dermatoid-collab/EVC_FW/docs/elenco_correzioni_ST.TEC.068.md

# Elenco delle correzioni a ST.TEC.068, in ordine di pagina

Pagine e paragrafi sono quelli della Rev.0 (piè di pagina «Pagina N di 43»). Ricavati dal testo estratto del PDF: ricontrollare in apertura del file originale. I testi da incollare sono in `correzioni_ST.TEC.068.md` (sezione indicata nell'ultima colonna).

| Pagina | Paragrafo | Correzione | Testo |
|---|---|---|---|
| tutte | Intestazione | Rev.1 e data di emissione (oggi 12/01/2026, precedente ai documenti citati); aggiungere «Verificato da» accanto a Redatto/Approvato | §8c |
| 1 | §0, Tab.1 | «Corsa 3000 mm» → «Corsa massima verificata 4500 mm (macchina VR260038: 3000 mm)» | §6c |
| 6 | §1.a | «250 kg/m» → «250 kg/m²» | §8b |
| 6, 10, 23-27 | EN 81-41 | usare una sola edizione (ora 2025 e 2024) e ricontrollare i paragrafi citati | §8c |
| 7 | Tab.2 | QC 315 kg → 3,01 kN diventa **325 kg → 3,19 kN**; QWL 2,67 → **2,70 kN**; Q 1,97 → 1,96; W 3,54 → 3,53 | §8b |
| 7 | §1.1 | elenco unico delle masse (guide 120, trave 210, parti elettriche 30, motoriduttore 21, batterie 18, contrappesi 60, cinghie, cabina 160, portata 200); «cinghie 50 kg» → valore adottato (35 kg a favore di sicurezza, reale circa 7 kg con 0,33 kg/m); carichi per guida **427 kg** (normale) e **607 kg** (paracadute) al posto di 400 e 580 | §4a, §6b |
| 8 | Tab.3 | DC01: Rm 410 e Rp0,2 280 sono massimi di norma; usare i minimi cautelativi (270 e 140 MPa) e dirlo | §4c nota |
| 17 | §3 «Carico esterno» | «m = 1015 kg» e il suo elenco → 1087 kg per guida, **N tot = 11,24 kN** | §4b |
| 18 | §3, caso A | SF 2,06 → **1,93** | §4b |
| 19 | §3, caso B | SF 16,85 → **15,8** | §4b |
| 19-22 | §4 coperchio | sostituire il calcolo delle frecce con la citazione del rapporto CEL (numero e data da completare, fonte di L/200 e 120 MPa); il calcolo a striscia (p. 20) tolto o indicato come stima prudente | §3 |
| 24 | §5, dati cinghia | «Ttht … (max 50 volte nella vita cinghia, da test report)»: il rapporto RI 007-26 non lo dice; indicare la fonte o togliere; usare 910 N/cm (minimo) o 760 (catalogo) | §7b |
| 24 | §5, dati | «Rp = Diametro primitivo … Dp/2» → «raggio primitivo, 50,9 mm ≈ 0,051 m» (anche p. 25, 27, 36) | §8a |
| 24 | §5, specifiche motoriduttore | aggiungere 34 Vac e citare il rapporto Amer (titolo, revisione, data 03/03/2026), disegno DCM-6329 Rev.3 | §5a |
| 25 | §5, emergenza | «Cp = 25,3 · 0,92 · … = 554 Nm» → **Cp = 2 · 14 · 0,85 · 25,3 / 0,92 = 654 Nm**; ΔT = 6417 N; SF dente **10,4 → 8,8**; introdurre «carico limitato dalla coppia del freno» | §2, §7a |
| 26 | §5, frenata nominale | ΔTstd = 3730 N è il totale di due cinghie: SF **1,2 → 2,4** (12 denti) o **4,2** (21 denti) | §7d |
| 26 | §5, max carico di trazione | aggiungere la verifica a emergenza: 6417 N contro 8075 N (valore medio) = **1,26**; rottura 30.685 / 6417 = **4,8** | §7a, §7b |
| 26 | §5, nota decelerazioni | Amax = 14,5 m/s² (modello con a > g non coerente) → ΔT limitato dal freno, equivalente 19,7 m/s²; **Sstop = V²/(2·Amax)**; Tstop 7,6 ms, Sstop 0,57 mm | §7a, §8a |
| 27 | §5, stazionamento | «Cs = g · (Qsl + P − Mcwt) + Rp» → **g · (Qsl + P − 2·Mcwt) · Rp** = 180 Nm; Cd con rendimento 233 Nm, **SFb 1,4 → 1,3** (due freni 2,6) | §5e, §8a |
| 27 | §5, tabella riassuntiva | sostituire con la tabella dei coefficienti corretti | fine file |
| 28 | §6, allentamento | «Massa lineare = 3.3 kg/m; 6 · 3,3 = 20 kg» → **0,33 kg/m; 6 · 0,33 ≈ 2 kg** | §6a |
| 29 | §6, molla | «30 · 0,46 = 16,1 N» → **35 · 0,46** | §8a |
| 29 | §7, dati | «T = 554 Nm» → **327 Nm** per ingranaggio (Cp = 654 Nm ripartita 50/50) | §2 |
| 30 | §7, ingranaggio | Ft = 5454 N, σ = 155 MPa, SF **1,14 → 1,9** | §2 |
| 31 | §7, linguetta e albero | linguetta SF **3,2** (taglio) e **2,2** (pressione); albero Ø35: torsione 77,7 MPa, SF 2,2 (tratto a 654 Nm), 4,4 (327 Nm) | §2 |
| 31 | §8 | citare il rapporto Amer e l'origine delle coppie (prove di settembre 2025 e scala a 340 kg a 0,15 m/s); confronto con 150/180/187 Nm; potenza a 0,15 m/s (654 W), servizio intermittente | §5b, §5c |
| 32 | §8 | Tab.7 SKF e valutazione di s0 = 1,15; frenatura a 654 Nm; mozzo C45 e linguetta C45; prove di validazione (verbali); conteggio delle frenature dinamiche | §5d, §5f, §5g |
| 33 | §9, dati | trave: pulegge coassiali alle guide (carichi verticali sulle guide); aggiungere il momento di coppia | §4c |
| 34 | §9, materiale | «Rp0,2 = 280; Rm = 410» → **140 e 270 MPa**; «nσ = 280/15,11 = 18,5» → **9,3** | §4c |
| 35 | §9, verifica combinata | aggiungere Mtot = 654 + 147 = 801 Nm, σ = 82 MPa, **SF 1,7** | §4c |
| 36 | §10, dati | «Cp = 554 Nm; Fr = 5431 N» → 654 Nm; 6417 N; «SKF 6007/6006» + suffisso 2Z (distinta) | §2, §5d |
| 36-37 | §10, trazione e rinvii | trazione: Fr = T1 + T2 ≈ 6417 N, 3208 N per cuscinetto, s0 **3,2**; rinvio interno (ramo cabina, θ = 100°): Fr = 9831 N, 4916 N per cuscinetto, s0 **1,69**; rinvio esterno (contrappeso): carico trascurabile; sostituire P0 = 2715 N | §7c |
| 38 | §11, giunzione | carico di esercizio e dato Megadyne sulla piastra PB8M050 (da chiedere) | §7e |
| 39 | §11, giunzione | «9 · 4700 = 32.900» → **7 · 4700**; «5431 N» → **6417 N**; SF 6 → **5,1** | §7e, §8a |
| 39-40 | §11, vite M10 contrappeso | F = 729 N (a = 14,5) → carico di freno 6417 N, σ = 111 MPa, SF **50,9 → 5,8**; vite M12 cabina con 6417 N, SF **8,4** | §7a |
| 41 | §12, intestazione | «sostiene la pedana» (cabina) corretto; limite del perno: «τ adottato = 235 MPa» (540/√3 = 312) senza il riferimento alla guida | §1 |
| 42 | §12, cabina | Tmax 8829 N (non 9000); barra DD11: **due piani di taglio**, A = 192 mm², τ = 46 MPa (picco 69), SF **1,4** (picco) e **2,1**; pressione di contatto 170 MPa; prova di tipo n. … | §1 |
| 42-43 | §12, contrappeso | «sostiene la pedana» → «sostiene il contrappeso»; Tmax 736 N; perno **6,4 MPa** (non 7); barra A = 192 mm²: τ = 3,8 MPa, picco 5,8, SF 17 (il 9000 N era della cabina); Wx = 269 mm³ non usato: toglierlo o aggiungere la flessione | §1 |
| 43 | fine documento | aggiungere la tabella riassuntiva dei coefficienti e l'elenco dei documenti di riferimento con data e revisione | §8c |

## Dati ancora da inserire (segnaposto)

1. Numero della prova di tipo del paracadute (p. 42).
2. Numero e data del rapporto CEL, fonte di L/200 e di 120 MPa (p. 19-22).
3. Verbali, corrente misurata e decelerazione della prova di frenatura (p. 31-32).
4. Dati Megadyne: carico minimo di plasticizzazione, carico continuativo della piastra (p. 26, 38).
5. Dati Amer: servizio nominale dei 600 W, curva a bus ridotto (p. 31).
6. Scelta 50/50 o 60/40 per l'ingranaggio (p. 29-30).
7. Lunghezza di taglio delle cinghie (p. 7).
