dermatoid-collab/EVC_FW/docs/commerciale.md

# Elevance: posizionamento commerciale (appunti)

Informazioni fornite dall'utente il 2026-11-08. Sono appunti di lavoro da elaborare, **non** testi approvati né verificati. Le affermazioni commerciali vanno allineate ai dati di prodotto (voce DOC-13 del registro) prima di entrare nei diagrammi.

## USP (esempio dato dall'utente)

1. **A batterie:** zero consumi, sempre acceso, zero intrappolamenti.
2. **Zero manutenzione:** solo controlli periodici, nessun consumabile.
3. **Shaftless tondo:** design brevettato.

## Brevetti e modelli

1. Brevetto paracadute di cabina e di contrappeso **EasyPlat** (EasyPlat è il nome di un'altra piattaforma shaftless LiftingItalia).
2. Modello serratura porta di piano a doppio battente **MD2LOCK** (LiftingItalia).
3. Brevetto piattaforma shaftless con cinghie e contrappesi **Elevance** (pending).
4. Modello piattaforma shaftless tonda **Elevance**.

## Da riconciliare con la configurazione di prodotto (CP.TEC.025 Rev.5)

La configurazione elenca: modello di utilità estetica e funzionalità cabina (registrato); modello di invenzione modalità di azionamento a contrappesi e batterie (depositato); brevetto paracadute (attivo dal 2021). Numeri, titoli e stato dei quattro titoli sopra vanno confrontati con questo elenco.

## Punti da chiarire prima di usare le USP nei materiali

- «Zero consumi»: il dato di prodotto è 1 W in stand-by «da certificare» e la ricarica assorbe fino a 0,5 kW. Formula possibile: «consumi minimi» o il valore certificato.
- Significato inteso dall'utente (2026-11-08): nessuna parte di usura da sostituire oltre alle batterie ogni 3 anni; solo controlli periodici; pulegge lubrificate solo in caso di rumori anomali, perché i cuscinetti sono schermati e già ingrassati. Da dimostrare (DOC-23): suffisso dei cuscinetti, vita di cinghie, rotelle, cerniere e freni, manuale e garanzia allineati.
- «Zero manutenzione / nessun consumabile»: la configurazione prevede manutenzione semestrale e sostituzione delle batterie ogni 3 anni.
- «Zero intrappolamenti»: verificato che a batteria scarica la macchina non parte e al piano resta fuori servizio con la porta apribile; non verificato che una corsa già iniziata si completi sempre (FW-33), e l'analisi dei rischi elenca scenari residui di intrappolamento. Formula difendibile: «non parte con la batteria scarica».
- Manutenzione: periodicità unica di 6 mesi in tutti i documenti (conferma dell'utente del 2026-11-09, DOC-14; i manuali corretti non sono stati riletti). La base normativa dell'obbligo resta da confermare (NOR-07).

## Manutenzione: obbligo normativo (NOR-07)

Il Regolamento (UE) 2023/1230 e la EN 81-41 non impongono al proprietario una verifica semestrale: richiedono al fabbricante istruzioni con tipi e frequenze delle manutenzioni. In Italia l'obbligo di manutenzione da parte di ditta abilitata, con controlli almeno semestrali, viene dal DPR 162/1999 art. 15, che richiama anche gli apparecchi di sollevamento con velocità non superiore a 0,15 m/s rispondenti alla definizione di ascensore. Applicabilità a Elevance, regole degli altri Paesi e testi integrali da confermare con un organismo competente.

## Formulazioni proposte per il claim sulla manutenzione (2026-11-08)

Da non usare: «zero manutenzione», «nessuna manutenzione», «nessun consumabile», «a vita». Motivo: il manuale prevede controlli semestrali, in Italia la manutenzione periodica può essere obbligatoria (NOR-07), le batterie si sostituiscono ogni 3 anni.

1. Titolo: «Manutenzione minima». Sottotitolo: «Un controllo semestrale programmato e nessuna parte di usura da sostituire, a parte le batterie ogni 3 anni (uso residenziale, circa 300 corse al mese).» Da sostenere con: vita attesa di cinghie, rotelle, cerniere e freni (ipotesi dichiarata), manuale e garanzia allineati (DOC-23).
2. Versione già sostenibile con i documenti attuali: «Controllo semestrale programmato. Batterie sigillate senza manutenzione, da sostituire ogni 3 anni. Cuscinetti schermati (2Z) e pre-ingrassati.»
3. Sempre abbinare «controllo a cura di personale abilitato» dove la normativa lo richiede (NOR-07).
