dermatoid-collab/EVC_FW/docs/richiesta_correzione_refusi.md

# Richiesta di correzione: residui da altri prodotti, refusi e rimandi errati nei manuali Elevance

Data: 2026-11-08 · Voce del registro: **DOC-24** · Documenti letti: IM.TEC.159 (manutenzione) rev.0 06.2026, IM.TEC.161 (uso) rev.0 06.2026, cartelli «pericolo di schiacciamento».

Si chiede di correggere i punti seguenti alla prossima revisione dei manuali e di ripubblicarli. Nota: «AREALIFTING» è un marchio di LiftingItalia S.r.l. (indicato nei manuali): non è un residuo.

## A. Residui da altri prodotti o da altre sezioni

| Documento e punto | Testo trovato | Correzione richiesta |
|---|---|---|
| IM.TEC.159, clausola di garanzia | «guarnizioni del cilindro oleodinamico e del gruppo valvole» | togliere: Elevance è a cinghie e contrappesi, senza parte idraulica |
| IM.TEC.159 §10.06, procedura 4 «Tetto sensibile», punti B e D | «azionare manualmente il fondo sensibile», «parte centrale del fondo sensibile» | «tetto sensibile» (testo copiato dalla procedura 3) |
| IM.TEC.161 §3 | «corsa massima di 4,6 m» | 4,5 m (4500 mm, come CP.TEC.025), oppure aggiornare la configurazione se 4,6 m è corretto |
| IM.TEC.159 e IM.TEC.161 | «mini-ascensore», «ascensore», «elevatore», «piattaforma», «pedana», «cabina» usati in alternanza | scegliere un solo termine per il prodotto, coerente con la classificazione |
| Cartelli «pericolo di schiacciamento» (file «fossa» e «tetto») | codice documento «I0000.00.0000_rev.0» | codice reale; il file «fossa» riguarda la zona sotto la cabina e il prodotto è senza fossa: rinominare o descrivere |

## B. Refusi e rimandi errati

| Documento e punto | Testo trovato | Correzione |
|---|---|---|
| IM.TEC.159 §10.02 e paragrafo sulla periodicità | rimando al «§ 9.06» | «§ 10.06» (la tabella delle procedure è al §10.06) |
| IM.TEC.159 §10.05 | «SOSTITUZIONE DELLE CINCHIE» | «CINGHIE» |
| IM.TEC.159 §10.06, procedura 2F | «la porta sia apre automaticamente» | «la porta si apre automaticamente» |
| IM.TEC.159 §10.06, procedura 12 | «Segnaletica di dicurezza» | «sicurezza» |
| IM.TEC.161 §3 | «Trough-The-Floor» | «Through-The-Floor» |
| IM.TEC.161 §3 | «comforrt» | «comfort» |
| IM.TEC.161 §3 | «ingomro» | «ingombro» |

## C. Da decidere insieme alla correzione

- Periodicità della manutenzione: il manuale d'uso (IM.TEC.161) dice almeno ogni 3 mesi, IM.TEC.159 e CP.TEC.025 dicono 6 mesi (DOC-14).
- Messaggi commerciali sulla manutenzione («zero manutenzione, nessun consumabile»): il manuale prevede lubrificazione delle pulegge, batterie da sostituire ogni 3 anni e parti di usura in garanzia (DOC-23, DOC-13).
