dermatoid-collab/EVC_FW/docs/diagrammi/01.schema_funzionale.png

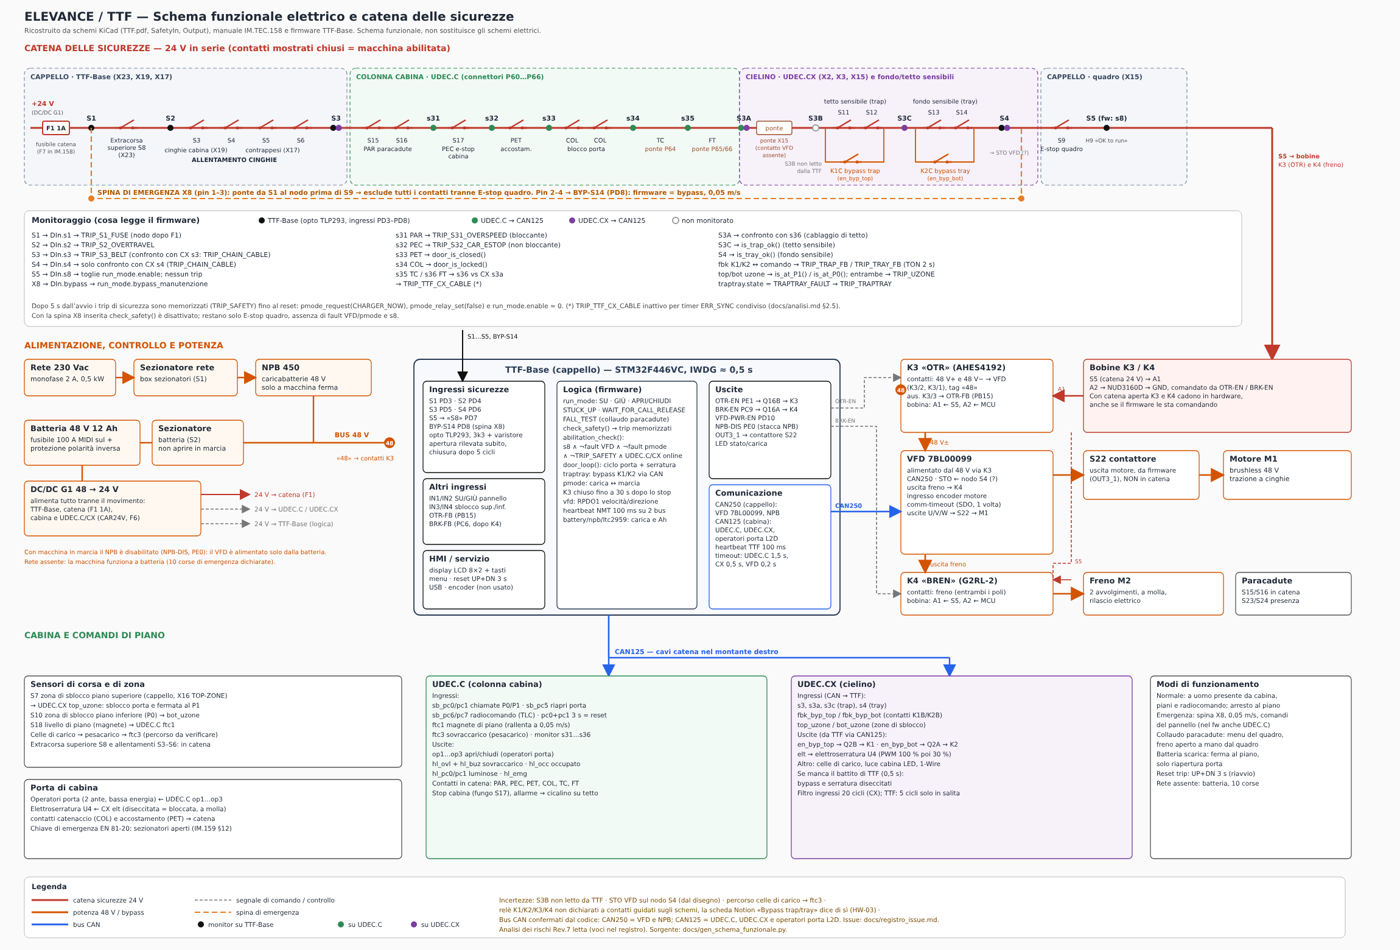
docs/diagrammi/01.schema_funzionale.png
