dermatoid-collab/EVC_FW/docs/diagrammi/02.diagramma_funzionale.png

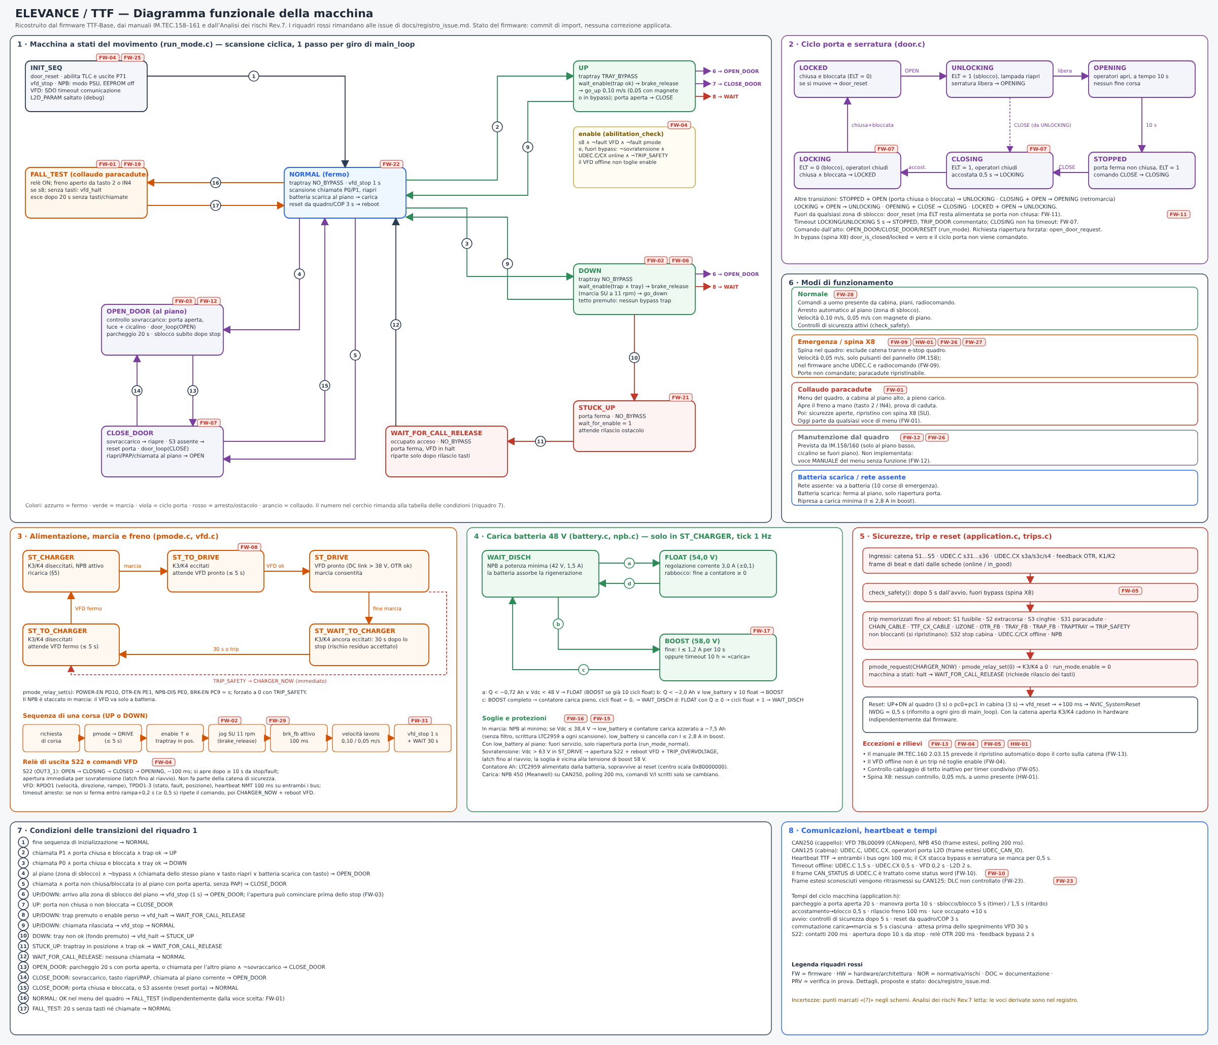
docs/diagrammi/02.diagramma_funzionale.png
