dermatoid-collab/EVC_FW/docs/diagrammi/03.diagramma_funzionale_light.png

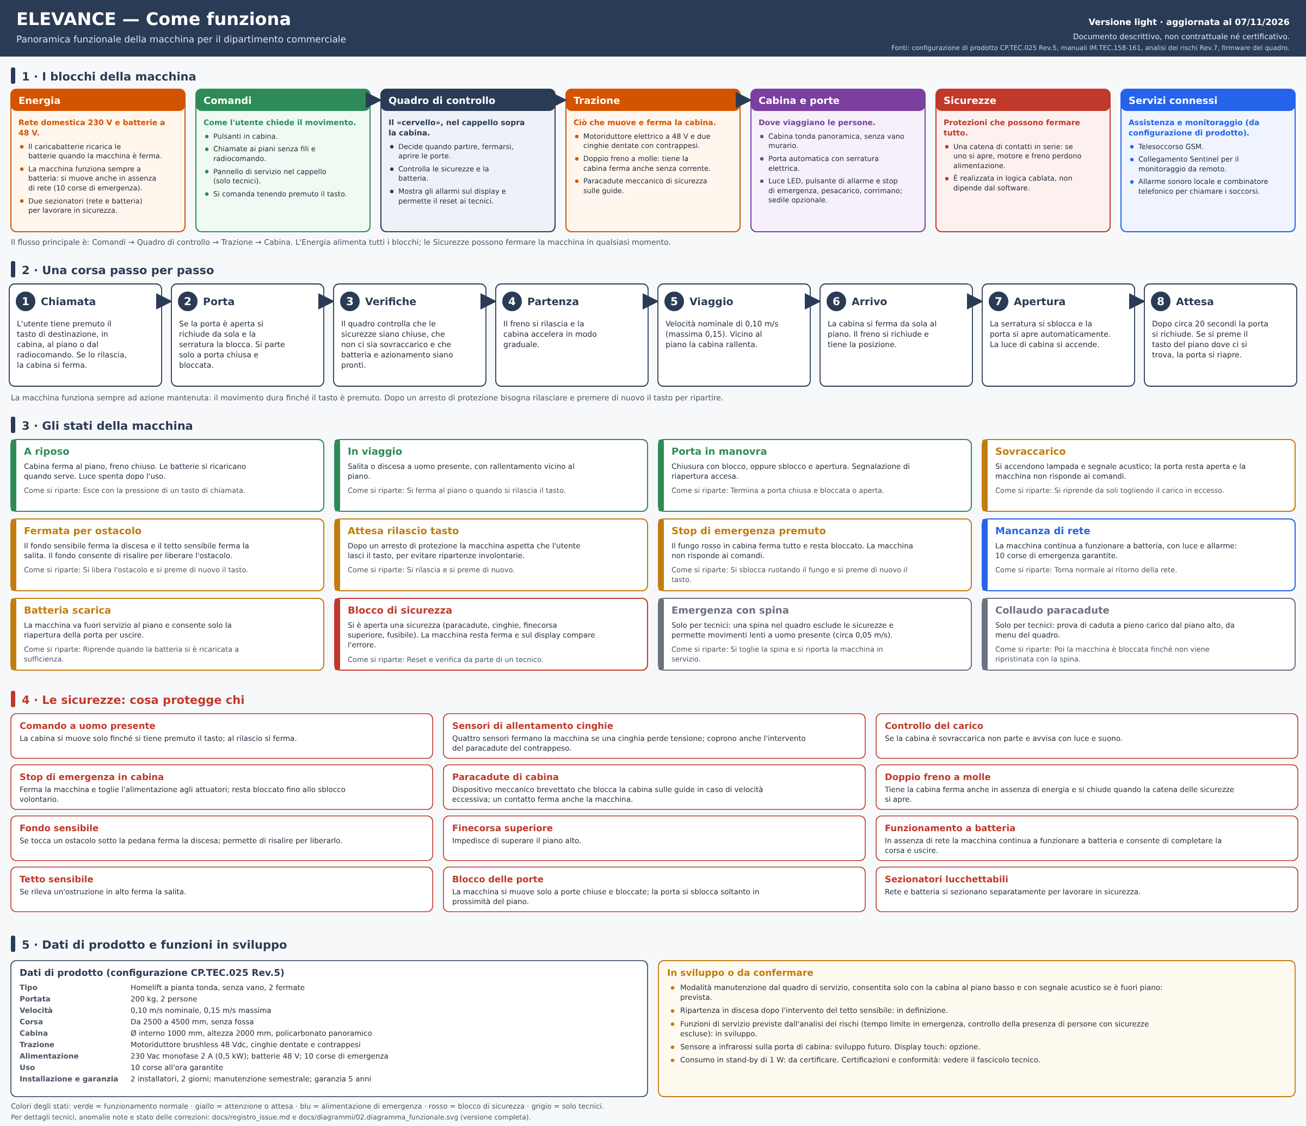
docs/diagrammi/03.diagramma_funzionale_light.png
