dermatoid-collab/EVC_FW/docs/diagrammi/04.diagramma_energia_light.png

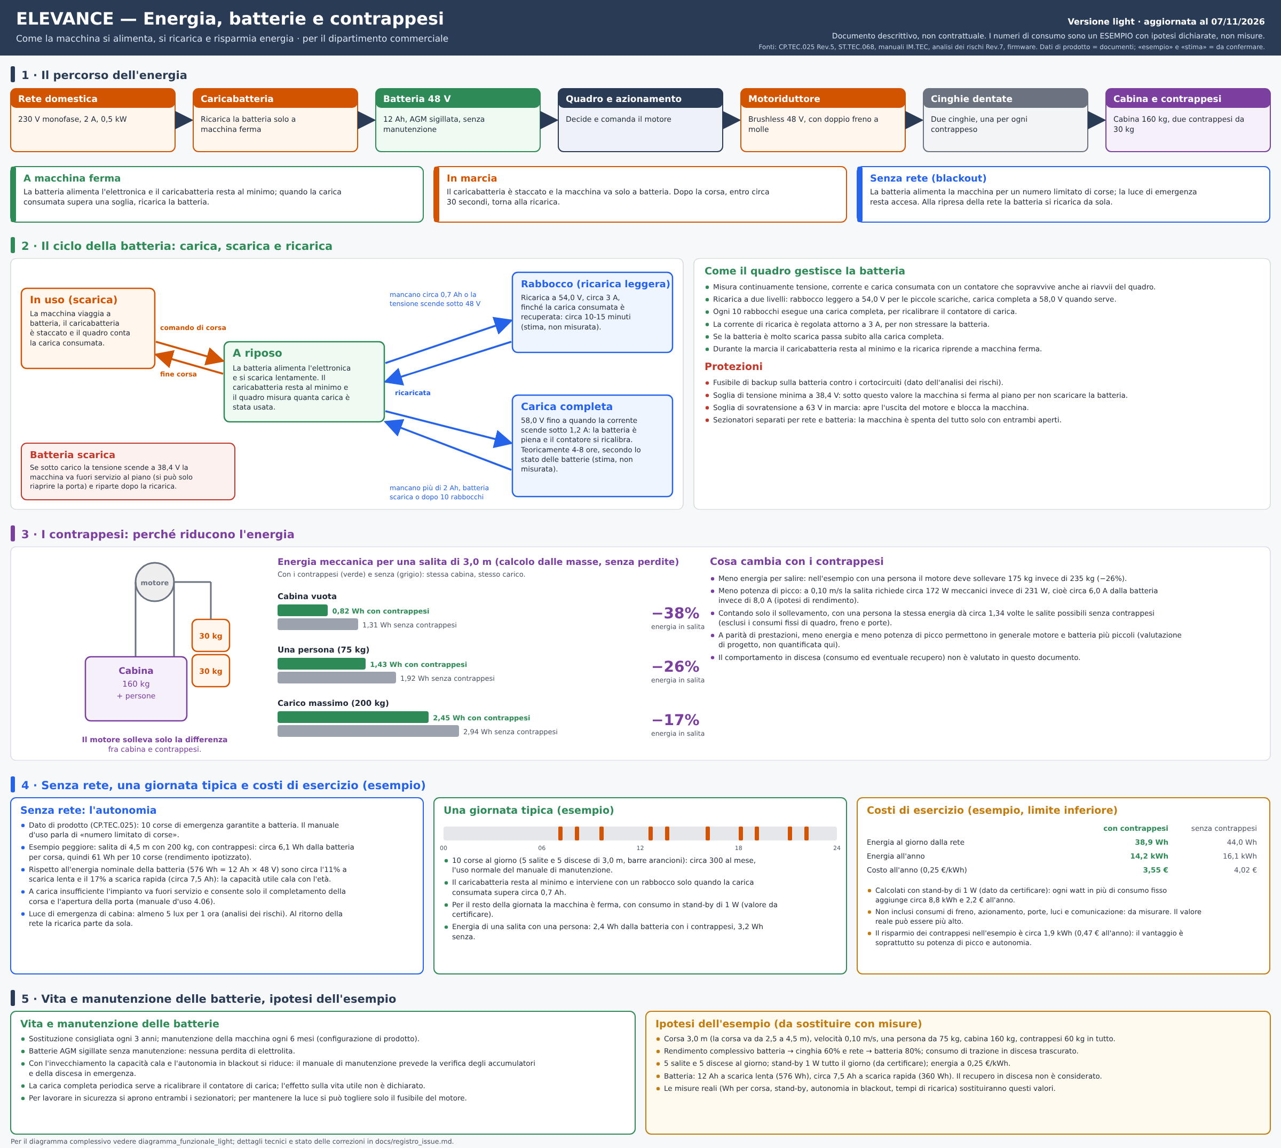
docs/diagrammi/04.diagramma_energia_light.png
