dermatoid-collab/EVC_FW/docs/diagrammi/05.diagramma_energia_sintesi.png

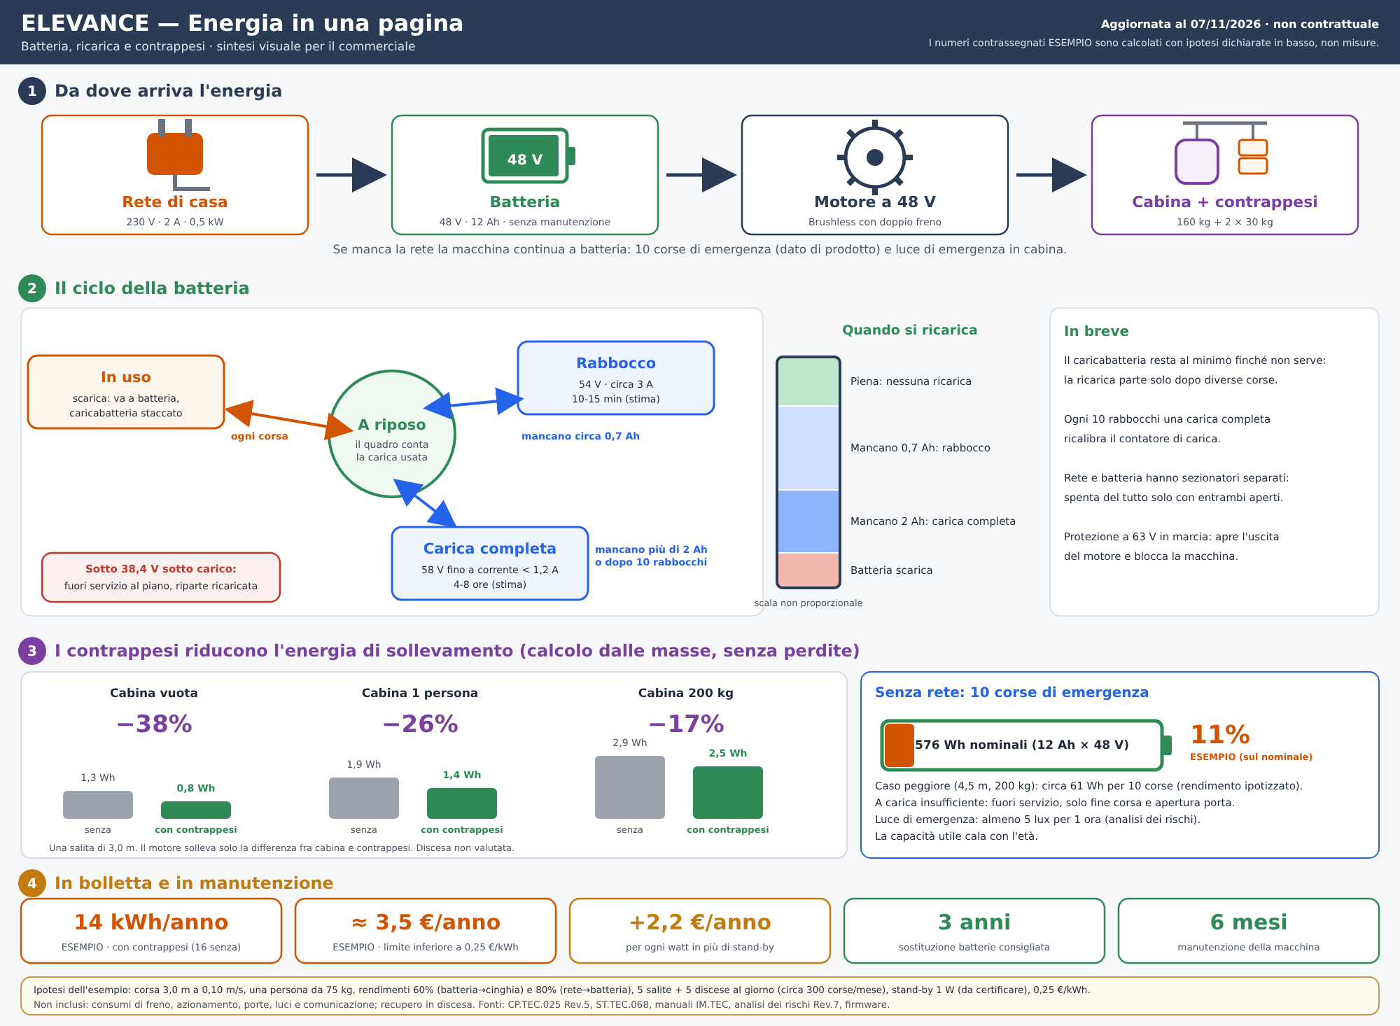
docs/diagrammi/05.diagramma_energia_sintesi.png
