dermatoid-collab/EVC_FW/docs/diagrammi/06.diagramma_manutenzione.png

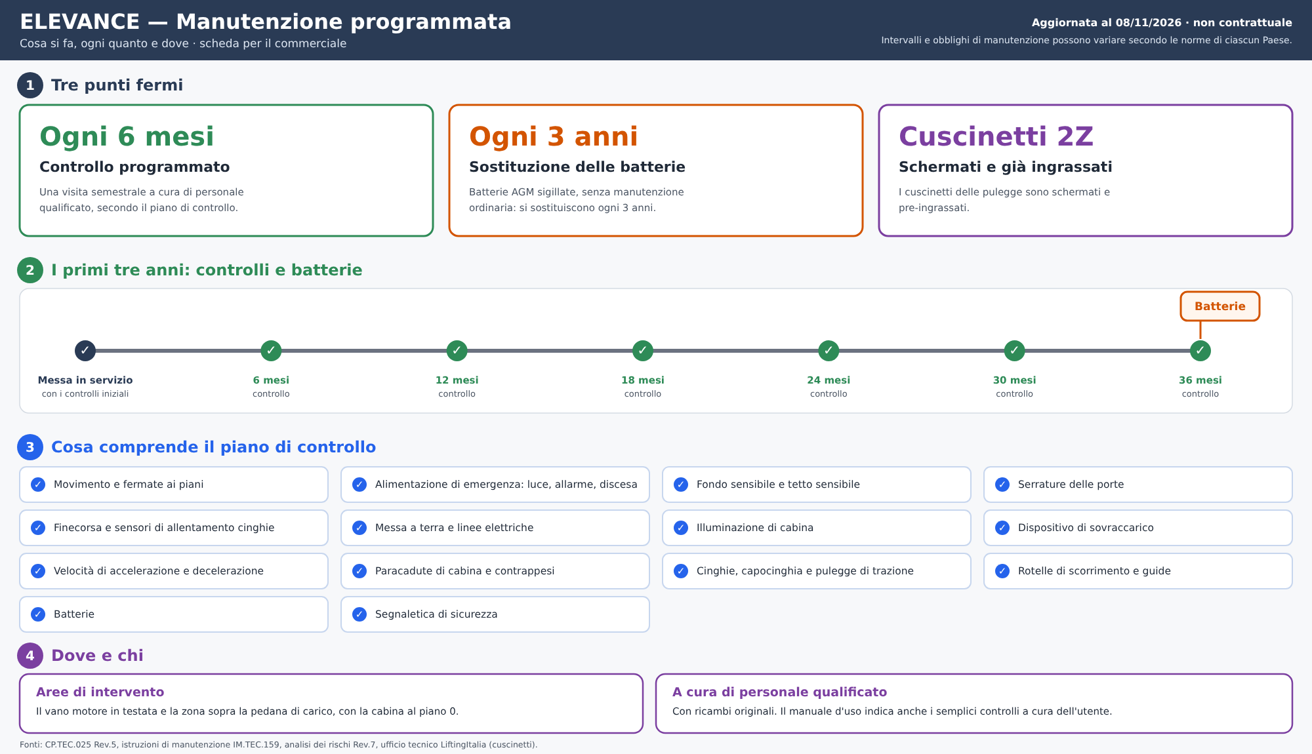
docs/diagrammi/06.diagramma_manutenzione.png
