dermatoid-collab/EVC_FW/docs/diagrammi/07.diagramma_manutenzione_sintesi.png

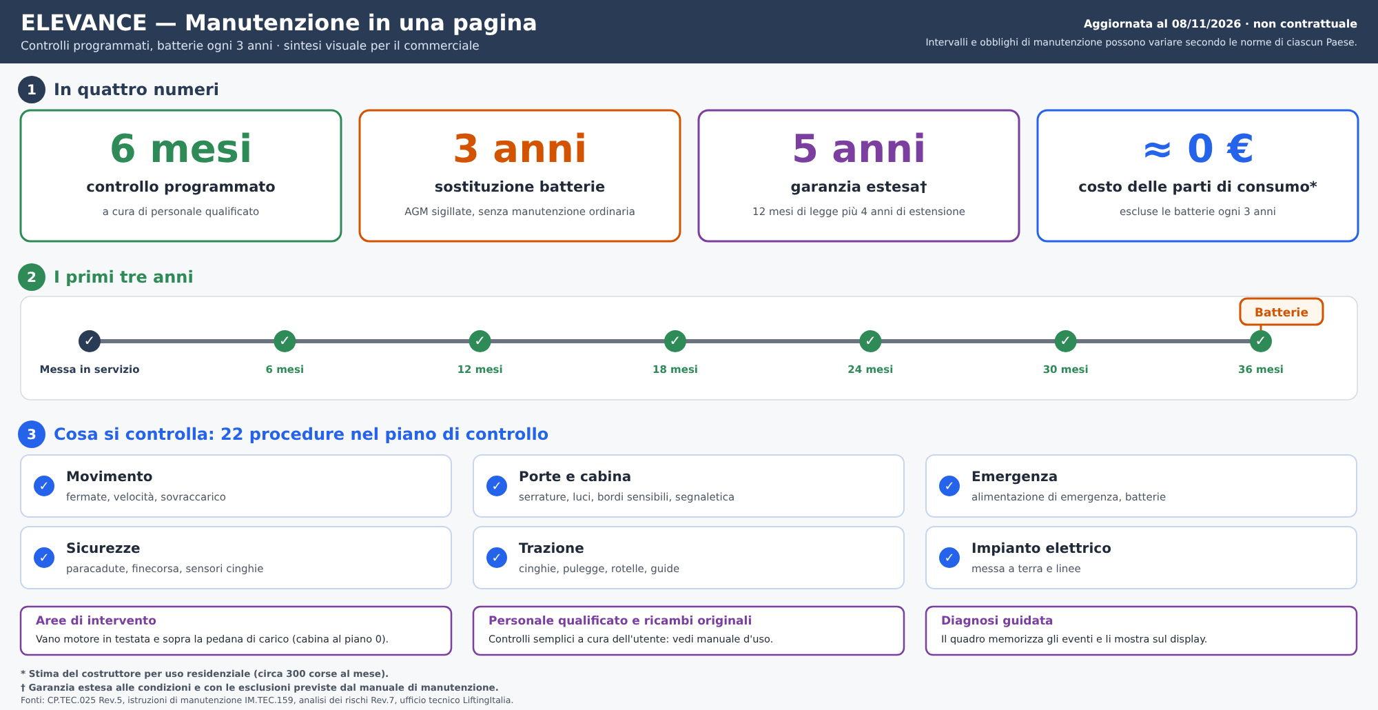
docs/diagrammi/07.diagramma_manutenzione_sintesi.png
