dermatoid-collab/EVC_FW/F510.05.9019 Scheda Consenso Paracadute/Sensore Paracadute/F510.05.5061.FCStd

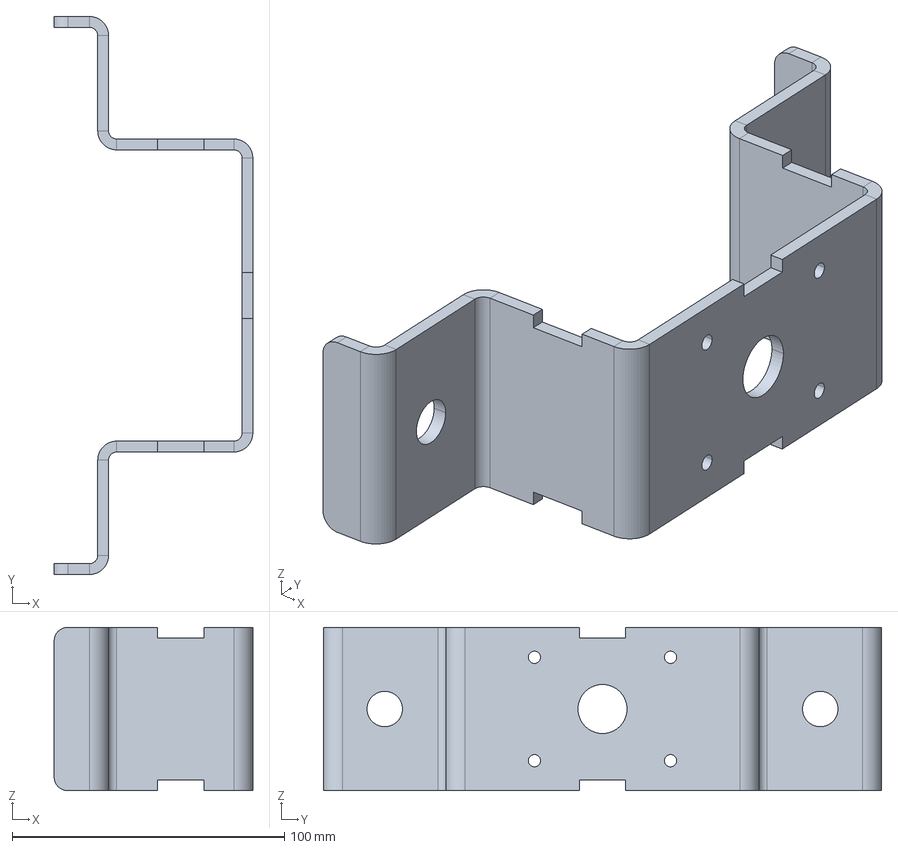
[picture p8: CAD file, 2026-11-06]
F510.05.9019 Scheda Consenso Paracadute/Sensore Paracadute/F510.05.5061.FCStd
73.0 x 205.0 x 60.0 mm
