dermatoid-collab/EVC_FW/TTF-Base/fabs/TTF-Base-B_Fab.dxf

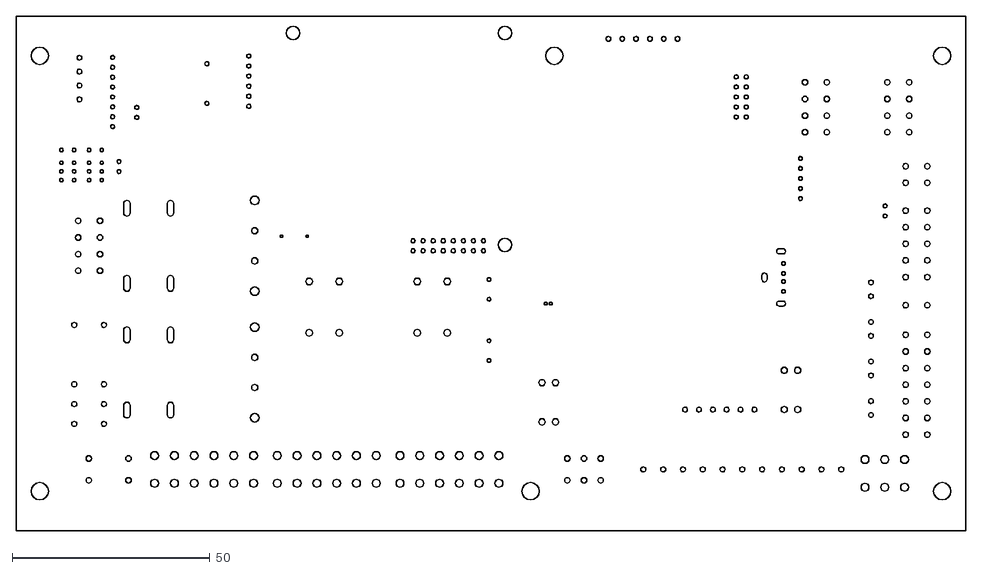
[picture p9: CAD file, 2026-11-06]
TTF-Base/fabs/TTF-Base-B_Fab.dxf
240.0 x 130.0
