dermatoid-collab/EVC_FW/F510.05.9019 Scheda Consenso Paracadute/Sensore Paracadute/F500.03.0001_L.FCStd

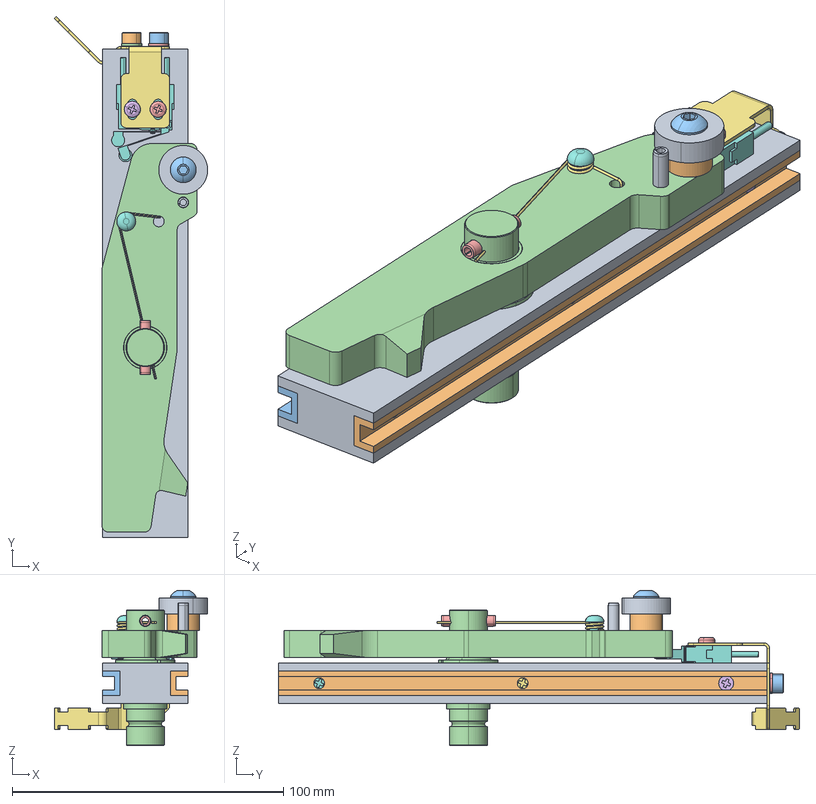
[picture p10: CAD file, 2026-11-06]
F510.05.9019 Scheda Consenso Paracadute/Sensore Paracadute/F500.03.0001_L.FCStd
56.5 x 192.0 x 57.2 mm
F500.05.7001
F500.05.7002
F500.05.7003
N098.14.0012
N043.04.0020
N091.04.0004
F500.05.3001_FLESSA
F500.05.9004
N043.04.0021
F500.05.6002
N059.05.0020_N059.05.0020
F500.05.9005
N016.03.0005
N016.03.0006
F500.05.5003_L
F500.05.9003
F500.05.9027
N011.04.0010V02
N011.04.0010V001
N036.04.0000
N036.04.0001
N020
N021
N022
N023
N024
N025
F500.05.6001
