dermatoid-collab/EVC_FW/TTF-Base/fabs/TTF-Base-F_Fab.dxf

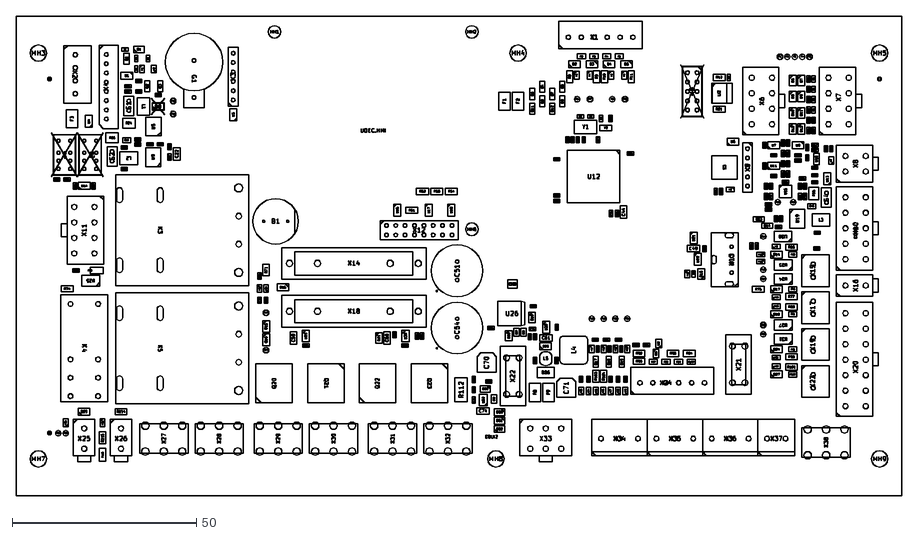
[picture p11: CAD file, 2026-11-06]
TTF-Base/fabs/TTF-Base-F_Fab.dxf
240.0 x 130.0
