dermatoid-collab/EVC_FW/F510.05.9019 Scheda Consenso Paracadute/Sensore Paracadute/Root.FCStd

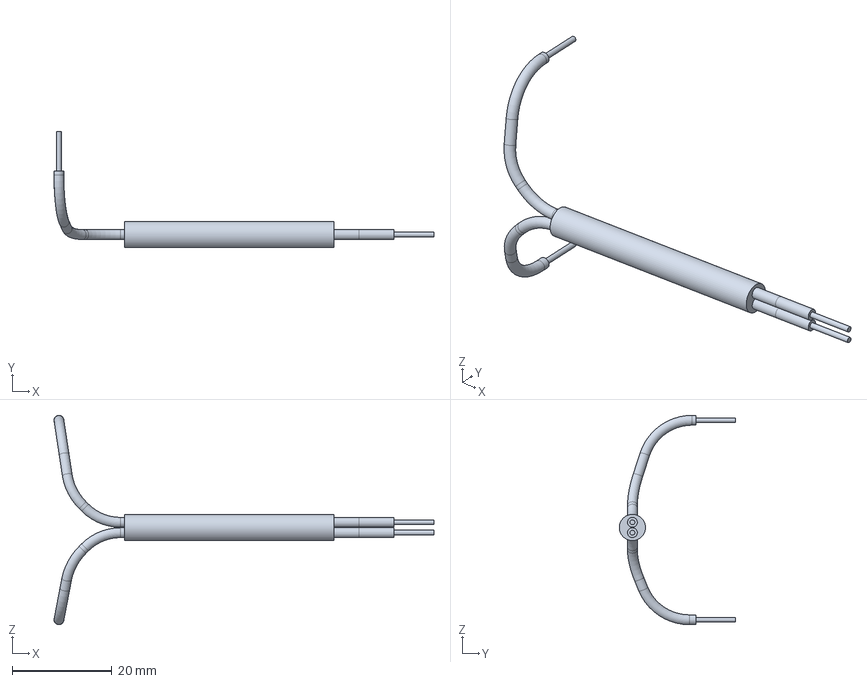
[picture p12: CAD file, 2026-11-06]
F510.05.9019 Scheda Consenso Paracadute/Sensore Paracadute/Root.FCStd
76.2 x 23.3 x 42.0 mm
