dermatoid-collab/EVC_FW/F510.05.9019 Scheda Consenso Paracadute/Sensore Paracadute/SensorePresenza.FCStd

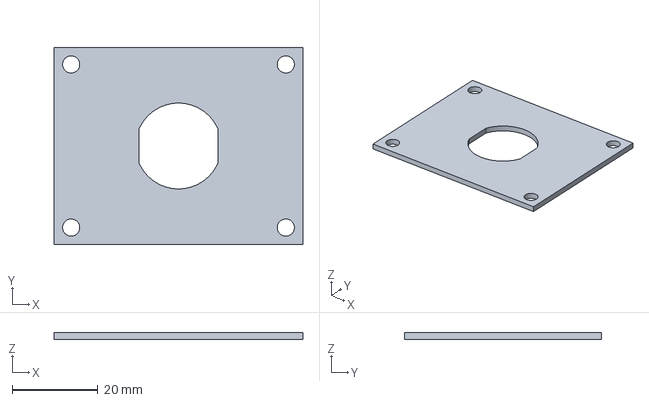
[picture p13: CAD file, 2026-11-06]
F510.05.9019 Scheda Consenso Paracadute/Sensore Paracadute/SensorePresenza.FCStd
58.0 x 46.0 x 1.60 mm
