dermatoid-collab/EVC_FW/F510.05.9019 Scheda Consenso Paracadute/Sensore Paracadute/F510.05.5062.FCStd

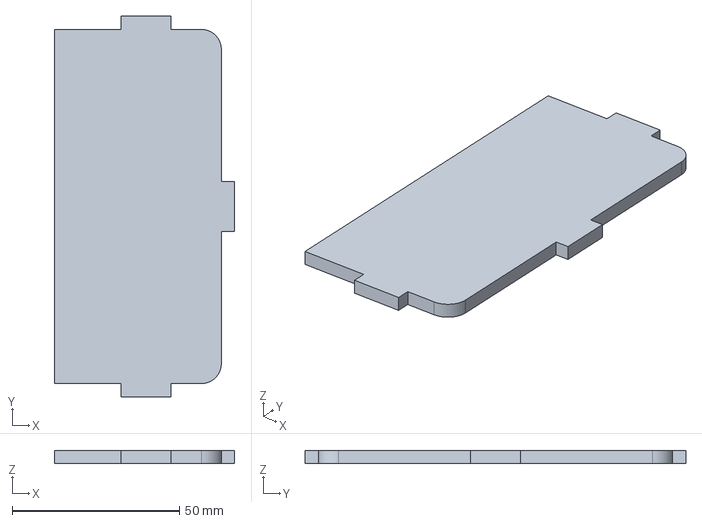
[picture p14: CAD file, 2026-11-06]
F510.05.9019 Scheda Consenso Paracadute/Sensore Paracadute/F510.05.5062.FCStd
54.0 x 114.0 x 4.00 mm
