dermatoid-collab/EVC_FW/(list of files, cad)

Other CAD files:
F510.05.9019 Scheda Consenso Paracadute/Sensore Paracadute/Contatto filato.FCStd
F510.05.9019 Scheda Consenso Paracadute/Sensore Paracadute/F510.04.0003.FCStd
