dermatoid-collab/EVC_FW/Schema Macchina/fabs/TTF.pdf

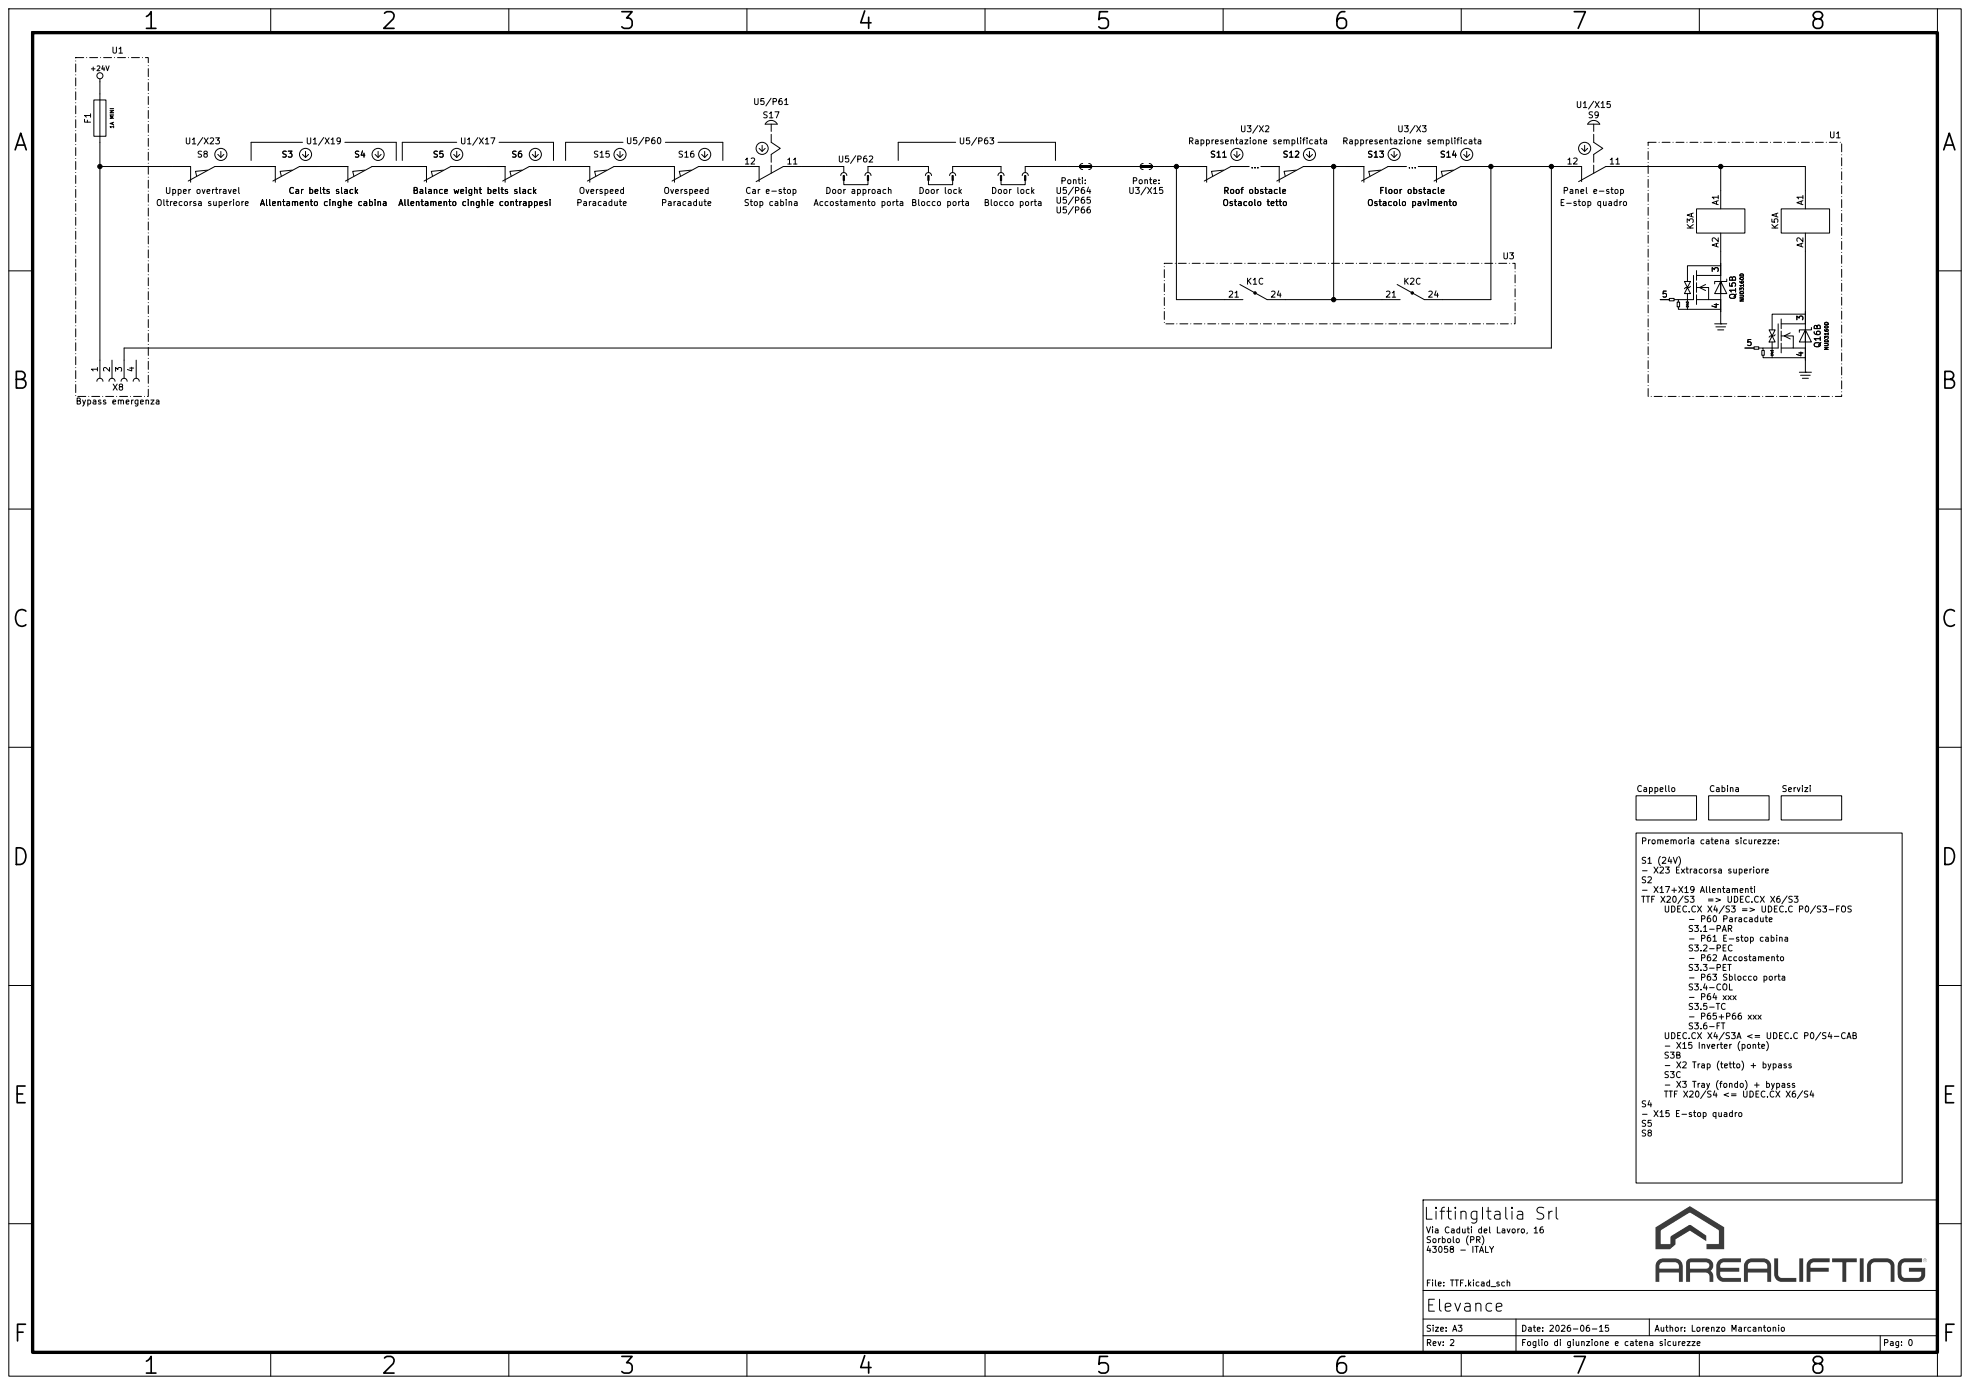
[picture p15: page 1]

Stop cabina Car e-stop +24V 1

Allentamento cinghie contrappesi Balance weight belts slack S8 Oltrecorsa superiore

Floor obstacle S16 Paracadute Overspeed S3

Promemoria catena sicurezze: S1 (24V) - X23 Extracorsa superiore S2- X17+X19 Allentamenti TTF X20/S3 => UDEC.CX X6/S3 UDEC.CX X4/S3 => UDEC.C P0/S3-FOS - P60 Paracadute S3.1-PAR - P61 E-stop cabina S3.2-PEC - P62 Accostamento S3.3-PET - P63 Sblocco porta S3.4-COL - P64 xxx S3.5-TC - P65+P66 xxx S3.6-FT UDEC.CX X4/S3A <= UDEC.C P0/S4-CAB - X15 Inverter (ponte) S3B - X2 Trap (tetto) + bypass S3C - X3 Tray (fondo) + bypass

File: TTF.kicad_sch LiftingItalia Srl

Via Caduti del Lavoro, 16
Sorbolo (PR) 43058 - ITALY Rev: 2 Elevance

Size: A3 | Date: 2026-06-15 | Author: Lorenzo Marcantonio

Foglio di giunzione e catena sicurezze | Pag: 0

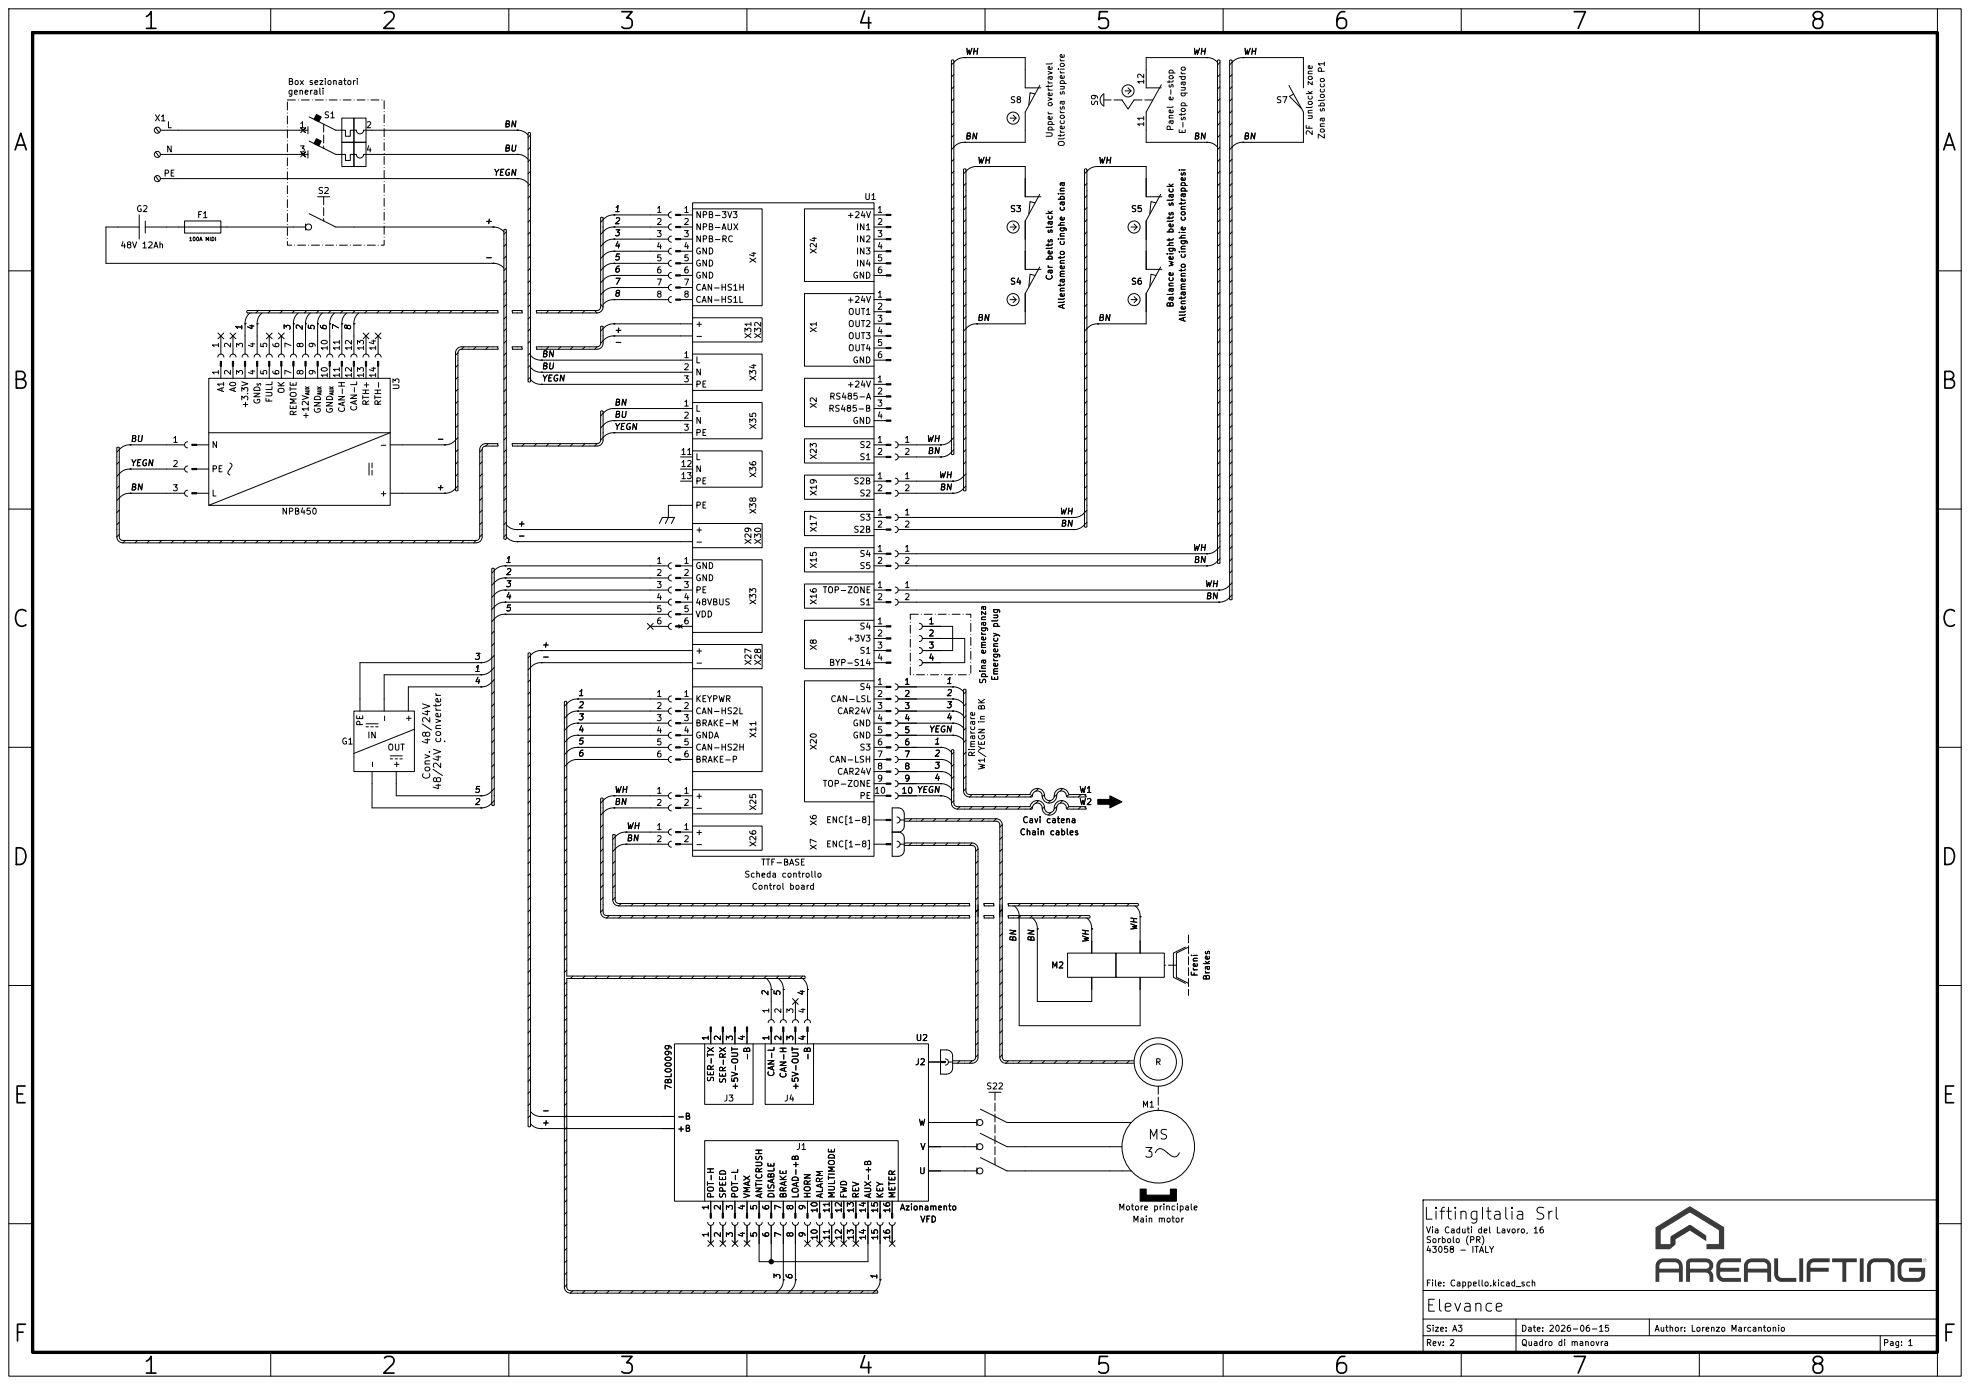
[picture p16: page 2]

Box sezionatori generali YEGN
100A MIDI LN

YEGN -
Cavi catena Chain cables BN W1 WH

S22 Rimarcare W1/YEGN in BK

Via Caduti del Lavoro, 16

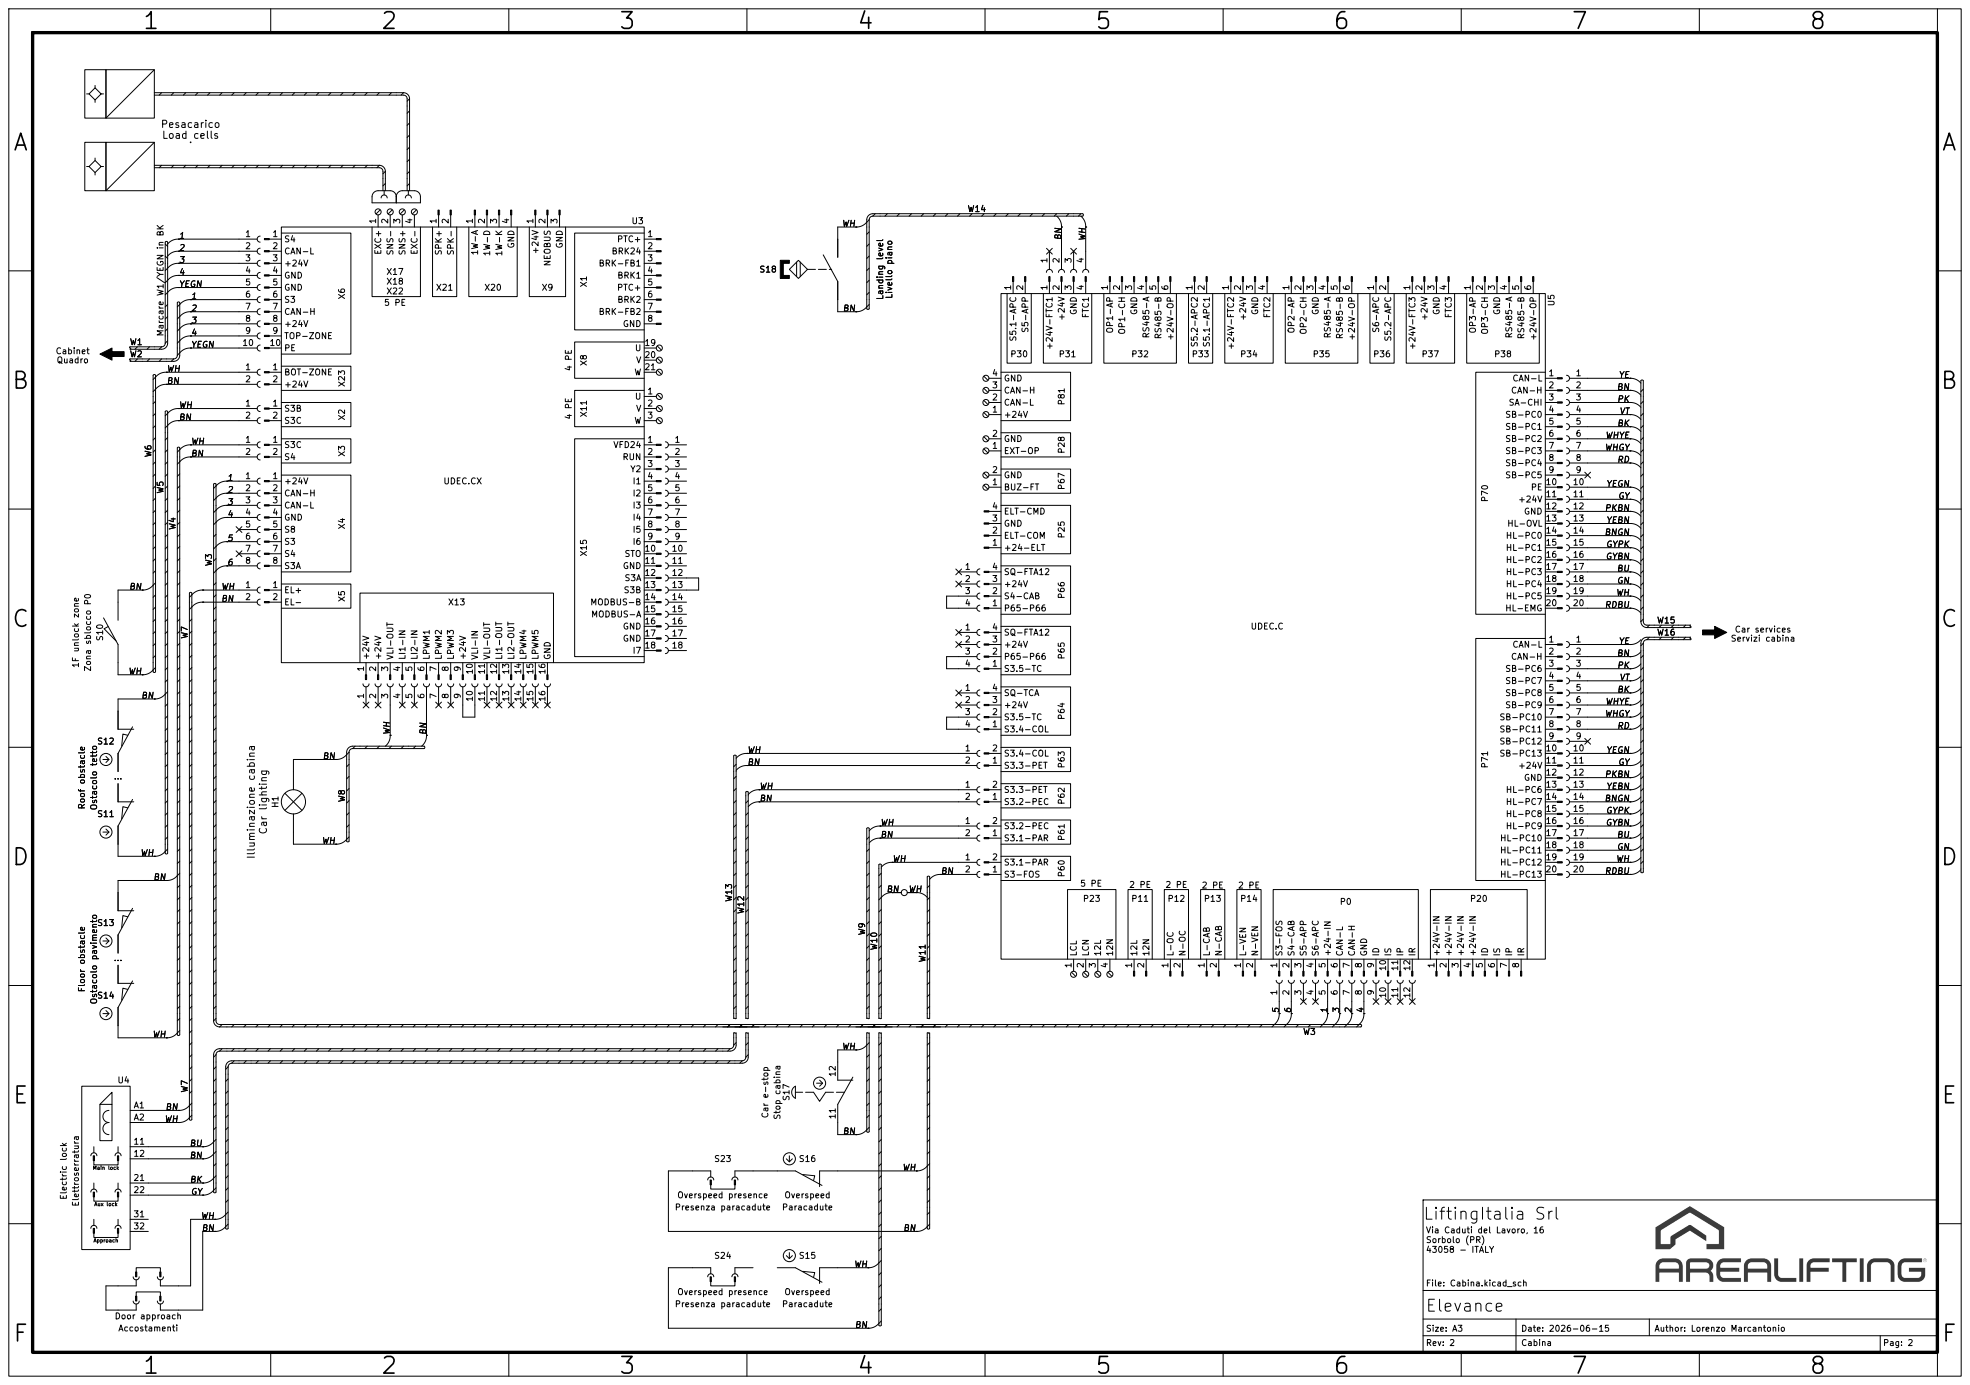
[picture p17: page 3]

YEBN S10 1F unlock zone Zona sblocco P0

910111213141516 BN WHW12 BN WH WH

Overspeed presence S23 Presenza paracadute

File: Cabina.kicad_sch LiftingItalia Srl

Via Caduti del Lavoro, 16
Sorbolo (PR) 43058 - ITALY Rev: 2 Elevance

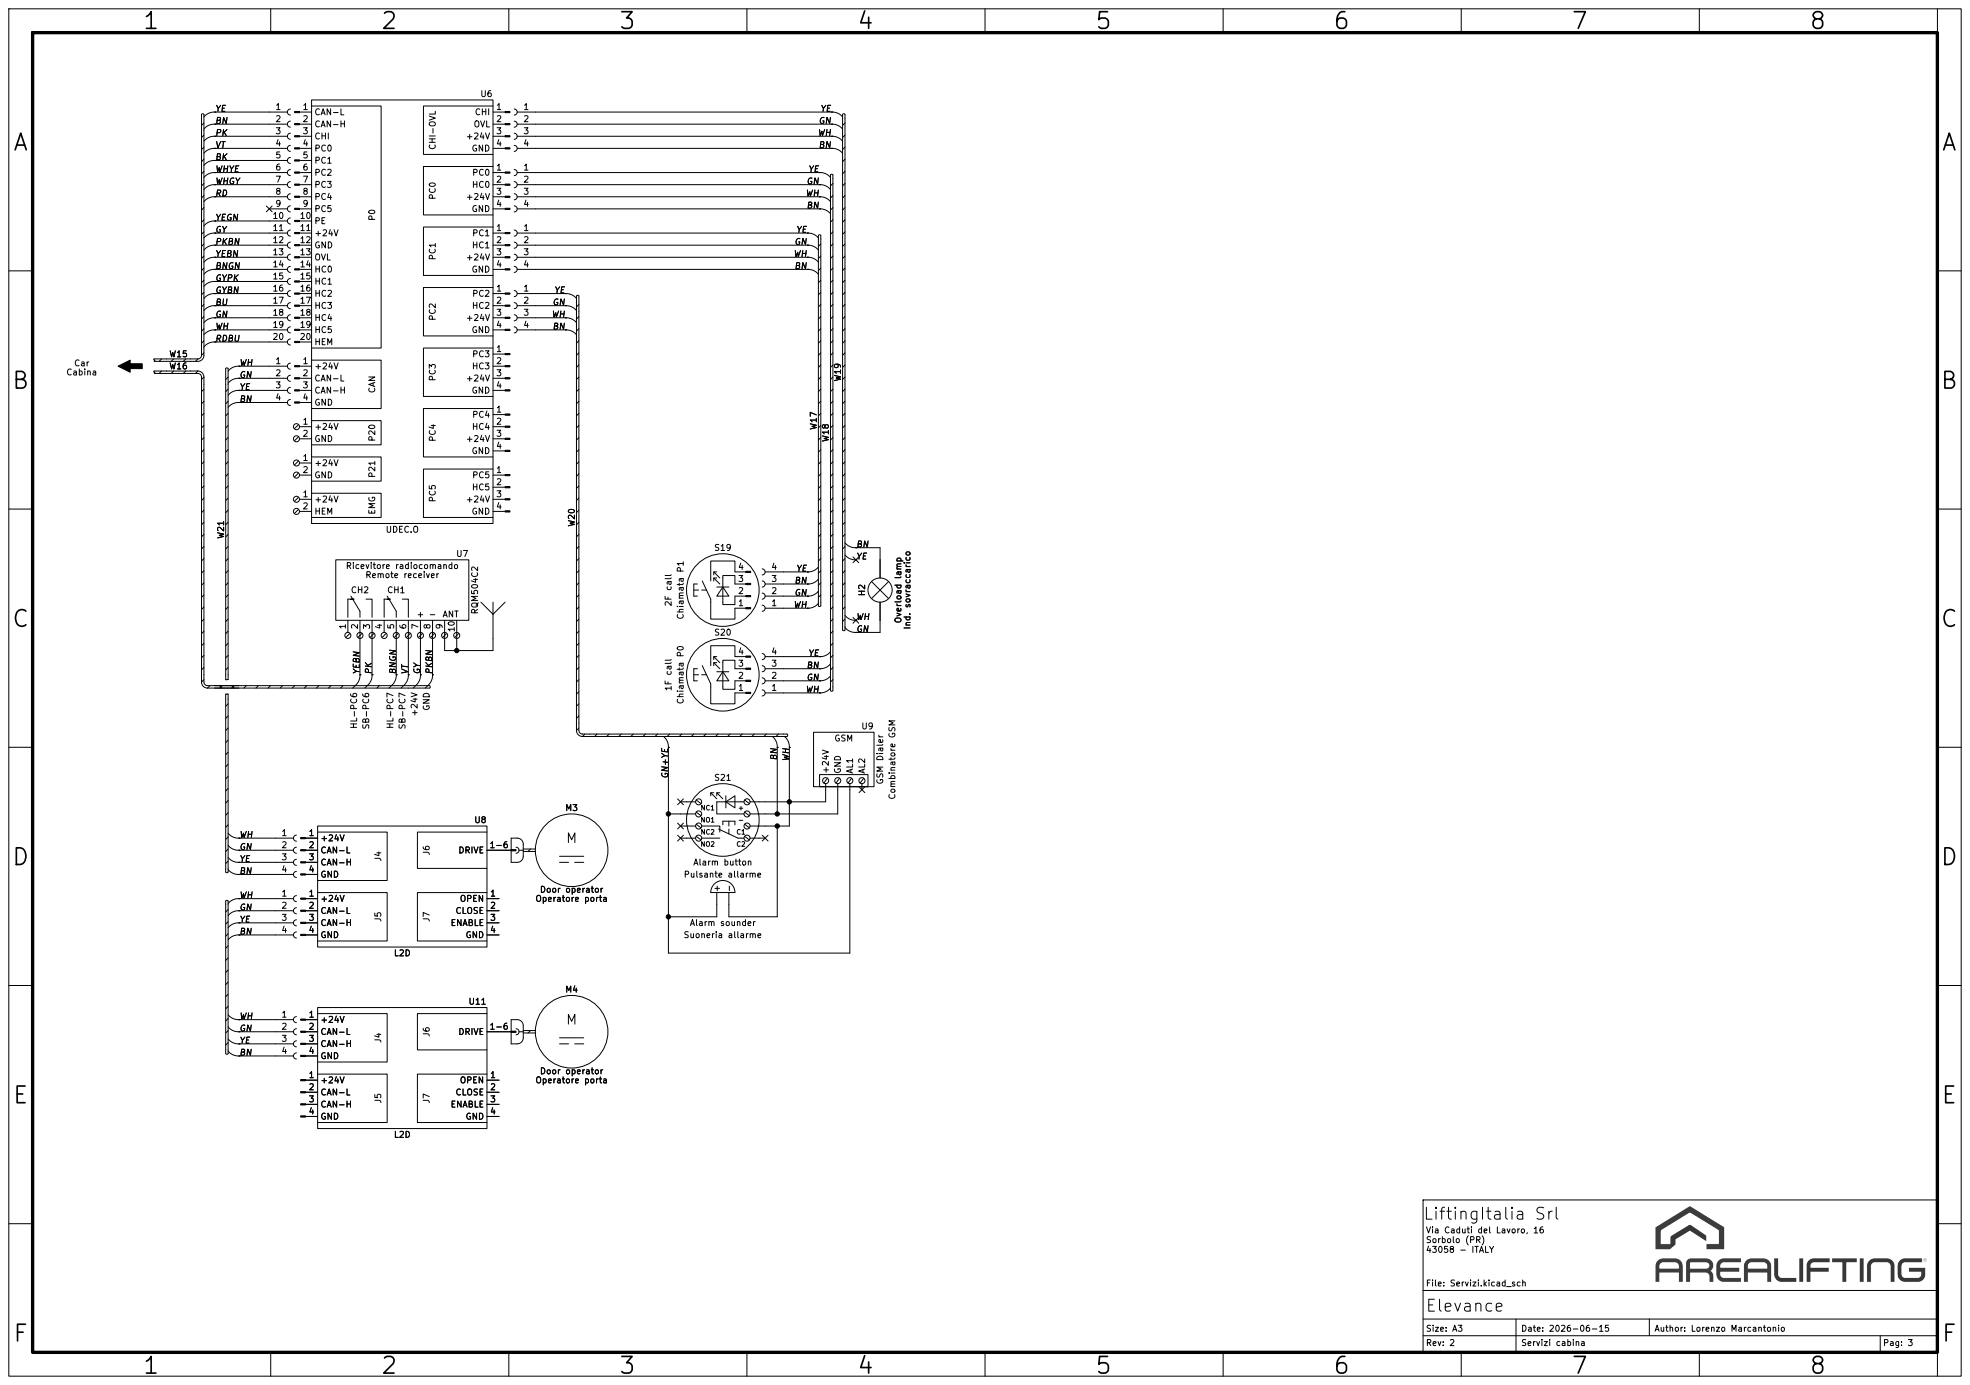
[picture p18: page 4]

File: Servizi.kicad_sch LiftingItalia Srl

Via Caduti del Lavoro, 16
