dermatoid-collab/EVC_FW/TTF-Base/fabs/TTF-Base.pdf

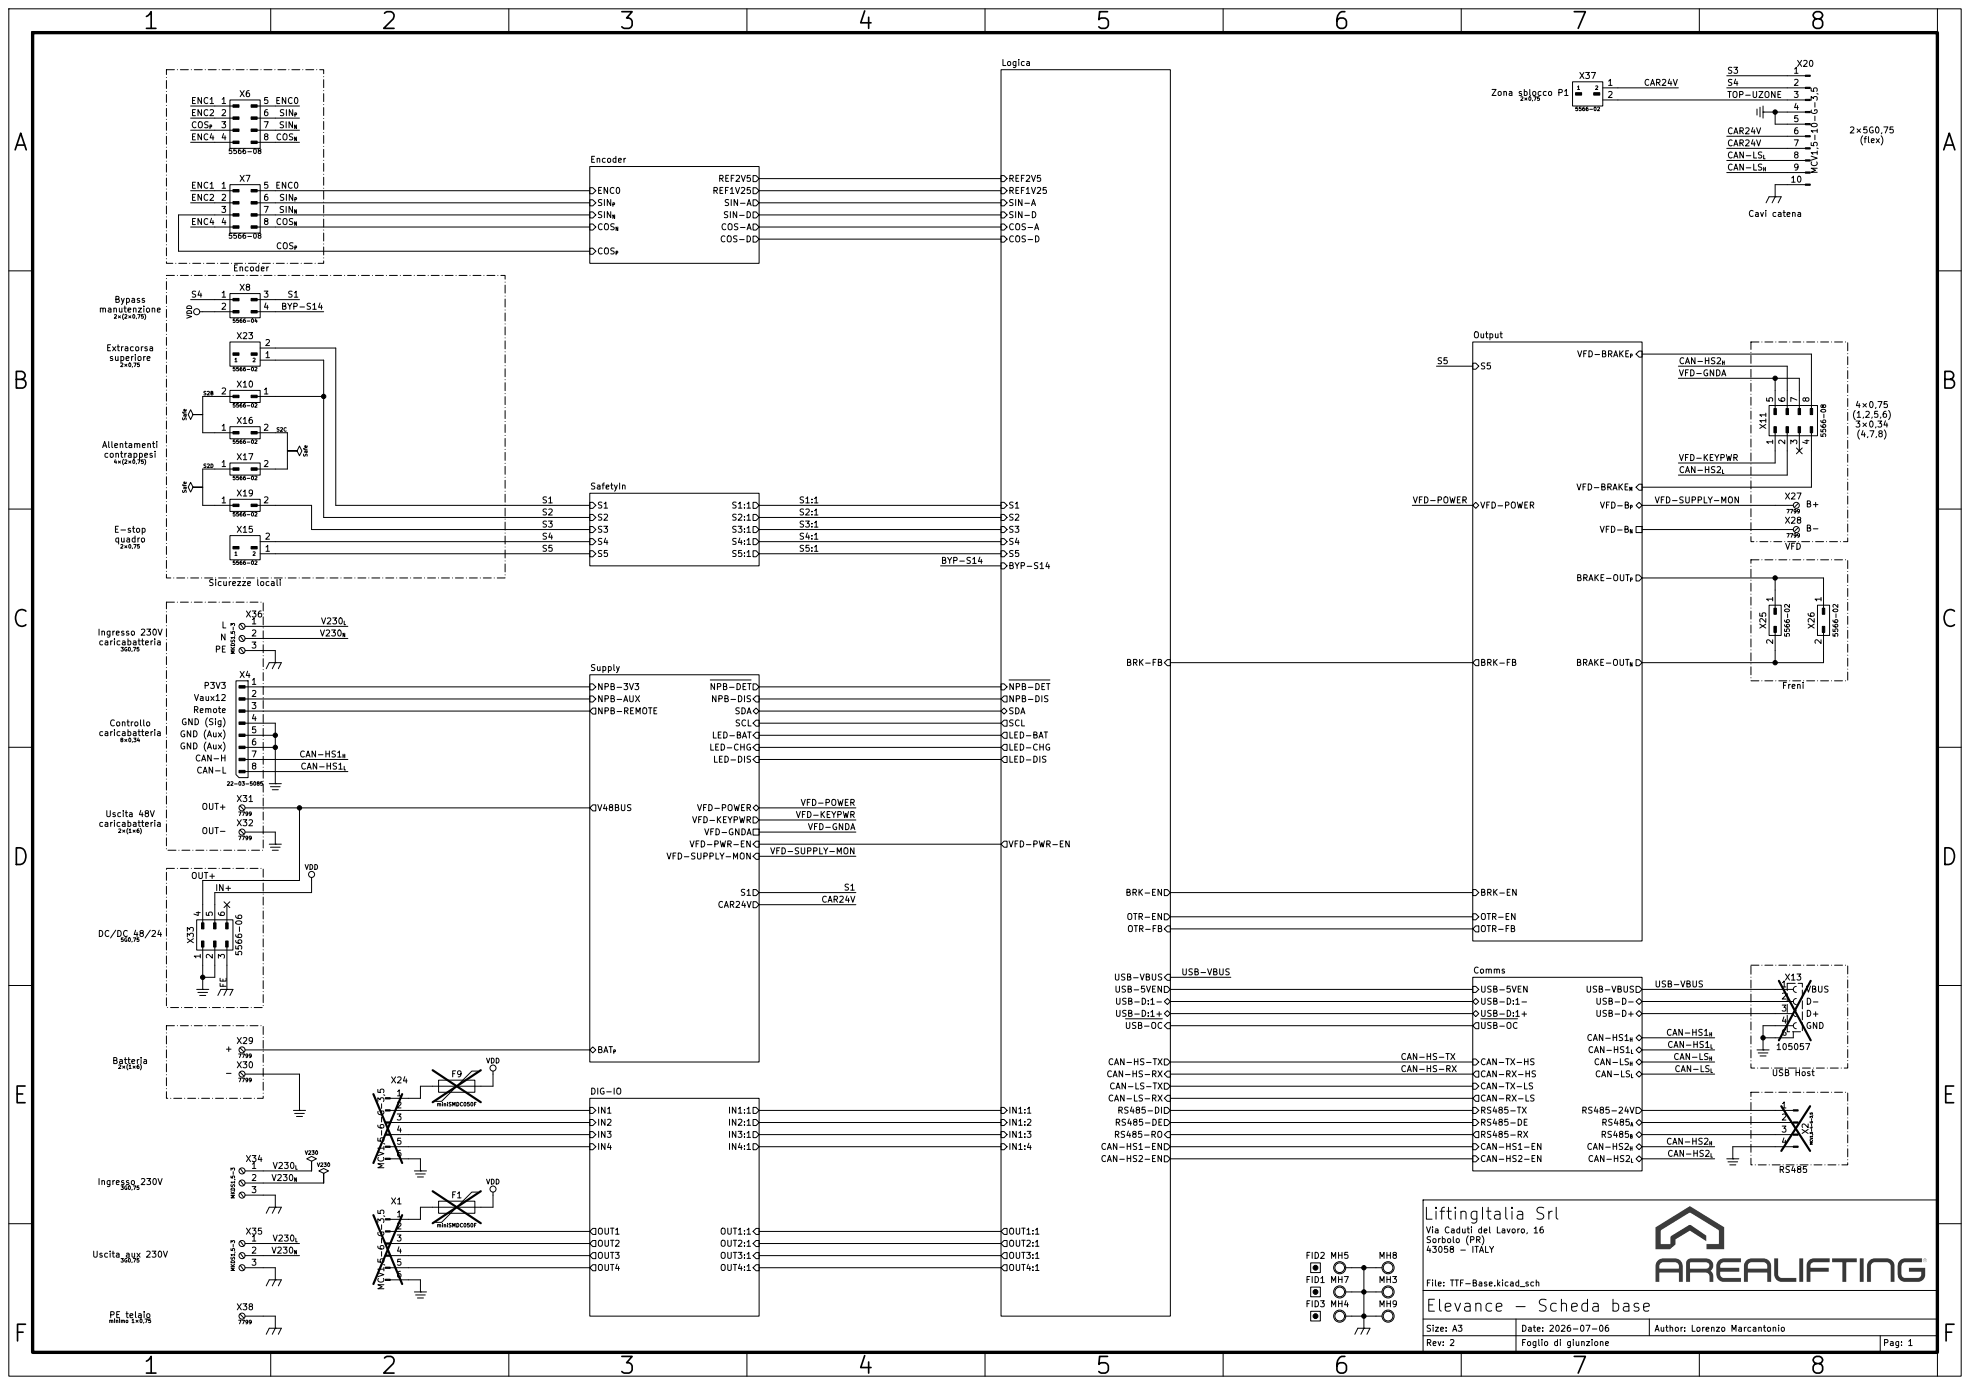
[picture p19: page 1]

Logica COS-A COS-D
USB-VBUS USB-OC NPB-DIS NPB-DET BYP-S14 COS-A COS-D

X20 MCV1,5-10-G-3,5
BRAKE-OUTP BRAKE-OUTN VFD-BRAKEP S5OTR-EN

LED-BAT LED-CHG

CAN-HS-RX CAN-HS-TX USB-VBUS

CAN-HS2H CAN-HS2L CAN-HS1L Comms

USB-VBUS USB-OC

File: TTF-Base.kicad_sch LiftingItalia Srl

Via Caduti del Lavoro, 16

Size: A3 | Date: 2026-07-06 | Author: Lorenzo Marcantonio

Foglio di giunzione | Pag: 1

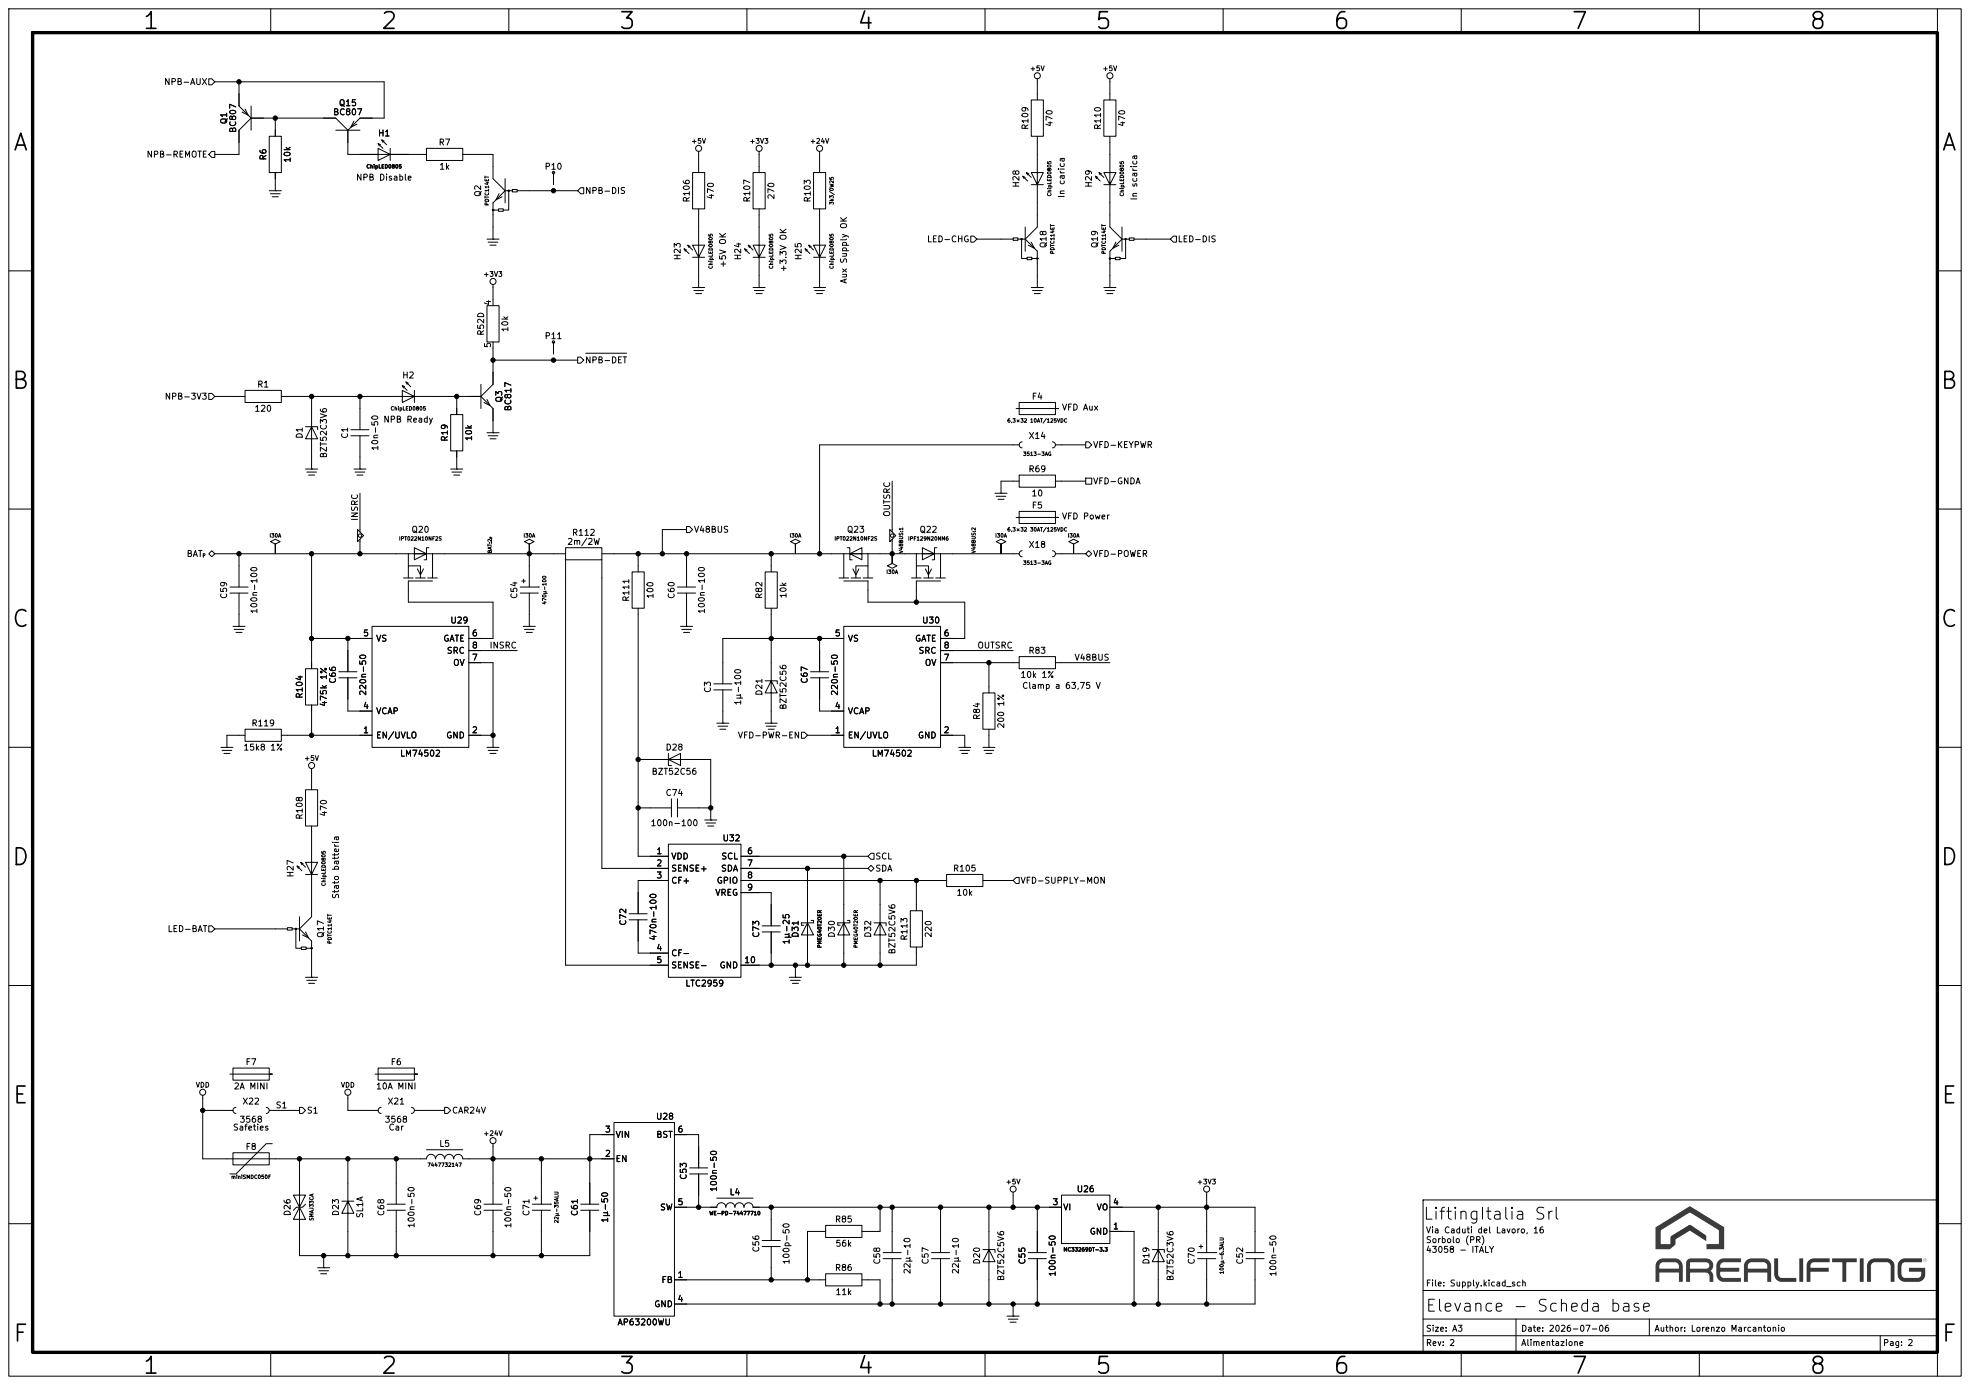
[picture p20: page 2]

NPB-DET NPB-DIS

Via Caduti del Lavoro, 16

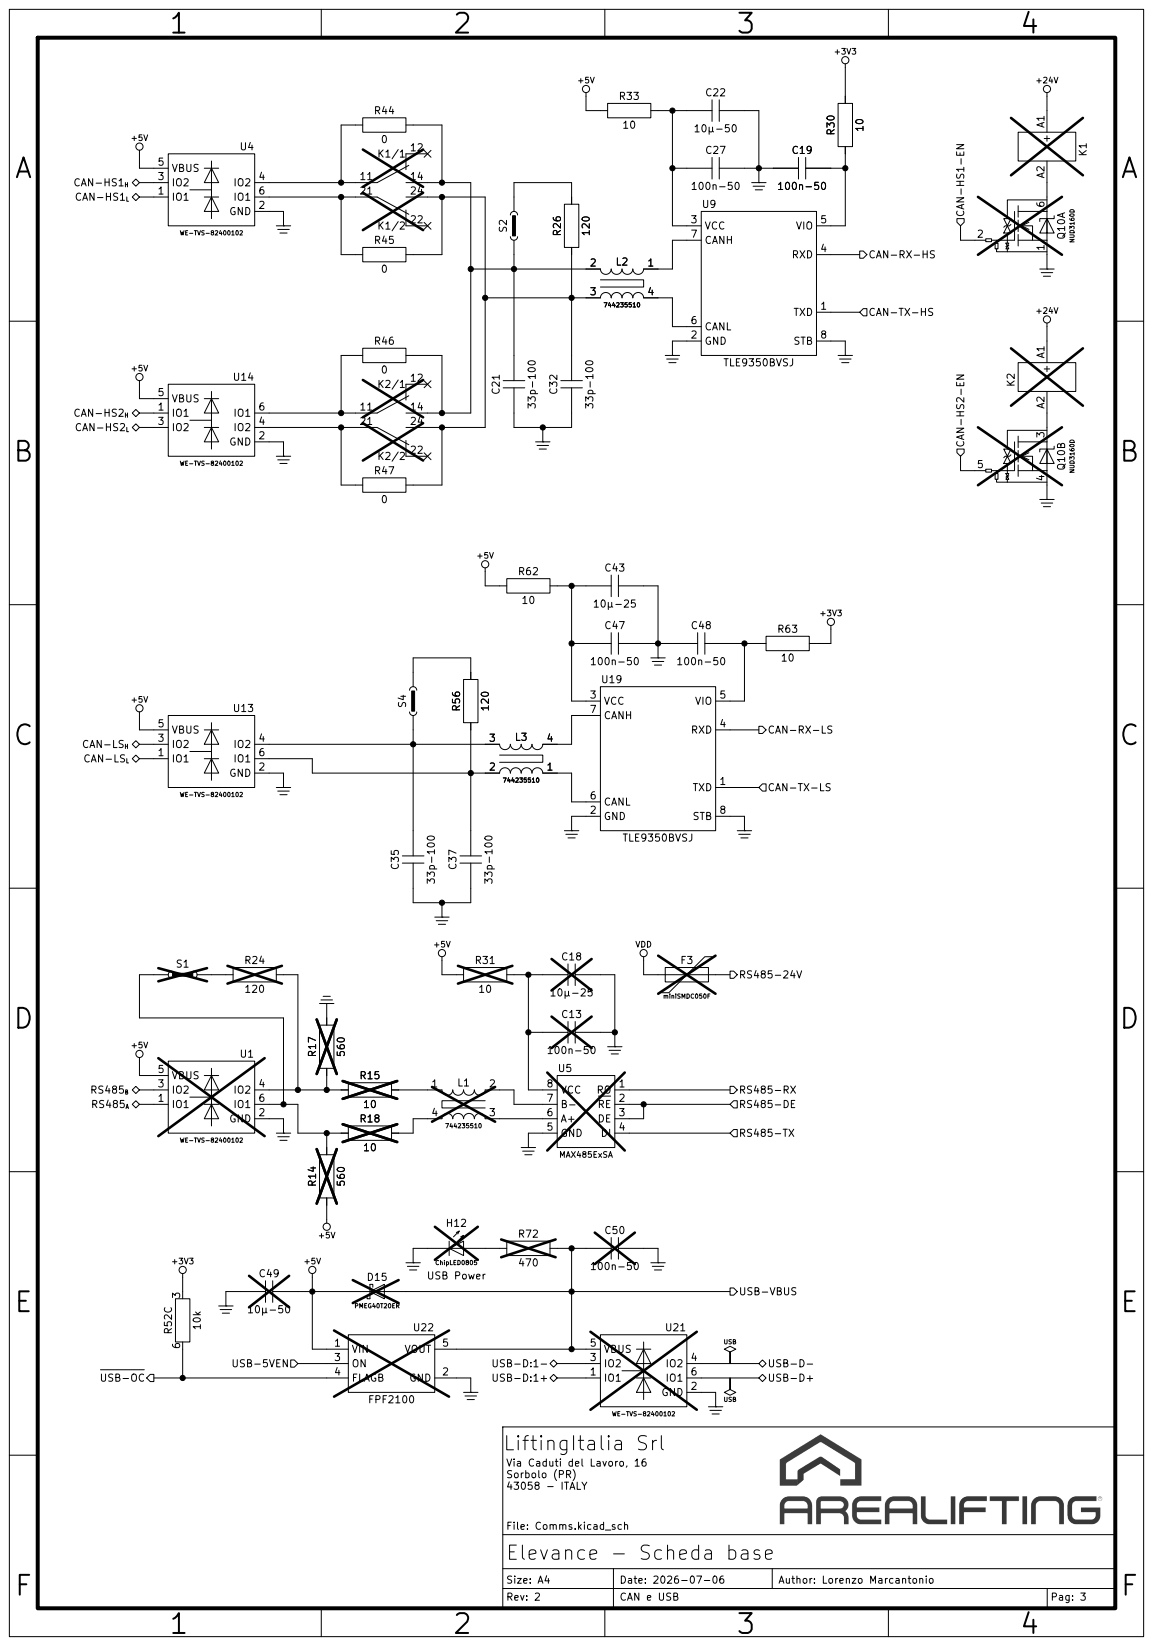
[picture p21: page 3]

RS485-TX RS485-DE CAN-RX-LS RS485-24V RS485A RS485B

File: Comms.kicad_sch LiftingItalia Srl

Via Caduti del Lavoro, 16
Sorbolo (PR) 43058 - ITALY Rev: 2 Elevance - Scheda base

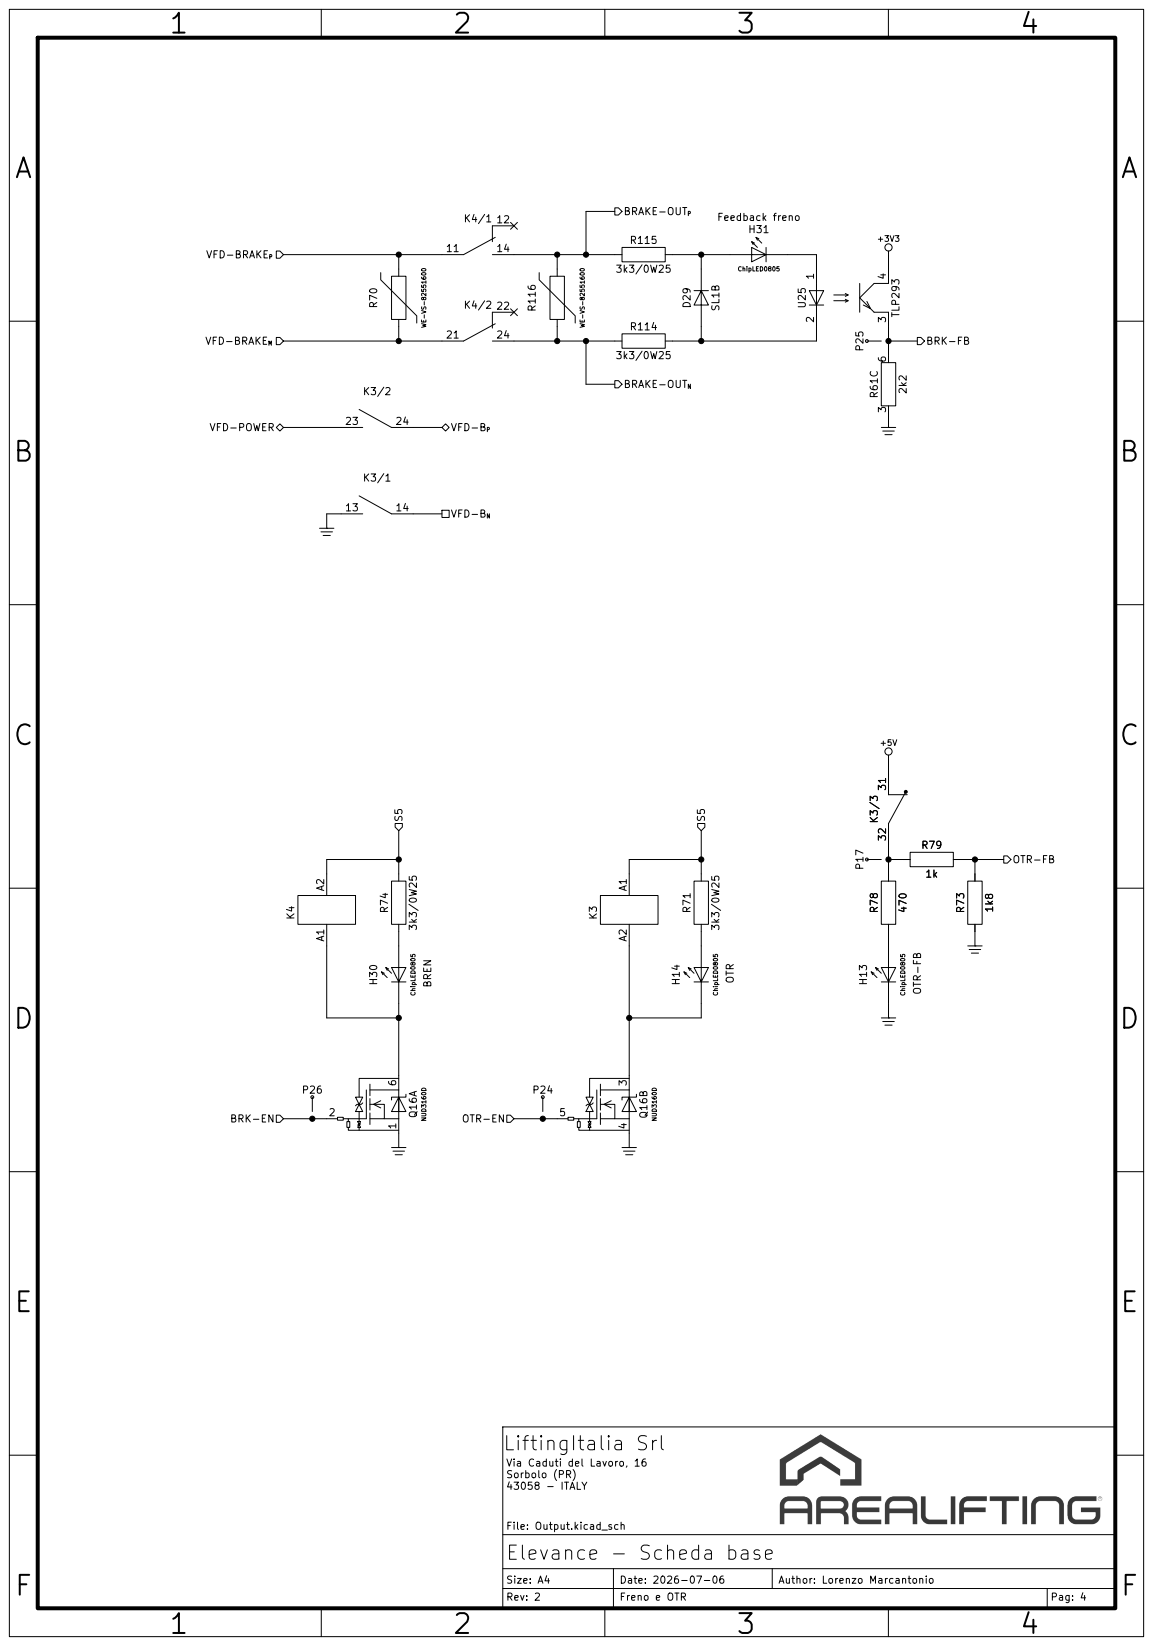
[picture p22: page 4]

6 Q16A NUD3160D A1 A2 K3 A1 A2 K4 R74 3k3/0W25 H30 ChipLED0805 P17 R78 470 R116 WE-VS-82551600 3 6 R61C 2k2 R73 1k8 R70 D29 SL1B WE-VS-82551600 R115

Via Caduti del Lavoro, 16
Sorbolo (PR) 43058 - ITALY Rev: 2 Elevance - Scheda base

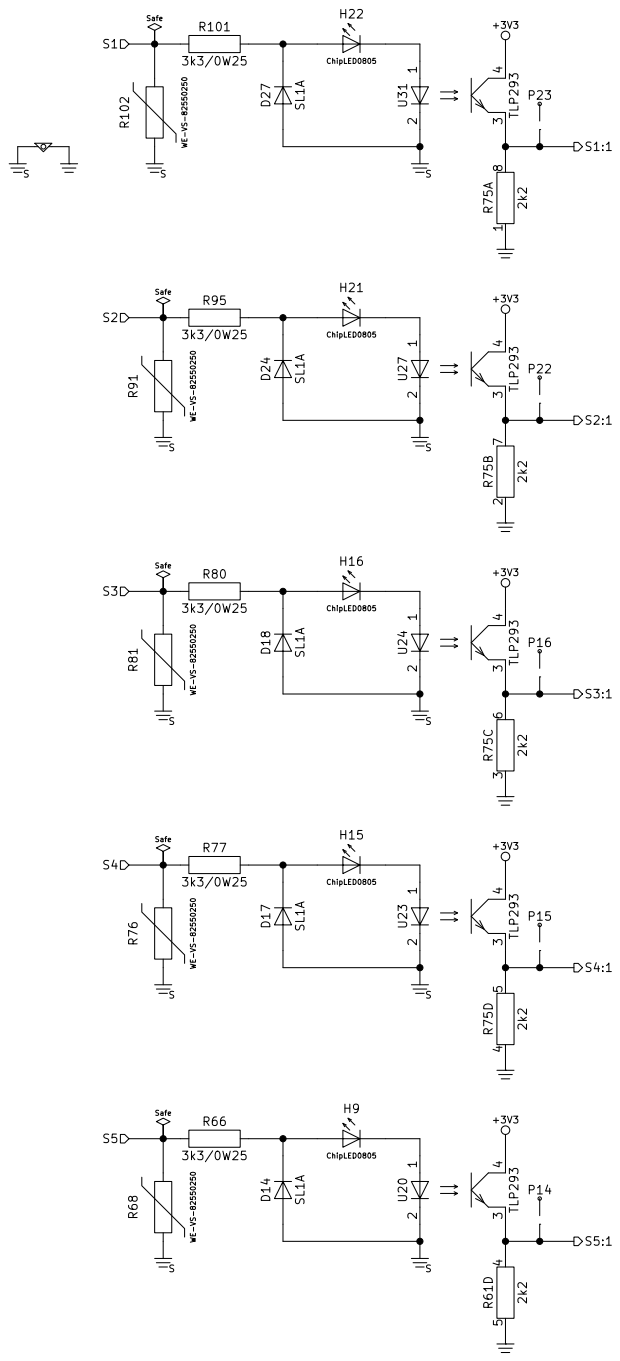
[picture p23: page 5]

Via Caduti del Lavoro, 16
Sorbolo (PR) 43058 - ITALY Rev: 2 Elevance - Scheda base

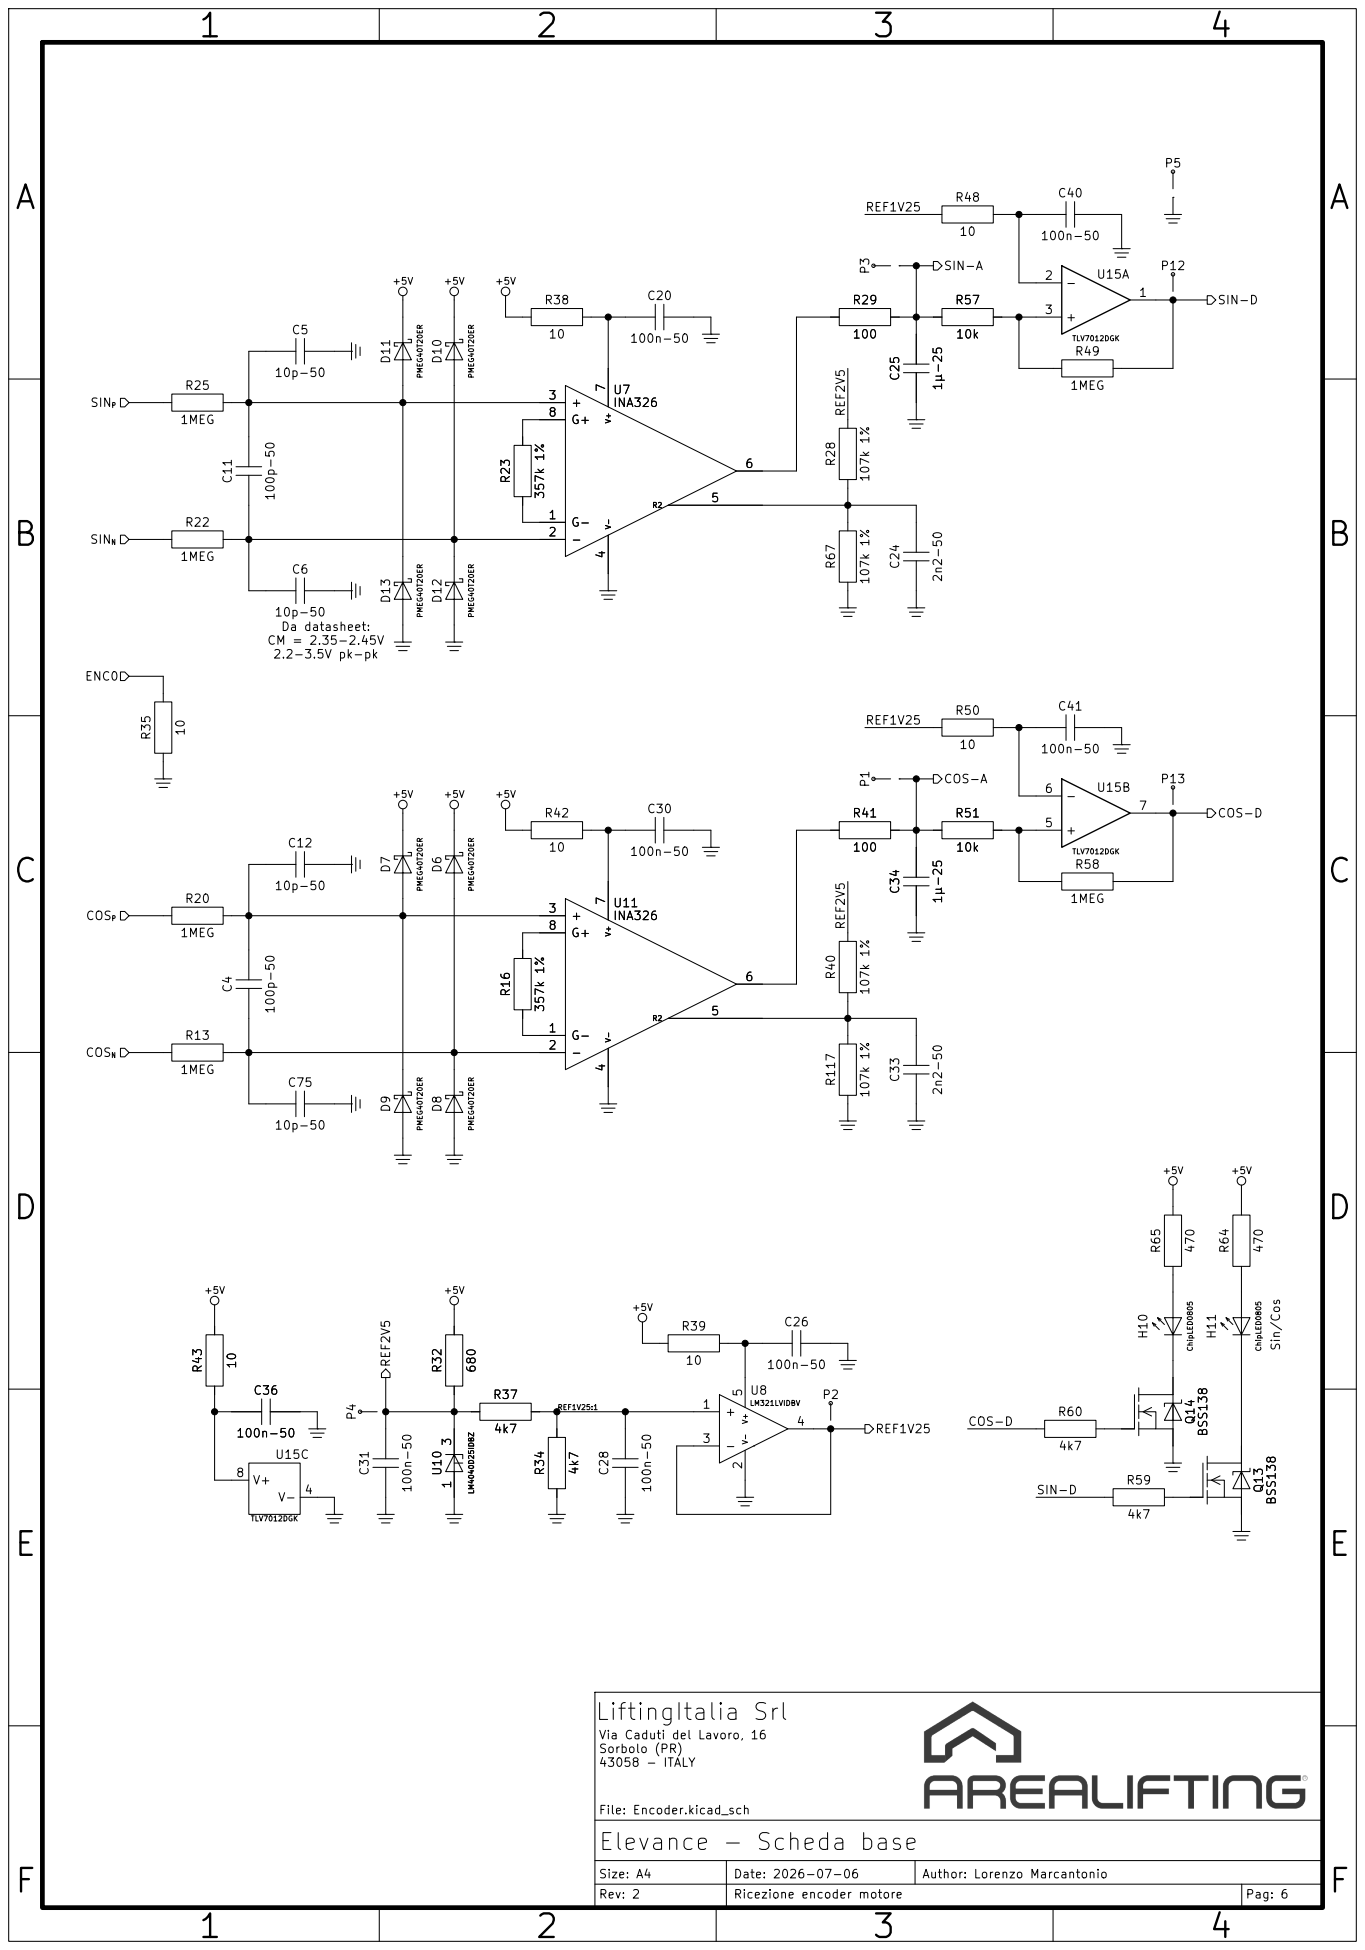
[picture p24: page 6]

File: Encoder.kicad_sch LiftingItalia Srl

Via Caduti del Lavoro, 16
Sorbolo (PR) 43058 - ITALY Rev: 2 Elevance - Scheda base

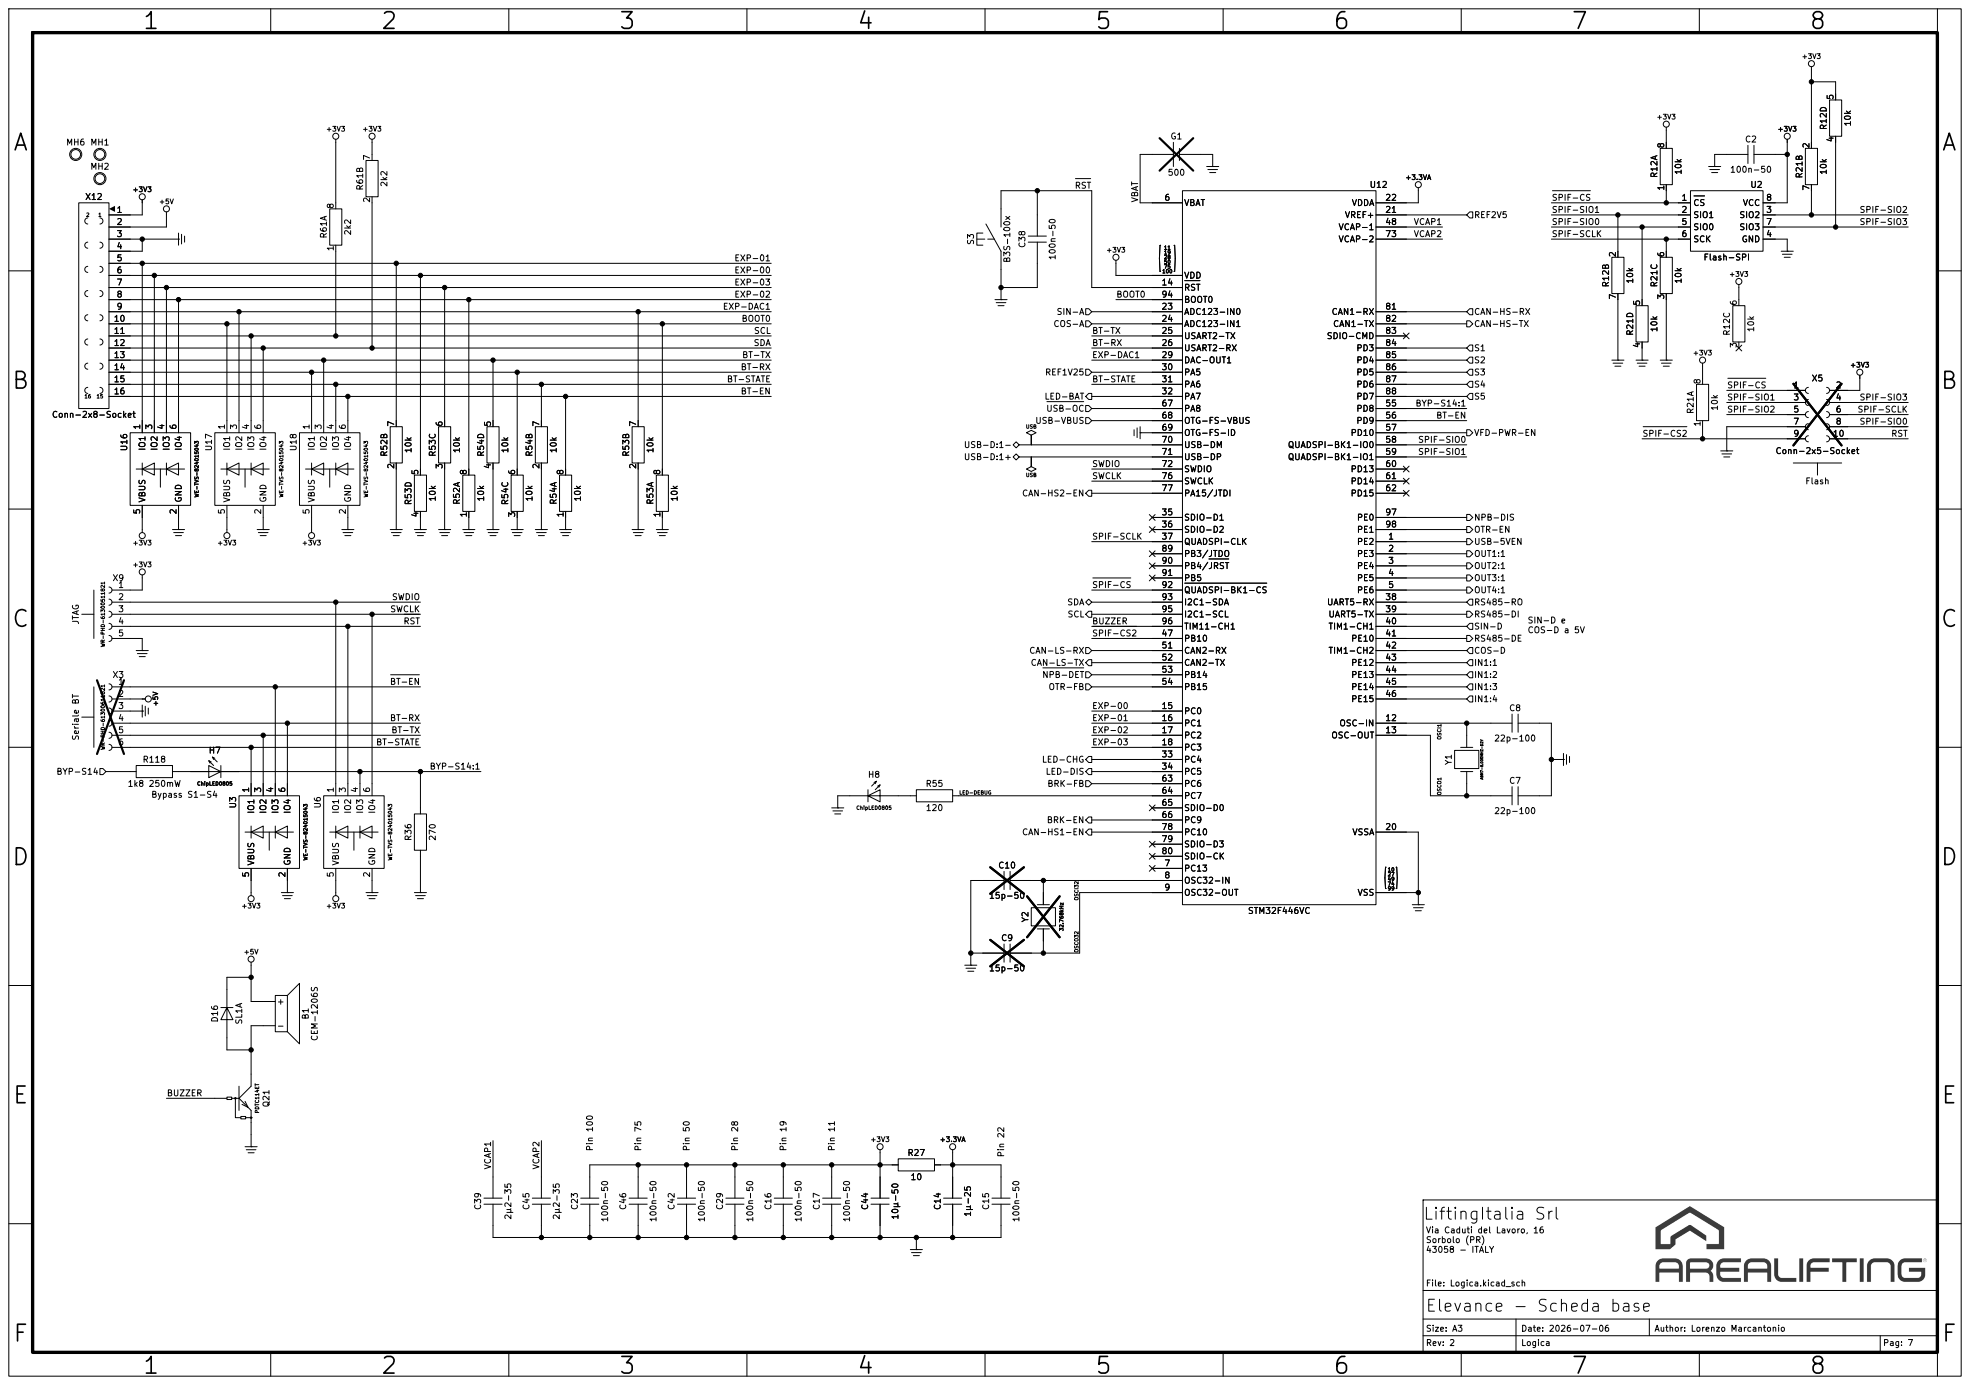
[picture p25: page 7]

SPIF-SIO1 BT-RX BT-RX BT-EN

REF2V5 CAN-HS-TX BRK-EN

SPIF-SIO0 RST SPIF-SCLK

CAN-LS-TX NPB-DET SDA

CAN-LS-RX OTR-FB

Via Caduti del Lavoro, 16
Sorbolo (PR) 43058 - ITALY Rev: 2 Elevance - Scheda base

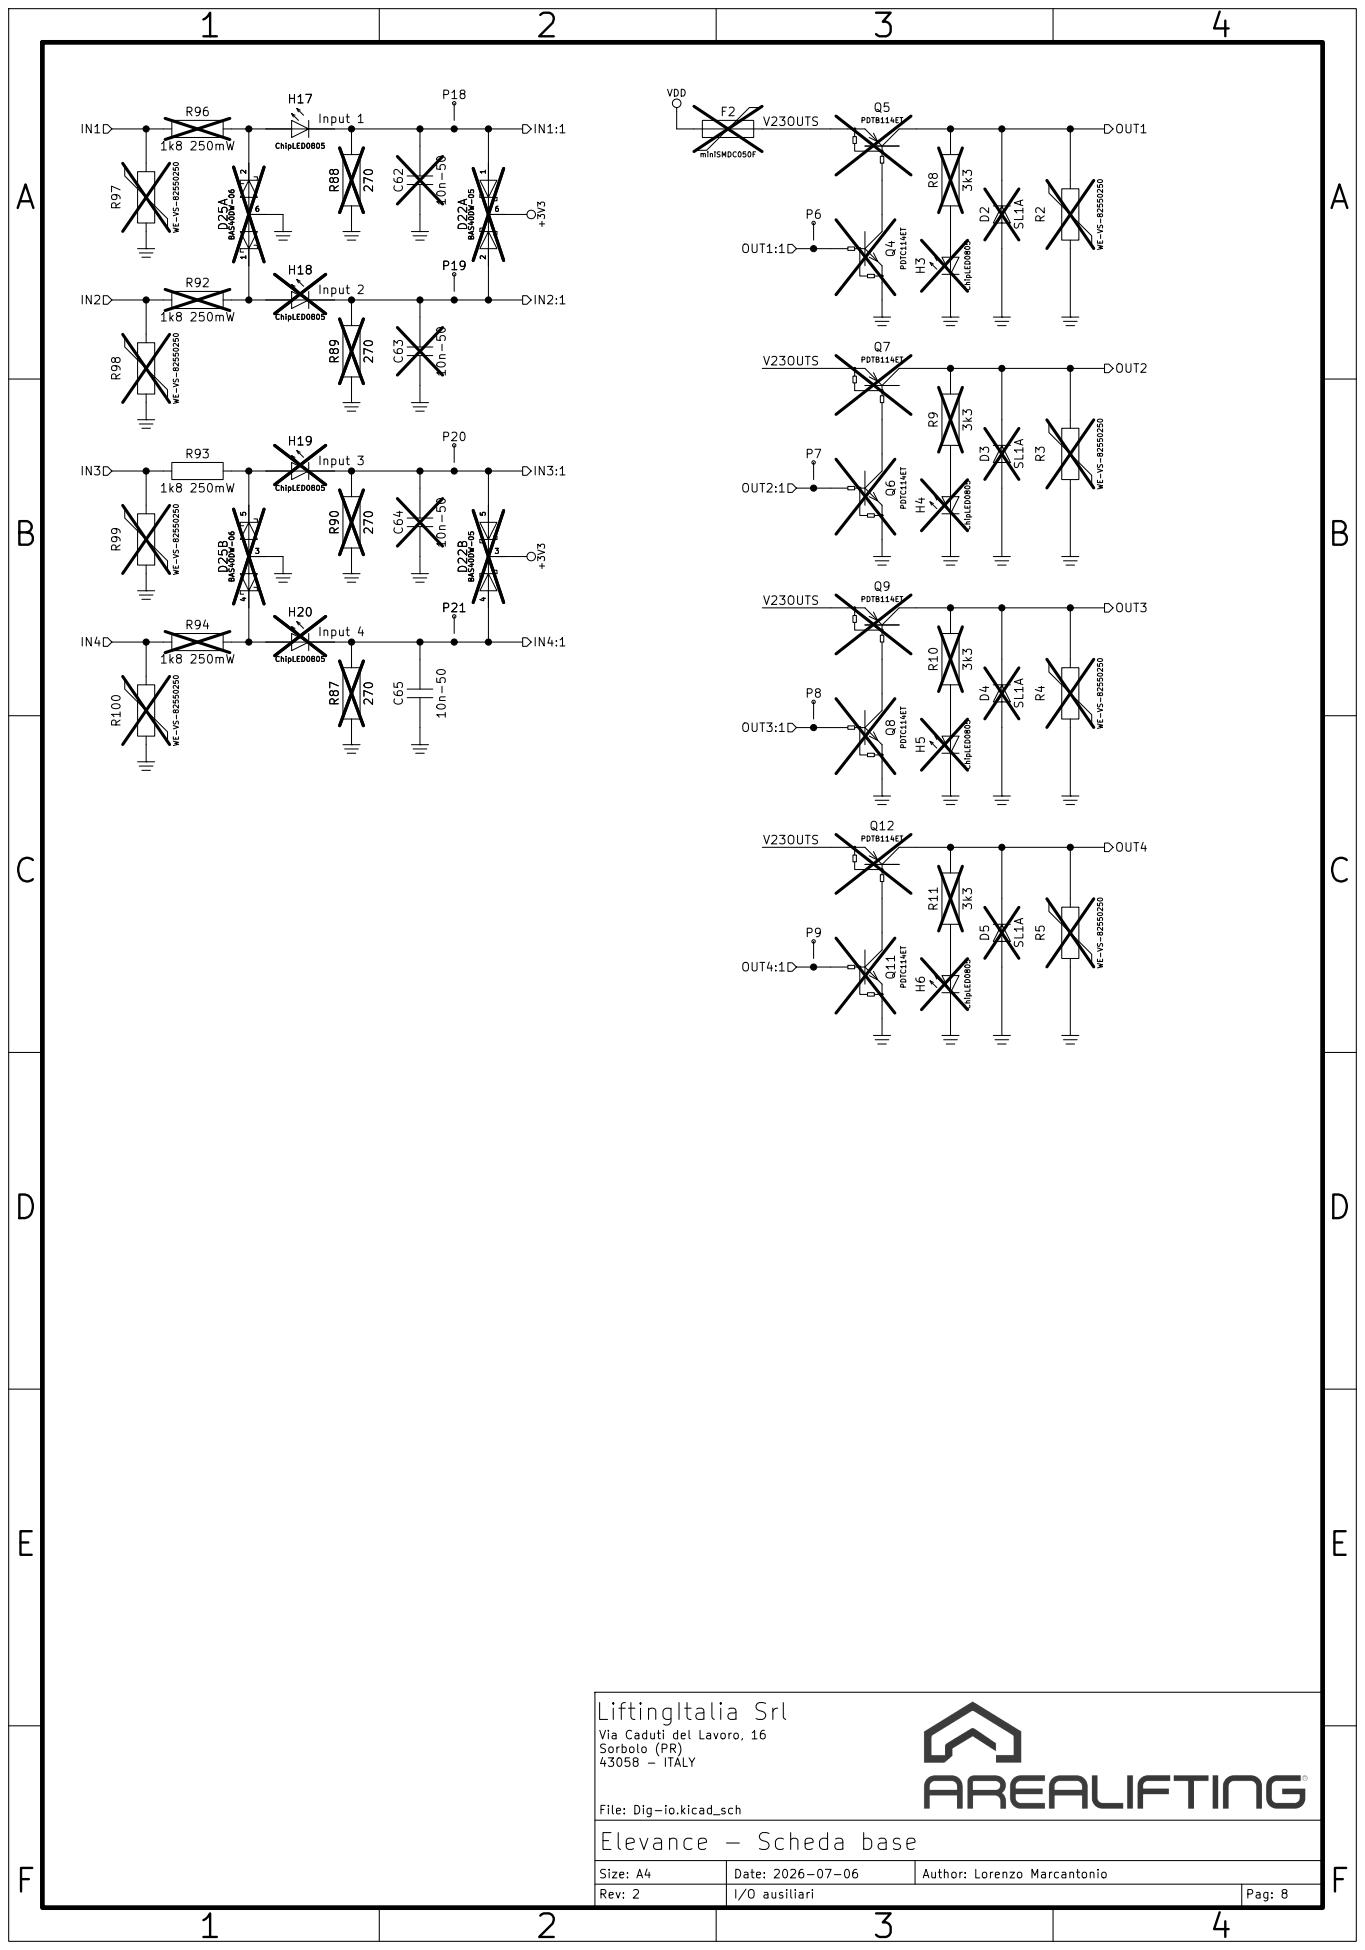
[picture p26: page 8]

Via Caduti del Lavoro, 16
Sorbolo (PR) 43058 - ITALY Rev: 2 Elevance - Scheda base
