dermatoid-collab/EVC_FW/TTF-CX/fabs/TTF-CX.pdf

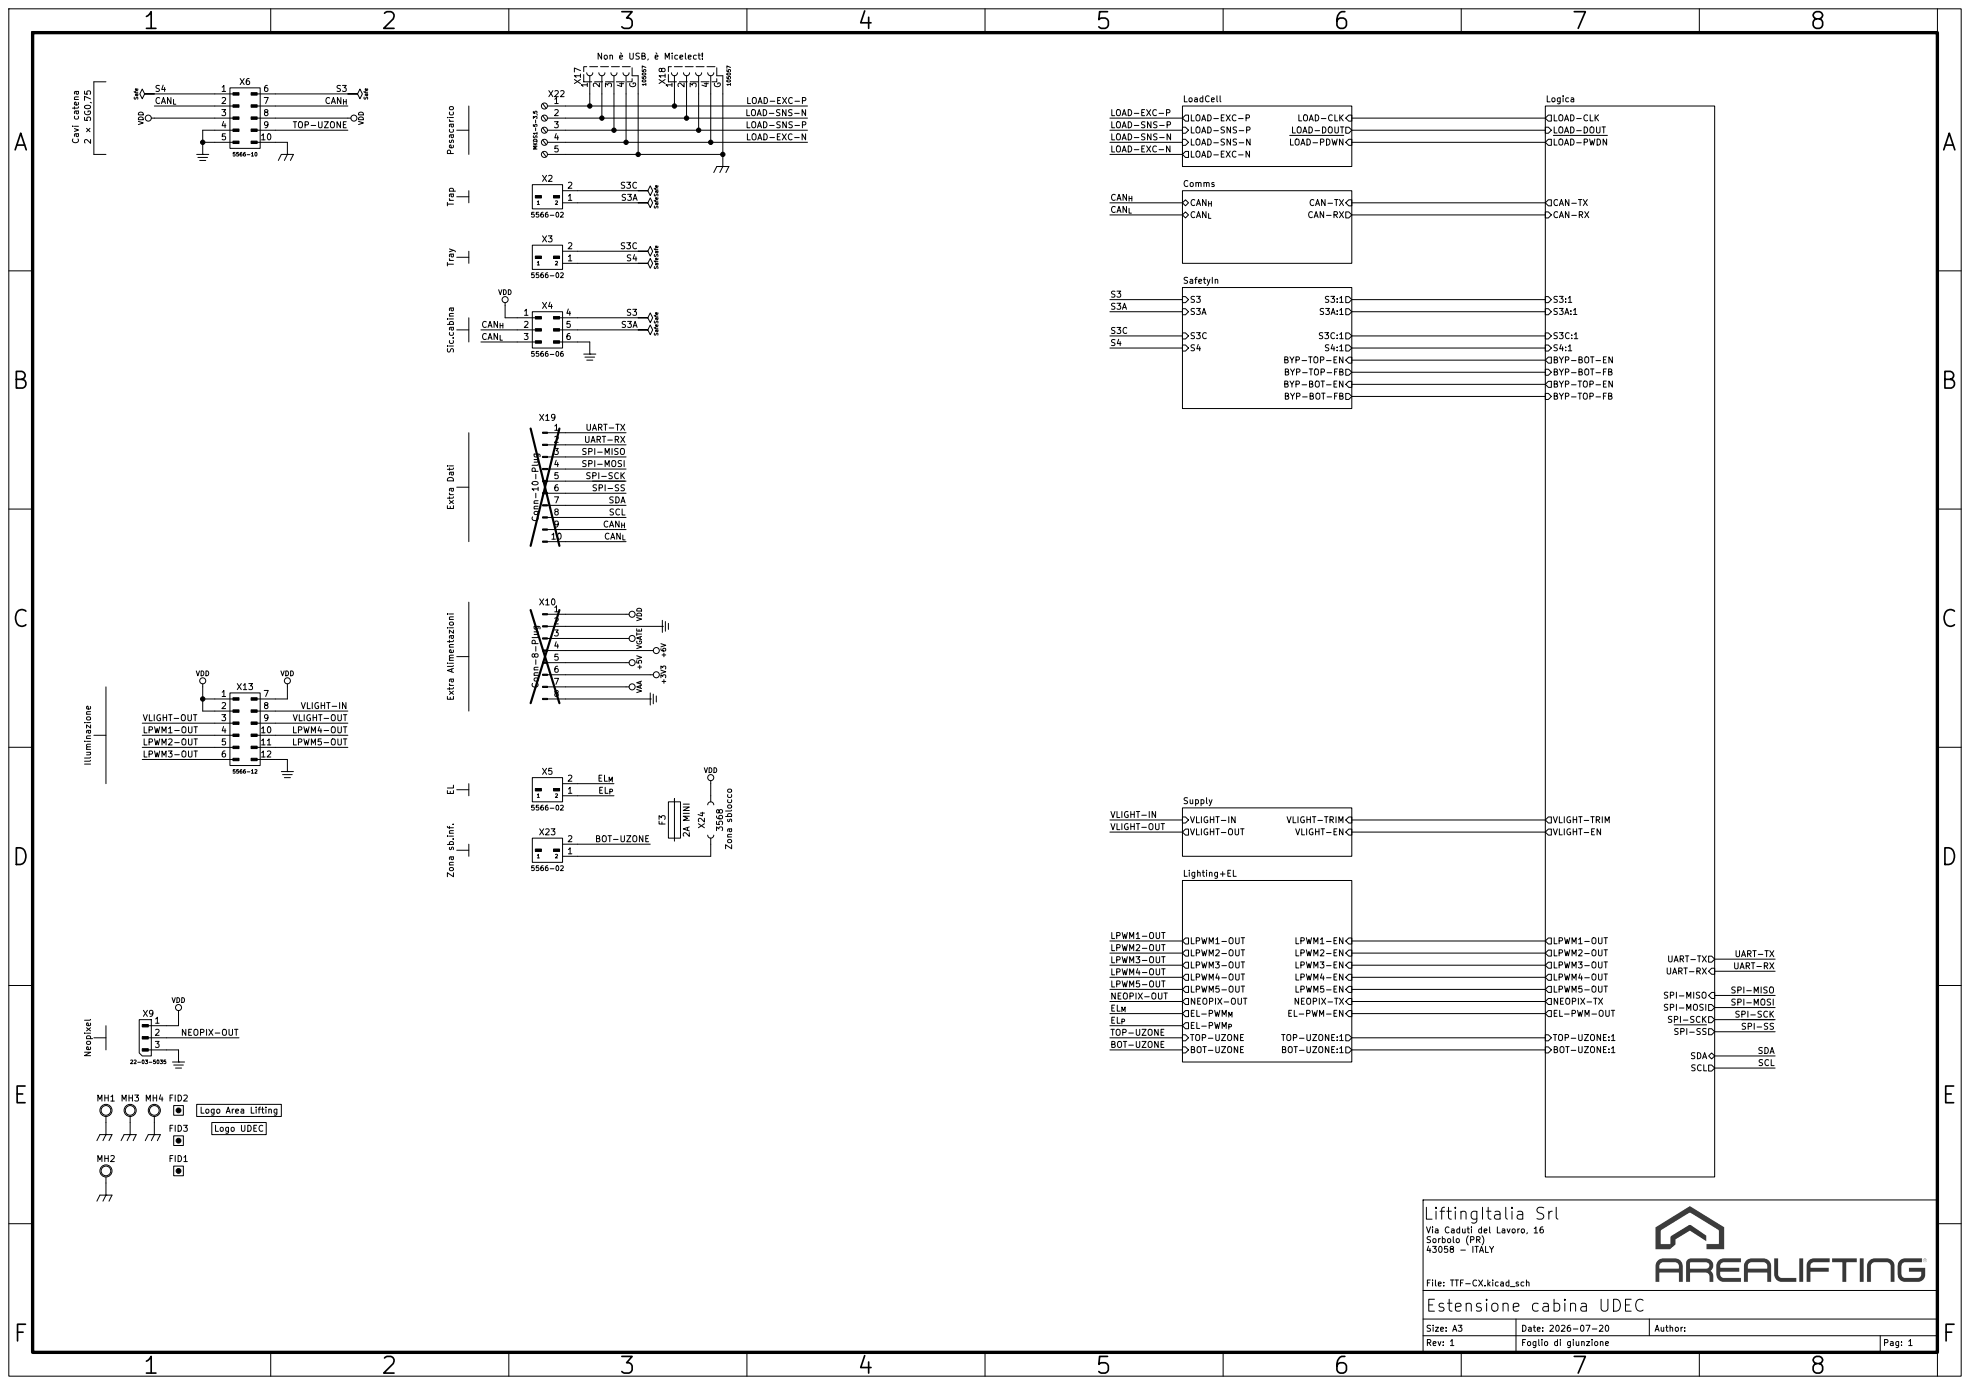
[picture p27: page 1]

LOAD-EXC-P
LOAD-DOUT LOAD-EXC-N
LOAD-SNS-N

CAN-RX CAN-TX

BOT-UZONE SPI-MOSI SPI-MISO

Supply
LPWM4-OUT NEOPIX-OUT LPWM5-OUT LPWM3-OUT VLIGHT-OUT VLIGHT-IN

VLIGHT-TRIM
LPWM1-OUT LPWM2-OUT LPWM3-OUT LPWM4-OUT LPWM5-OUT EL-PWM-OUT VLIGHT-EN

EL-PWMM
EL-PWMP BOT-UZONE

SPI-MOSI SPI-SCK UART-RX UART-TX

SPI-MOSI UART-TX
UART-RX

SCL SDA SPI-MISO

TOP-UZONE BOT-UZONE

SPI-SS BOT-UZONE:1
TOP-UZONE:1

File: TTF-CX.kicad_sch LiftingItalia Srl

Via Caduti del Lavoro, 16

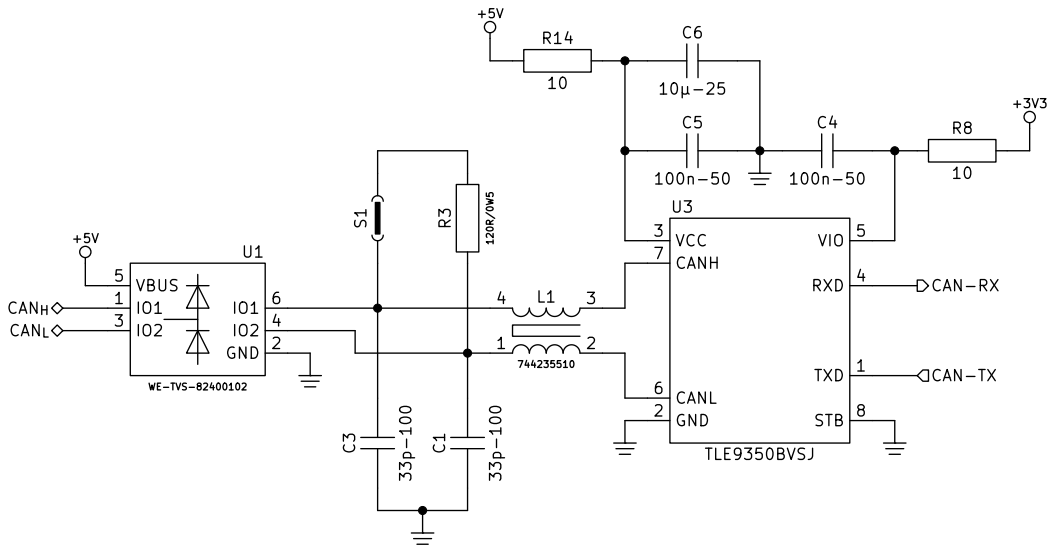
[picture p28: page 2]

File: Comms.kicad_sch LiftingItalia Srl

Via Caduti del Lavoro, 16
Sorbolo (PR) 43058 - ITALY Rev: 1 Estensione cabina UDEC

Author:

Transceiver CAN e 1-wire | Pag: 2

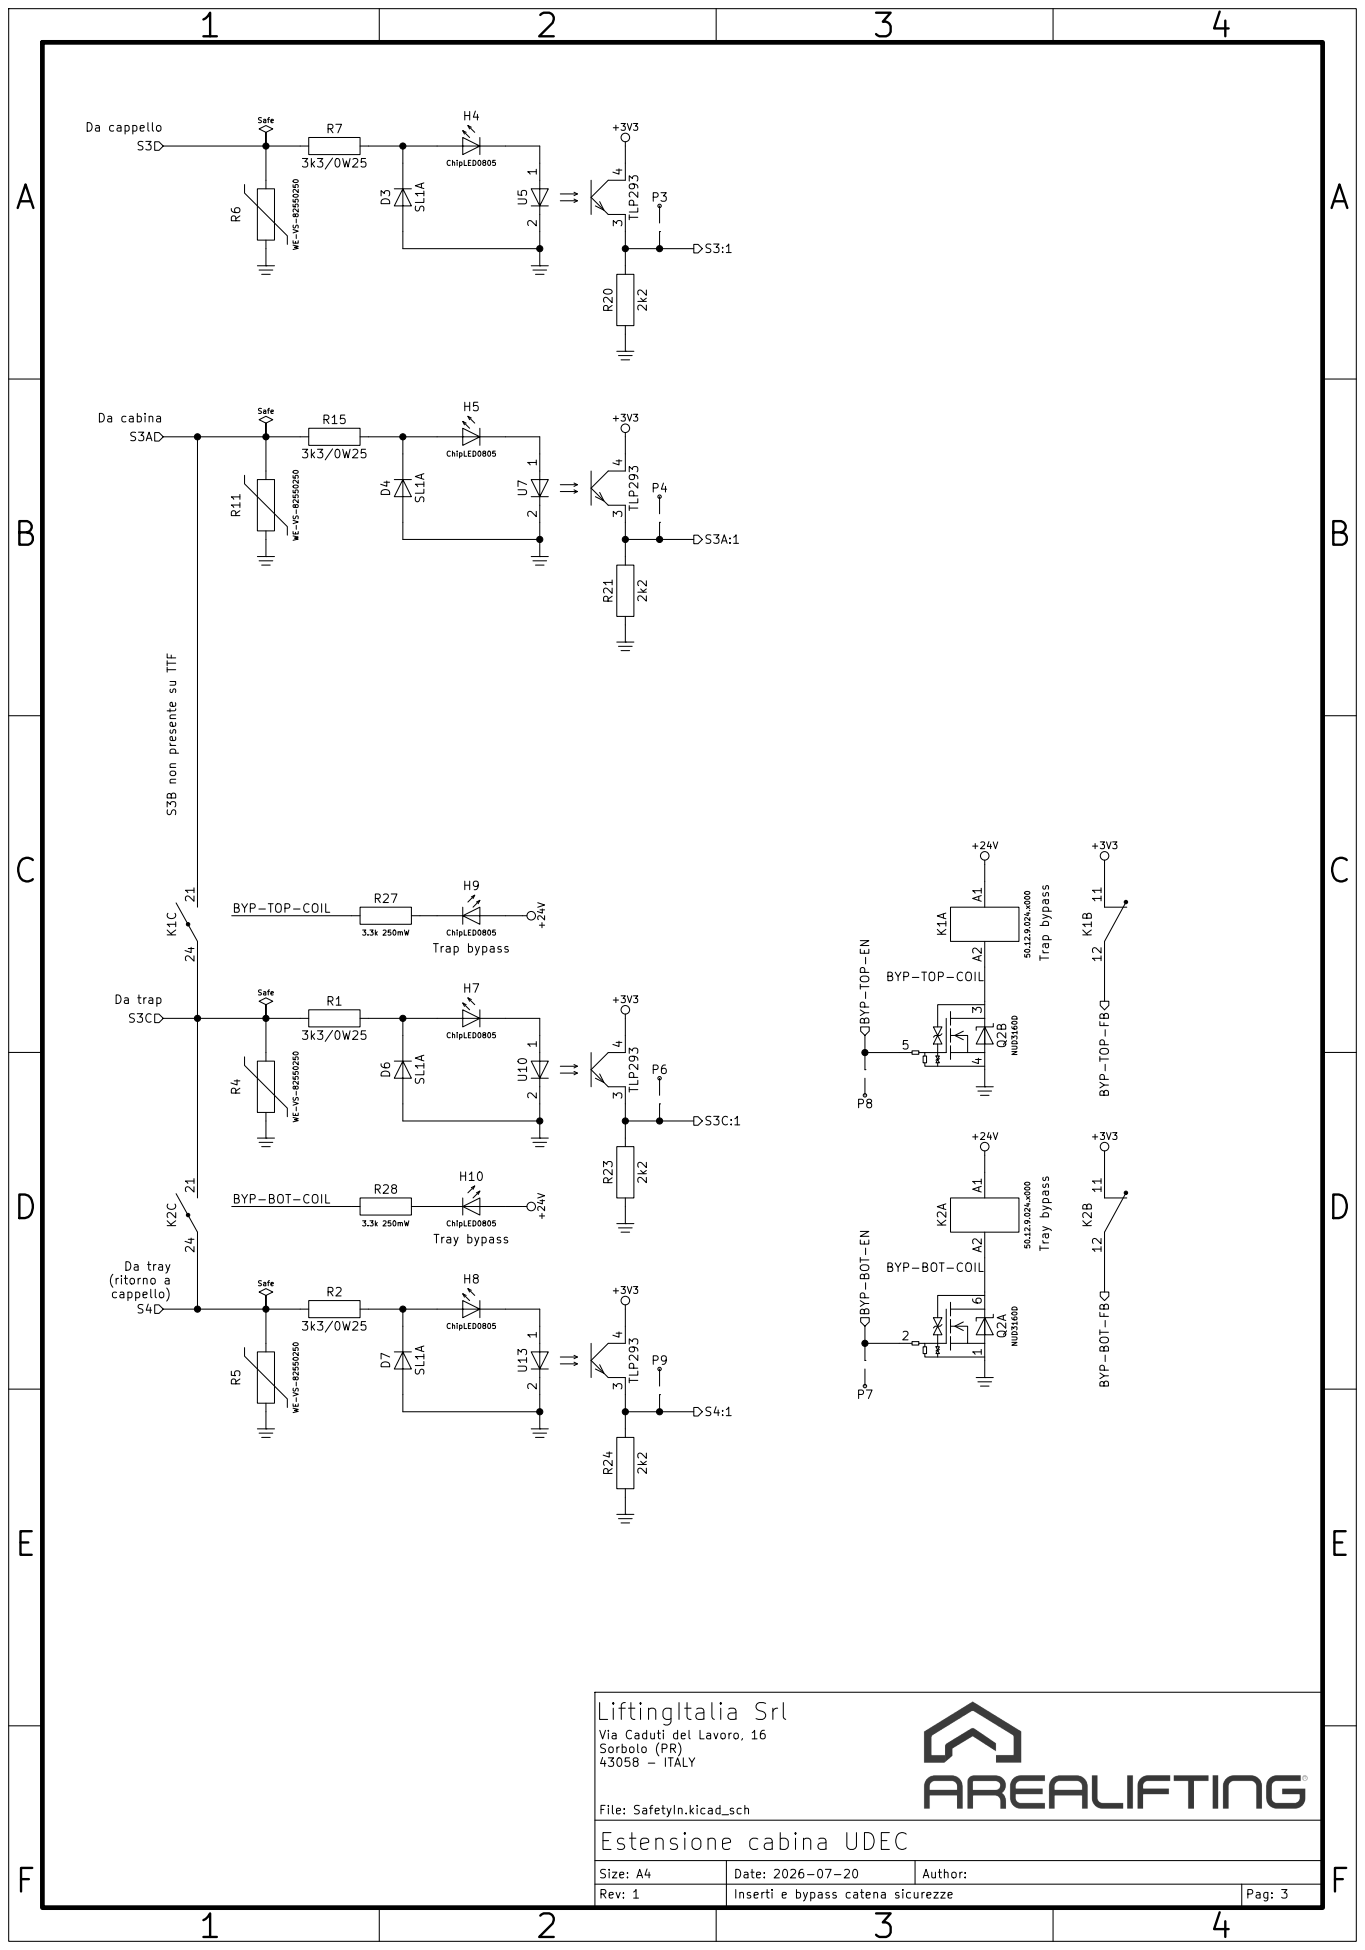
[picture p29: page 3]

Via Caduti del Lavoro, 16
Sorbolo (PR) 43058 - ITALY Rev: 1 Estensione cabina UDEC

Author:

Inserti e bypass catena sicurezze | Pag: 3

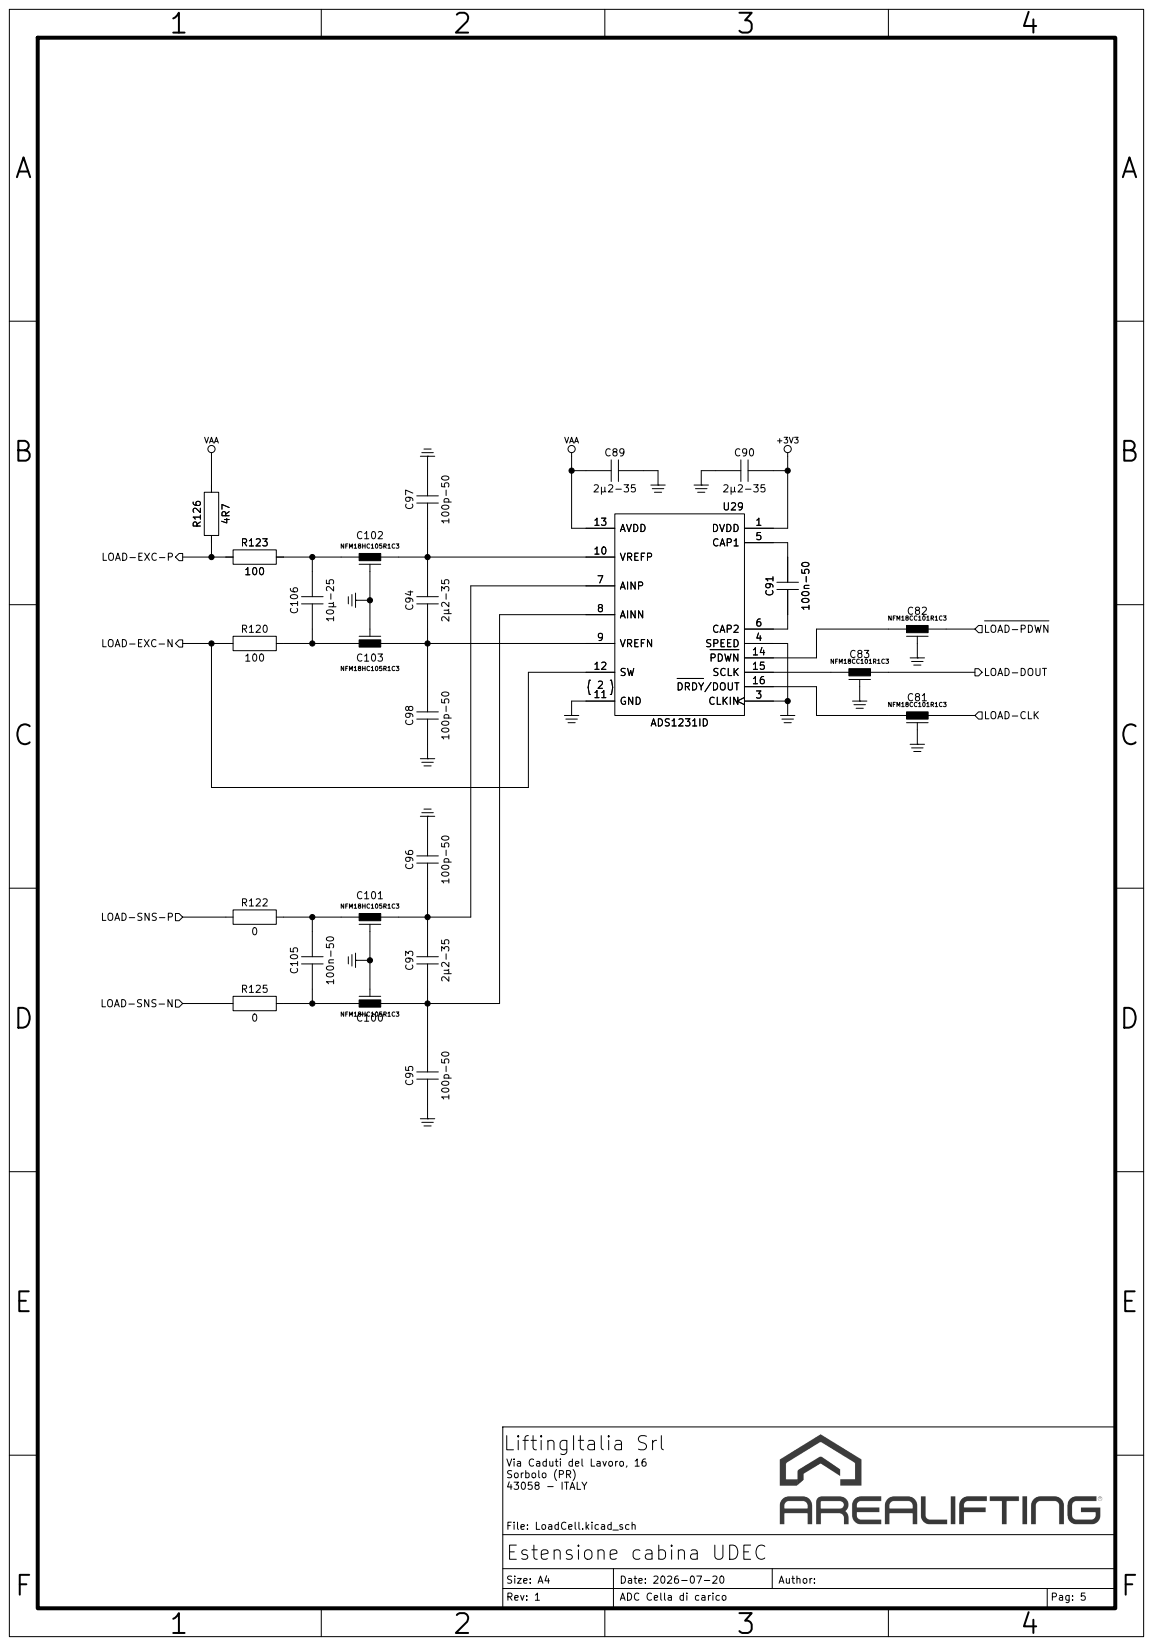
[picture p30: page 4]

LOAD-DOUT LOAD-EXC-P

File: LoadCell.kicad_sch LiftingItalia Srl

Via Caduti del Lavoro, 16
Sorbolo (PR) 43058 - ITALY Rev: 1 Estensione cabina UDEC

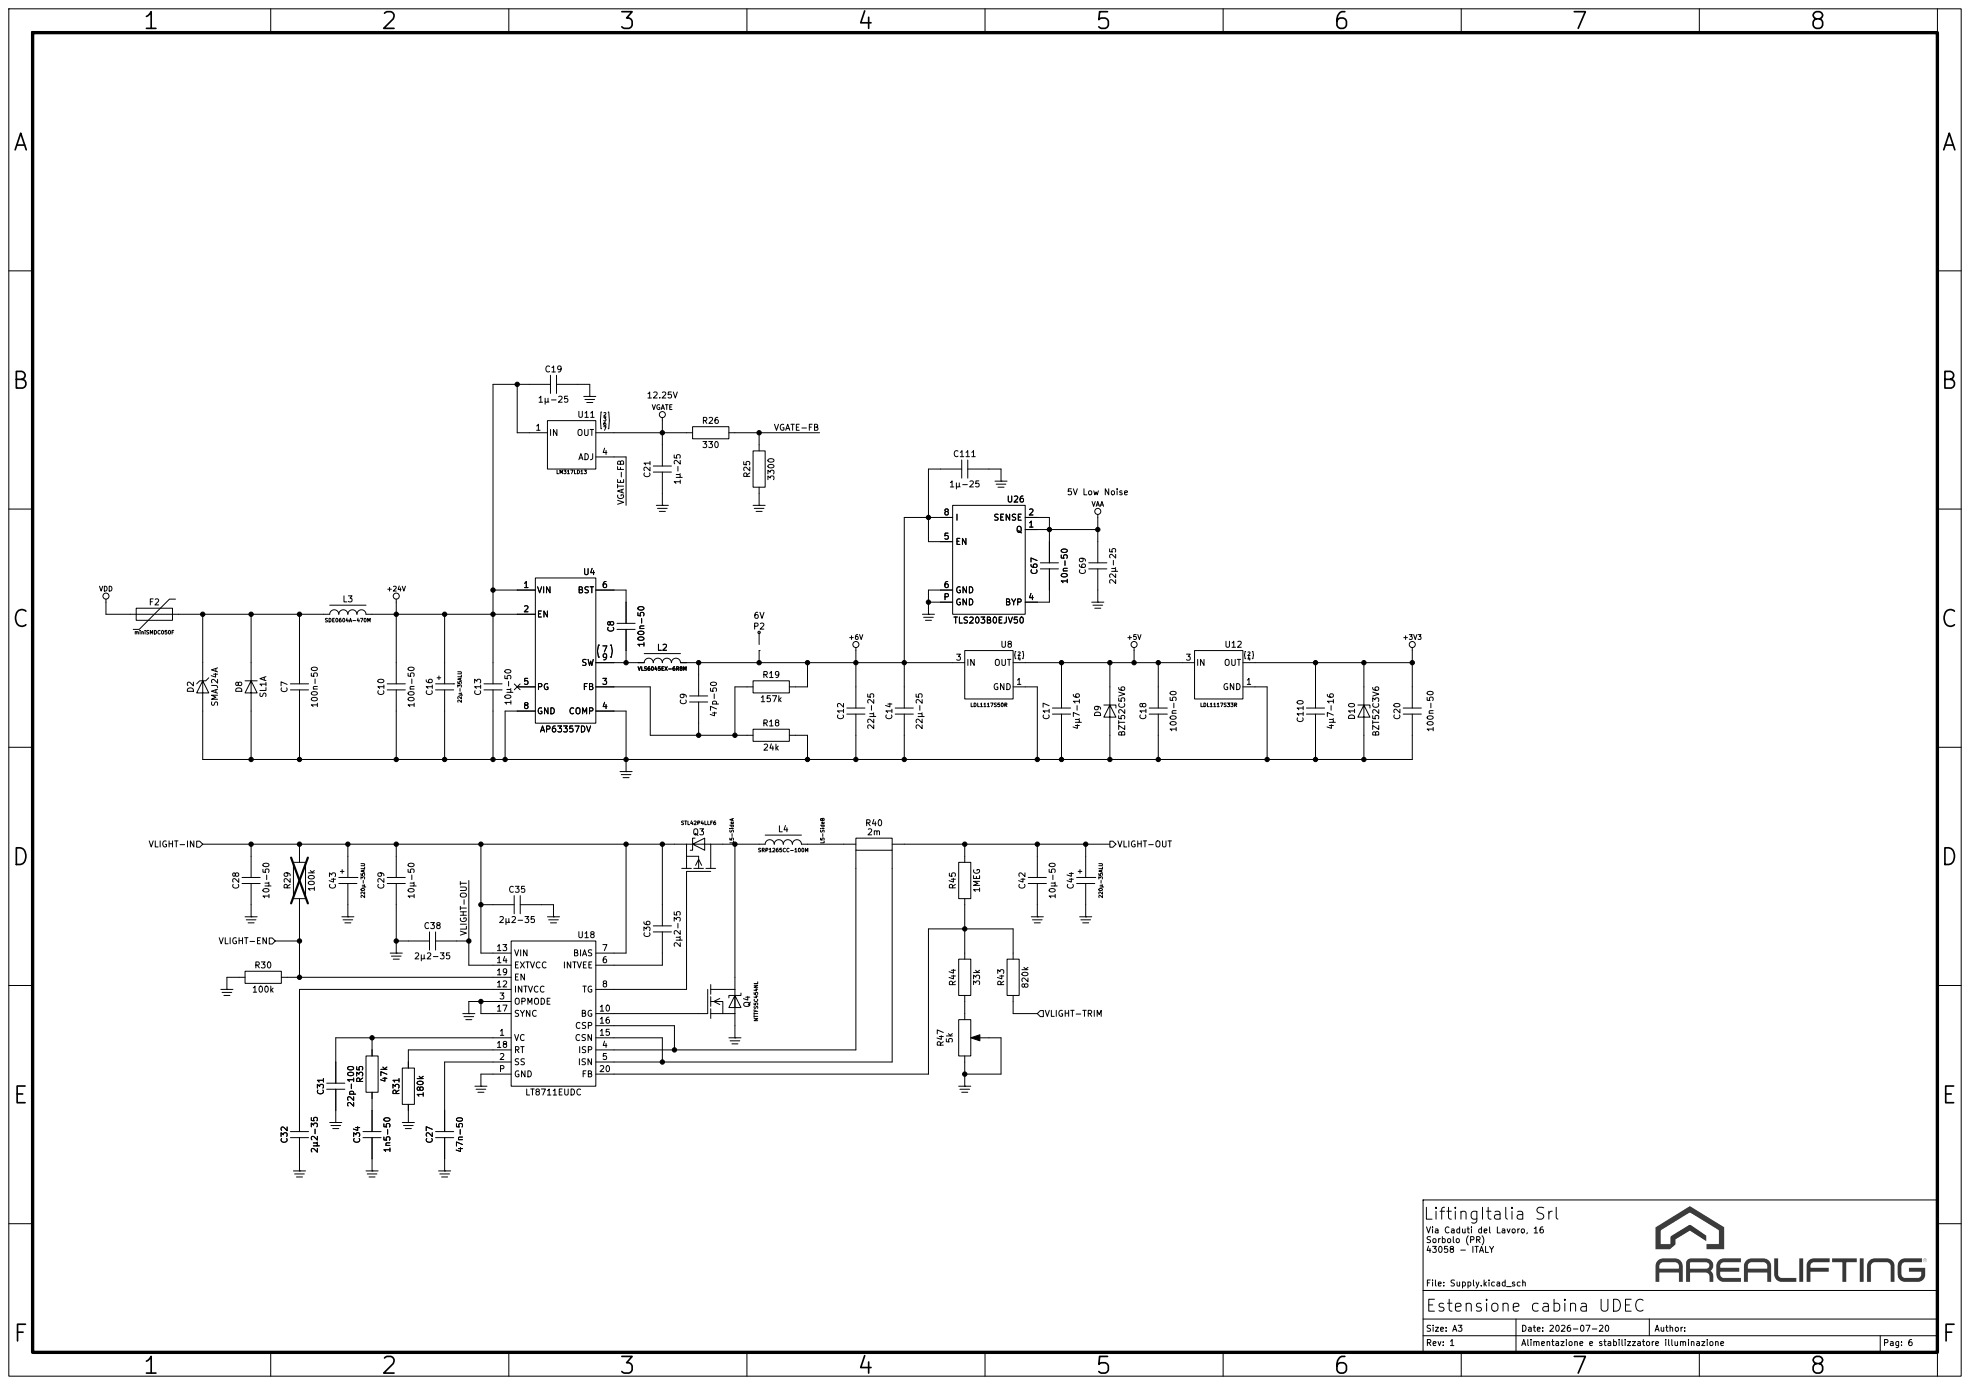
[picture p31: page 5]

Via Caduti del Lavoro, 16
Sorbolo (PR) 43058 - ITALY Rev: 1 Estensione cabina UDEC

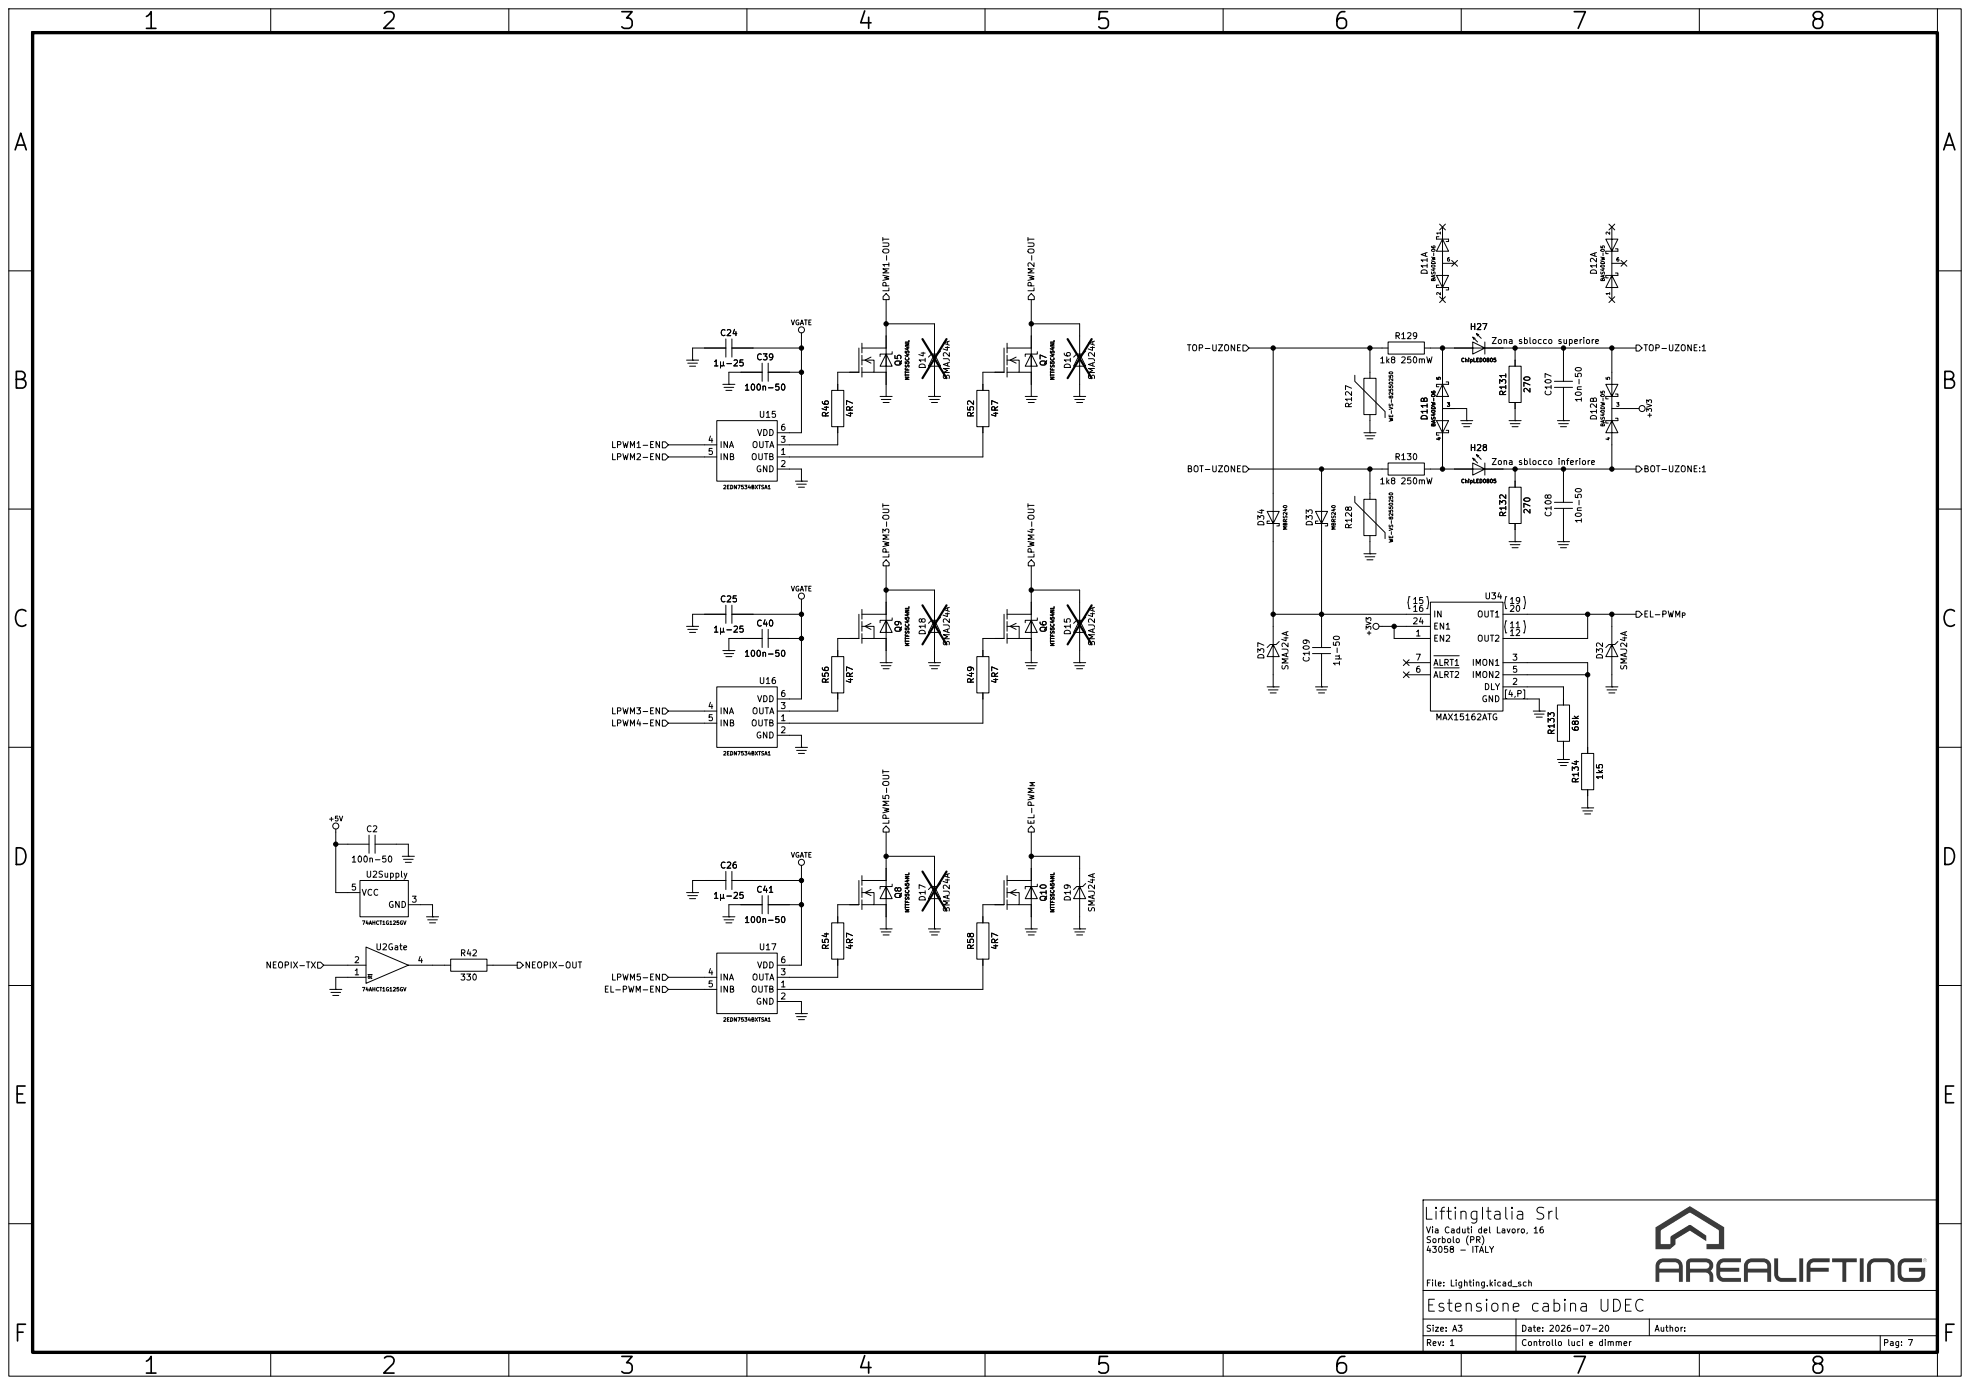
[picture p32: page 6]

TOP-UZONE LPWM4-OUT LPWM1-OUT

TOP-UZONE:1 BOT-UZONE:1

Via Caduti del Lavoro, 16

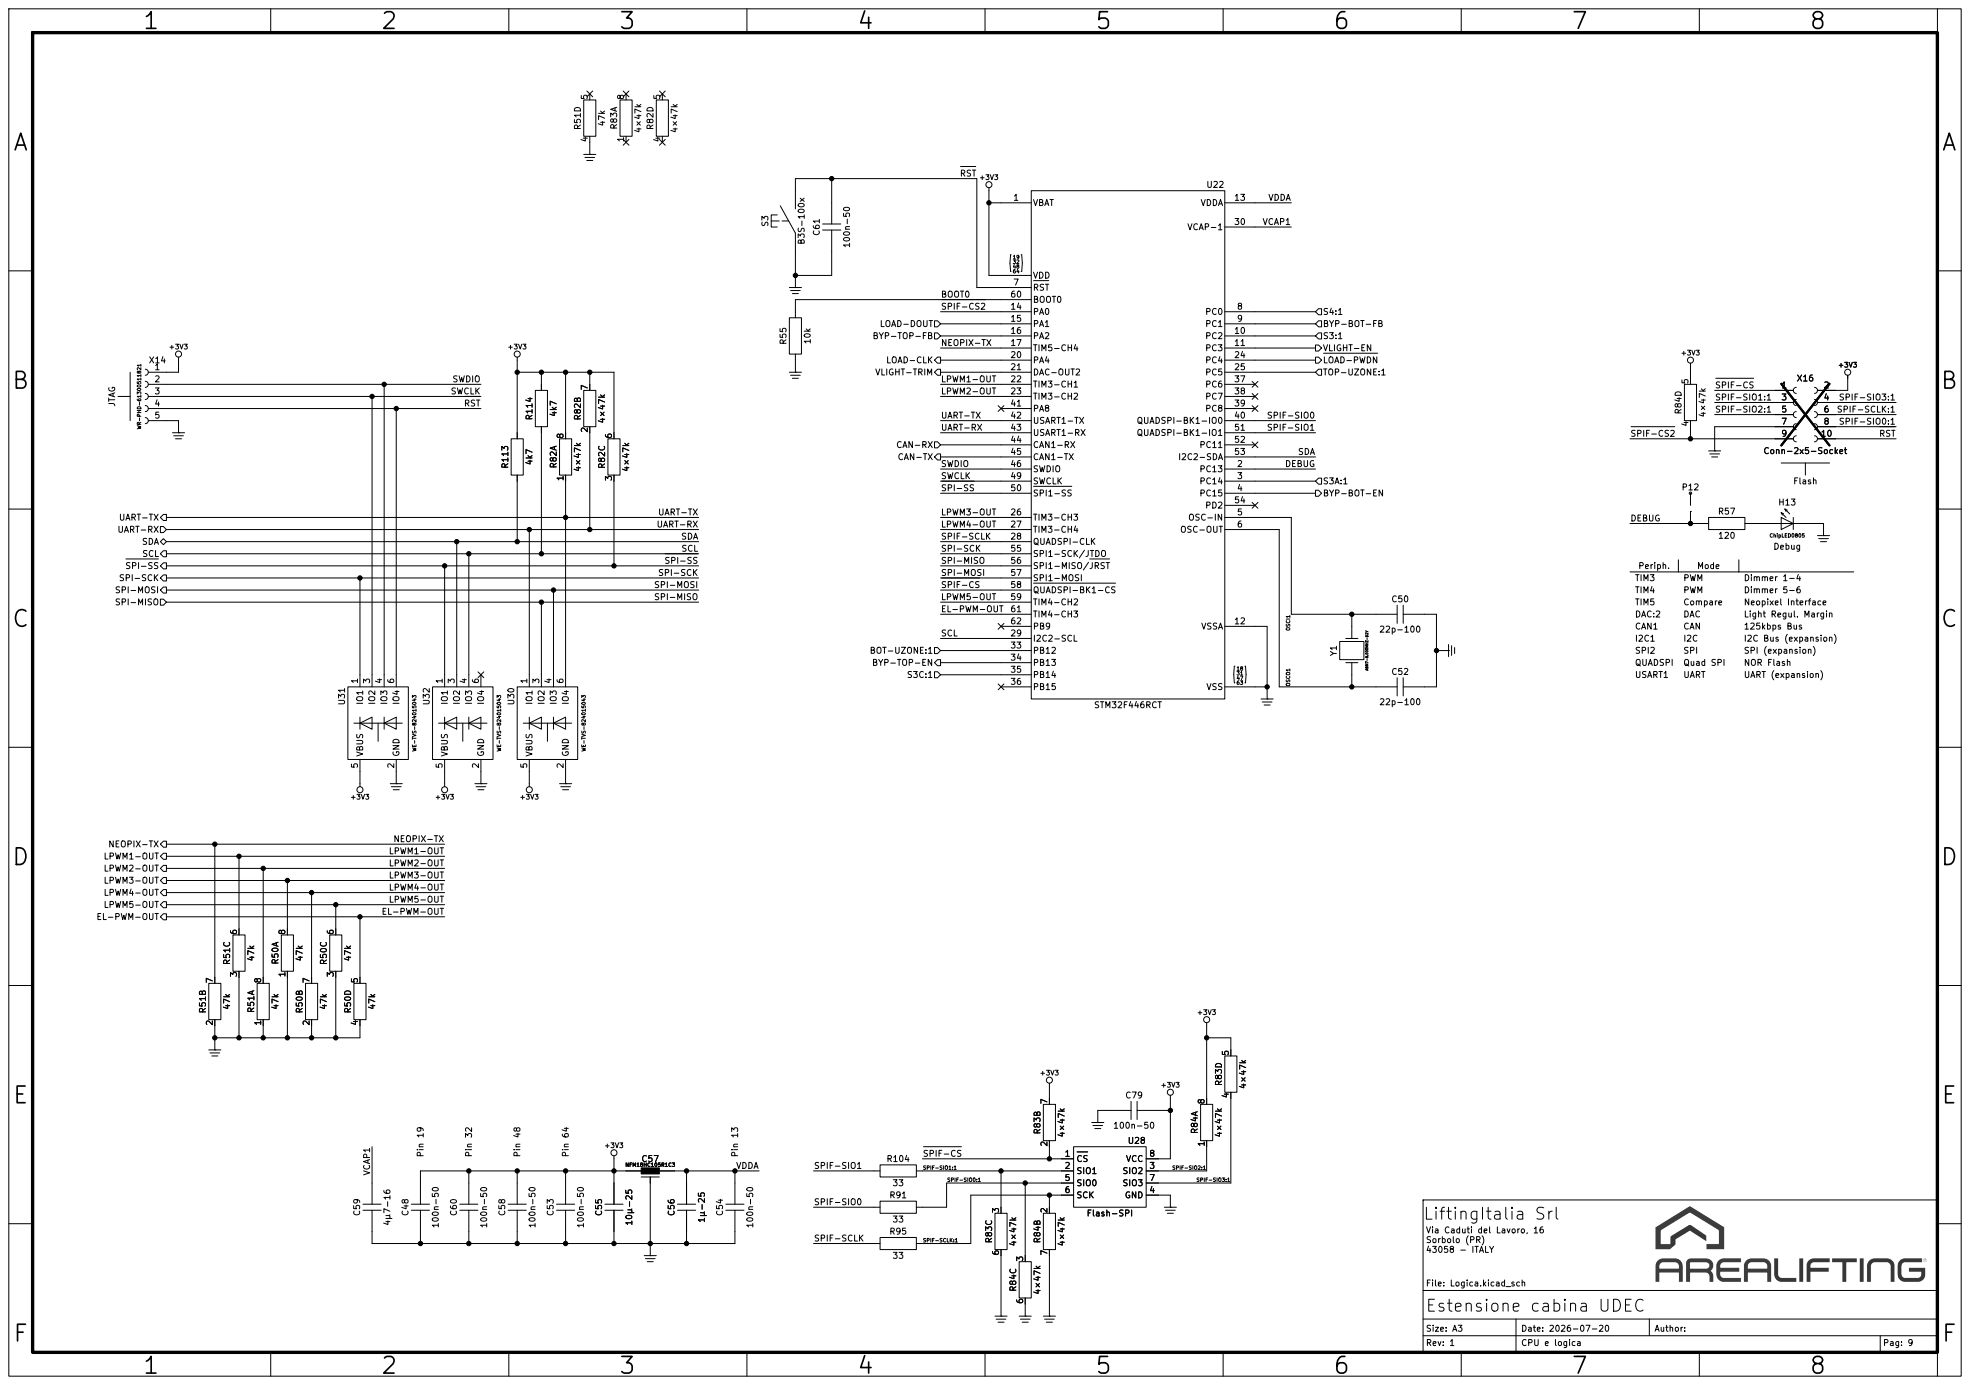
[picture p33: page 7]

LOAD-DOUT LOAD-CLK
BYP-TOP-FB

TIM3-CH1 22
SPI-MOSI UART-RX

SCL UART-TX
SPI-MOSI SDA UART-RX

UART-TX UART-RX

SPI-MOSI SDA SPI-MISO
EL-PWM-OUT SCL
SPI-SCK

EL-PWM-OUT NEOPIX-TX

Via Caduti del Lavoro, 16
Sorbolo (PR) 43058 - ITALY Rev: 1 Estensione cabina UDEC
