dermatoid-collab/EVC_FW/UDEC.CX/fabs/UDEC.CX.pdf

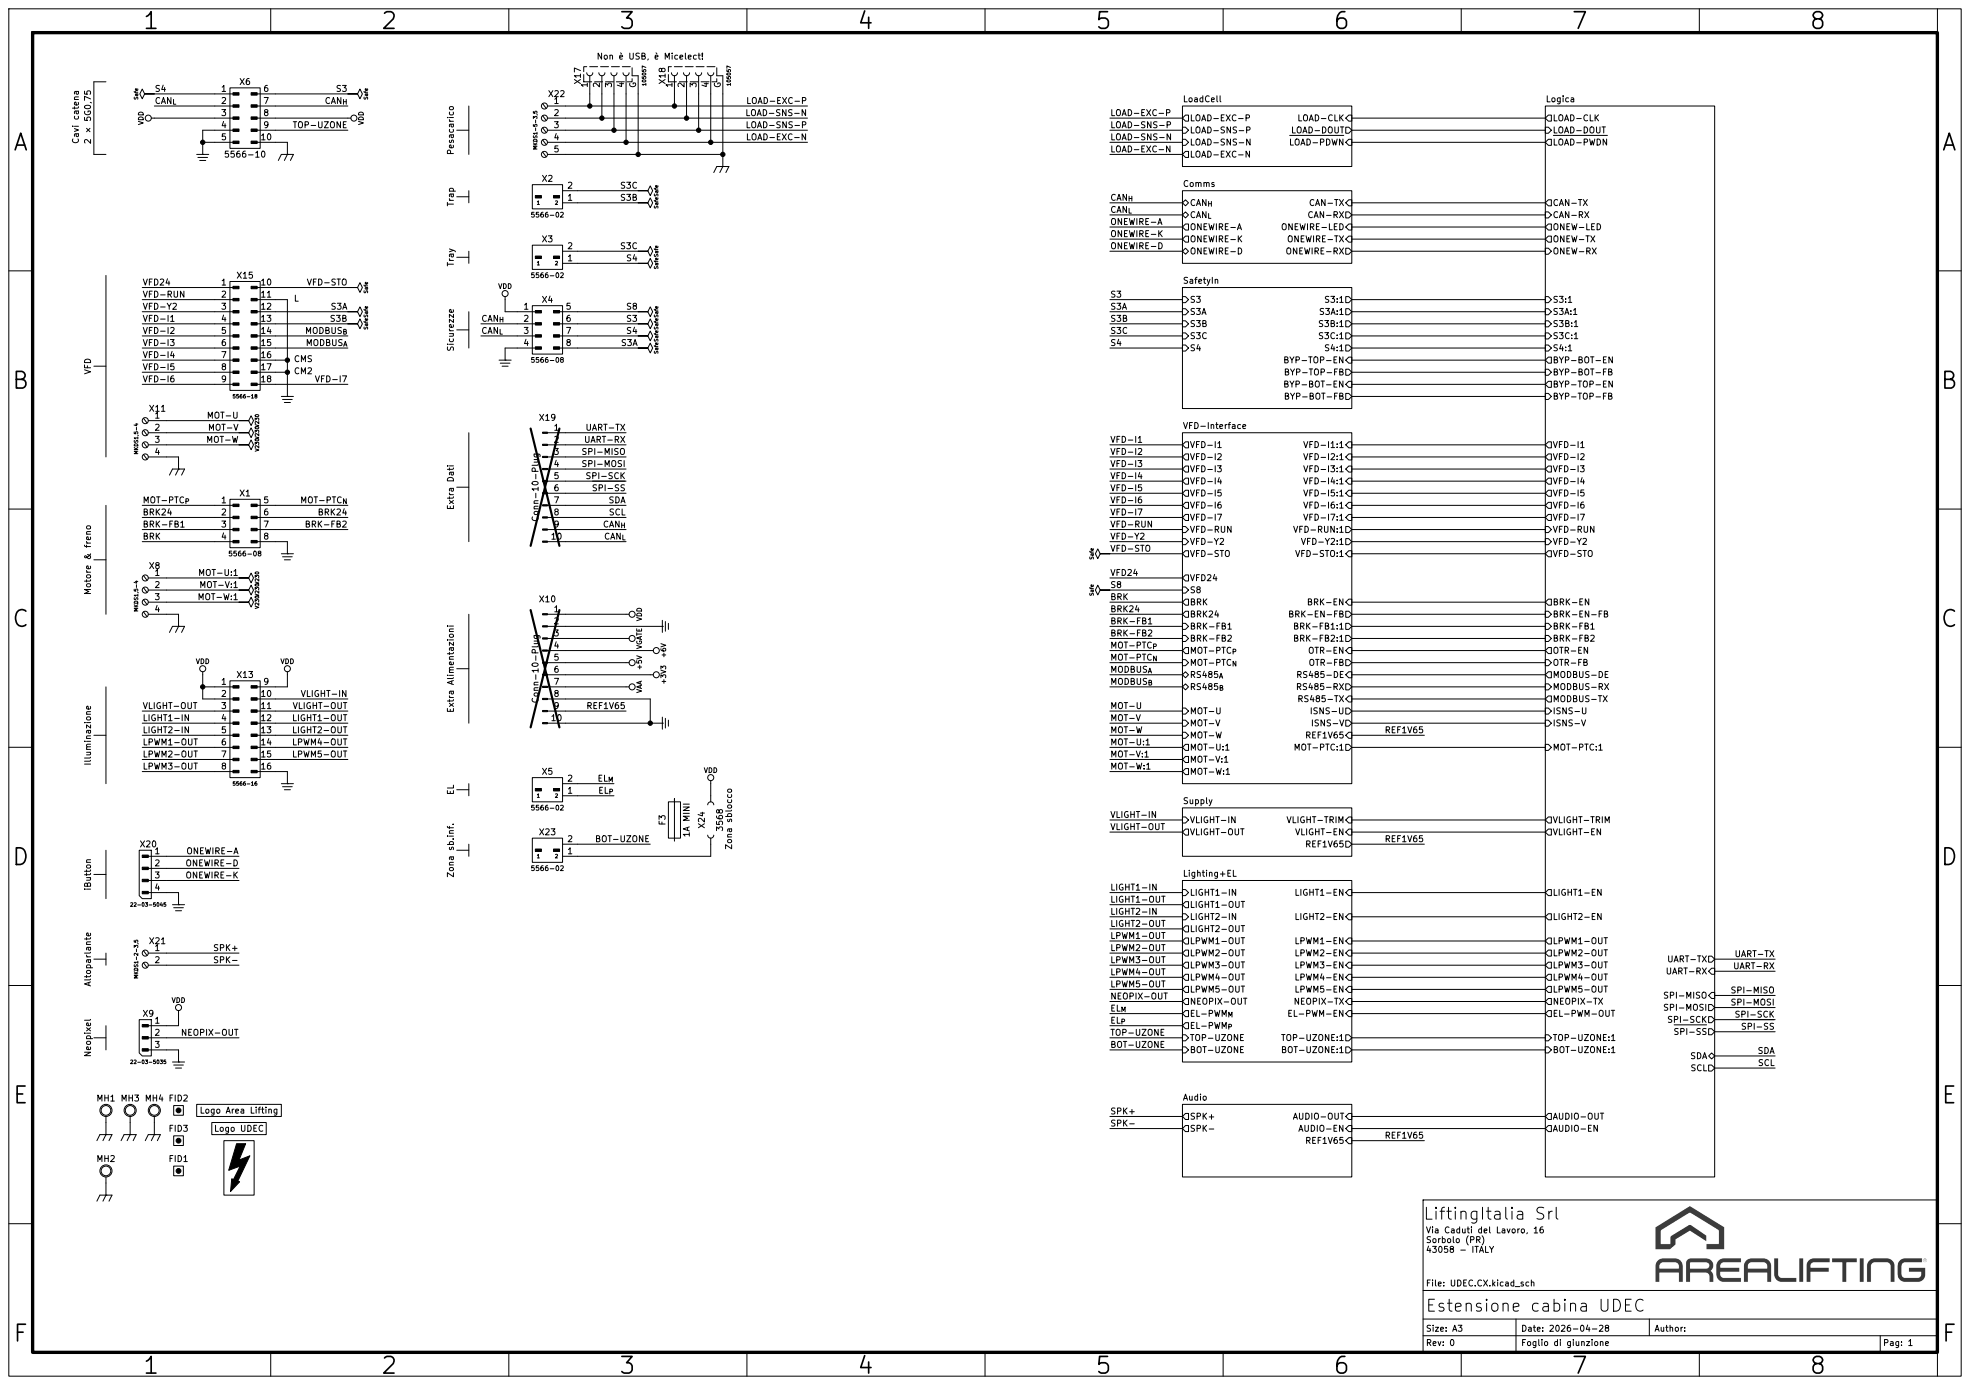
[picture p34: page 1]

LOAD-EXC-P
LOAD-DOUT LOAD-EXC-N
LOAD-SNS-N

CAN-RX CAN-TX ONEW-RX ONEW-TX

UART-RX UART-TX

SPI-MOSI SPI-MISO

VFD-I1
VFD-I2
VFD-I3
VFD-I4
VFD-I5
VFD-I6
VFD-I7
VFD-RUN
VFD-Y2
VFD-STO
LPWM1-OUT LPWM2-OUT LPWM3-OUT LPWM4-OUT LPWM5-OUT EL-PWM-OUT MODBUS-DE MODBUS-RX MODBUS-TX OTR-EN
OTR-FB

VFD24
SPI-SS MOT-PTC:1 BOT-UZONE:1

BRK-FB2 MOT-PTCP MOT-W:1

LIGHT2-OUT LIGHT1-OUT VLIGHT-OUT VLIGHT-IN

ISNS-V MOT-U MOT-U:1 MOT-V MOT-V:1 MOT-W

SPI-MOSI UART-TX REF1V65

EL-PWMM
EL-PWMP BOT-UZONE

SPI-MOSI SPI-SCK UART-RX UART-TX

LPWM5-OUT
ELP NEOPIX-OUT ELM

SCL SDA SPI-MISO

AUDIO-OUT AUDIO-EN

File: UDEC.CX.kicad_sch LiftingItalia Srl

Via Caduti del Lavoro, 16

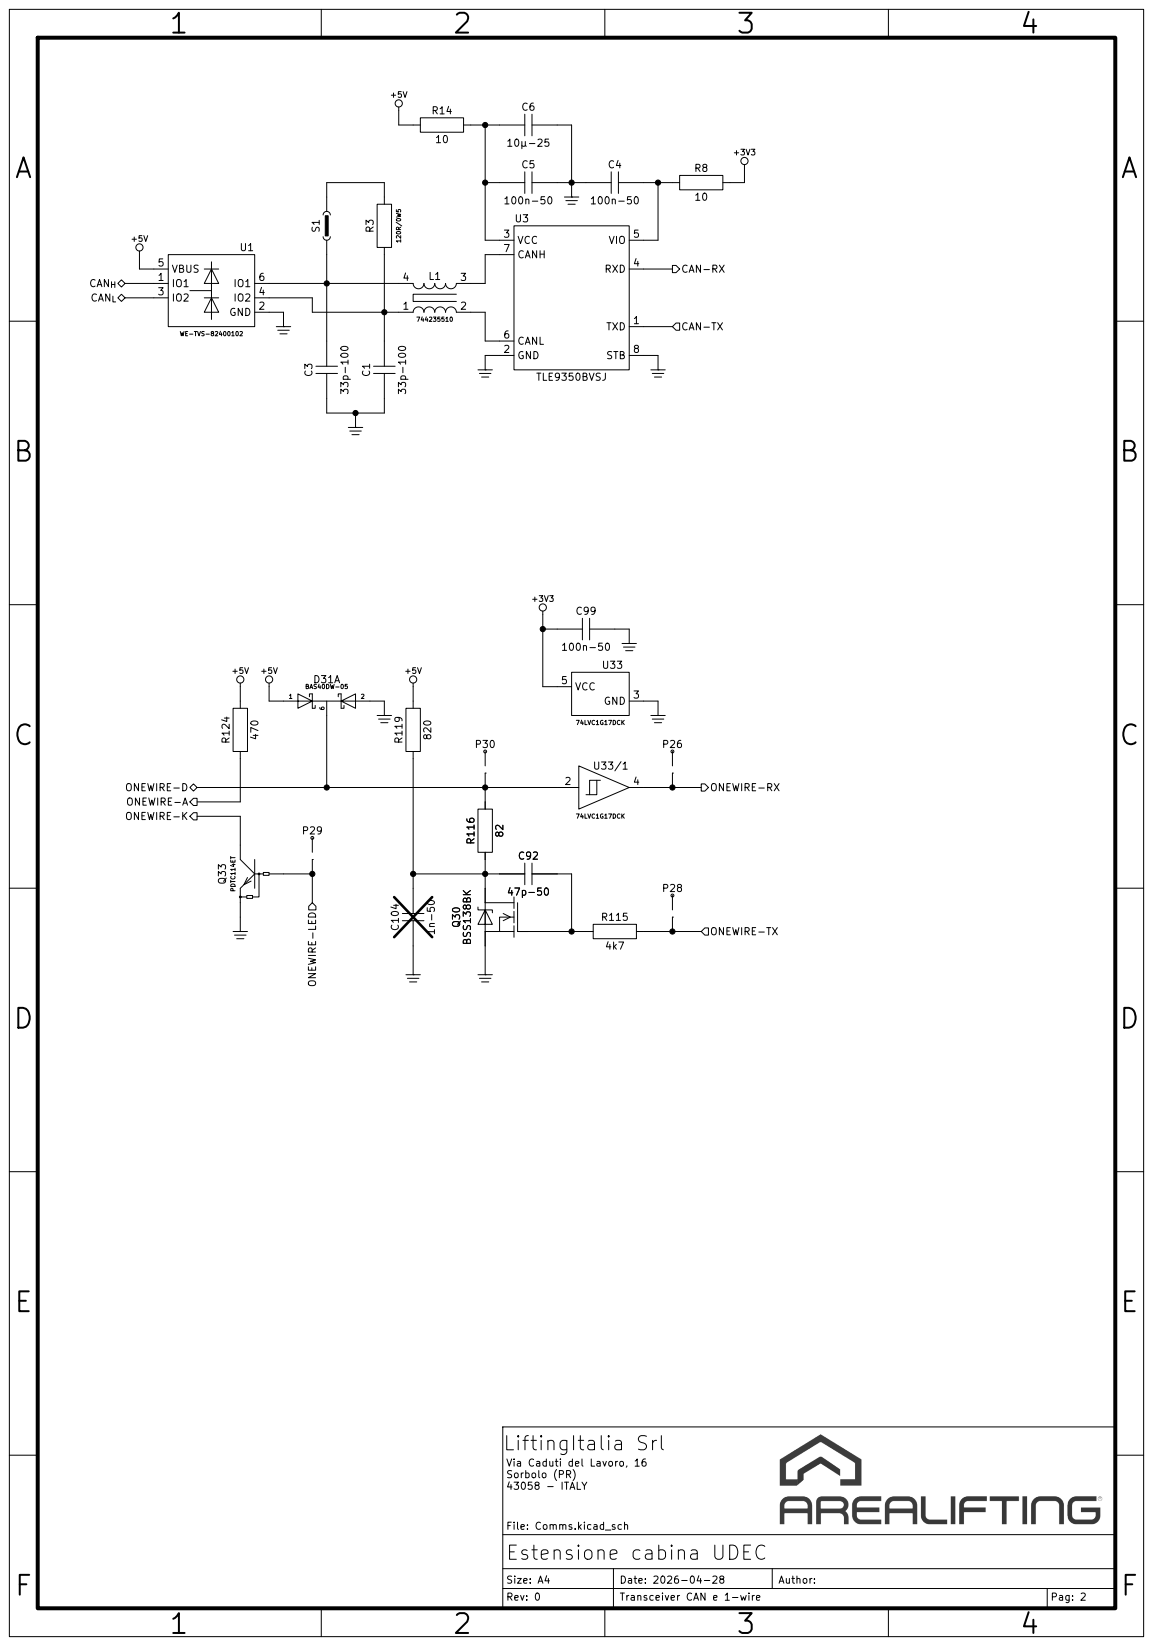
[picture p35: page 2]

File: Comms.kicad_sch LiftingItalia Srl

Via Caduti del Lavoro, 16
Sorbolo (PR) 43058 - ITALY Rev: 0 Estensione cabina UDEC

Author:

Transceiver CAN e 1-wire | Pag: 2

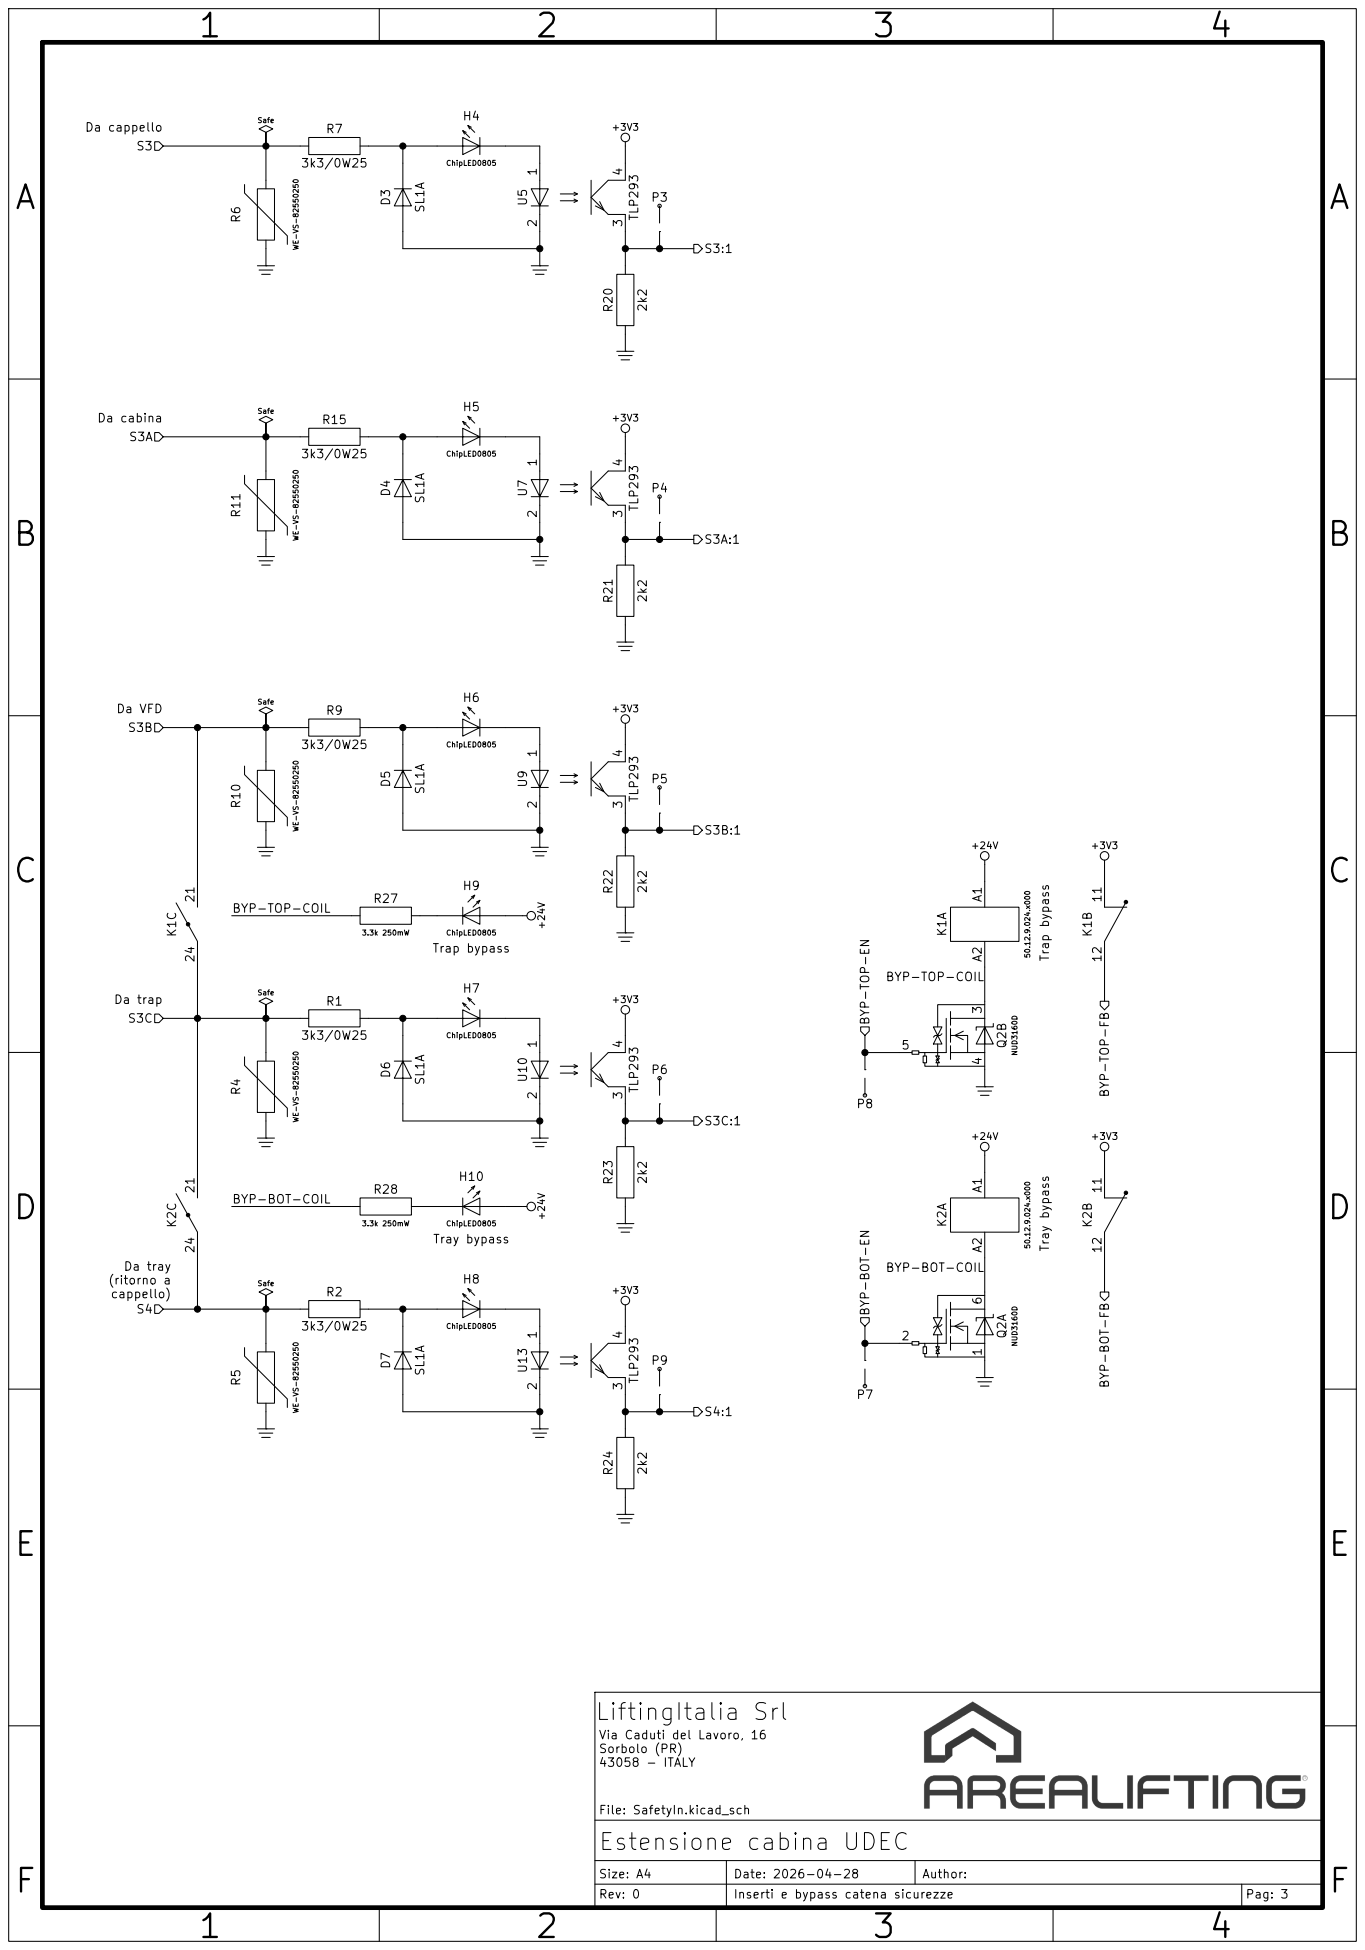
[picture p36: page 3]

Via Caduti del Lavoro, 16
Sorbolo (PR) 43058 - ITALY Rev: 0 Estensione cabina UDEC

Author:

Inserti e bypass catena sicurezze | Pag: 3

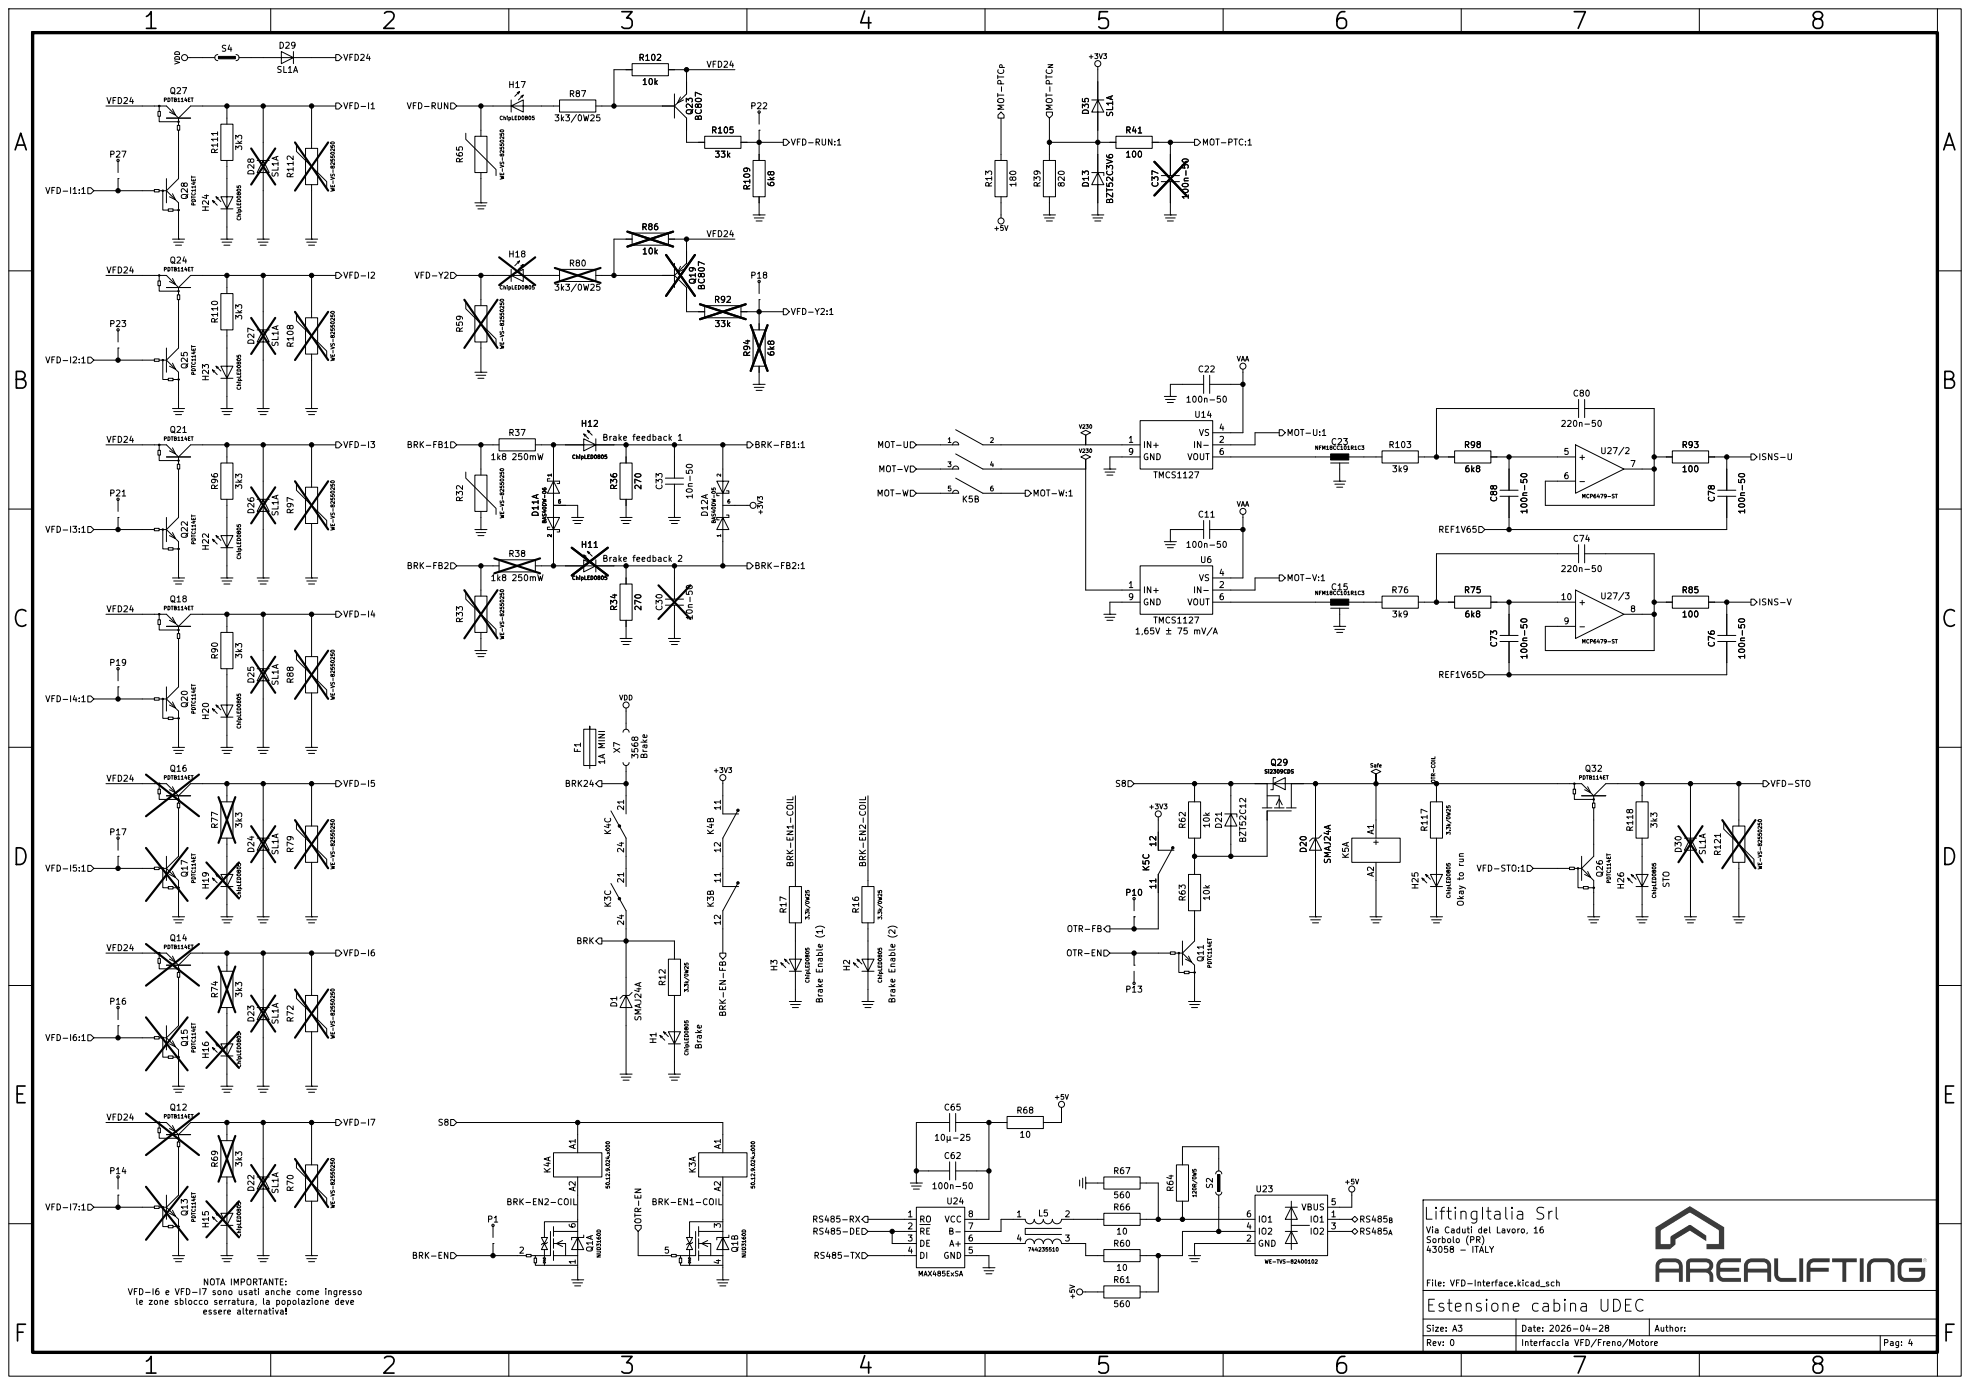
[picture p37: page 4]

REF1V65 MOT-U:1 BRK-EN-FB

VFD-STO:1 BRK-EN

File: VFD-Interface.kicad_sch LiftingItalia Srl

Via Caduti del Lavoro, 16
Sorbolo (PR) 43058 - ITALY Rev: 0 Estensione cabina UDEC

NOTA IMPORTANTE: VFD-I6 e VFD-I7 sono usati anche come ingresso

le zone sblocco serratura, la popolazione deve

Author:

Interfaccia VFD/Freno/Motore | Pag: 4

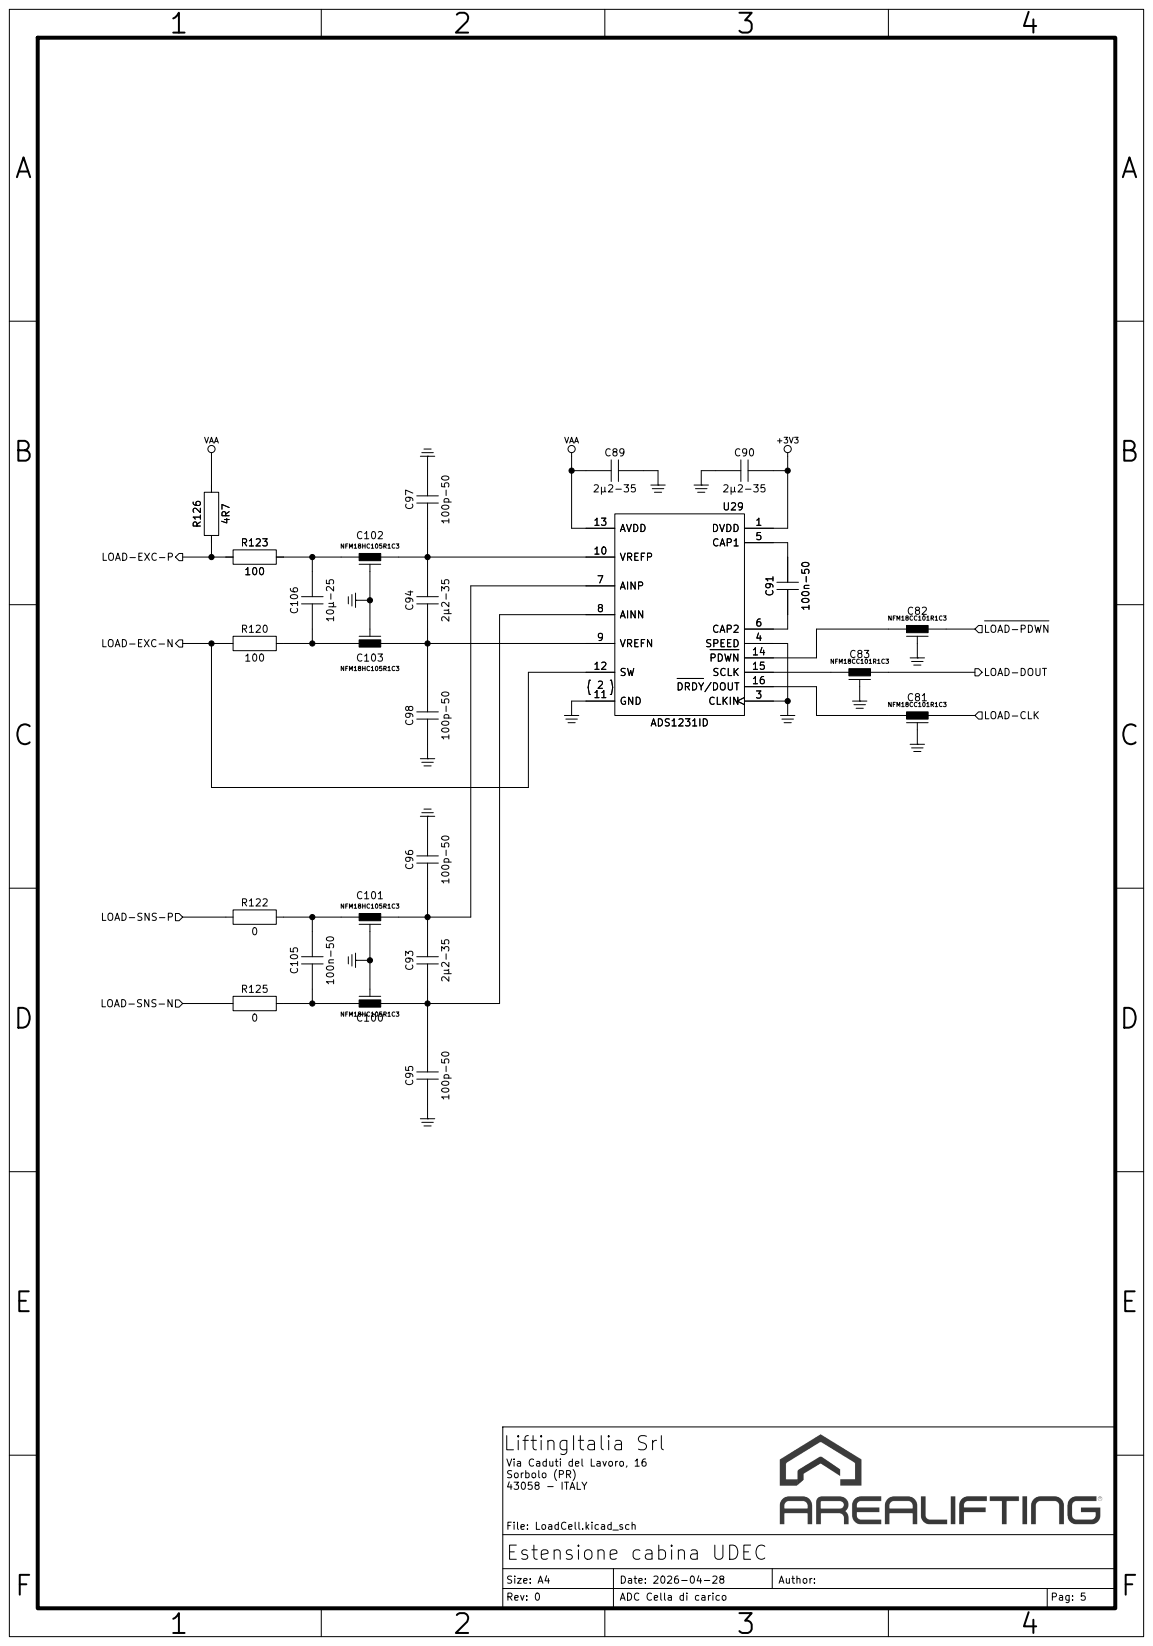
[picture p38: page 5]

LOAD-DOUT LOAD-EXC-P

File: LoadCell.kicad_sch LiftingItalia Srl

Via Caduti del Lavoro, 16
Sorbolo (PR) 43058 - ITALY Rev: 0 Estensione cabina UDEC

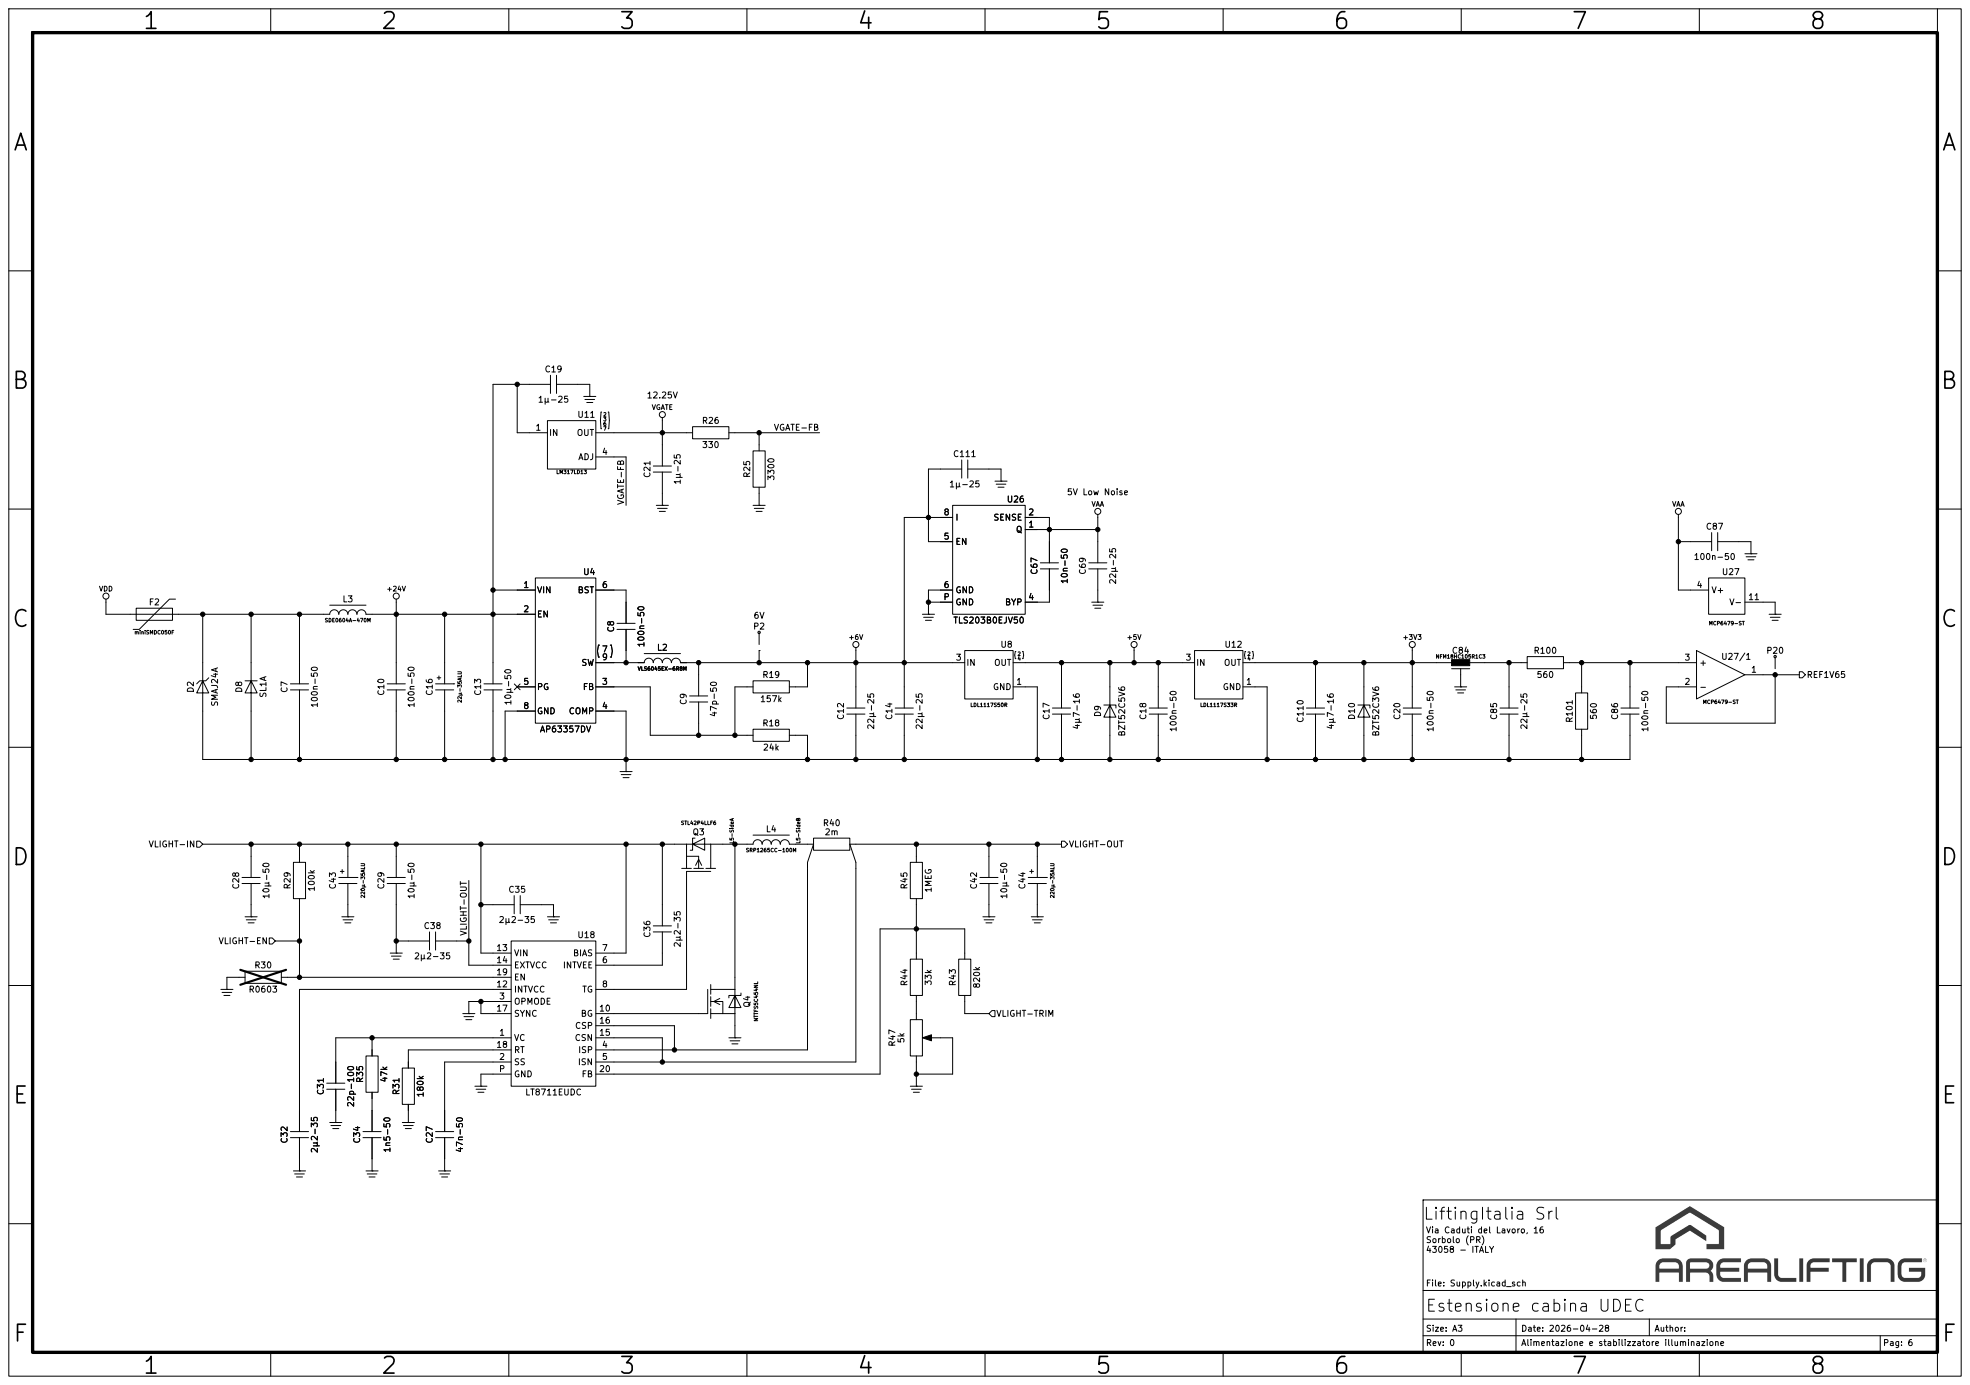
[picture p39: page 6]

Via Caduti del Lavoro, 16
Sorbolo (PR) 43058 - ITALY Rev: 0 Estensione cabina UDEC

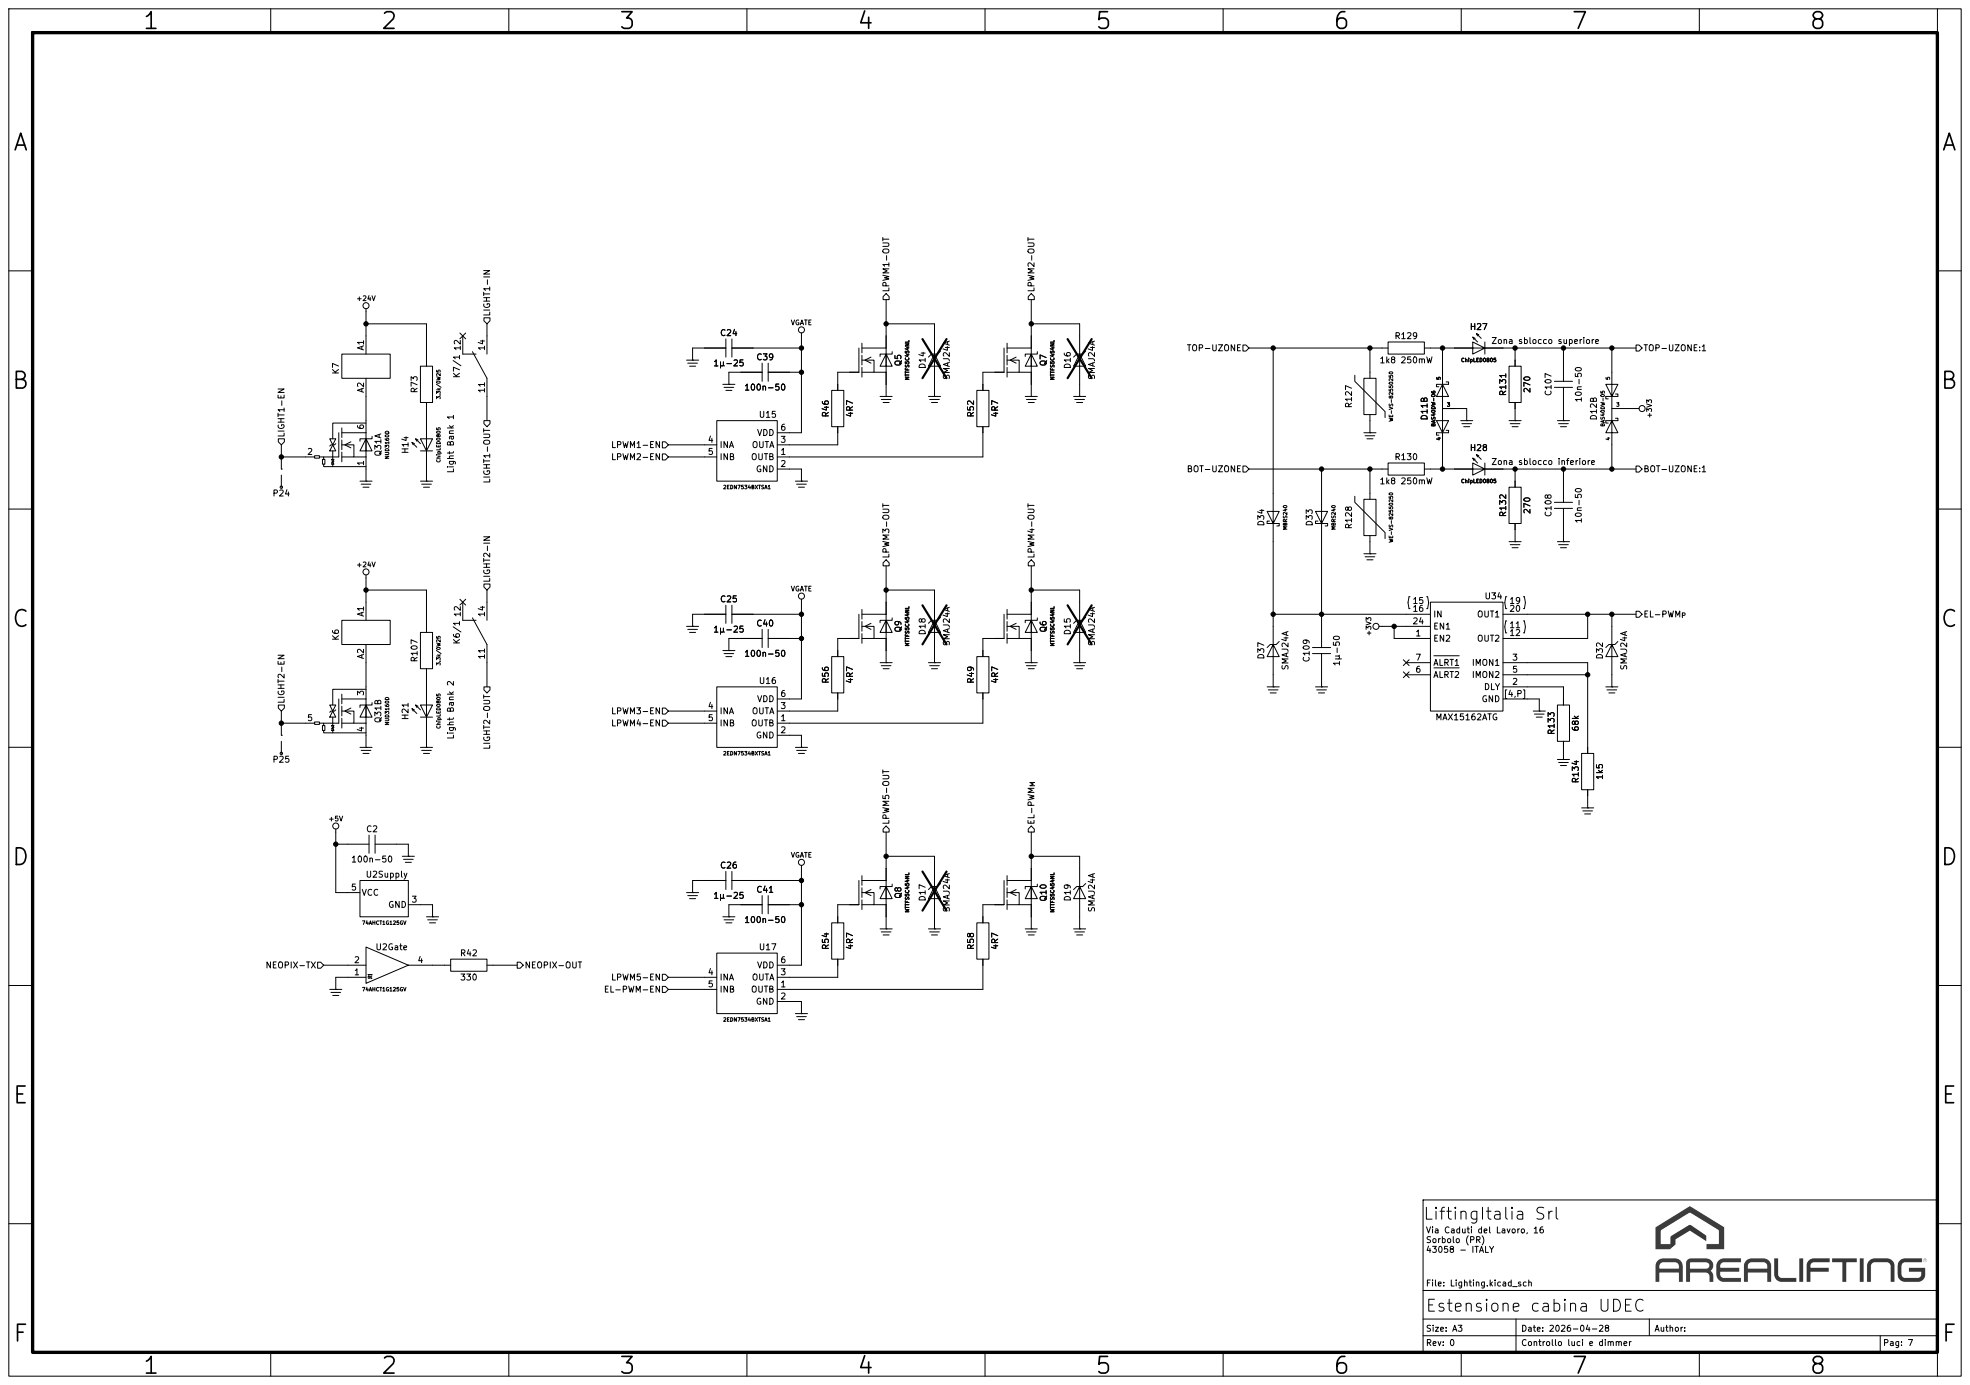
[picture p40: page 7]

TOP-UZONE:1 BOT-UZONE:1

TOP-UZONE Light Bank 1 Light Bank 2

Via Caduti del Lavoro, 16

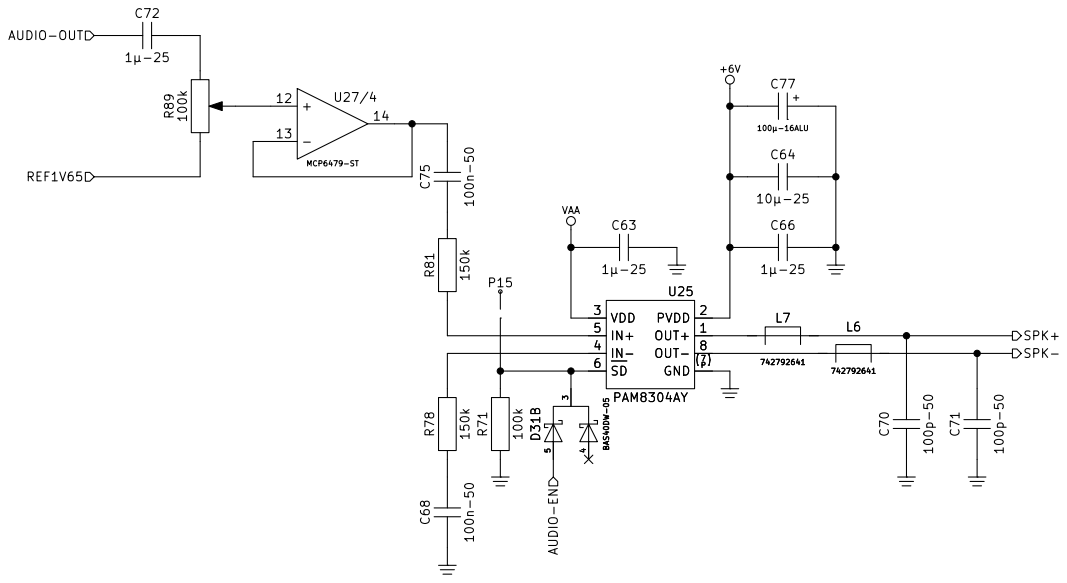
[picture p41: page 8]

File: Audio.kicad_sch LiftingItalia Srl

Via Caduti del Lavoro, 16
Sorbolo (PR) 43058 - ITALY Rev: 0 Estensione cabina UDEC

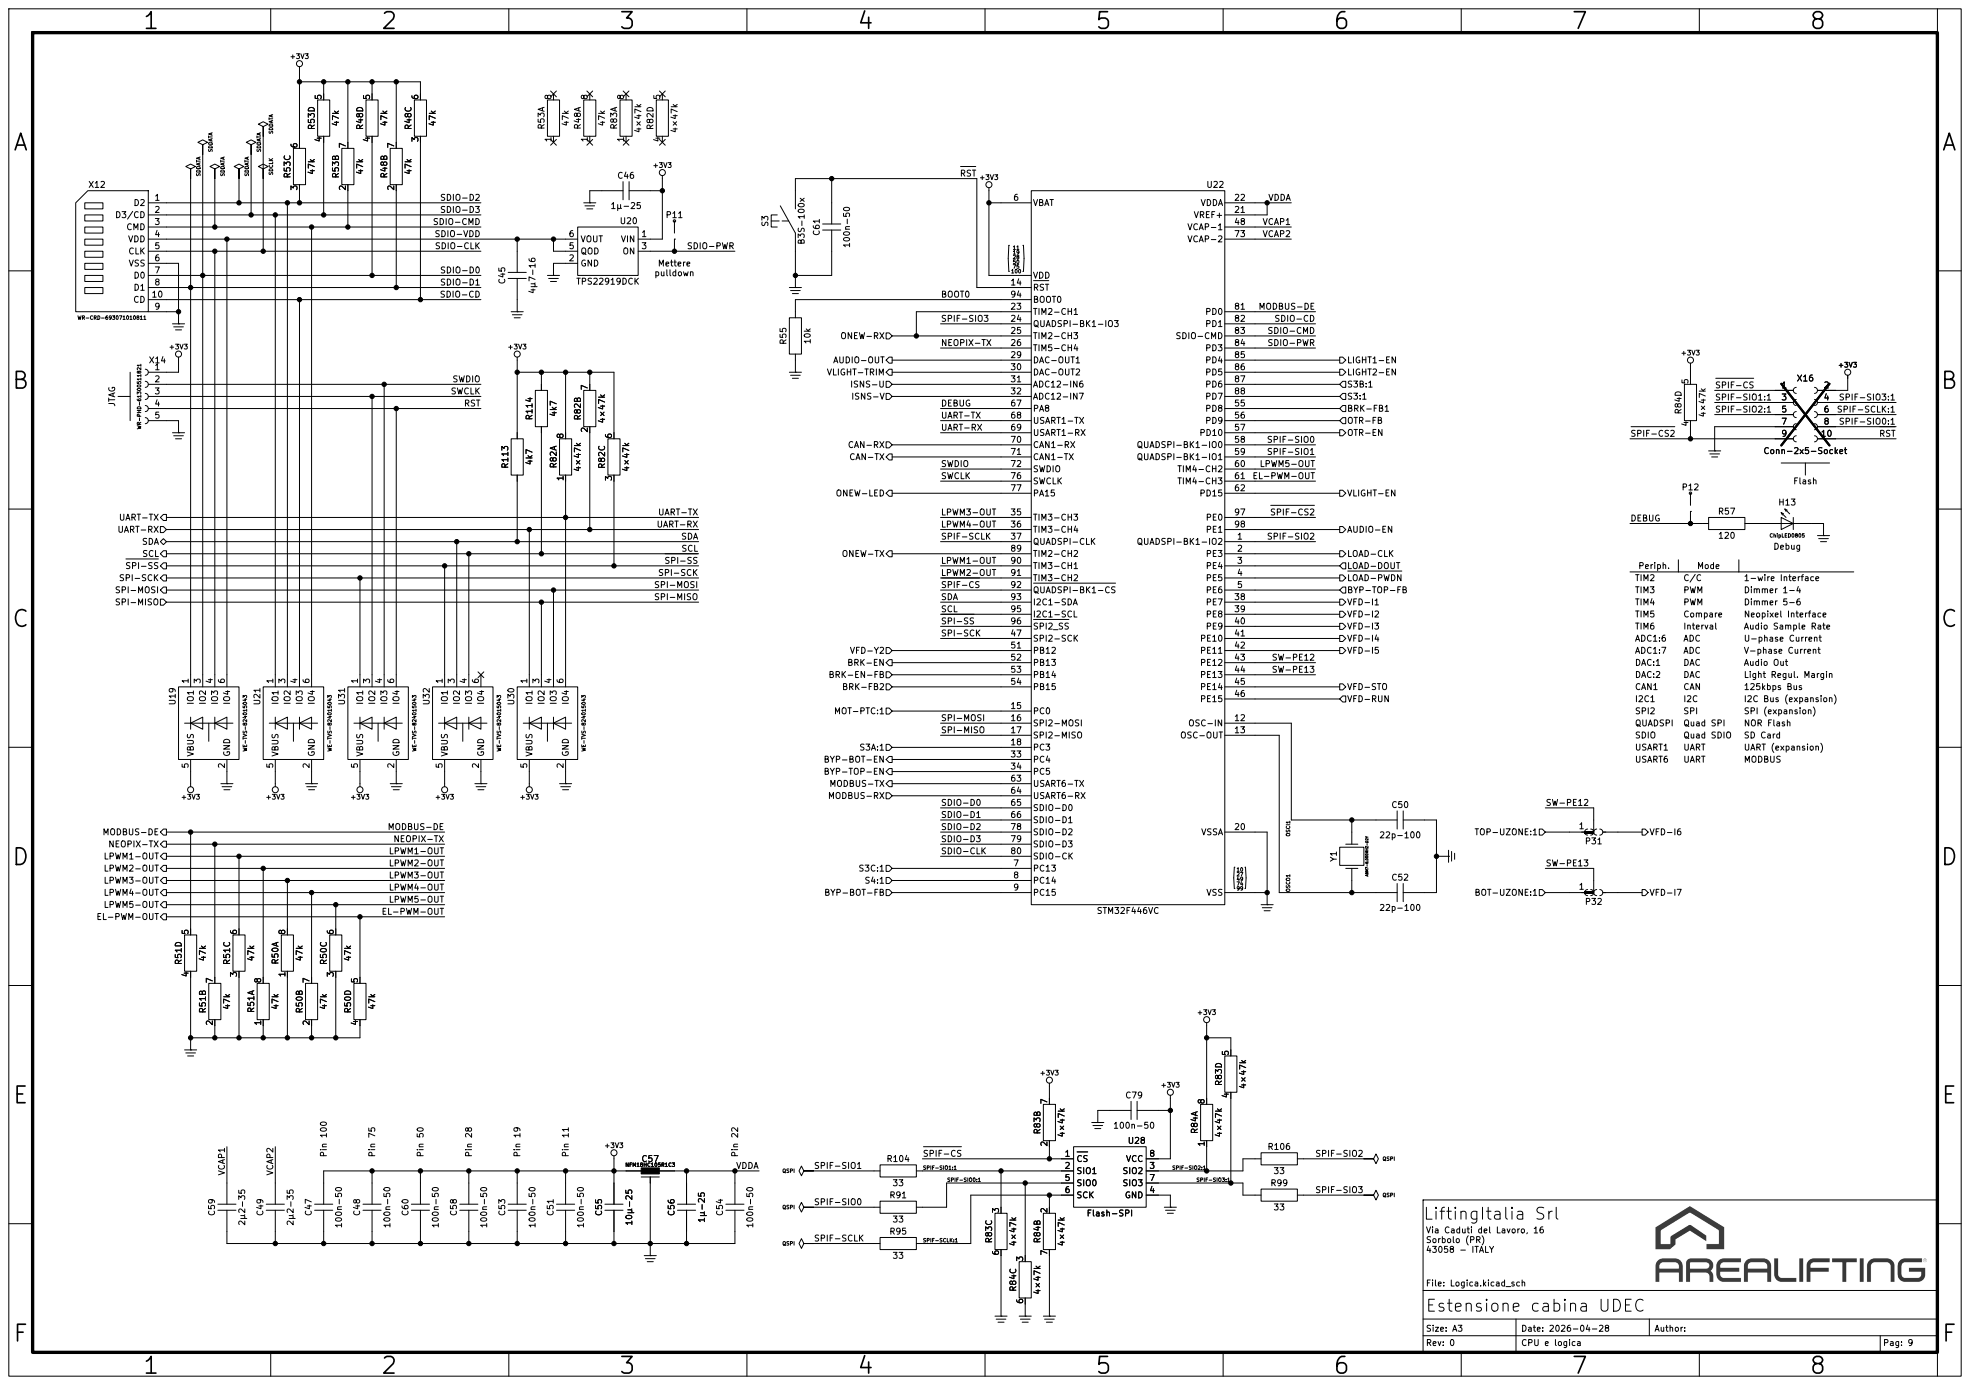
[picture p42: page 9]

1 8 R82A 4×47k 4 5 R48D 47k C61 100n-50 +3V3 1 8 R53A 47k +3V3 VIN 1 GND 2 ON 3 QOD 5

VCAP1
VCAP2
LPWM5-OUT EL-PWM-OUT SDIO-CD

SDIO-PWR NEOPIX-TX

AUDIO-OUT VLIGHT-TRIM

CAN-RX ONEW-LED
S3A:1 BYP-BOT-EN MODBUS-RX MODBUS-TX BYP-TOP-EN MOT-PTC:1 ONEW-TX BRK-FB2 BRK-EN-FB

SWDIO
LPWM4-OUT LPWM1-OUT LPWM2-OUT SWCLK

LPWM3-OUT LPWM1-OUT UART-RX
SPI-MOSI SDA

LOAD-CLK
LOAD-DOUT LOAD-PWDN

SPI-MOSI SPI-SS
SPI-SCK

SPI-MOSI SPI-MISO

LPWM5-OUT MODBUS-DE
LPWM4-OUT EL-PWM-OUT LPWM2-OUT NEOPIX-TX

LPWM4-OUT LPWM1-OUT LPWM2-OUT LPWM3-OUT

LPWM5-OUT EL-PWM-OUT

Via Caduti del Lavoro, 16
Sorbolo (PR) 43058 - ITALY Rev: 0 Estensione cabina UDEC
