dermatoid-collab/EVC_FW/TTF-Base/fabs/TTF-Base-B_Fab.pdf

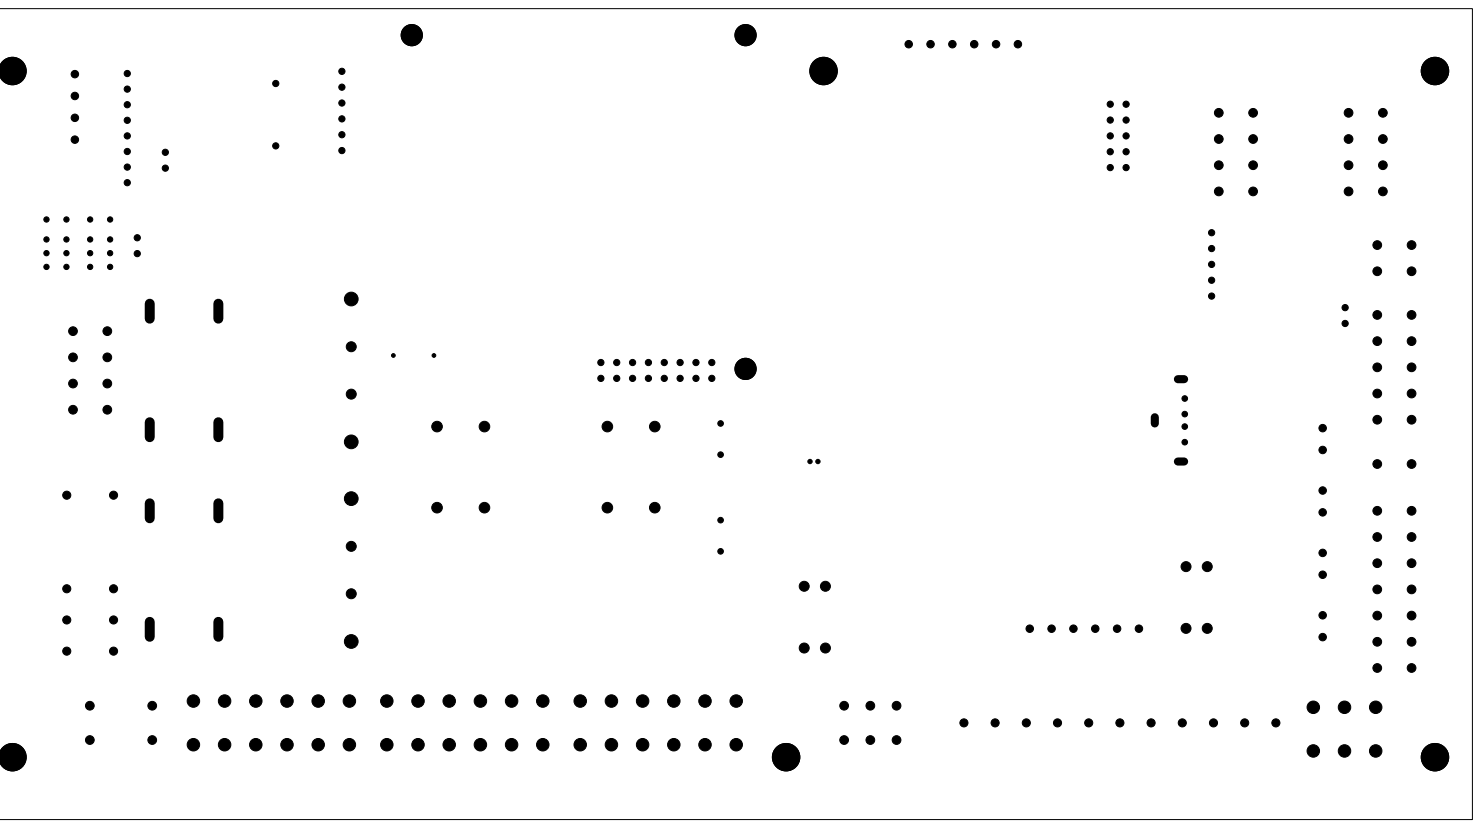
[picture p43: page 1]
