dermatoid-collab/EVC_FW/TTF-Base/fabs/TTF-Base-F_Fab.pdf

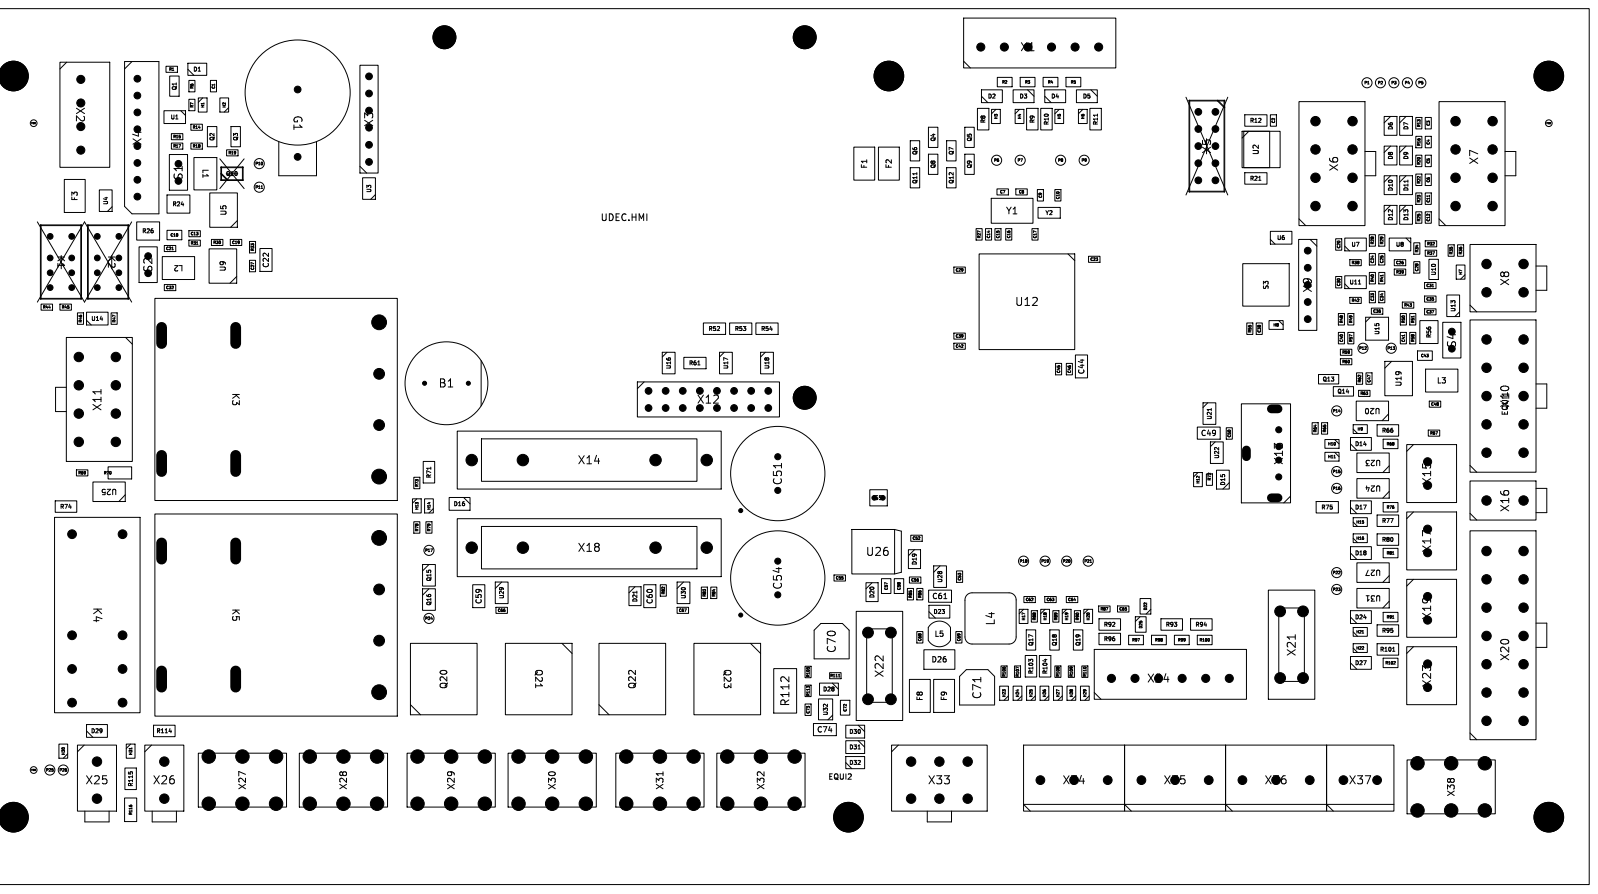
[picture p44: page 1]
