dermatoid-collab/EVC_FW/UDEC.CX/LTSpice/AudioEMI.asc

C1: cap; 220p
C2: cap; 220p
C3: cap; 100n
C4: cap; 1µ
E1: e; 1
L1: FerriteBead2; 782n; Ipk=2 Rser=0.15 Rpar=503 Cpar=462f mfg="Würth Elektronik" pn="742792641 WE-CBF 0603"
L2: FerriteBead2; 782n; Ipk=2 Rser=0.15 Rpar=503 Cpar=462f mfg="Würth Elektronik" pn="742792641 WE-CBF 0603"
R1: res; 150k
R2: res; 300k
R3: res; 80k
R4: res; 20k
R5: res; 1Meg
R6: res; 1Meg
U1: MidRange
U2: opamp
U3: opamp
V1: voltage; SINE(0 1 1k); AC 1
V2: voltage; 1.65
Named nets: 0, CM, OUT+, OUT-, IN, AMPOUT
.lib Loudspeaker.lib
.tran 1m
.ac dec 100 1 1000meg
.lib opamp.sub
