dermatoid-collab/EVC_FW/UDEC.CX/LTSpice/GateDrive.asc

R1: res; 0.01
R2: res; 3
U1: NTTFS5C454NL
V1: voltage; PULSE(0 15 0 6n 10n 60u 125u)
V2: voltage; 24
Named nets: 0
.tran 0 500u 0 10n
