dermatoid-collab/EVC_FW/UDEC.CX/LTSpice/LT8711_DC2234A.asc

C1: cap; 2.2µ
C2: cap; 2.2µ
C3: cap; 1.5n
C4: cap; .01µ
C5: polcap; 100µ; V=35 Irms=150m Rser=0.135 Lser=1.5n mfg="Würth Elektronik" pn="865230557006 WCAP-AS5H 10x10,5" type="Al electrolytic"
C6: cap; 10µ; x3
C7: cap; 10µ; V=35 Irms=0 Rser=0 Lser=0 mfg="Murata" pn="GRM21BR6YA106ME43" type="X5R"
C8: cap; 2.2µ
C12: cap; 22p
C13: cap; 4.7µ
I1: load2; PULSE(0 2 4m 10n 10n 4m 8m)
L1: ind; 15µ
Q2: pmos; Si4401DY
Q3: nmos; BSC093N04LS
R1: res; 180k
R2: res; 47k
R3: res; 1Meg
R4: res; 36.8k
R5: res; 100K
R10: res; 2m
Rload: res; 2.4
U1: LT8711
V1: voltage; 24; Rser=.15
Named nets: 0, IN, OUT, VHB
.tran 0 5m 2m startup
