dermatoid-collab/EVC_FW/UDEC.CX/LTSpice/OneWire.asc

C1: cap; 47p
C2: cap; 1n
C3: cap; 100p
D1: schottky; BAT54
D2: schottky; BAT54
R1: res; 4.7k
R3: res; 820
R4: res; 100
R5: res; 800k
U1: BSS138BK
V1: voltage; 5
V2: voltage; PULSE(0.4 2.9 10u 100n 100n 15u 60u)
Named nets: 5V0, 0, VOUT
.tran 40u
