dermatoid-collab/EVC_FW/UDEC.CX/LTSpice/PTCIN.asc

D1: schottky; BAT54
D2: schottky; BAT54
R1: res; 180
R2: res; 820
R3: res; {PTC}
R5: res; 10
U1: BZT52C3V6; ""
V1: voltage; 3.3; Rser=.1
V2: voltage; 5
Named nets: 0, OUT, RES
.op
.step dec param PTC 1 1k 20
.meas op V(out)
