dermatoid-collab/EVC_FW/UDEC.CX/UDEC.CX.kicad_pcb

## KiCad design UDEC.CX/UDEC.CX.kicad_pcb (2026-11-06)

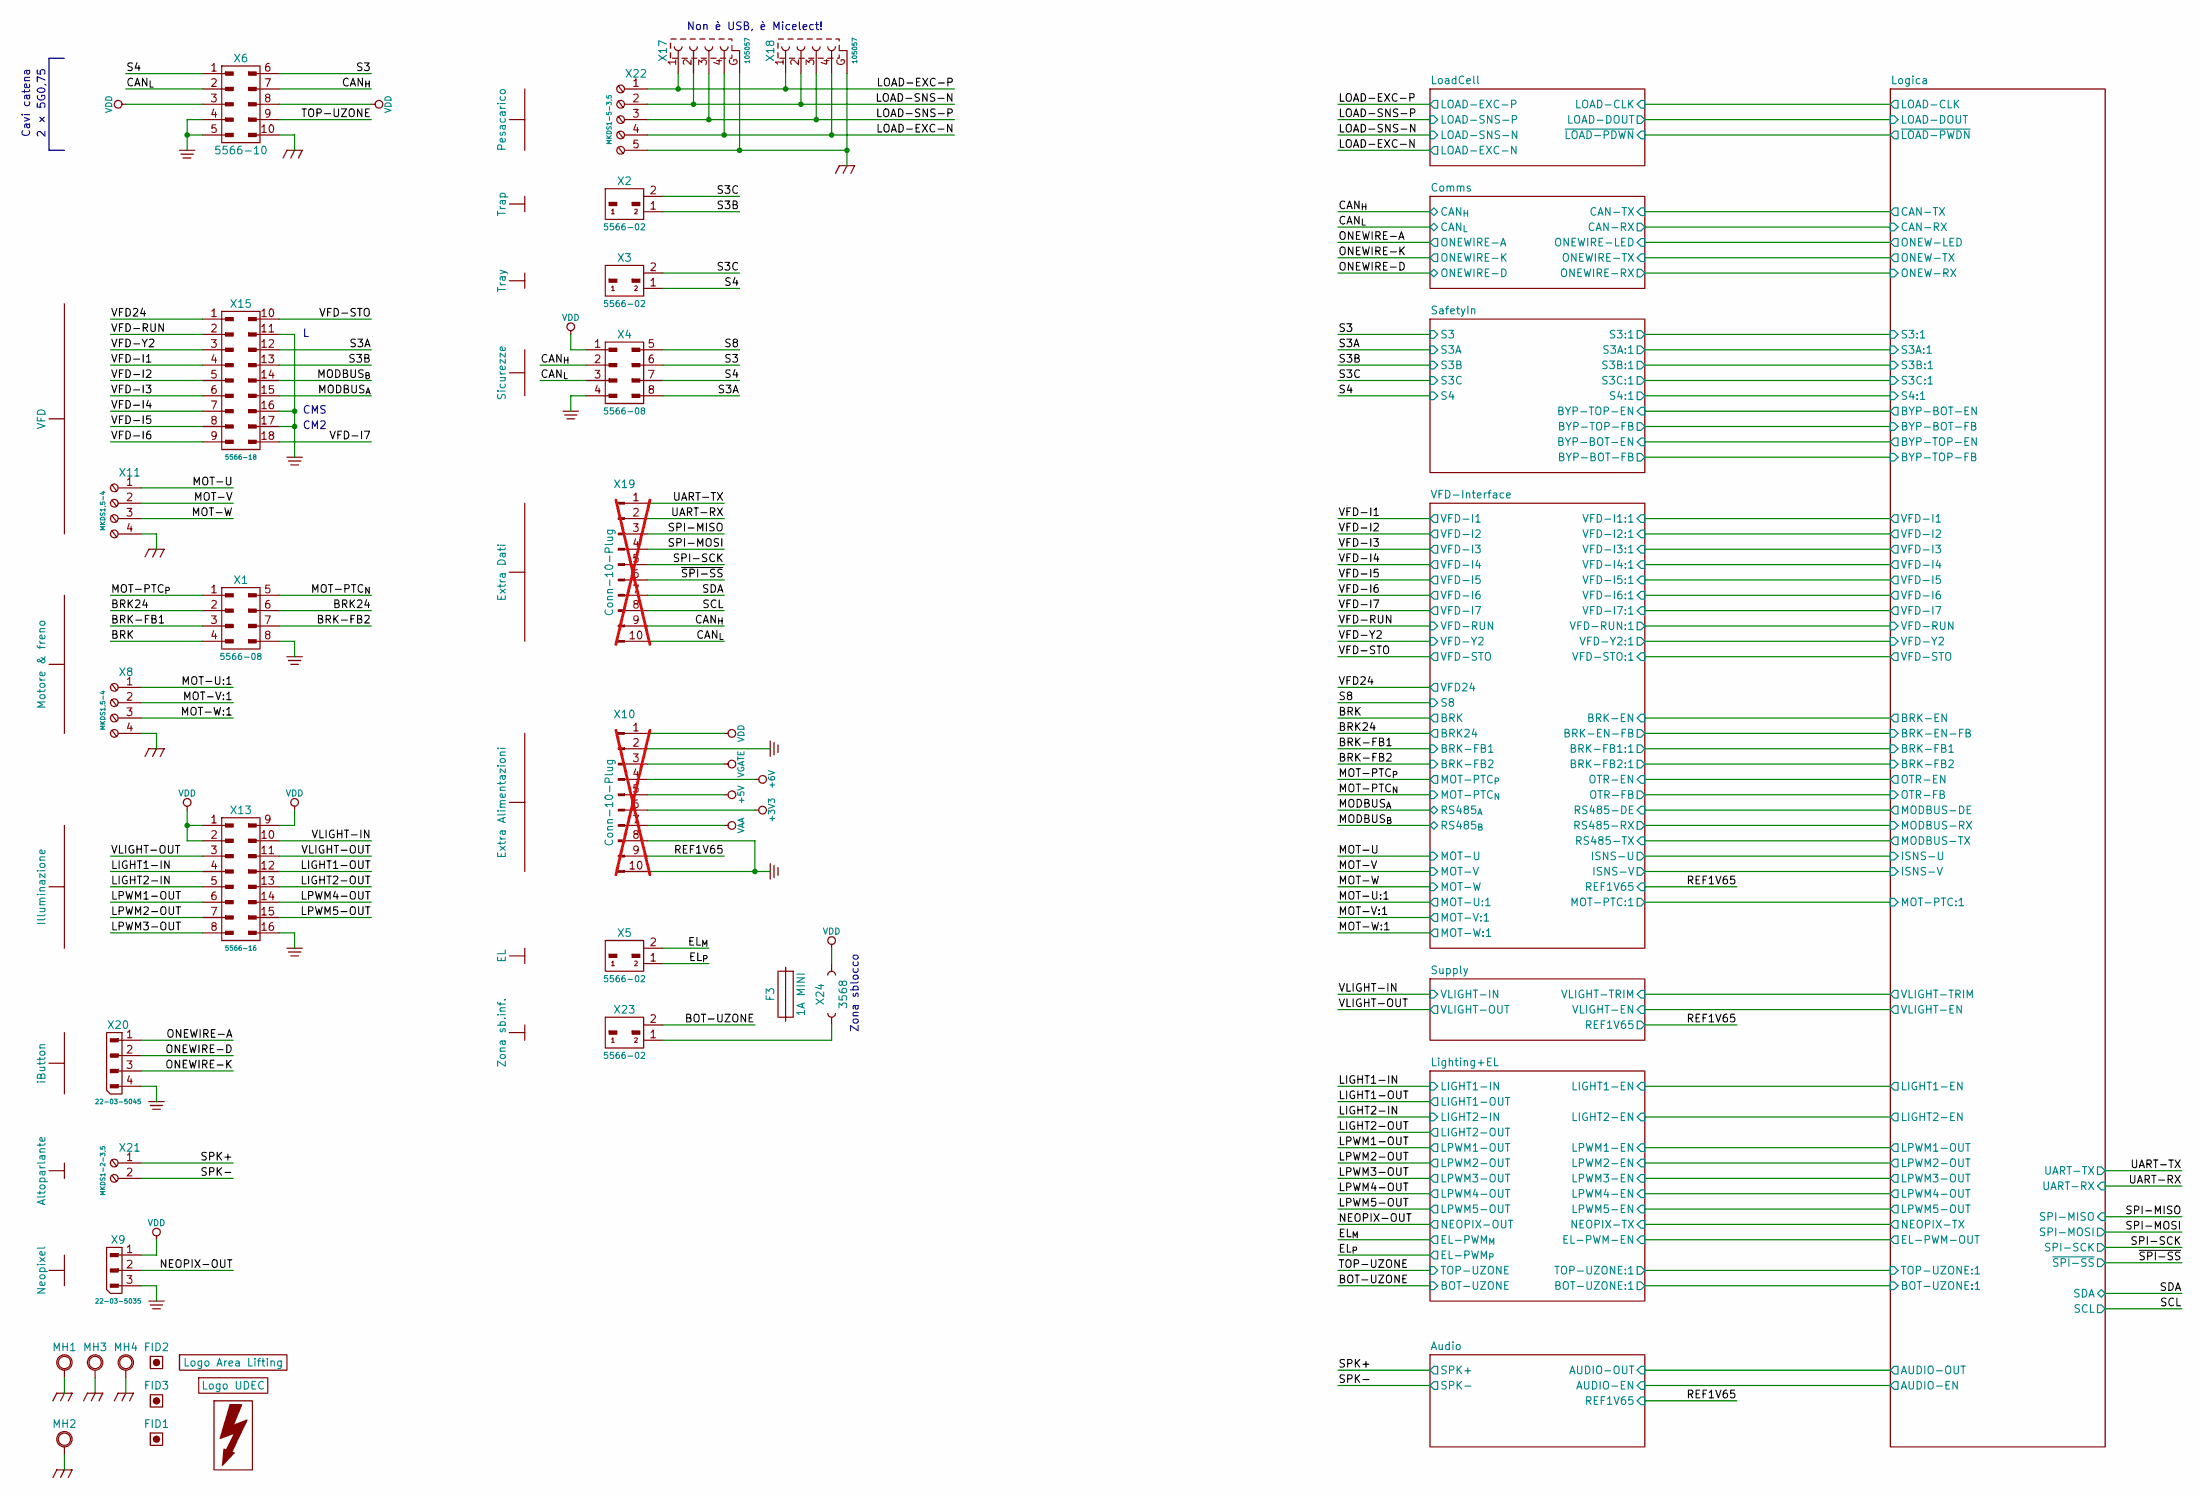
[picture p45: schematic UDEC.CX.kicad_sch, Estensione cabina UDEC]

Parts:
F3: 1A MINI; MINI-Fuse
FID1, FID2, FID3: Fiducial; Fid-10
MH1, MH2, MH3, MH4: Hole; Hole-M4
X1, X4: 5566-08
X2, X3, X5, X23: 5566-02
X6: 5566-10
X8, X11: MKDS1,5-4
X9: 22-03-5035
X10, X19: Conn-10-Plug; M-10; not fitted
X13: 5566-16
X15: 5566-18
X17, X18: 105057; Molex-105057
X20: 22-03-5045
X21: MKDS1-2-3,5
X22: MKDS1-5-3,5
X24: 3568; Keystone-3568
ZZZ2: VFD
ZZZ3: Motore & freno
ZZZ4: Illuminazione
ZZZ5: iButton
ZZZ6: Altoparlante
ZZZ7: Neopixel
ZZZ8: Pesacarico
ZZZ9: Trap
ZZZ10: Tray
ZZZ11: Sicurezze
ZZZ12: Extra Dati
ZZZ13: Extra Alimentazioni
ZZZ16: Logo-AreaLifting
ZZZ17: Logo-UDEC; Logo-UDEC-Silk
ZZZ18: Flash-Large
ZZZ19: EL
ZZZ20: Zona sb.inf.

Connections:
+3V3: X10.6; also elsewhere on the board
+5V: X10.5; also elsewhere on the board
+6V: X10.4; also elsewhere on the board
/BOT-UZONE: X23.2; also elsewhere on the board
/BRK: X1.4; also elsewhere on the board
/BRK24: X1.2, X1.6; also elsewhere on the board
/BRK-FB1: X1.3; also elsewhere on the board
/BRK-FB2: X1.7; also elsewhere on the board
/CAN_{H}: X4.2, X6.7, X19.9 (7); also elsewhere on the board
/CAN_{L}: X4.3, X6.2, X19.10 (8); also elsewhere on the board
/EL_{M}: X5.2; also elsewhere on the board
/EL_{P}: X5.1; also elsewhere on the board
/LIGHT1-IN: X13.4; also elsewhere on the board
/LIGHT1-OUT: X13.12; also elsewhere on the board
/LIGHT2-IN: X13.5; also elsewhere on the board
/LIGHT2-OUT: X13.13; also elsewhere on the board
/LOAD-EXC-N: X17.4 (GND), X18.4 (GND), X22.4; also elsewhere on the board
/LOAD-EXC-P: X17.1 (VBUS), X18.1 (VBUS), X22.1; also elsewhere on the board
/LOAD-SNS-N: X17.2 (D-), X18.2 (D-), X22.2; also elsewhere on the board
/LOAD-SNS-P: X17.3 (D+), X18.3 (D+), X22.3; also elsewhere on the board
/LPWM1-OUT: X13.6; also elsewhere on the board
/LPWM2-OUT: X13.7; also elsewhere on the board
/LPWM3-OUT: X13.8; also elsewhere on the board
/LPWM4-OUT: X13.14; also elsewhere on the board
/LPWM5-OUT: X13.15; also elsewhere on the board
/MODBUS_{A}: X15.15; also elsewhere on the board
/MODBUS_{B}: X15.14; also elsewhere on the board
/MOT-PTC_{N}: X1.5; also elsewhere on the board
/MOT-PTC_{P}: X1.1; also elsewhere on the board
/MOT-U: X11.1; also elsewhere on the board
/MOT-U:1: X8.1; also elsewhere on the board
/MOT-V: X11.2; also elsewhere on the board
/MOT-V:1: X8.2; also elsewhere on the board
/MOT-W: X11.3; also elsewhere on the board
/MOT-W:1: X8.3; also elsewhere on the board
/NEOPIX-OUT: X9.2; also elsewhere on the board
/ONEWIRE-A: X20.1; also elsewhere on the board
/ONEWIRE-D: X20.2; also elsewhere on the board
/ONEWIRE-K: X20.3; also elsewhere on the board
/REF1V65: X10.9 (7); also elsewhere on the board
/S3: X4.6, X6.6; also elsewhere on the board
/S3A: X4.8, X15.12; also elsewhere on the board
/S3B: X2.1, X15.13; also elsewhere on the board
/S3C: X2.2, X3.2; also elsewhere on the board
/S4: X3.1, X4.7, X6.1; also elsewhere on the board
/S8: X4.5; also elsewhere on the board
/SCL: X19.8; also elsewhere on the board
/SDA: X19.7; also elsewhere on the board
/SPI-MISO: X19.3; also elsewhere on the board
/SPI-MOSI: X19.4; also elsewhere on the board
/SPI-SCK: X19.5; also elsewhere on the board
/SPK+: X21.1; also elsewhere on the board
/SPK-: X21.2; also elsewhere on the board
/TOP-UZONE: X6.9; also elsewhere on the board
/UART-RX: X19.2; also elsewhere on the board
/UART-TX: X19.1; also elsewhere on the board
/VFD24: X15.1; also elsewhere on the board
/VFD-I1: X15.4; also elsewhere on the board
/VFD-I2: X15.5; also elsewhere on the board
/VFD-I3: X15.6; also elsewhere on the board
/VFD-I4: X15.7; also elsewhere on the board
/VFD-I5: X15.8; also elsewhere on the board
/VFD-I6: X15.9; also elsewhere on the board
/VFD-I7: X15.18; also elsewhere on the board
/VFD-RUN: X15.2; also elsewhere on the board
/VFD-STO: X15.10; also elsewhere on the board
/VFD-Y2: X15.3; also elsewhere on the board
/VLIGHT-IN: X13.10; also elsewhere on the board
/VLIGHT-OUT: X13.3, X13.11; also elsewhere on the board
/~SPI-SS: X19.6; also elsewhere on the board
CHASSIS: MH1.HOLE (HOLE_HOLE), MH2.HOLE (HOLE_HOLE), MH3.HOLE (HOLE_HOLE), MH4.HOLE (HOLE_HOLE), X6.10, X8.4, X11.4, X17.G, X18.G, X22.5 (P4)
GND: X1.8, X4.4, X6.4, X6.5, X9.3, X10.2, X10.8, X10.10 (8), X13.16, X15.11, X15.16, X15.17, X20.4; also elsewhere on the board
unnamed: X23.1, X24.1
VAA: X10.7; also elsewhere on the board
VDD: X4.1, X6.3, X6.8, X9.1, X10.1, X13.1, X13.2, X13.9, X24.2; also elsewhere on the board
VGATE: X10.3; also elsewhere on the board

Notes on the sheet:
Zona sblocco
2 × 5G0,75
CM2
Cavi catena
Non è USB, è Micelect!
CMS

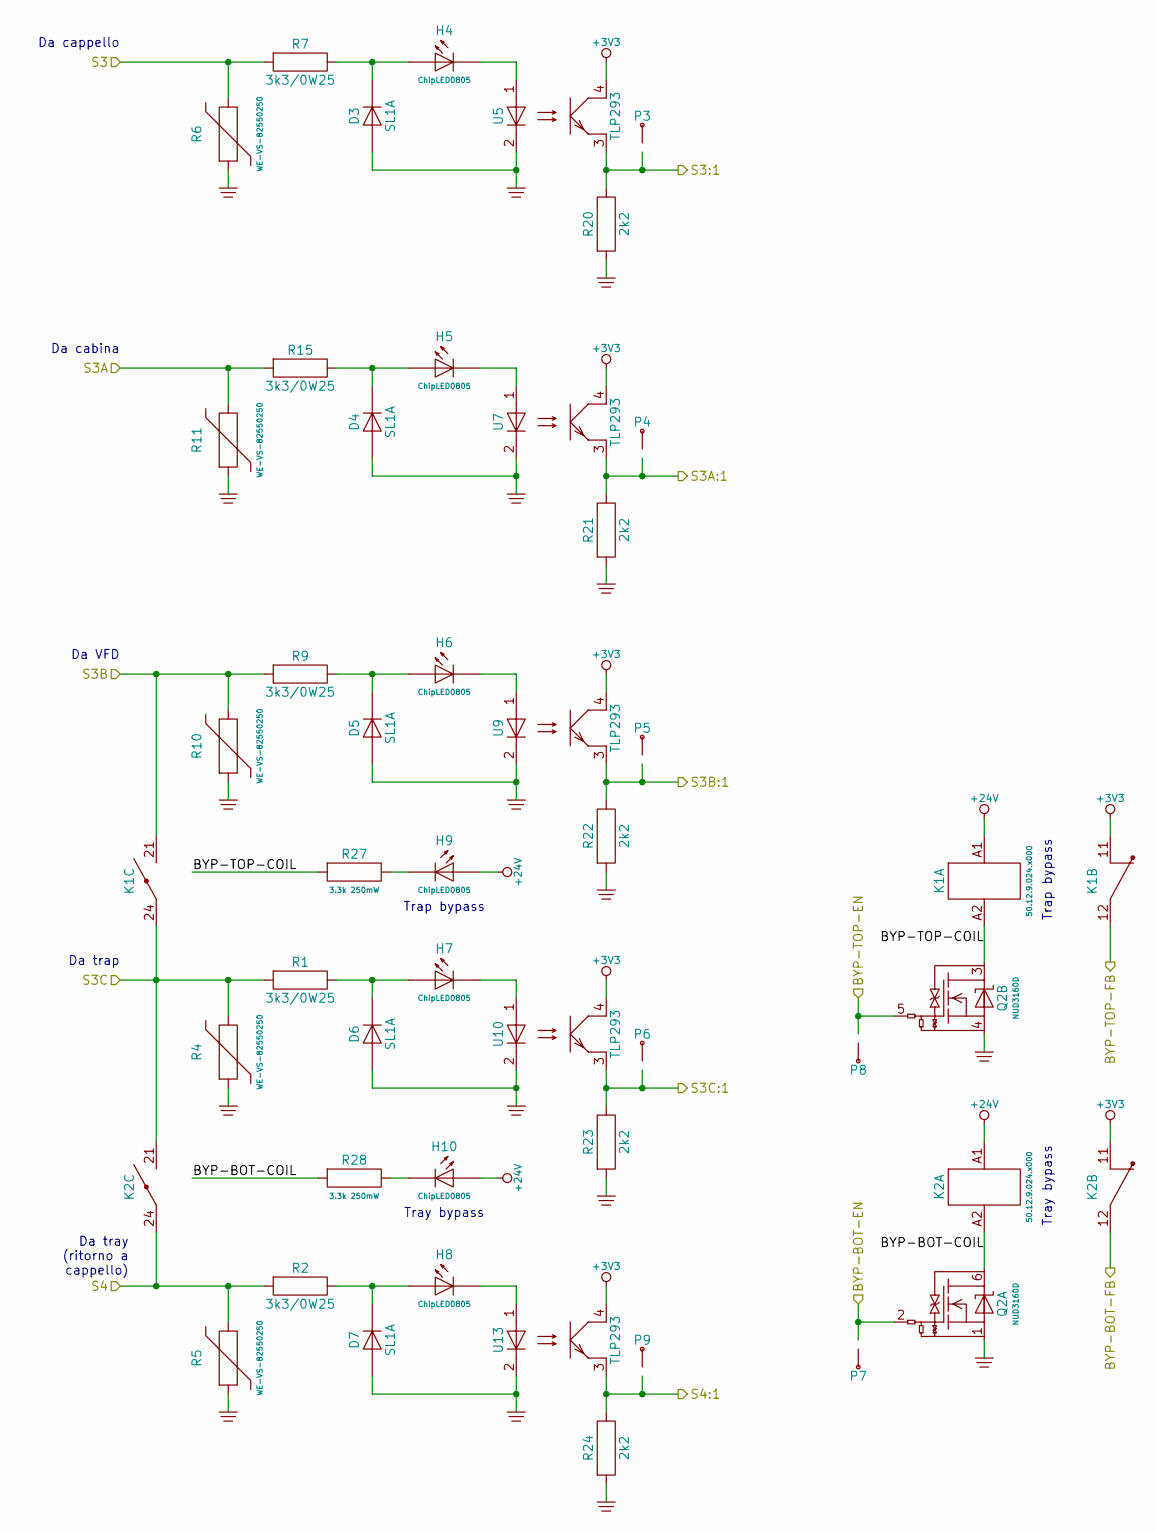
[picture p46: schematic SafetyIn.kicad_sch, Estensione cabina UDEC]

Parts:
D3, D4, D5, D6, D7: SL1A; SOD123FL
H4, H5, H6, H7, H8, H9, H10: ChipLED0805; Chipled-0805
K1, K2: 50.12.9.024.x000; 50.12
P3, P4, P5, P6, P7, P8, P9: PinTst
Q2: NUD3160D; MO193AA
R1, R2, R7, R9, R15: 3k3/0W25; R1206
R4, R5, R6, R10, R11: WE-VS-82550250; WE-VS-0805
R20, R21, R22, R23, R24: 2k2; R0603
R27, R28: 3.3k 250mW; R1206
U5, U7, U9, U10, U13: TLP293; Toshiba-11-3C1

Connections:
+3V3: K1.11, K2.11, U5.4 (C), U7.4 (C), U9.4 (C), U10.4 (C), U13.4 (C); also elsewhere on the board
+24V: H9.A, H10.A, K1.A1, K2.A1; also elsewhere on the board
/Logica/BYP-BOT-EN: P8.1, Q2.5 (G); also elsewhere on the board
/Logica/BYP-BOT-FB: K1.12; also elsewhere on the board
/Logica/BYP-TOP-EN: P7.1, Q2.2 (G); also elsewhere on the board
/Logica/BYP-TOP-FB: K2.12; also elsewhere on the board
/Logica/S3:1: P3.1, R20.1, U5.3 (E); also elsewhere on the board
/Logica/S3A:1: P4.1, R21.1, U7.3 (E); also elsewhere on the board
/Logica/S3B:1: P5.1, R22.1, U9.3 (E); also elsewhere on the board
/Logica/S3C:1: P6.1, R23.1, U10.3 (E); also elsewhere on the board
/Logica/S4:1: P9.1, R24.1, U13.3 (E); also elsewhere on the board
/S3: R6.2, R7.2; also elsewhere on the board
/S3A: R11.2, R15.2; also elsewhere on the board
/S3B: K1.21, R9.2, R10.2; also elsewhere on the board
/S3C: K1.24, K2.21, R1.2, R4.2; also elsewhere on the board
/S4: K2.24, R2.2, R5.2; also elsewhere on the board
/SafetyIn/BYP-BOT-COIL: K2.A2, Q2.6 (D), R28.2
/SafetyIn/BYP-TOP-COIL: K1.A2, Q2.3 (D), R27.2
GND: D3.A, D4.A, D5.A, D6.A, D7.A, Q2.1 (4), Q2.4, R4.1, R5.1, R6.1, R10.1, R11.1, R20.2, R21.2, R22.2, R23.2, R24.2, U5.2 (K), U7.2 (K), U9.2 (K), U10.2 (K), U13.2 (K); also elsewhere on the board
unnamed: D3.K, H4.A, R7.1
unnamed: D4.K, H5.A, R15.1
unnamed: D5.K, H6.A, R9.1
unnamed: D6.K, H7.A, R1.1
unnamed: D7.K, H8.A, R2.1
unnamed: H9.K, R27.1
unnamed: H10.K, R28.1
unnamed: H4.K, U5.1 (A)
unnamed: H5.K, U7.1 (A)
unnamed: H6.K, U9.1 (A)
unnamed: H7.K, U10.1 (A)
unnamed: H8.K, U13.1 (A)

Notes on the sheet:
Da cappello
Trap bypass
Da tray (ritorno a cappello)
Tray bypass
Da trap
Da VFD
Da cabina

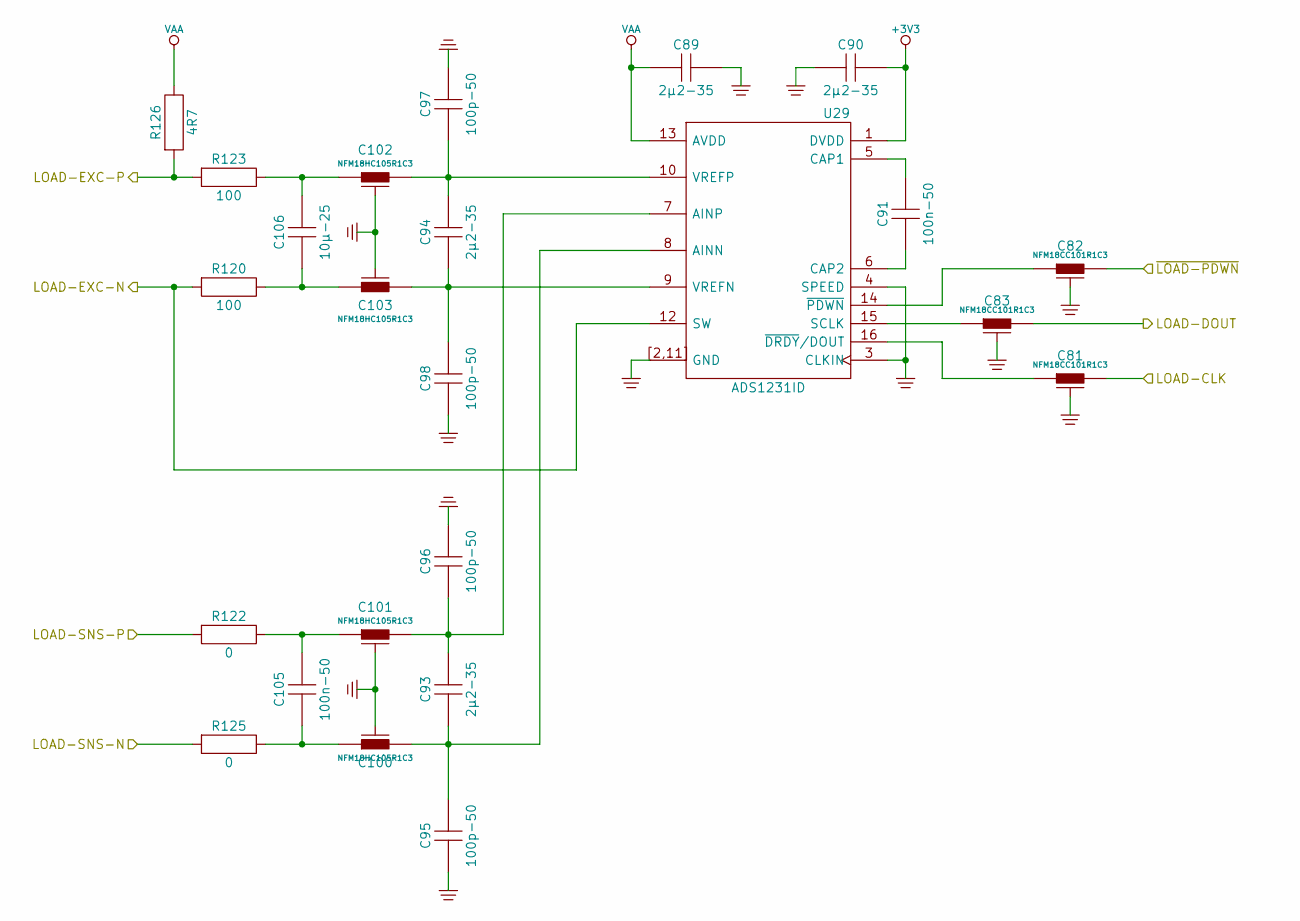
[picture p47: schematic LoadCell.kicad_sch, Estensione cabina UDEC]

Parts:
C81, C82, C83: NFM18CC101R1C3; Murata-NFM18CC
C89, C90, C93, C94: 2µ2-35; C0603
C91, C105: 100n-50; C0603
C95, C96, C97, C98: 100p-50; C0603
C100, C101, C102, C103: NFM18HC105R1C3; Murata-NFM18HC105
C106: 10µ-25; C0805
R120, R123: 100; R0603
R122, R125: 0; R0603
R126: 4R7; R0603
U29: ADS1231ID; MS012AC

Connections:
+3V3: C90.2, U29.1 (DVDD); also elsewhere on the board
/LOAD-EXC-N: R120.2, U29.12 (SW); also elsewhere on the board
/LOAD-EXC-P: R123.2, R126.2; also elsewhere on the board
/LOAD-SNS-N: R125.2; also elsewhere on the board
/LOAD-SNS-P: R122.2; also elsewhere on the board
/LoadCell/LOAD-CLK: C81.2; also elsewhere on the board
/LoadCell/LOAD-DOUT: C83.2; also elsewhere on the board
/LoadCell/~LOAD-PDWN: C82.2; also elsewhere on the board
GND: C81.3, C82.3, C83.3, C89.2, C90.1, C95.1, C96.2, C97.2, C98.1, C100.3, C101.3, C102.3, C103.3, U29.2 (GND), U29.3 (CLKIN), U29.4 (SPEED), U29.11 (GND), U29.[2,11] (GND); also elsewhere on the board
unnamed: C100.1, C105.1, R125.1
unnamed: C101.1, C105.2, R122.1
unnamed: C102.1, C106.2, R123.1
unnamed: C103.1, C106.1, R120.1
unnamed: C93.1, C95.2, C100.2, U29.8 (AINN)
unnamed: C93.2, C96.1, C101.2, U29.7 (AINP)
unnamed: C91.2, U29.5 (CAP1)
unnamed: C91.1, U29.6 (CAP2)
unnamed: C83.1, U29.15 (SCLK)
unnamed: C94.1, C98.2, C103.2, U29.9 (VREFN)
unnamed: C94.2, C97.1, C102.2, U29.10 (VREFP)
unnamed: C81.1, U29.16 (~DRDY/DOUT)
unnamed: C82.1, U29.14 (~PDWN)
VAA: C89.1, R126.1, U29.13 (AVDD); also elsewhere on the board

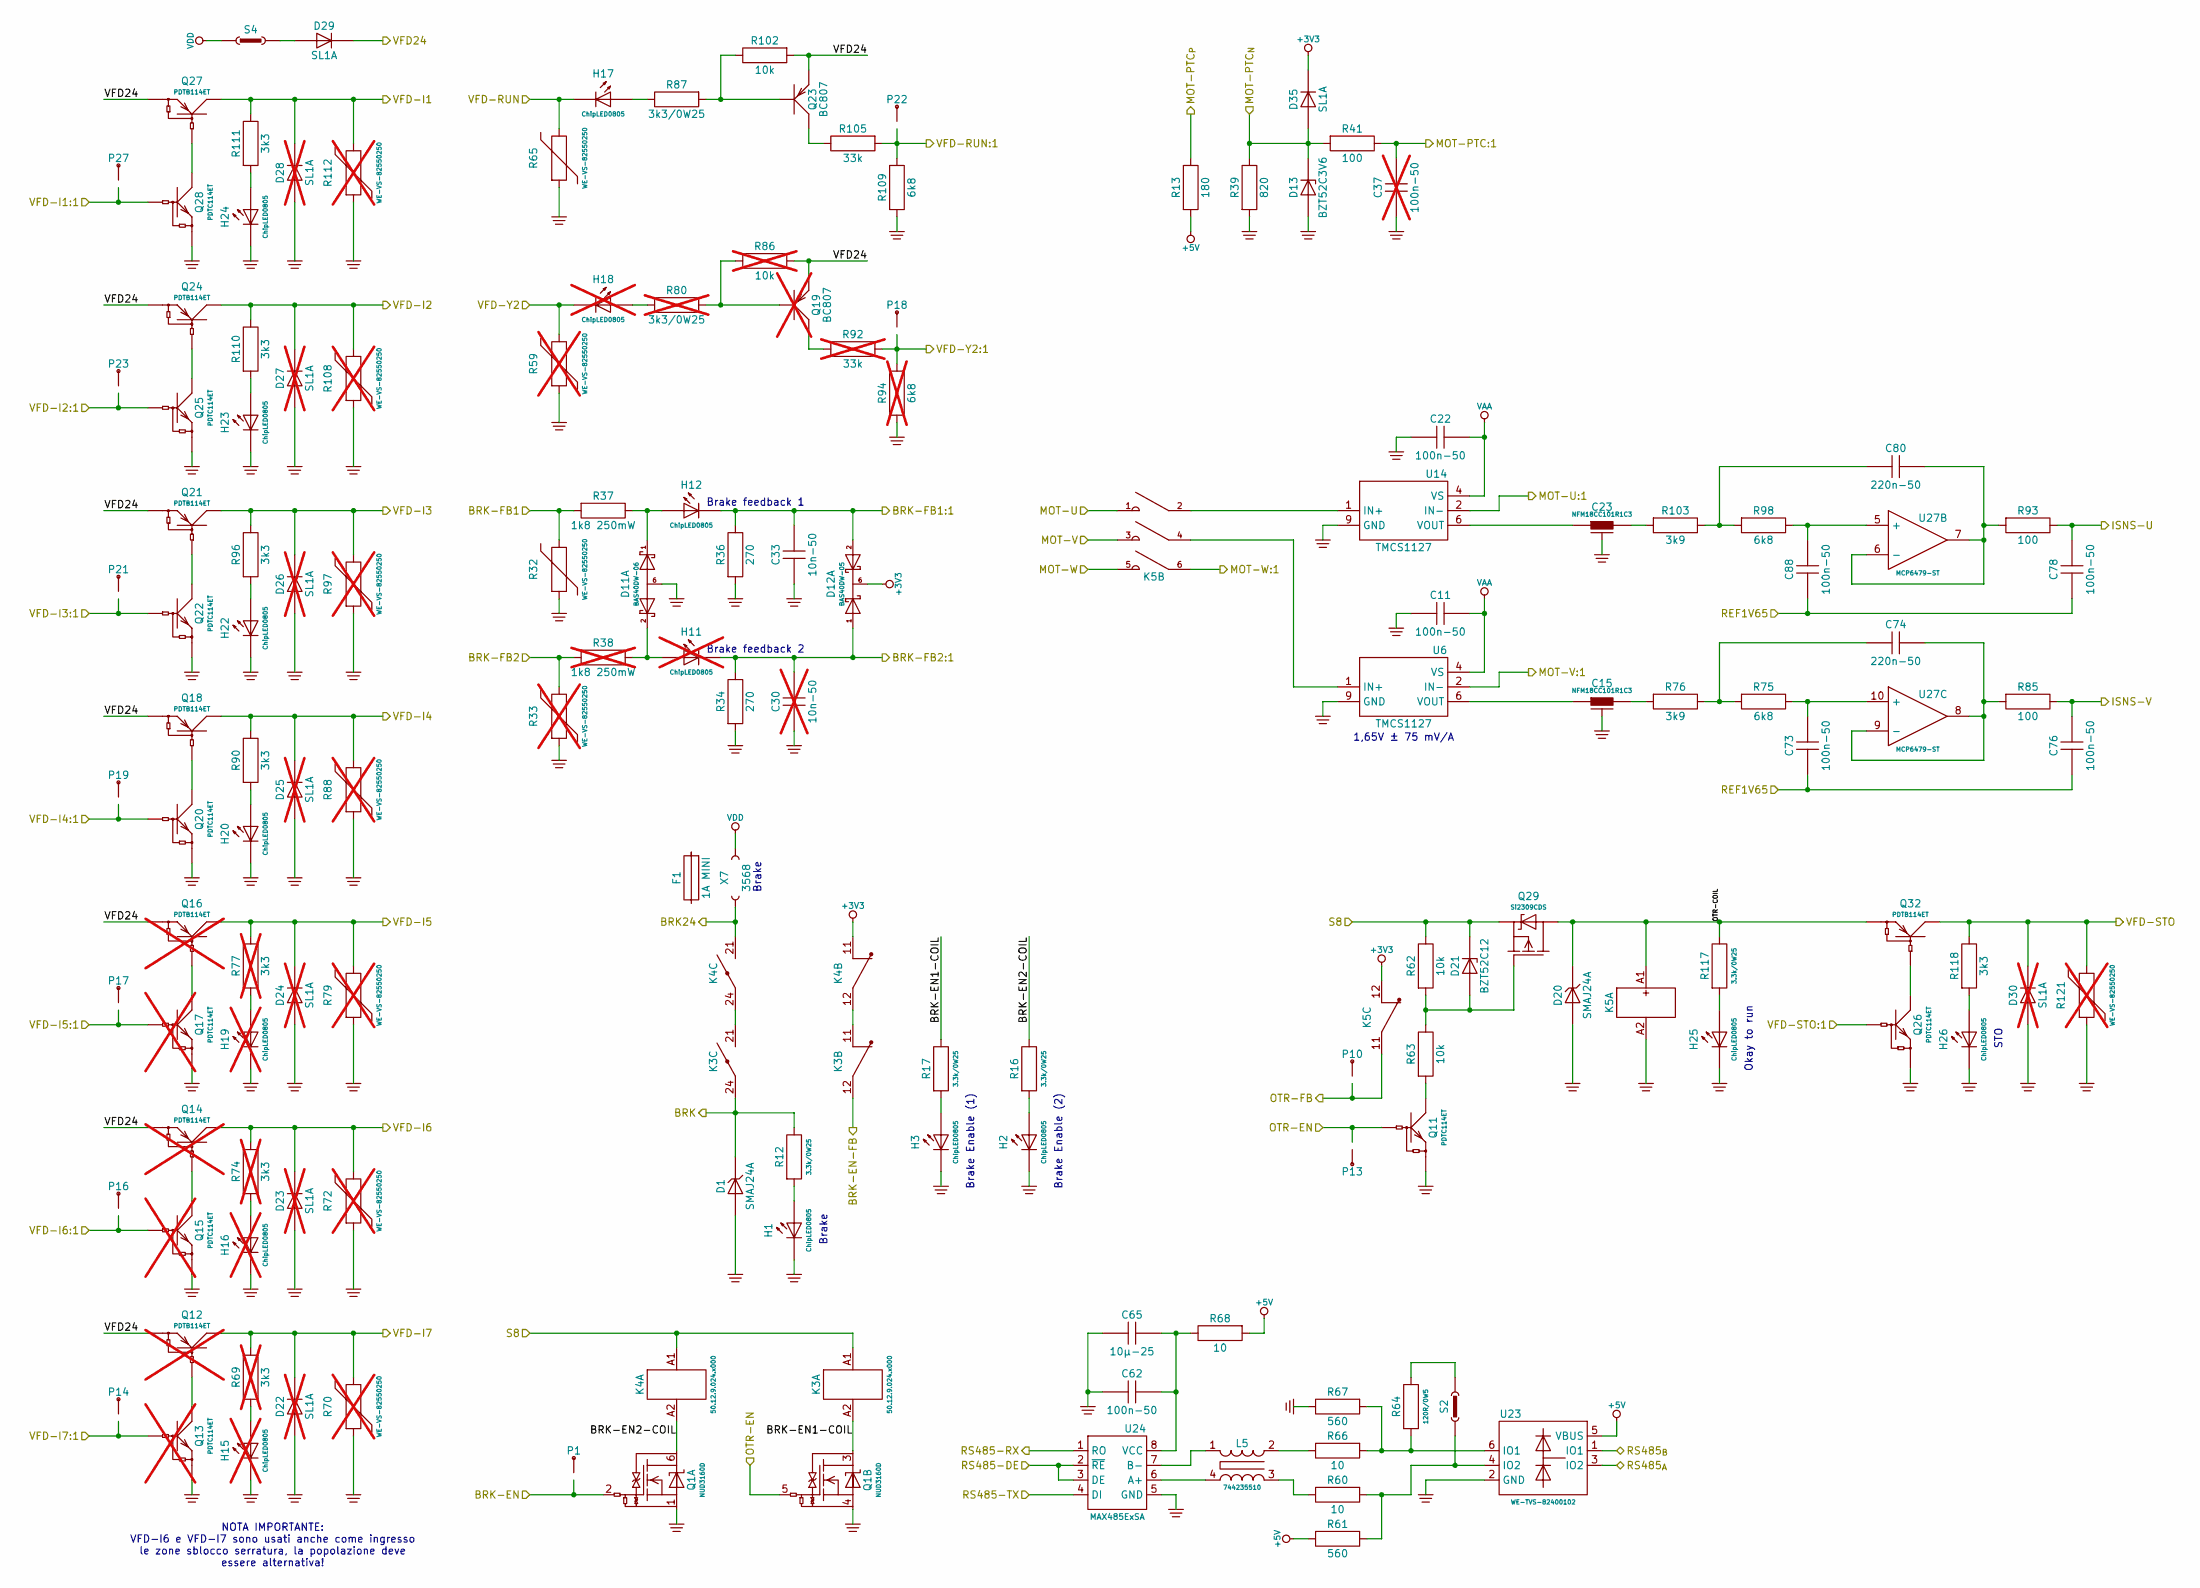
[picture p48: schematic VFD-Interface.kicad_sch, Estensione cabina UDEC]

Parts:
C11, C22, C62, C73, C76, C78, C88: 100n-50; C0603
C15, C23: NFM18CC101R1C3; Murata-NFM18CC
C30: 10n-50; C0603; not fitted
C33: 10n-50; C0603
C37: 100n-50; C0603; not fitted
C65: 10µ-25; C0805
C74, C80: 220n-50; C0603
D1, D20: SMAJ24A; DO214AC
D11: BAS40DW-06; MO203AB
D12: BAS40DW-05; MO203AB
D13: BZT52C3V6; SOD123
D21: BZT52C12; SOD123
D22, D23, D24, D25, D26, D27, D28, D30: SL1A; SOD123FL; not fitted
D29, D35: SL1A; SOD123FL
F1: 1A MINI; MINI-Fuse
H1, H2, H3, H12, H17, H20, H22, H23, H24, H25, H26: ChipLED0805; Chipled-0805
H11, H15, H16, H18, H19: ChipLED0805; Chipled-0805; not fitted
K3, K4: 50.12.9.024.x000; 50.12
K5: 11BGP0901D024; Lovato-11BGP0901D024
L5: 744235510; WE-CNSW-1812
P1, P10, P13, P14, P16, P17, P18, P19, P21, P22, P23, P27: PinTst
Q1: NUD3160D; MO193AA
Q11, Q20, Q22, Q25, Q26, Q28: PDTC114ET; TO236-BEC
Q12, Q14, Q16: PDTB114ET; TO236-BEC; not fitted
Q13, Q15, Q17: PDTC114ET; TO236-BEC; not fitted
Q18, Q21, Q24, Q27, Q32: PDTB114ET; TO236-BEC
Q19: BC807; TO236-BEC; not fitted
Q23: BC807; TO236-BEC
Q29: Si2309CDS; TO236-GSD
R12, R16, R17, R117: 3.3k/0W25; R1206
R13: 180; R0603
R32, R65: WE-VS-82550250; WE-VS-0805
R33, R59, R70, R72, R79, R88, R97, R108, R112, R121: WE-VS-82550250; WE-VS-0805; not fitted
R34, R36: 270; R0603
R37: 1k8 250mW; R1206
R38: 1k8 250mW; R1206; not fitted
R39: 820; R0603
R41, R85, R93: 100; R0603
R60, R66, R68: 10; R0603
R61, R67: 560; R0603
R62, R63, R102: 10k; R0603
R64: 120R/0W5; R1210
R69, R74, R77: 3k3; R1206; not fitted
R75, R98, R109: 6k8; R0603
R76, R103: 3k9; R0603
R80: 3k3/0W25; R1206; not fitted
R86: 10k; R0603; not fitted
R87: 3k3/0W25; R1206
R90, R96, R110, R111, R118: 3k3; R1206
R92: 33k; R0603; not fitted
R94: 6k8; R0603; not fitted
R105: 33k; R0603
S2, S4: Jumper-2.54
U6, U14: TMCS1127; TI-DVG10
U23: WE-TVS-82400102; MO178AB
U24: MAX485ExSA; MS012AA
U27: MCP6479-ST; MO153AB1
X7: 3568; Keystone-3568

Connections:
+3V3: D12.6 (K), D35.K, K4.11, K5.12; also elsewhere on the board
+5V: R13.2, R61.1, R68.2, U23.5 (VBUS); also elsewhere on the board
/BRK: D1.K, K3.24, R12.1; also elsewhere on the board
/BRK24: K4.21, X7.1; also elsewhere on the board
/BRK-FB1: R32.2, R37.2; also elsewhere on the board
/BRK-FB2: R33.2, R38.2; also elsewhere on the board
/Logica/BRK-EN: P1.1, Q1.2 (G); also elsewhere on the board
/Logica/BRK-EN-FB: K3.12; also elsewhere on the board
/Logica/BRK-FB1: C33.2, D12.2 (A2), H12.K, R36.1; also elsewhere on the board
/Logica/BRK-FB2: C30.2, D12.1 (A1), H11.K, R34.1; also elsewhere on the board
/Logica/ISNS-U: C78.2, R93.1; also elsewhere on the board
/Logica/ISNS-V: C76.2, R85.1; also elsewhere on the board
/Logica/MODBUS-DE: U24.2 (~RE), U24.3 (DE); also elsewhere on the board
/Logica/MODBUS-RX: U24.1 (RO); also elsewhere on the board
/Logica/MODBUS-TX: U24.4 (DI); also elsewhere on the board
/Logica/MOT-PTC:1: C37.2, R41.1; also elsewhere on the board
/Logica/OTR-EN: P13.1, Q1.5 (G), Q11.B; also elsewhere on the board
/Logica/OTR-FB: K5.11, P10.1; also elsewhere on the board
/Logica/VFD-I1: P27.1, Q28.B; also elsewhere on the board
/Logica/VFD-I2: P23.1, Q25.B; also elsewhere on the board
/Logica/VFD-I3: P21.1, Q22.B; also elsewhere on the board
/Logica/VFD-I4: P19.1, Q20.B; also elsewhere on the board
/Logica/VFD-I5: P17.1, Q17.B; also elsewhere on the board
/Logica/VFD-I6: P16.1, Q15.B; also elsewhere on the board
/Logica/VFD-I7: P14.1, Q13.B; also elsewhere on the board
/Logica/VFD-RUN: P22.1, R105.2, R109.1; also elsewhere on the board
/Logica/VFD-STO: Q26.B; also elsewhere on the board
/Logica/VFD-Y2: P18.1, R92.2, R94.1; also elsewhere on the board
/MODBUS_{A}: U23.3 (IO2); also elsewhere on the board
/MODBUS_{B}: U23.1 (IO1); also elsewhere on the board
/MOT-PTC_{N}: D13.K, D35.A, R39.1, R41.2; also elsewhere on the board
/MOT-PTC_{P}: R13.1; also elsewhere on the board
/MOT-U: K5.1; also elsewhere on the board
/MOT-U:1: U14.2 (IN-); also elsewhere on the board
/MOT-V: K5.3; also elsewhere on the board
/MOT-V:1: U6.2 (IN-); also elsewhere on the board
/MOT-W: K5.5; also elsewhere on the board
/MOT-W:1: K5.6; also elsewhere on the board
/REF1V65: C73.1, C76.1, C78.1, C88.1; also elsewhere on the board
/S8: D21.K, K3.A1, K4.A1, Q29.S, R62.1; also elsewhere on the board
/VFD24: D29.K, Q12.E, Q14.E, Q16.E, Q18.E, Q19.E, Q21.E, Q23.E, Q24.E, Q27.E, R86.2, R102.2; also elsewhere on the board
/VFD-I1: D28.K, Q27.C, R111.1, R112.2; also elsewhere on the board
/VFD-I2: D27.K, Q24.C, R108.2, R110.1; also elsewhere on the board
/VFD-I3: D26.K, Q21.C, R96.1, R97.2; also elsewhere on the board
/VFD-I4: D25.K, Q18.C, R88.2, R90.1; also elsewhere on the board
/VFD-I5: D24.K, Q16.C, R77.1, R79.2; also elsewhere on the board
/VFD-I6: D23.K, Q14.C, R72.2, R74.1; also elsewhere on the board
/VFD-I7: D22.K, Q12.C, R69.1, R70.2; also elsewhere on the board
/VFD-Interface/BRK-EN1-COIL: K3.A2, Q1.3 (D), R17.1
/VFD-Interface/BRK-EN2-COIL: K4.A2, Q1.6 (D), R16.1
/VFD-Interface/OTR-COIL: D20.K, K5.A1, Q29.D, Q32.E, R117.1
/VFD-RUN: H17.K, R65.2; also elsewhere on the board
/VFD-STO: D30.K, Q32.C, R118.1, R121.2; also elsewhere on the board
/VFD-Y2: H18.K, R59.2; also elsewhere on the board
GND: C11.2, C15.3, C22.2, C23.3, C30.1, C33.1, C37.1, C62.2, C65.2, D1.A, D11.6 (A), D13.A, D20.A, D22.A, D23.A, D24.A, D25.A, D26.A, D27.A, D28.A, D30.A, H1.K, H2.K, H3.K, H15.K, H16.K, H19.K, H20.K, H22.K, H23.K, H24.K, H25.K, H26.K, K5.A2, Q1.1 (4), Q1.4, Q11.E, Q13.E, Q15.E, Q17.E, Q20.E, Q22.E, Q25.E, Q26.E, Q28.E, R32.1, R33.1, R34.2, R36.2, R39.2, R59.1, R65.1, R67.1, R70.1, R72.1, R79.1, R88.1, R94.2, R97.1, R108.1, R109.2, R112.1, R121.1, U6.9 (GND), U14.9 (GND), U23.2 (GND), U24.5 (GND); also elsewhere on the board
unnamed: C15.2, R76.2
unnamed: C23.2, R103.2
unnamed: C74.1, R75.2, R76.1
unnamed: C80.1, R98.2, R103.1
unnamed: D11.1 (K1), H12.A, R37.1
unnamed: D11.2 (K2), H11.A, R38.1
unnamed: D21.A, Q29.G, R62.2, R63.1
unnamed: D29.A, S4.2
unnamed: H1.A, R12.2
unnamed: H2.A, R16.2
unnamed: H3.A, R17.2
unnamed: H15.A, R69.2
unnamed: H16.A, R74.2
unnamed: H17.A, R87.1
unnamed: H18.A, R80.1
unnamed: H19.A, R77.2
unnamed: H20.A, R90.2
unnamed: H22.A, R96.2
unnamed: H23.A, R110.2
unnamed: H24.A, R111.2
unnamed: H25.A, R117.2
unnamed: H26.A, R118.2
unnamed: K3.11, K4.12
unnamed: K3.21, K4.24
unnamed: L5.2, R66.1
unnamed: L5.3, R60.1
unnamed: Q11.C, R63.2
unnamed: Q12.B, Q13.C
unnamed: Q14.B, Q15.C
unnamed: Q16.B, Q17.C
unnamed: Q18.B, Q20.C
unnamed: Q19.B, R80.2, R86.1
unnamed: Q19.C, R92.1
unnamed: Q21.B, Q22.C
unnamed: Q23.B, R87.2, R102.1
unnamed: Q23.C, R105.1
unnamed: Q24.B, Q25.C
unnamed: Q26.C, Q32.B
unnamed: Q27.B, Q28.C
unnamed: R60.2, R61.2, S2.2, U23.4 (IO2)
unnamed: R64.1, S2.1
unnamed: R64.2, R66.2, R67.2, U23.6 (IO1)
unnamed: K5.4, U6.1 (IN+)
unnamed: C15.1, U6.6 (VOUT)
unnamed: K5.2, U14.1 (IN+)
unnamed: C23.1, U14.6 (VOUT)
unnamed: L5.4, U24.6 (A+)
unnamed: L5.1, U24.7 (B-)
unnamed: C62.1, C65.1, R68.1, U24.8 (VCC)
unnamed: C88.2, R98.1, U27.5 (+)
unnamed: C80.2, R93.2, U27.6 (-), U27.7
unnamed: C73.2, R75.1, U27.10 (+)
unnamed: C74.2, R85.2, U27.8, U27.9 (-)
VAA: C11.1, C22.1, U6.4 (VS), U14.4 (VS); also elsewhere on the board
VDD: S4.1, X7.2; also elsewhere on the board

Notes on the sheet:
STO
1,65V ± 75 mV/A
Brake Enable (2)
Brake Enable (1)
Brake
Okay to run
Brake feedback 2
Brake feedback 1
NOTA IMPORTANTE: VFD-I6 e VFD-I7 sono usati anche come ingresso le zone sblocco serratura, la popolazione deve essere alternativa!
