dermatoid-collab/EVC_FW/UDEC.CX/UDEC.CX.kicad_pcb

## KiCad design UDEC.CX/UDEC.CX.kicad_pcb (continued)

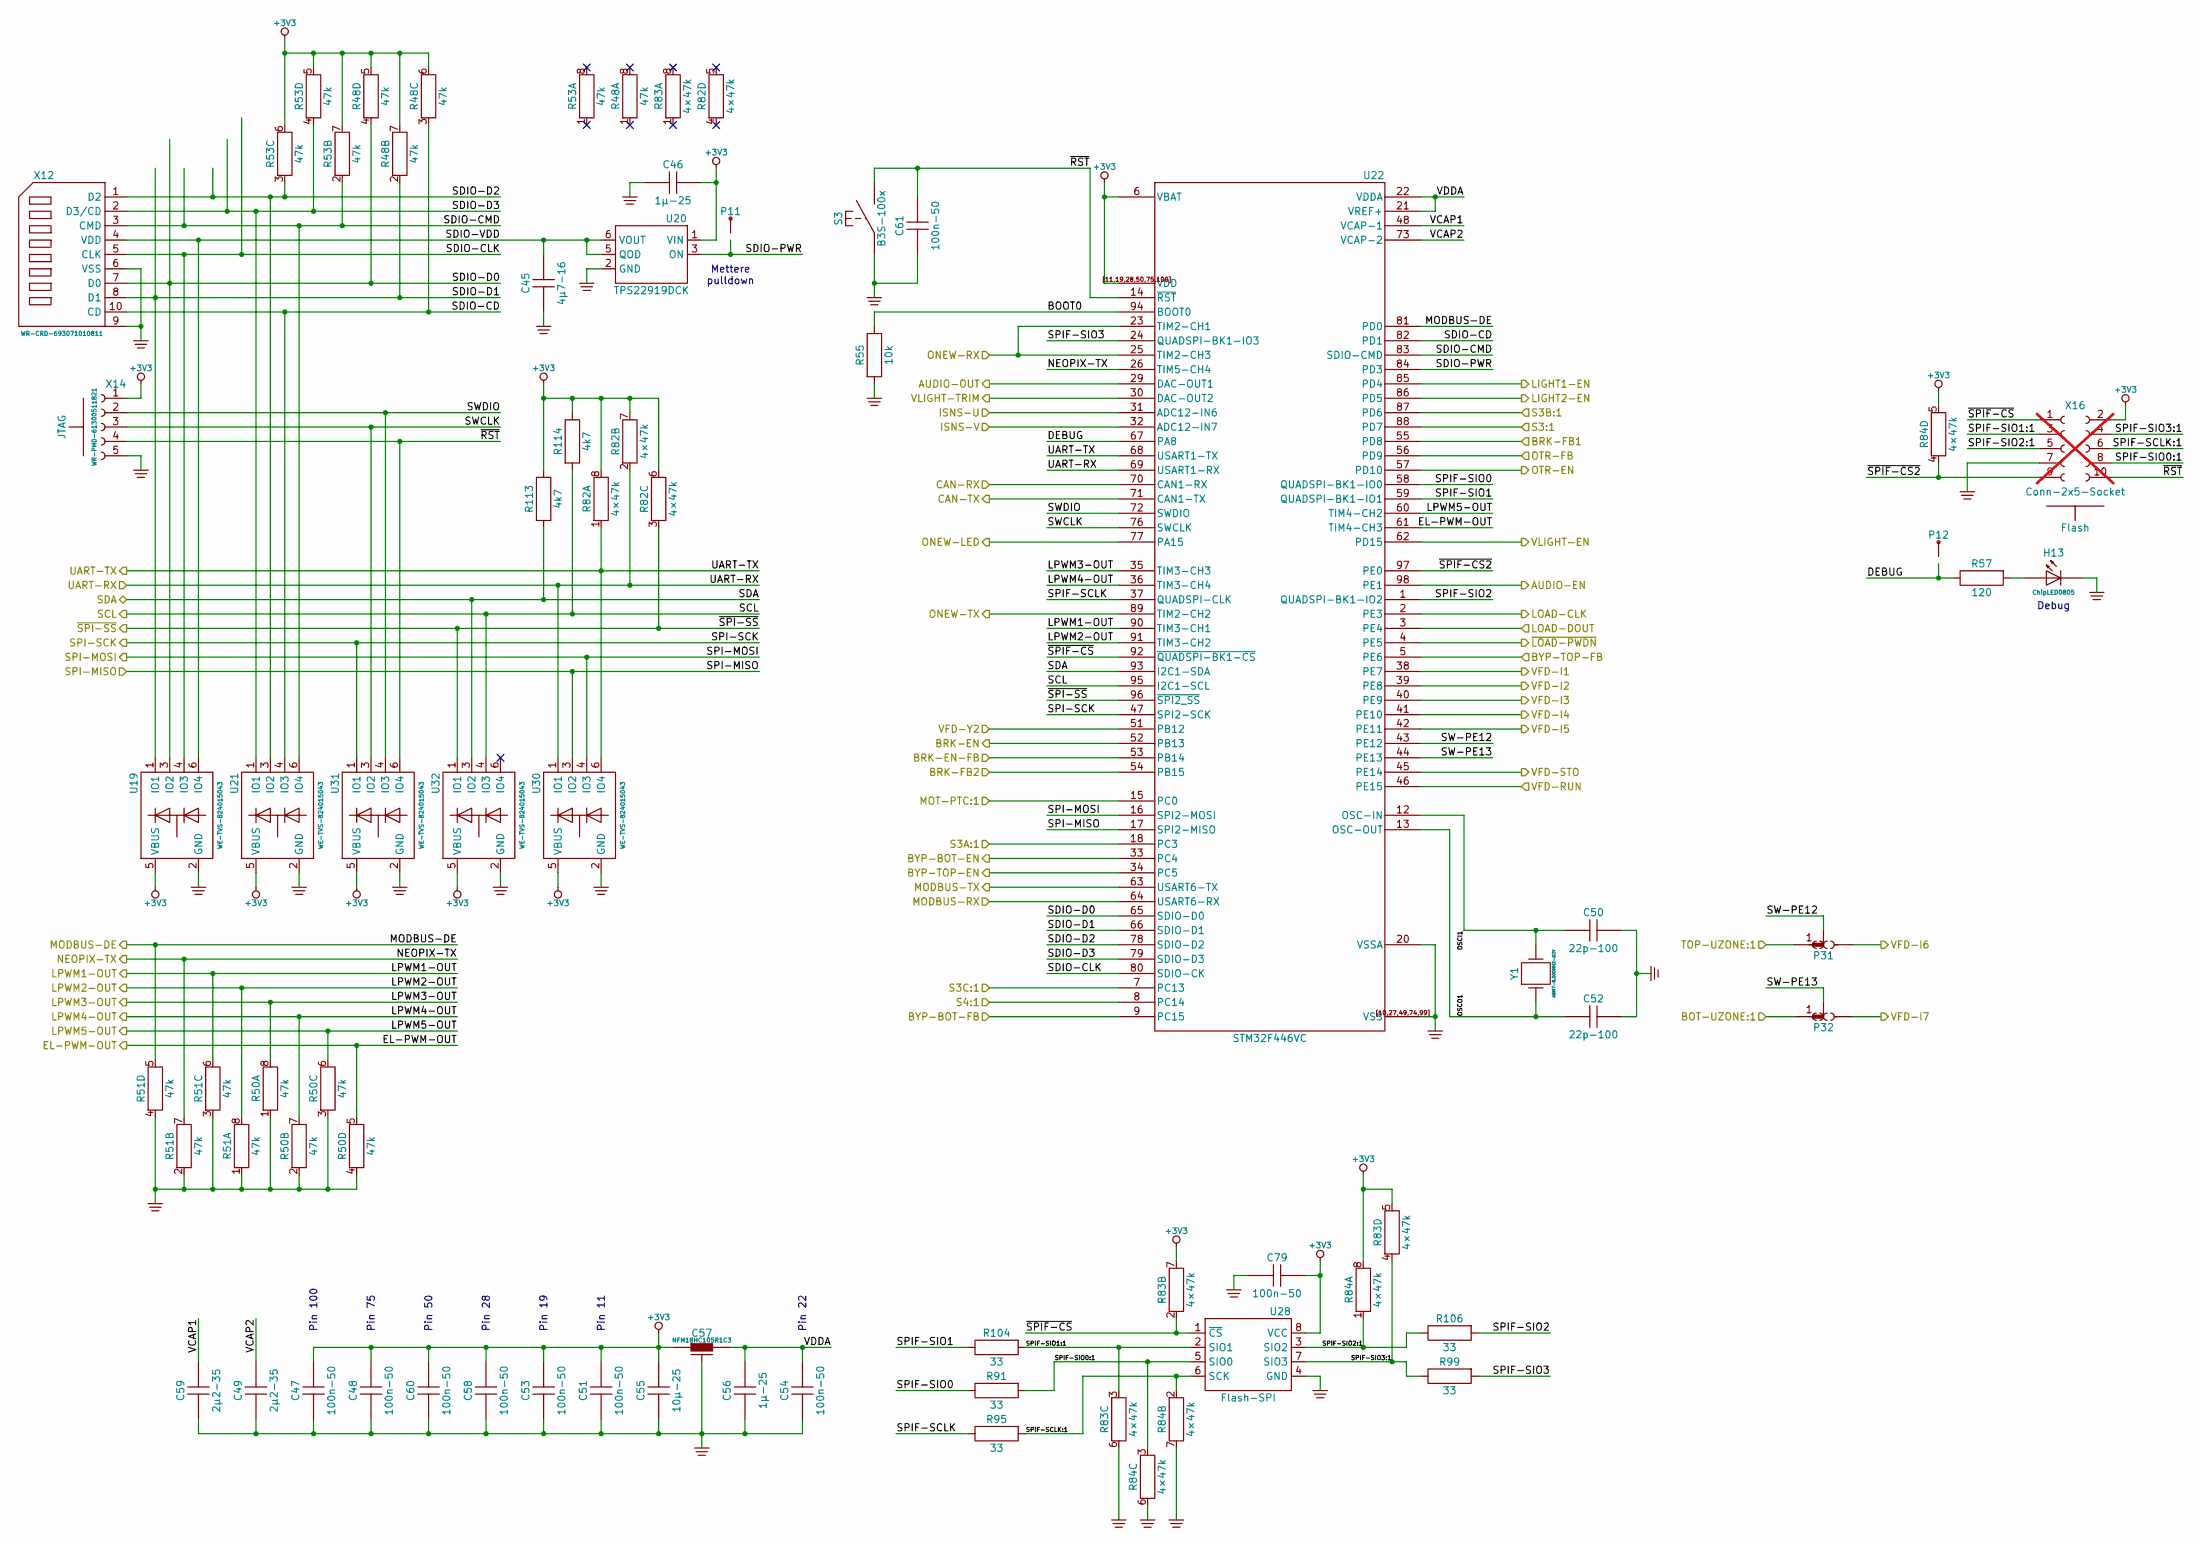
[picture p49: schematic Logica.kicad_sch, Estensione cabina UDEC]

Parts:
C45: 4µ7-16; C0603
C46, C56: 1µ-25; C0603
C47, C48, C51, C53, C54, C58, C60, C61, C79: 100n-50; C0603
C49, C59: 2µ2-35; C0603
C50, C52: 22p-100; C0603
C55: 10µ-25; C0805
C57: NFM18HC105R1C3; Murata-NFM18HC105
H13: ChipLED0805; Chipled-0805
P11, P12: PinTst
P31, P32: Solder; Solder-Jumper-CO-Default-03
R48, R50, R51, R53: 47k; KMY-RAC164D
R55: 10k; R0603
R57: 120; R0603
R82, R83, R84: 4×47k; KMY-RAC164D
R91, R95, R99, R104, R106: 33; R0603
R113, R114: 4k7; R0603
S3: B3S-100x; Omron-B3S-100x
U19, U21, U30, U31, U32: WE-TVS-824015043; MO178AB
U20: TPS22919DCK; MO203AB
U22: STM32F446VC; MS026BED
U28: Flash-SPI; MS012AA+208mil
X12: WR-CRD-693071010811
X14: WR-PHD-61300511821; F-5
X16: Conn-2x5-Socket; F-2x5; not fitted
Y1: ABM7-8.000MHZ-D2Y; Abracon-ABM07
ZZZ14: JTAG
ZZZ15: Flash

Connections:
+3V3: C46.2, C47.2, C48.2, C51.2, C53.2, C55.2, C57.1, C58.2, C60.2, C79.2, R48.5, R48.6, R48.7, R53.5, R53.6, R53.7, R82.6, R82.7, R82.8, R83.5, R83.7, R84.5, R84.8, R113.1, R114.1, U19.5 (VBUS), U20.1 (VIN), U21.5 (VBUS), U22.6 (VBAT), U22.11 (VDD), U22.19 (VDD), U22.28 (VDD), U22.50 (VDD), U22.75 (VDD), U22.100 (VDD), U22.[11,19,28,50,75,100] (VDD), U28.8 (VCC), U30.5 (VBUS), U31.5 (VBUS), U32.5 (VBUS), X14.1, X16.2; also elsewhere on the board
/Audio/AUDIO-EN: U22.98 (PE1); also elsewhere on the board
/Audio/AUDIO-OUT: U22.29 (DAC-OUT1); also elsewhere on the board
/Comms/CAN-RX: U22.70 (CAN1-RX); also elsewhere on the board
/Comms/CAN-TX: U22.71 (CAN1-TX); also elsewhere on the board
/Comms/ONEWIRE-LED: U22.77 (PA15); also elsewhere on the board
/Comms/ONEWIRE-RX: U22.23 (TIM2-CH1), U22.25 (TIM2-CH3); also elsewhere on the board
/Comms/ONEWIRE-TX: U22.89 (TIM2-CH2); also elsewhere on the board
/Lighting+EL/BOT-UZONE:1: P32.1 (A); also elsewhere on the board
/Lighting+EL/LIGHT1-EN: U22.85 (PD4); also elsewhere on the board
/Lighting+EL/LIGHT2-EN: U22.86 (PD5); also elsewhere on the board
/Lighting+EL/TOP-UZONE:1: P31.1 (A); also elsewhere on the board
/LoadCell/LOAD-CLK: U22.2 (PE3); also elsewhere on the board
/LoadCell/LOAD-DOUT: U22.3 (PE4); also elsewhere on the board
/LoadCell/~LOAD-PDWN: U22.4 (PE5); also elsewhere on the board
/Logica/BOOT0: R55.1, U22.94 (BOOT0)
/Logica/BRK-EN: U22.52 (PB13); also elsewhere on the board
/Logica/BRK-EN-FB: U22.53 (PB14); also elsewhere on the board
/Logica/BRK-FB1: U22.55 (PD8); also elsewhere on the board
/Logica/BRK-FB2: U22.54 (PB15); also elsewhere on the board
/Logica/BYP-BOT-EN: U22.33 (PC4); also elsewhere on the board
/Logica/BYP-BOT-FB: U22.9 (PC15); also elsewhere on the board
/Logica/BYP-TOP-EN: U22.34 (PC5); also elsewhere on the board
/Logica/BYP-TOP-FB: U22.5 (PE6); also elsewhere on the board
/Logica/DEBUG: P12.1, R57.1, U22.67 (PA8)
/Logica/EL-PWM-OUT: R50.5, U22.61 (TIM4-CH3); also elsewhere on the board
/Logica/ISNS-U: U22.31 (ADC12-IN6); also elsewhere on the board
/Logica/ISNS-V: U22.32 (ADC12-IN7); also elsewhere on the board
/Logica/LPWM1-OUT: R51.6, U22.90 (TIM3-CH1); also elsewhere on the board
/Logica/LPWM2-OUT: R51.8, U22.91 (TIM3-CH2); also elsewhere on the board
/Logica/LPWM3-OUT: R50.8, U22.35 (TIM3-CH3); also elsewhere on the board
/Logica/LPWM4-OUT: R50.7, U22.36 (TIM3-CH4); also elsewhere on the board
/Logica/LPWM5-OUT: R50.6, U22.60 (TIM4-CH2); also elsewhere on the board
/Logica/MODBUS-DE: R51.5, U22.81 (PD0); also elsewhere on the board
/Logica/MODBUS-RX: U22.64 (USART6-RX); also elsewhere on the board
/Logica/MODBUS-TX: U22.63 (USART6-TX); also elsewhere on the board
/Logica/MOT-PTC:1: U22.15 (PC0); also elsewhere on the board
/Logica/NEOPIX-TX: R51.7, U22.26 (TIM5-CH4); also elsewhere on the board
/Logica/OSCI1: C50.2, U22.12 (OSC-IN), Y1.2
/Logica/OSCO1: C52.2, U22.13 (OSC-OUT), Y1.1
/Logica/OTR-EN: U22.57 (PD10); also elsewhere on the board
/Logica/OTR-FB: U22.56 (PD9); also elsewhere on the board
/Logica/S3:1: U22.88 (PD7); also elsewhere on the board
/Logica/S3A:1: U22.18 (PC3); also elsewhere on the board
/Logica/S3B:1: U22.87 (PD6); also elsewhere on the board
/Logica/S3C:1: U22.7 (PC13); also elsewhere on the board
/Logica/S4:1: U22.8 (PC14); also elsewhere on the board
/Logica/SDIO-CD: R48.3, U21.4 (IO3), U22.82 (PD1), X12.10 (CD)
/Logica/SDIO-CLK: U19.4 (IO3), U22.80 (SDIO-CK), X12.5 (CLK)
/Logica/SDIO-CMD: R53.2, U21.6 (IO4), U22.83 (SDIO-CMD), X12.3 (CMD)
/Logica/SDIO-D0: R48.4, U19.3 (IO2), U22.65 (SDIO-D0), X12.7 (D0)
/Logica/SDIO-D1: R48.2, U19.1 (IO1), U22.66 (SDIO-D1), X12.8 (D1)
/Logica/SDIO-D2: R53.3, U21.3 (IO2), U22.78 (SDIO-D2), X12.1 (D2)
/Logica/SDIO-D3: R53.4, U21.1 (IO1), U22.79 (SDIO-D3), X12.2 (D3/CD)
/Logica/SDIO-PWR: P11.1, U20.3 (ON), U22.84 (PD3)
/Logica/SDIO-VDD: C45.2, U19.6 (IO4), U20.5 (QOD), U20.6 (VOUT), X12.4 (VDD)
/Logica/SPIF-SCLK: R95.1, U22.37 (QUADSPI-CLK)
/Logica/SPIF-SCLK:1: R84.2, R95.2, U28.6 (SCK), X16.6
/Logica/SPIF-SIO0: R91.1, U22.58 (QUADSPI-BK1-IO0)
/Logica/SPIF-SIO0:1: R84.3, R91.2, U28.5 (SIO0), X16.8
/Logica/SPIF-SIO1: R104.1, U22.59 (QUADSPI-BK1-IO1)
/Logica/SPIF-SIO1:1: R83.3, R104.2, U28.2 (SIO1), X16.3
/Logica/SPIF-SIO2: R106.2, U22.1 (QUADSPI-BK1-IO2)
/Logica/SPIF-SIO2:1: R84.1, R106.1, U28.3 (SIO2), X16.5
/Logica/SPIF-SIO3: R99.2, U22.24 (QUADSPI-BK1-IO3)
/Logica/SPIF-SIO3:1: R83.4, R99.1, U28.7 (SIO3), X16.4
/Logica/SW-PE12: P31.2 (C), U22.43 (PE12)
/Logica/SW-PE13: P32.2 (C), U22.44 (PE13)
/Logica/SWCLK: U22.76 (SWCLK), U31.3 (IO2), X14.3
/Logica/SWDIO: U22.72 (SWDIO), U31.4 (IO3), X14.2
/Logica/VCAP1: C59.2, U22.48 (VCAP-1)
/Logica/VCAP2: C49.2, U22.73 (VCAP-2)
/Logica/VDDA: C54.2, C56.2, C57.2, U22.21 (VREF+), U22.22 (VDDA)
/Logica/VFD-I1: U22.38 (PE7); also elsewhere on the board
/Logica/VFD-I2: U22.39 (PE8); also elsewhere on the board
/Logica/VFD-I3: U22.40 (PE9); also elsewhere on the board
/Logica/VFD-I4: U22.41 (PE10); also elsewhere on the board
/Logica/VFD-I5: U22.42 (PE11); also elsewhere on the board
/Logica/VFD-I6: P31.3 (B); also elsewhere on the board
/Logica/VFD-I7: P32.3 (B); also elsewhere on the board
/Logica/VFD-RUN: U22.46 (PE15); also elsewhere on the board
/Logica/VFD-STO: U22.45 (PE14); also elsewhere on the board
/Logica/VFD-Y2: U22.51 (PB12); also elsewhere on the board
/Logica/VLIGHT-EN: U22.62 (PD15); also elsewhere on the board
/Logica/VLIGHT-TRIM: U22.30 (DAC-OUT2); also elsewhere on the board
/Logica/~RST: C61.2, S3.14, S3.14A, S3.14B (14A), U22.14 (~RST), U31.6 (IO4), X14.4, X16.10
/Logica/~SPIF-CS2: R84.4, U22.97 (PE0), X16.9
/Logica/~SPIF-CS: R83.2, U22.92 (~QUADSPI-BK1-CS), U28.1 (~CS), X16.1
/SCL: R114.2, U22.95 (I2C1-SCL), U32.4 (IO3); also elsewhere on the board
/SDA: R113.2, U22.93 (I2C1-SDA), U32.3 (IO2); also elsewhere on the board
/SPI-MISO: U22.17 (SPI2-MISO), U30.3 (IO2); also elsewhere on the board
/SPI-MOSI: U22.16 (SPI2-MOSI), U30.4 (IO3); also elsewhere on the board
/SPI-SCK: U22.47 (SPI2-SCK), U31.1 (IO1); also elsewhere on the board
/UART-RX: R82.2, U22.69 (USART1-RX), U30.1 (IO1); also elsewhere on the board
/UART-TX: R82.1, U22.68 (USART1-TX), U30.6 (IO4); also elsewhere on the board
/~SPI-SS: R82.3, U22.96 (~SPI2_SS), U32.1 (IO1); also elsewhere on the board
GND: C45.1, C46.1, C47.1, C48.1, C49.1, C50.1, C51.1, C52.1, C53.1, C54.1, C55.1, C56.1, C57.3, C58.1, C59.1, C60.1, C61.1, C79.1, H13.K, R50.1, R50.2, R50.3, R50.4, R51.1, R51.2, R51.3, R51.4, R55.2, R83.6, R84.6, R84.7, S3.13, S3.13A, S3.13B, U19.2 (GND), U20.2 (GND), U21.2 (GND), U22.10 (VSS), U22.20 (VSSA), U22.27 (VSS), U22.49 (VSS), U22.74 (VSS), U22.99 (VSS), U22.[10,27,49,74,99] (VSS), U28.4 (GND), U30.2 (GND), U31.2 (GND), U32.2 (GND), X12.6 (VSS), X12.9, X14.5, X16.7; also elsewhere on the board
unnamed: H13.A, R57.2

Notes on the sheet:
Pin 50
Pin 28
Pin 19
Pin 22
Mettere pulldown
Debug
Pin 100
Pin 11
Pin 75

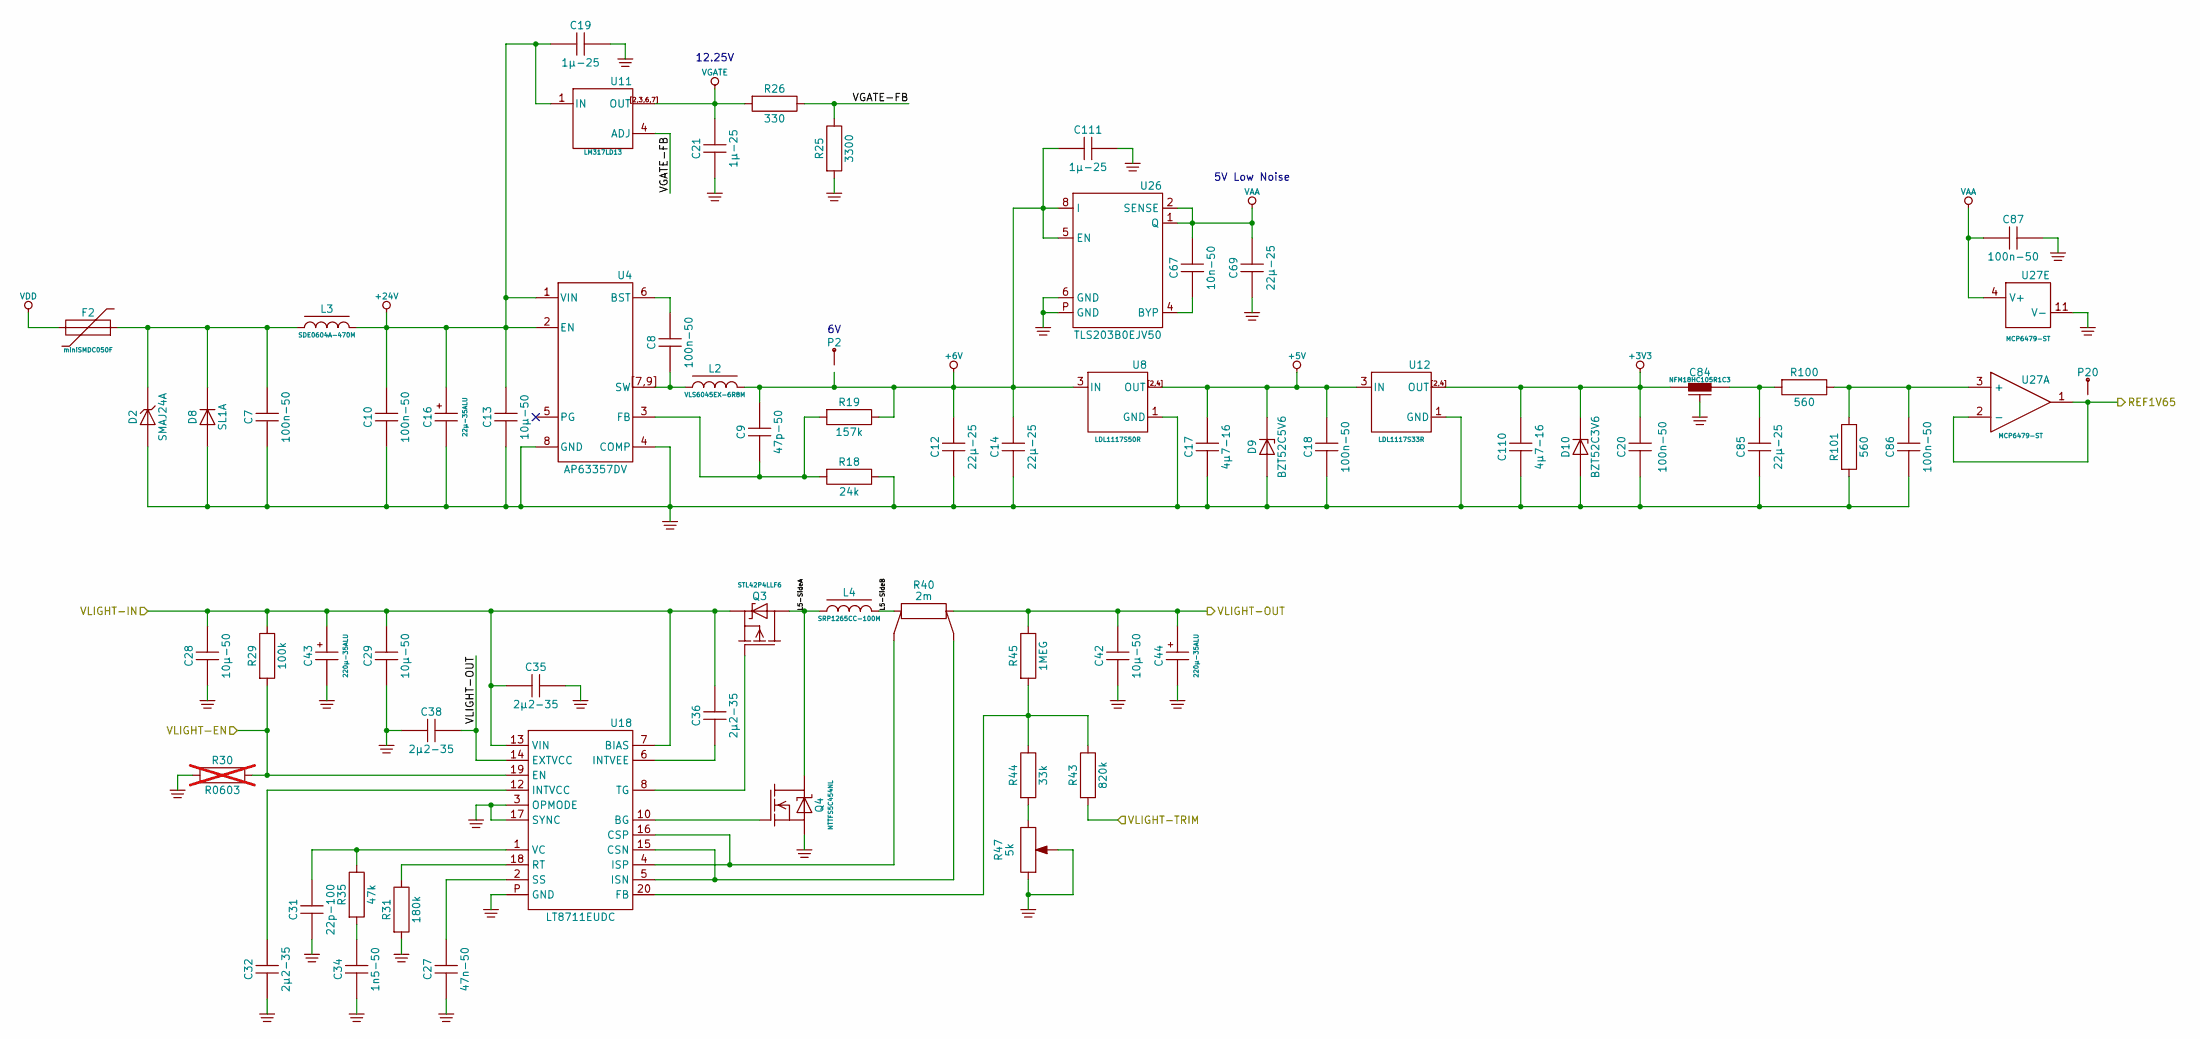
[picture p50: schematic Supply.kicad_sch, Estensione cabina UDEC]

Parts:
C7, C8, C10, C18, C20, C86, C87: 100n-50; C0603
C9: 47p-50; C0603
C12, C14, C69, C85: 22µ-25; C0805
C13, C28, C29, C42: 10µ-50; C1206
C16: 22µ-35ALU; CPV-5x5.5
C17, C110: 4µ7-16; C0603
C19, C21, C111: 1µ-25; C0603
C27: 47n-50; C0603
C31: 22p-100; C0603
C32, C35, C36, C38: 2µ2-35; C0603
C34: 1n5-50; C0603
C43, C44: 220µ-35ALU; CPV-8x10.5
C67: 10n-50; C0603
C84: NFM18HC105R1C3; Murata-NFM18HC105
D2: SMAJ24A; DO214AC
D8: SL1A; SOD123FL
D9: BZT52C5V6; SOD123
D10: BZT52C3V6; SOD123
F2: miniSMDC050F; miniSMDC
L2: VLS6045EX-6R8M; TDK-VLS6045EX
L3: SDE0604A-470M; Bourns-SDE0604A
L4: SRP1265CC-100M; Bourns-SRP1265CC
P2, P20: PinTst
Q3: STL42P4LLF6; ST-PowerFlat-5x6-R-SUBCON-SSSGDDDD
Q4: NTTFS5C454NL; Onsemi-WDFN8-511AB
R18: 24k; R0603
R19: 157k; R0603
R25: 3300; R0603
R26: 330; R0603
R29: 100k; R0603
R30: R0603; not fitted
R31: 180k; R0603
R35: 47k; R0603
R40: 2m; R2512K
R43: 820k; R0603
R44: 33k; R0603
R45: 1MEG; R0603
R47: 5k; Vishay-T73YP
R100, R101: 560; R0603
U4: AP63357DV; Diodes-V-DFN3020-13A
U8: LDL1117S50R; TO261AA
U11: LM317LD13; MS012AA
U12: LDL1117S33R; TO261AA
U18: LT8711EUDC; Linear-UDC20
U26: TLS203B0EJV50; MS012BA
U27: MCP6479-ST; MO153AB1

Connections:
+3V3: C20.2, C84.1, C110.2, D10.K, U12.2 (OUT), U12.4 (OUT), U12.[2,4] (OUT); also elsewhere on the board
+5V: C17.2, C18.2, D9.K, U8.2 (OUT), U8.4 (OUT), U8.[2,4] (OUT), U12.3 (IN); also elsewhere on the board
+6V: C9.2, C12.2, C14.2, C111.2, L2.2, P2.1, R19.1, U8.3 (IN), U26.5 (EN), U26.8 (I); also elsewhere on the board
+24V: C10.2, C13.2, C16.+, C19.1, L3.2, U4.1 (VIN), U4.2 (EN), U11.1 (IN); also elsewhere on the board
/Logica/VLIGHT-EN: R29.2, R30.1, U18.19 (EN); also elsewhere on the board
/Logica/VLIGHT-TRIM: R43.2; also elsewhere on the board
/REF1V65: P20.1, U27.1, U27.2 (-); also elsewhere on the board
/Supply/L5-SideA: L4.1, Q3.D, Q4.D
/Supply/L5-SideB: L4.2, R40.2
/Supply/VGATE-FB: R25.1, R26.1, U11.4 (ADJ)
/VLIGHT-IN: C28.2, C29.2, C35.1, C36.2, C43.+, Q3.S, R29.1, U18.7 (BIAS), U18.13 (VIN); also elsewhere on the board
/VLIGHT-OUT: C38.2, C42.2, C44.+, R40.1, R45.1, U18.14 (EXTVCC); also elsewhere on the board
GND: C7.1, C10.1, C12.1, C13.1, C14.1, C16.-, C17.1, C18.1, C19.2, C20.1, C21.1, C27.1, C28.1, C29.1, C31.1, C32.1, C34.1, C35.2, C38.1, C42.1, C43.-, C44.-, C69.1, C84.3, C85.1, C86.1, C87.2, C110.1, C111.1, D2.A, D8.A, D9.A, D10.A, Q4.S, R18.1, R25.2, R30.2, R31.2, R47.3, R47.W, R101.2, U4.4 (COMP), U4.8 (GND), U8.1 (GND), U12.1 (GND), U18.3 (OPMODE), U18.17 (SYNC), U18.P (GND), U26.6 (GND), U26.P (GND), U27.11 (V-); also elsewhere on the board
unnamed: C7.2, D2.K, D8.K, F2.2, L3.1
unnamed: C34.2, R35.2
unnamed: C84.2, C85.2, R100.2
unnamed: R44.2, R47.1
unnamed: C8.2, U4.6 (BST)
unnamed: C9.1, R18.2, R19.2, U4.3 (FB)
unnamed: C8.1, L2.1, U4.7 (SW), U4.9 (SW), U4.[7,9] (SW)
unnamed: Q4.G, U18.10 (BG)
unnamed: R40.3, U18.5 (ISN), U18.15 (CSN)
unnamed: R40.4, U18.4 (ISP), U18.16 (CSP)
unnamed: R43.1, R44.1, R45.2, U18.20 (FB)
unnamed: C32.2, U18.12 (INTVCC)
unnamed: C36.1, U18.6 (INTVEE)
unnamed: R31.1, U18.18 (RT)
unnamed: C27.2, U18.2 (SS)
unnamed: Q3.G, U18.8 (TG)
unnamed: C31.2, R35.1, U18.1 (VC)
unnamed: C67.1, U26.4 (BYP)
unnamed: C86.2, R100.1, R101.1, U27.3 (+)
VAA: C67.2, C69.2, C87.1, U26.1 (Q), U26.2 (SENSE), U27.4 (V+); also elsewhere on the board
VDD: F2.1; also elsewhere on the board
VGATE: C21.2, R26.2, U11.2 (OUT), U11.3 (OUT), U11.6 (OUT), U11.7 (OUT), U11.[2,3,6,7] (OUT); also elsewhere on the board

Notes on the sheet:
5V Low Noise
12.25V

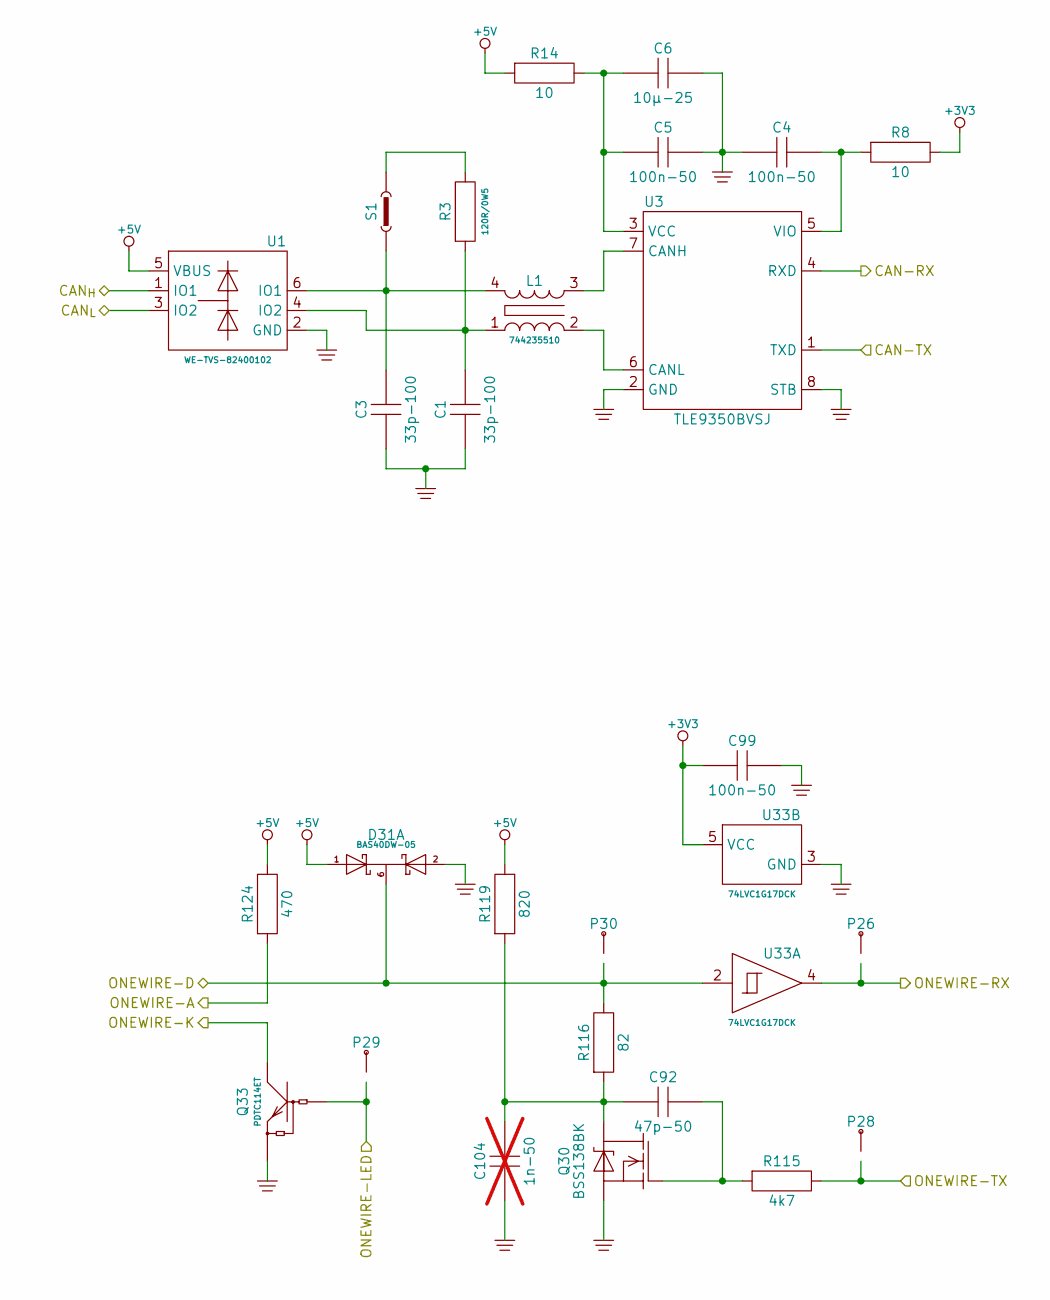
[picture p51: schematic Comms.kicad_sch, Estensione cabina UDEC]

Parts:
C1, C3: 33p-100; C0603
C4, C5, C99: 100n-50; C0603
C6: 10µ-25; C0805
C92: 47p-50; C0603
C104: 1n-50; C0603; not fitted
D31: BAS40DW-05; MO203AB
L1: 744235510; WE-CNSW-1812
P26, P28, P29, P30: PinTst
Q30: BSS138BK; TO236-GSD
Q33: PDTC114ET; TO236-BEC
R3: 120R/0W5; R1210
R8, R14: 10; R0603
R115: 4k7; R0603
R116: 82; R0603
R119: 820; R0603
R124: 470; R0603
S1: Jumper-2.54
U1: WE-TVS-82400102; MO178AB
U3: TLE9350BVSJ; MS012AA
U33: 74LVC1G17DCK; MO203AA

Connections:
+3V3: C99.2, R8.1, U33.5 (VCC); also elsewhere on the board
+5V: D31.1 (A1), R14.2, R119.1, R124.1, U1.5 (VBUS); also elsewhere on the board
/CAN_{H}: U1.1 (IO1); also elsewhere on the board
/CAN_{L}: U1.3 (IO2); also elsewhere on the board
/Comms/CAN-RX: U3.4 (RXD); also elsewhere on the board
/Comms/CAN-TX: U3.1 (TXD); also elsewhere on the board
/Comms/ONEWIRE-LED: P29.1, Q33.B; also elsewhere on the board
/Comms/ONEWIRE-RX: P26.1, U33.4; also elsewhere on the board
/Comms/ONEWIRE-TX: P28.1, R115.1; also elsewhere on the board
/ONEWIRE-A: R124.2; also elsewhere on the board
/ONEWIRE-D: D31.6 (K), P30.1, R116.1, U33.2; also elsewhere on the board
/ONEWIRE-K: Q33.C; also elsewhere on the board
GND: C1.1, C3.1, C4.2, C5.1, C6.2, C99.1, C104.1, D31.2 (A2), Q30.S, Q33.E, U1.2 (GND), U3.2 (GND), U3.8 (STB), U33.3 (GND); also elsewhere on the board
unnamed: C1.2, L1.1, R3.2, U1.4 (IO2)
unnamed: C3.2, L1.4, S1.1, U1.6 (IO1)
unnamed: C92.2, Q30.G, R115.2
unnamed: C92.1, C104.2, Q30.D, R116.2, R119.2
unnamed: R3.1, S1.2
unnamed: L1.3, U3.7 (CANH)
unnamed: L1.2, U3.6 (CANL)
unnamed: C5.2, C6.1, R14.1, U3.3 (VCC)
unnamed: C4.1, R8.2, U3.5 (VIO)

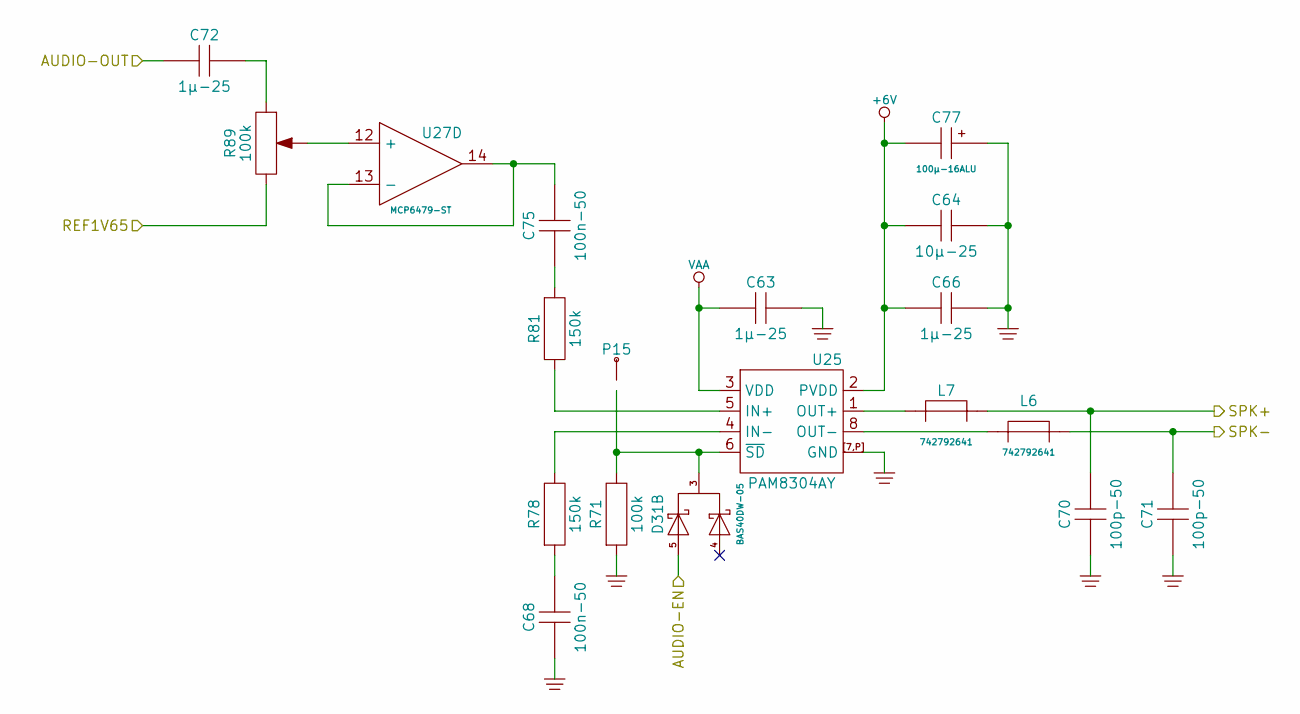
[picture p52: schematic Audio.kicad_sch, Estensione cabina UDEC]

Parts:
C63, C66, C72: 1µ-25; C0603
C64: 10µ-25; C0805
C68, C75: 100n-50; C0603
C70, C71: 100p-50; C0603
C77: 100µ-16ALU; CPV-6.3x5.5
D31: BAS40DW-05; MO203AB
L6, L7: 742792641; WE-CBF-0603-HC
P15: PinTst
R71: 100k; R0603
R78, R81: 150k; R0603
R89: 100k; Vishay-T73YP
U25: PAM8304AY; Diodes-U-DFN3030-8-E
U27: MCP6479-ST; MO153AB1

Connections:
+6V: C64.1, C66.1, C77.-, U25.2 (PVDD); also elsewhere on the board
/Audio/AUDIO-EN: D31.5 (A2); also elsewhere on the board
/Audio/AUDIO-OUT: C72.1; also elsewhere on the board
/REF1V65: R89.1; also elsewhere on the board
/SPK+: C70.2, L7.2; also elsewhere on the board
/SPK-: C71.2, L6.2; also elsewhere on the board
GND: C63.2, C64.2, C66.2, C68.1, C70.1, C71.1, C77.+, R71.2, U25.7 (GND), U25.P (GND), U25.[7,P] (GND); also elsewhere on the board
unnamed: C68.2, R78.2
unnamed: C72.2, R89.3
unnamed: C75.2, R81.2
unnamed: D31.3 (K), P15.1, R71.1, U25.6 (~SD)
unnamed: R81.1, U25.5 (IN+)
unnamed: R78.1, U25.4 (IN-)
unnamed: L7.1, U25.1 (OUT+)
unnamed: L6.1, U25.8 (OUT-)
unnamed: R89.W, U27.12 (+)
unnamed: C75.1, U27.13 (-), U27.14
VAA: C63.1, U25.3 (VDD); also elsewhere on the board

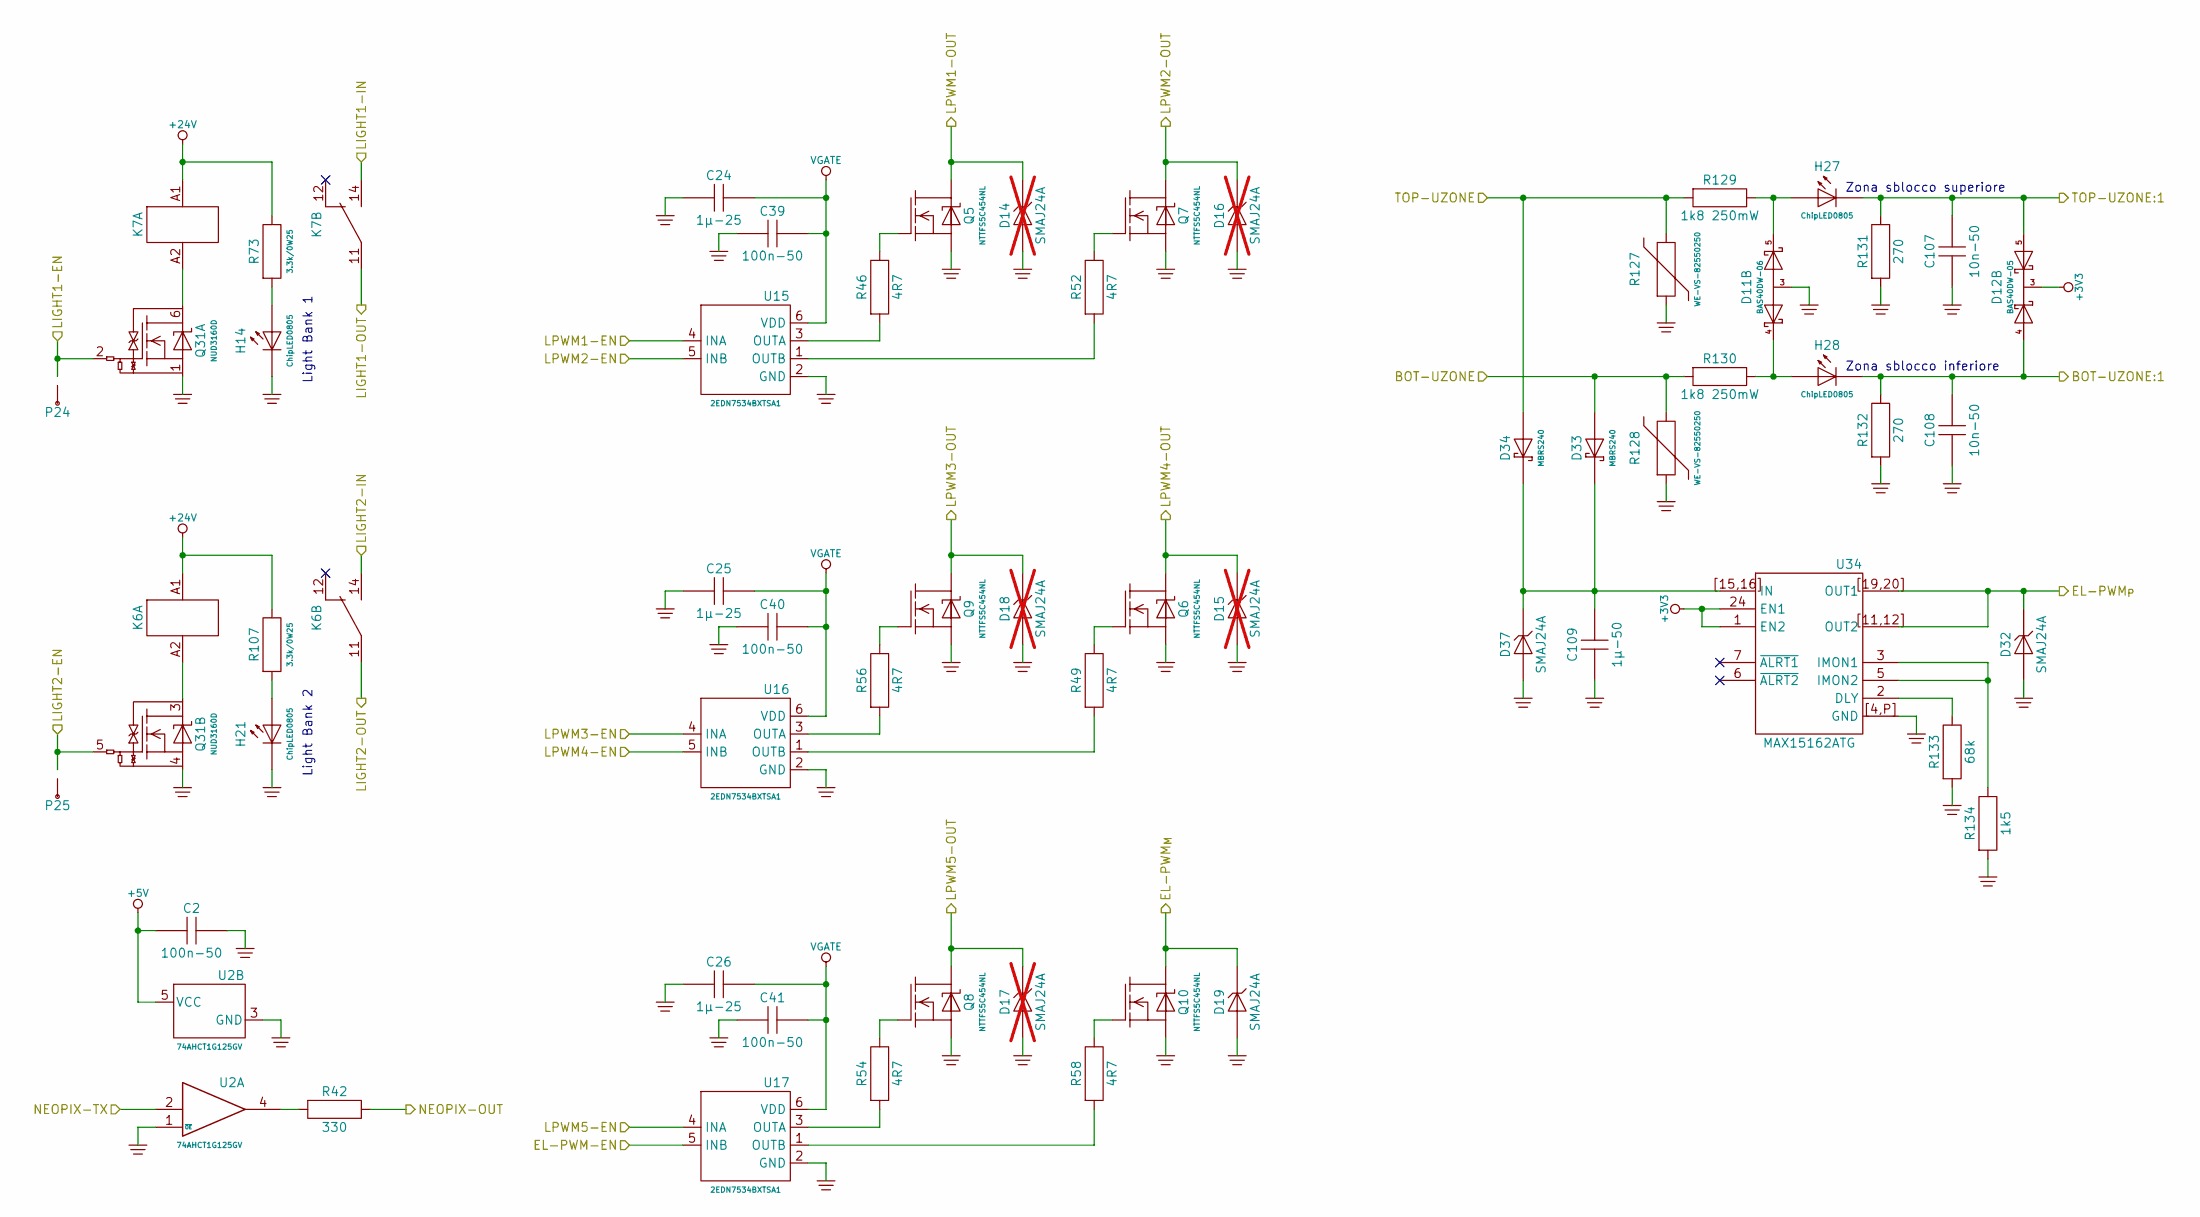
[picture p53: schematic Lighting.kicad_sch, Estensione cabina UDEC]

Parts:
C2, C39, C40, C41: 100n-50; C0603
C24, C25, C26: 1µ-25; C0603
C107, C108: 10n-50; C0603
C109: 1µ-50; C1206
D11: BAS40DW-06; MO203AB
D12: BAS40DW-05; MO203AB
D14, D15, D16, D17, D18: SMAJ24A; DO214AC; not fitted
D19, D32, D37: SMAJ24A; DO214AC
D33, D34: MBRS240; DO214AA
H14, H21, H27, H28: ChipLED0805; Chipled-0805
K6, K7: G5LE-1DC24; Omron-G5LE-1
P24, P25: PinTst
Q5, Q6, Q7, Q8, Q9, Q10: NTTFS5C454NL; Onsemi-WDFN8-511AB
Q31: NUD3160D; MO193AA
R42: 330; R0603
R46, R49, R52, R54, R56, R58: 4R7; R0603
R73, R107: 3.3k/0W25; R1206
R127, R128: WE-VS-82550250; WE-VS-0805
R129, R130: 1k8 250mW; R1206
R131, R132: 270; R0603
R133: 68k; R0603
R134: 1k5; R0603
U2: 74AHCT1G125GV; MO178AA
U15, U16, U17: 2EDN7534BXTSA1; MO178AB
U34: MAX15162ATG; MO220WGGD2

Connections:
+3V3: D12.3 (K), U34.1 (EN2), U34.24 (EN1); also elsewhere on the board
+5V: C2.1, U2.5 (VCC); also elsewhere on the board
+24V: K6.A1, K7.A1, R73.1, R107.1; also elsewhere on the board
/BOT-UZONE: D33.A, R128.2, R130.2; also elsewhere on the board
/EL_{M}: D19.K, Q10.D; also elsewhere on the board
/EL_{P}: D32.K, U34.11 (OUT2), U34.12 (OUT2), U34.19 (OUT1), U34.20 (OUT1), U34.[11,12] (OUT2), U34.[19,20] (OUT1); also elsewhere on the board
/LIGHT1-IN: K7.14; also elsewhere on the board
/LIGHT1-OUT: K7.11; also elsewhere on the board
/LIGHT2-IN: K6.14; also elsewhere on the board
/LIGHT2-OUT: K6.11; also elsewhere on the board
/LPWM1-OUT: D14.K, Q5.D; also elsewhere on the board
/LPWM2-OUT: D16.K, Q7.D; also elsewhere on the board
/LPWM3-OUT: D18.K, Q9.D; also elsewhere on the board
/LPWM4-OUT: D15.K, Q6.D; also elsewhere on the board
/LPWM5-OUT: D17.K, Q8.D; also elsewhere on the board
/Lighting+EL/BOT-UZONE:1: C108.2, D12.4 (A1), H28.K, R132.1; also elsewhere on the board
/Lighting+EL/LIGHT1-EN: P24.1, Q31.2 (G); also elsewhere on the board
/Lighting+EL/LIGHT2-EN: P25.1, Q31.5 (G); also elsewhere on the board
/Lighting+EL/TOP-UZONE:1: C107.2, D12.5 (A2), H27.K, R131.1; also elsewhere on the board
/Logica/EL-PWM-OUT: U17.5 (INB); also elsewhere on the board
/Logica/LPWM1-OUT: U15.4 (INA); also elsewhere on the board
/Logica/LPWM2-OUT: U15.5 (INB); also elsewhere on the board
/Logica/LPWM3-OUT: U16.4 (INA); also elsewhere on the board
/Logica/LPWM4-OUT: U16.5 (INB); also elsewhere on the board
/Logica/LPWM5-OUT: U17.4 (INA); also elsewhere on the board
/Logica/NEOPIX-TX: U2.2; also elsewhere on the board
/NEOPIX-OUT: R42.1; also elsewhere on the board
/TOP-UZONE: D34.A, R127.2, R129.2; also elsewhere on the board
GND: C2.2, C24.1, C25.1, C26.1, C39.1, C40.1, C41.1, C107.1, C108.1, C109.1, D11.3 (A), D14.A, D15.A, D16.A, D17.A, D18.A, D19.A, D32.A, D37.A, H14.K, H21.K, Q5.S, Q6.S, Q7.S, Q8.S, Q9.S, Q10.S, Q31.1 (4), Q31.4, R127.1, R128.1, R131.2, R132.2, R133.2, R134.2, U2.1 (~OE), U2.3 (GND), U15.2 (GND), U16.2 (GND), U17.2 (GND), U34.4 (GND), U34.P (GND), U34.[4,P] (GND); also elsewhere on the board
unnamed: D11.4 (K1), H28.A, R130.1
unnamed: D11.5 (K2), H27.A, R129.1
unnamed: H14.A, R73.2
unnamed: H21.A, R107.2
unnamed: Q5.G, R46.1
unnamed: Q6.G, R49.1
unnamed: Q7.G, R52.1
unnamed: Q8.G, R54.1
unnamed: Q9.G, R56.1
unnamed: Q10.G, R58.1
unnamed: K7.A2, Q31.6 (D)
unnamed: K6.A2, Q31.3 (D)
unnamed: R42.2, U2.4
unnamed: R46.2, U15.3 (OUTA)
unnamed: R52.2, U15.1 (OUTB)
unnamed: R56.2, U16.3 (OUTA)
unnamed: R49.2, U16.1 (OUTB)
unnamed: R54.2, U17.3 (OUTA)
unnamed: R58.2, U17.1 (OUTB)
unnamed: R133.1, U34.2 (DLY)
unnamed: R134.1, U34.3 (IMON1), U34.5 (IMON2)
unnamed: C109.2, D33.K, D34.K, D37.K, U34.15 (IN), U34.16 (IN), U34.[15,16] (IN)
VGATE: C24.2, C25.2, C26.2, C39.2, C40.2, C41.2, U15.6 (VDD), U16.6 (VDD), U17.6 (VDD); also elsewhere on the board

Notes on the sheet:
Light Bank 1
Zona sblocco inferiore
Light Bank 2
Zona sblocco superiore
