dermatoid-collab/EVC_FW/UDEC.CX/UDEC.CX.kicad_pcb

## KiCad design UDEC.CX/UDEC.CX.kicad_pcb (continued)

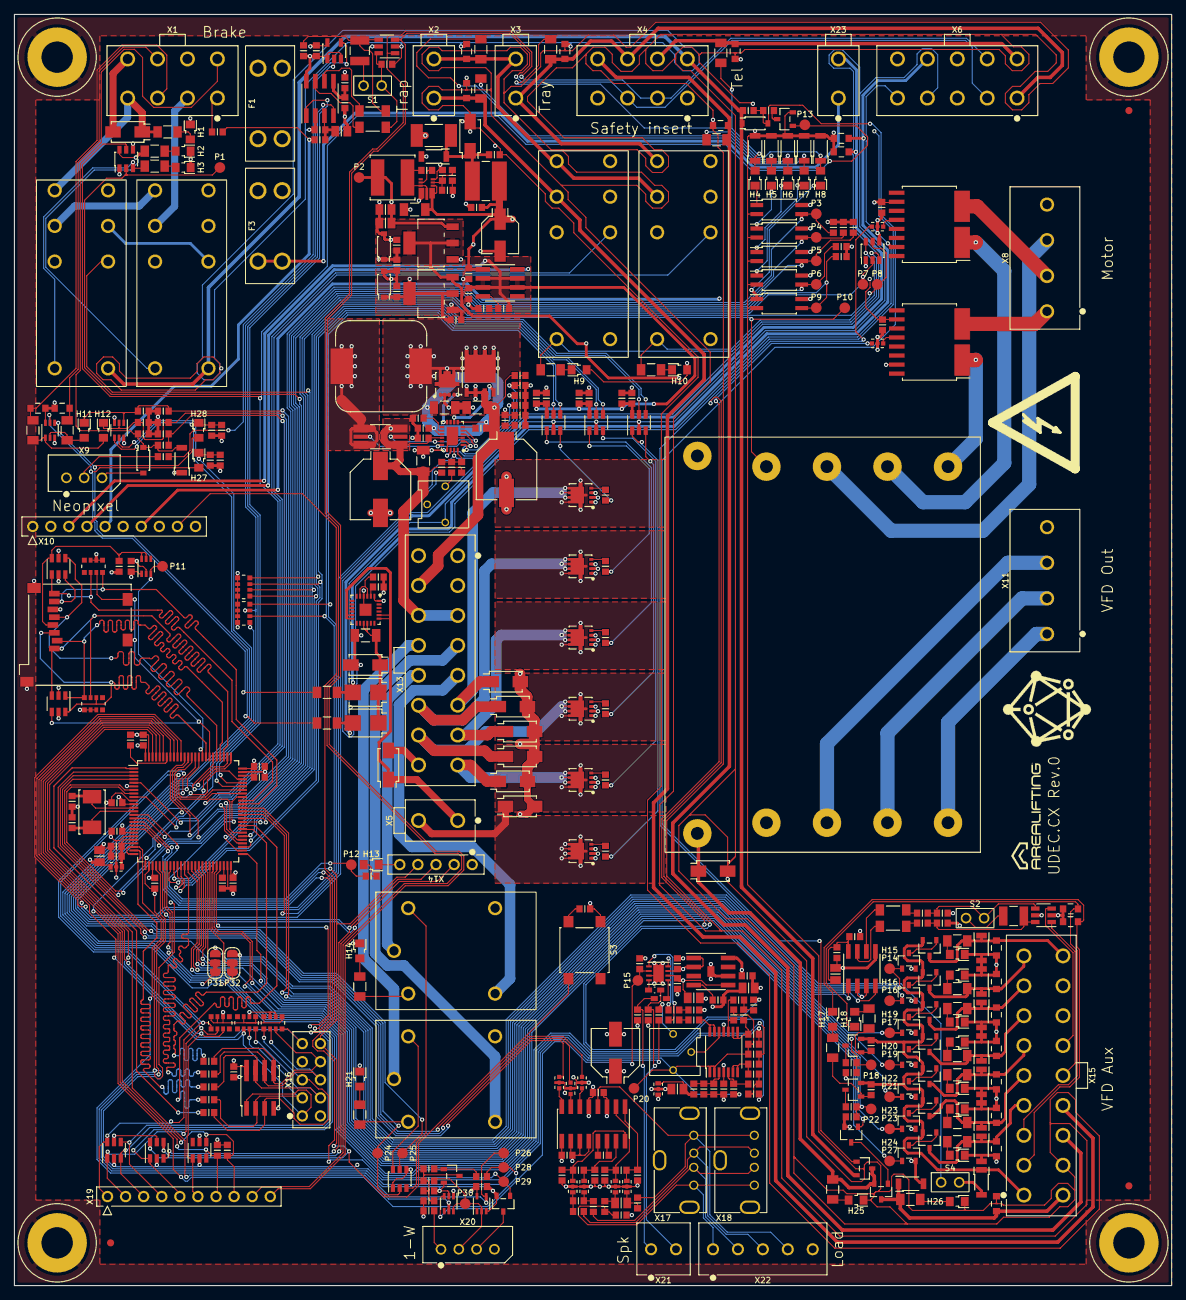
[picture p54: board UDEC.CX.kicad_pcb from above]

Board: 4 copper layers, 162.5 x 178.5 mm, 464 parts (0 on the bottom side), 311 nets.
