dermatoid-collab/EVC_FW/TTF-Base/TTF-Base.kicad_pcb

## KiCad design TTF-Base/TTF-Base.kicad_pcb (2026-11-06)

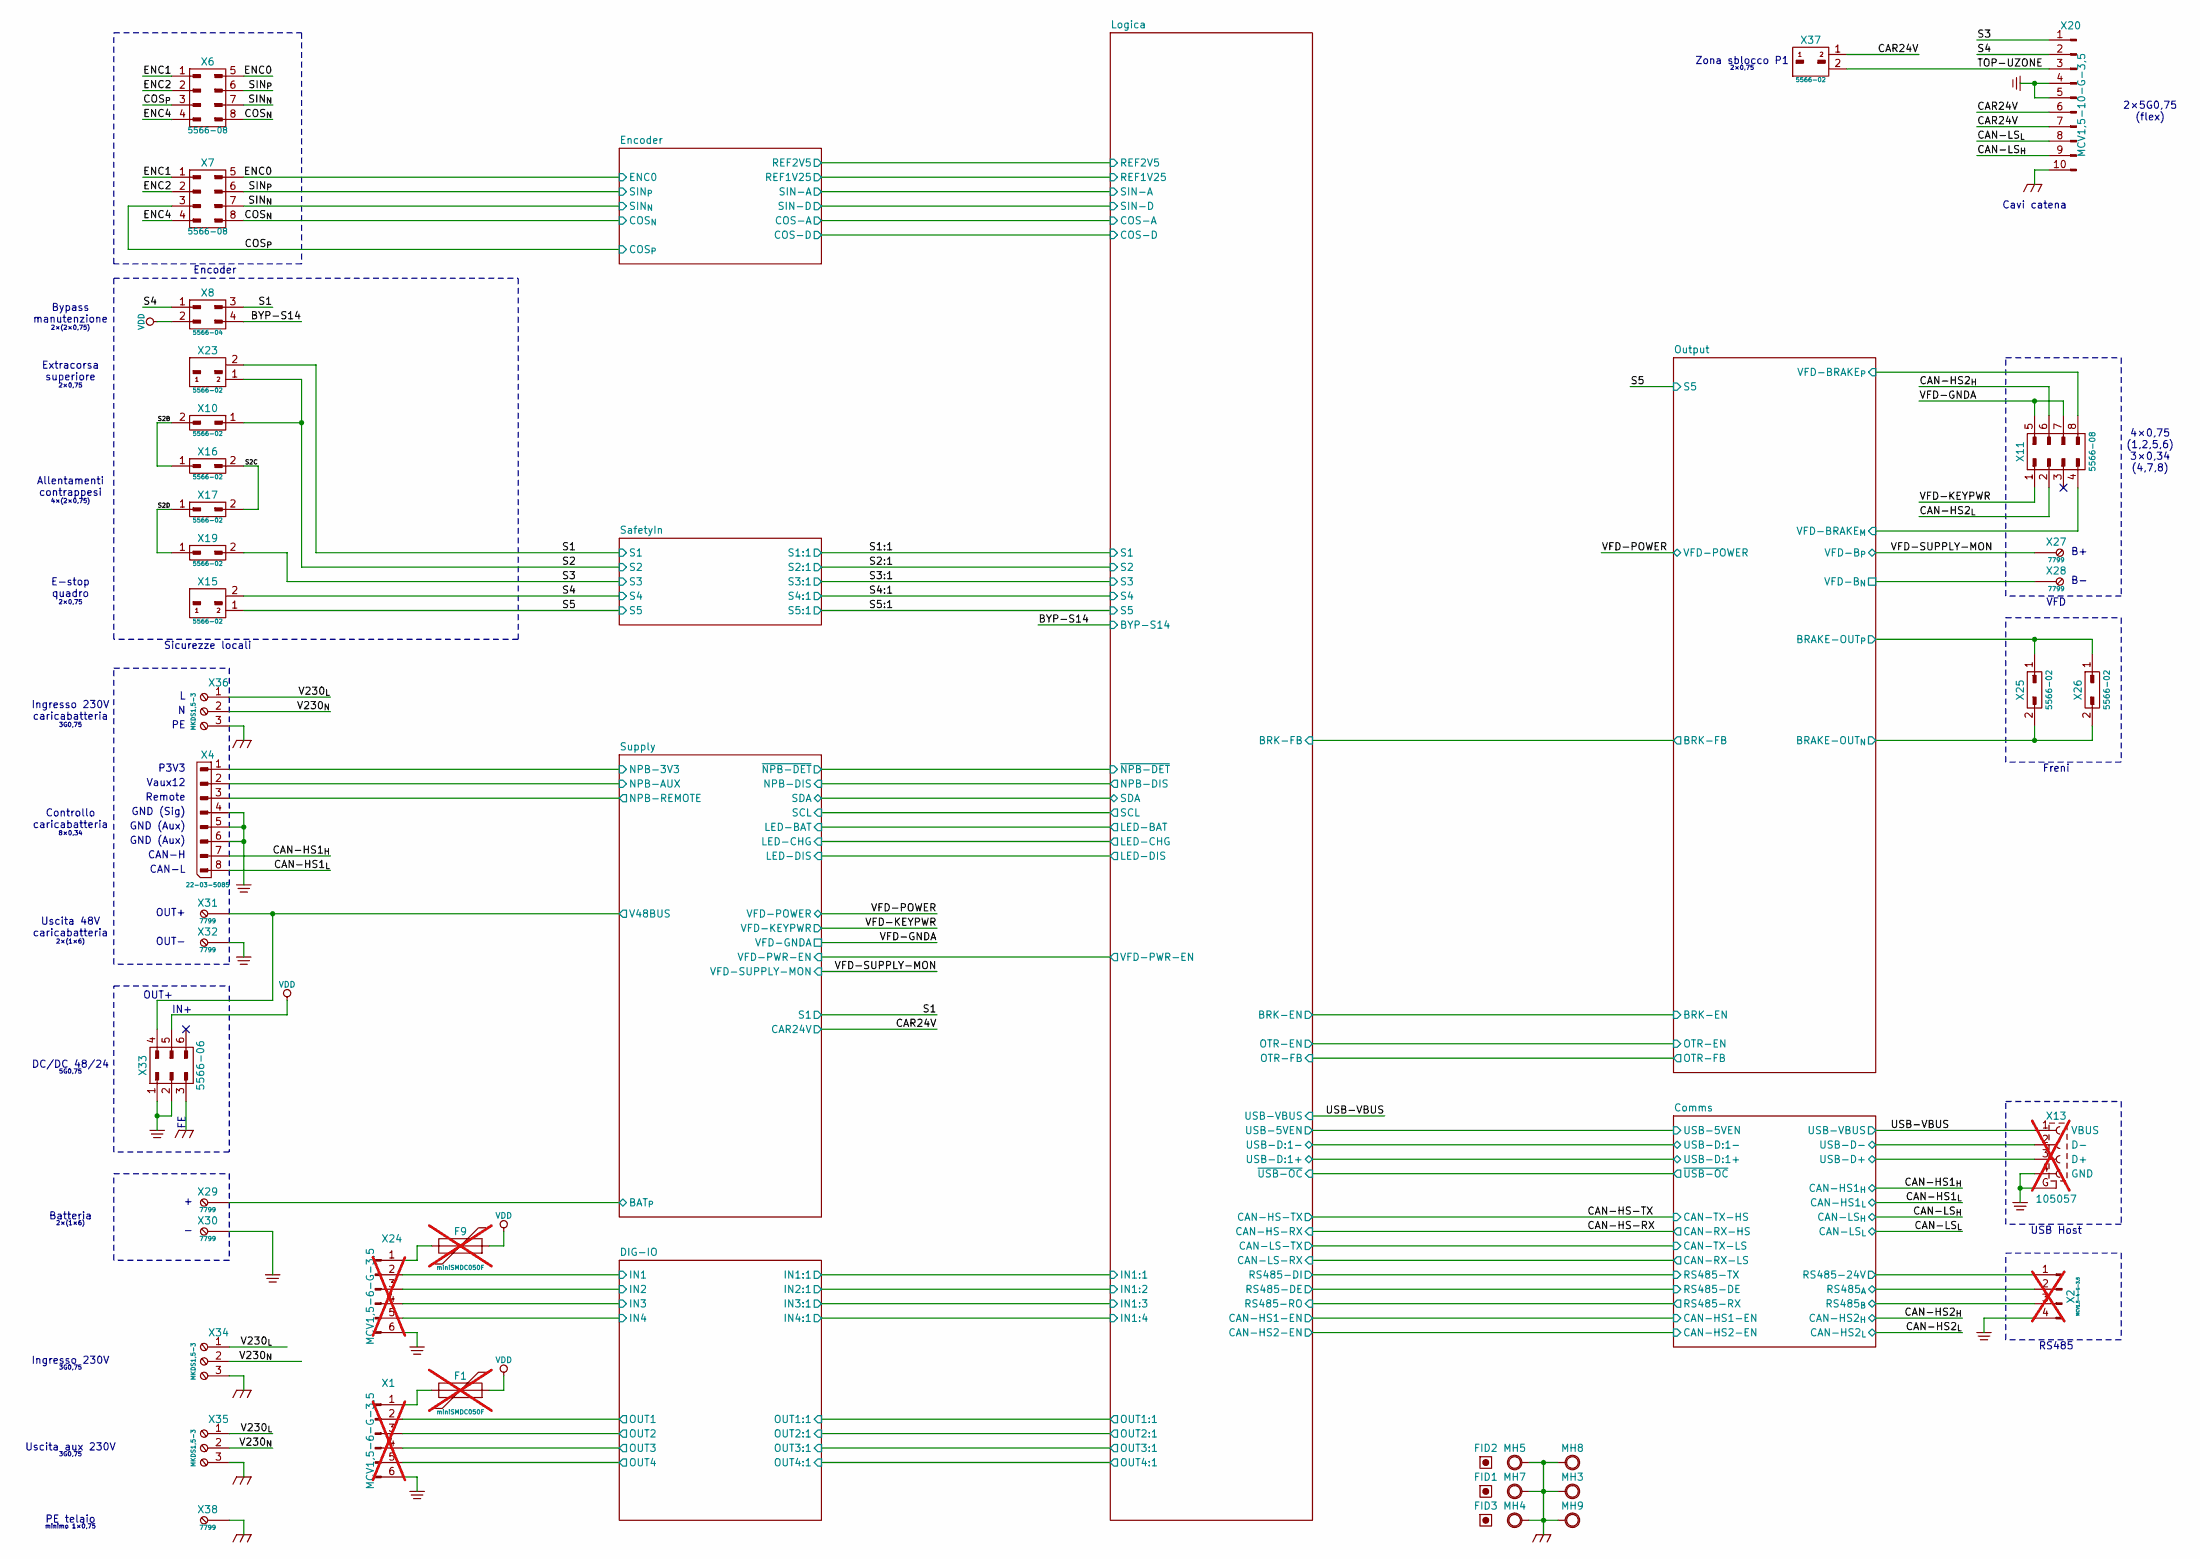
[picture p55: schematic TTF-Base.kicad_sch, Elevance - Scheda base]

Parts:
F1, F9: miniSMDC050F; miniSMDC; not fitted
FID1, FID2, FID3: Fiducial; Fid-10
MH3, MH4, MH5, MH7, MH8, MH9: Hole; Hole-M4
X1, X24: MCV1,5-6-G-3,5; not fitted
X2: MCV1,5-4-G-3,5; not fitted
X4: 22-03-5085
X6, X7, X11: 5566-08
X8: 5566-04
X10, X15, X16, X17, X19, X23, X25, X26, X37: 5566-02
X13: 105057; Molex-105057; not fitted
X20: MCV1,5-10-G-3,5
X27, X28, X29, X30, X31, X32, X38: 7799; Keystone-7799
X33: 5566-06
X34, X35, X36: MKDS1,5-3

Connections:
/BYP-S14: X8.4; also elsewhere on the board
/CAN-HS1_{H}: X4.7; also elsewhere on the board
/CAN-HS1_{L}: X4.8; also elsewhere on the board
/CAN-HS2_{H}: X11.6; also elsewhere on the board
/CAN-HS2_{L}: X11.2; also elsewhere on the board
/CAN-LS_{H}: X20.9; also elsewhere on the board
/CAN-LS_{L}: X20.8; also elsewhere on the board
/CAR24V: X20.6, X20.7, X37.1; also elsewhere on the board
/COS_{N}: X6.8, X7.8; also elsewhere on the board
/COS_{P}: X6.3, X7.3; also elsewhere on the board
/Comms/RS485-24V: X2.1; also elsewhere on the board
/Comms/RS485_{A}: X2.2; also elsewhere on the board
/Comms/RS485_{B}: X2.3; also elsewhere on the board
/Comms/USB-D+: X13.3 (D+); also elsewhere on the board
/Comms/USB-D-: X13.2 (D-); also elsewhere on the board
/DIG-IO/IN1: X24.2; also elsewhere on the board
/DIG-IO/IN2: X24.3; also elsewhere on the board
/DIG-IO/IN3: X24.4; also elsewhere on the board
/DIG-IO/IN4: X24.5; also elsewhere on the board
/DIG-IO/OUT1: X1.2; also elsewhere on the board
/DIG-IO/OUT2: X1.3; also elsewhere on the board
/DIG-IO/OUT3: X1.4; also elsewhere on the board
/DIG-IO/OUT4: X1.5; also elsewhere on the board
/ENC0: X6.5, X7.5; also elsewhere on the board
/ENC1: X6.1, X7.1
/ENC2: X6.2, X7.2
/ENC4: X6.4, X7.4
/Output/BRAKE-OUT_{N}: X25.2, X26.2; also elsewhere on the board
/Output/BRAKE-OUT_{P}: X25.1, X26.1; also elsewhere on the board
/Output/VFD-BRAKE_{M}: X11.4; also elsewhere on the board
/Output/VFD-BRAKE_{P}: X11.8; also elsewhere on the board
/Output/VFD-B_{N}: X28.1 (1_1); also elsewhere on the board
/S1: X8.3, X23.2; also elsewhere on the board
/S2: X10.1, X23.1; also elsewhere on the board
/S2B: X10.2, X16.1
/S2C: X16.2, X17.2
/S2D: X17.1, X19.1
/S3: X19.2, X20.1; also elsewhere on the board
/S4: X8.1, X15.2, X20.2; also elsewhere on the board
/S5: X15.1; also elsewhere on the board
/SIN_{N}: X6.7, X7.7; also elsewhere on the board
/SIN_{P}: X6.6, X7.6; also elsewhere on the board
/Supply/BAT_{P}: X29.1 (1_1); also elsewhere on the board
/Supply/NPB-3V3: X4.1; also elsewhere on the board
/Supply/NPB-AUX: X4.2; also elsewhere on the board
/Supply/NPB-REMOTE: X4.3; also elsewhere on the board
/Supply/V48BUS: X31.1 (1_1), X33.4; also elsewhere on the board
/TOP-UZONE: X20.3, X37.2
/USB-VBUS: X13.1 (VBUS); also elsewhere on the board
/V230_{L}: X34.1, X35.1, X36.1
/V230_{N}: X34.2, X35.2, X36.2
/VFD-GNDA: X11.5, X11.7; also elsewhere on the board
/VFD-KEYPWR: X11.1; also elsewhere on the board
/VFD-SUPPLY-MON: X27.1 (1_1); also elsewhere on the board
CHASSIS: MH3.HOLE (HOLE_HOLE), MH4.HOLE (HOLE_HOLE), MH5.HOLE (HOLE_HOLE), MH7.HOLE (HOLE_HOLE), MH8.HOLE (HOLE_HOLE), MH9.HOLE (HOLE_HOLE), X20.10, X33.3, X34.3, X35.3, X36.3, X38.1 (1_1)
GND: X1.6, X2.4, X4.4, X4.5, X4.6, X13.4 (GND), X13.G, X20.4, X20.5, X24.6, X30.1 (1_1), X32.1 (1_1), X33.1, X33.2; also elsewhere on the board
unnamed: F1.1, X1.1
unnamed: F9.1, X24.1
VDD: F1.2, F9.2, X8.2, X33.5; also elsewhere on the board

Notes on the sheet:
IN+
OUT-
4×0,75 (1,2,5,6) 3×0,34 (4,7,8)
Encoder
CAN-L
Ingresso 230V
GND (Aux)
5G0,75
PE telaio
2×(1×6)
Batteria
Allentamenti contrappesi
2×(2×0,75)
CAN-H
Extracorsa superiore
minimo 1×0,75
2×0,75
Vaux12
Freni
VFD
Ingresso 230V caricabatteria
E-stop quadro
2×5G0,75 (flex)
Bypass manutenzione
USB Host
3G0,75
Uscita aux 230V
OUT+
Zona sblocco P1
P3V3
8×0,34
RS485
DC/DC 48/24
Controllo caricabatteria
Cavi catena
Sicurezze locali
Uscita 48V caricabatteria
4×(2×0,75)
Remote
GND (Sig)

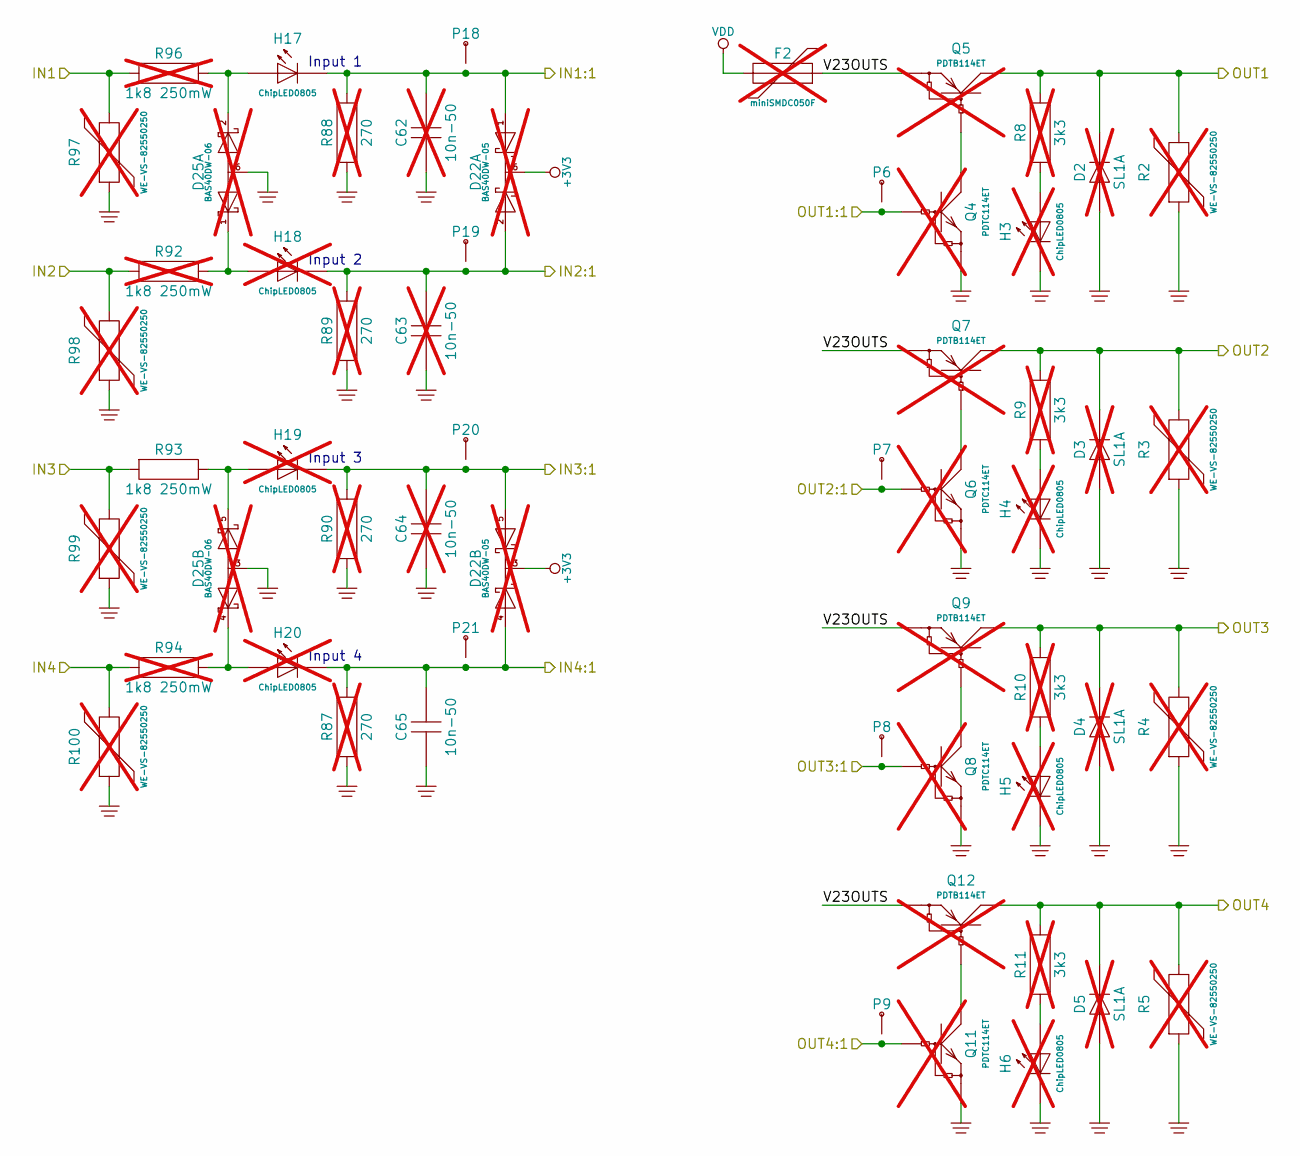
[picture p56: schematic Dig-io.kicad_sch, Elevance - Scheda base]

Parts:
C62, C63, C64: 10n-50; C0603; not fitted
C65: 10n-50; C0603
D2, D3, D4, D5: SL1A; SOD123FL; not fitted
D22: BAS40DW-05; MO203AB; not fitted
D25: BAS40DW-06; MO203AB; not fitted
F2: miniSMDC050F; miniSMDC; not fitted
H3, H4, H5, H6, H18, H19, H20: ChipLED0805; Chipled-0805; not fitted
H17: ChipLED0805; Chipled-0805
P6, P7, P8, P9, P18, P19, P20, P21: TestPoint; PinTst
Q4, Q6, Q8, Q11: PDTC114ET; TO236-BEC; not fitted
Q5, Q7, Q9, Q12: PDTB114ET; TO236-BEC; not fitted
R2, R3, R4, R5, R97, R98, R99, R100: WE-VS-82550250; WE-VS-0805; not fitted
R8, R9, R10, R11: 3k3; R1206; not fitted
R87, R88, R89, R90: 270; R0603; not fitted
R92, R94, R96: 1k8 250mW; R1206; not fitted
R93: 1k8 250mW; R1206

Connections:
+3V3: D22.3 (K), D22.6 (K); also elsewhere on the board
/DIG-IO/IN1: R96.2, R97.2; also elsewhere on the board
/DIG-IO/IN1:1: C62.2, D22.1 (A1), H17.K, P18.1 (P1_1), R88.1; also elsewhere on the board
/DIG-IO/IN2: R92.2, R98.2; also elsewhere on the board
/DIG-IO/IN2:1: C63.2, D22.2 (A2), H18.K, P19.1 (P1_1), R89.1; also elsewhere on the board
/DIG-IO/IN3: R93.2, R99.2; also elsewhere on the board
/DIG-IO/IN3:1: C64.2, D22.5 (A2), H19.K, P20.1 (P1_1), R90.1; also elsewhere on the board
/DIG-IO/IN4: R94.2, R100.2; also elsewhere on the board
/DIG-IO/IN4:1: C65.2, D22.4 (A1), H20.K, P21.1 (P1_1), R87.1; also elsewhere on the board
/DIG-IO/OUT1: D2.K, Q5.C, R2.2, R8.1; also elsewhere on the board
/DIG-IO/OUT1:1: P6.1 (P1_1), Q4.B; also elsewhere on the board
/DIG-IO/OUT2: D3.K, Q7.C, R3.2, R9.1; also elsewhere on the board
/DIG-IO/OUT2:1: P7.1 (P1_1), Q6.B; also elsewhere on the board
/DIG-IO/OUT3: D4.K, Q9.C, R4.2, R10.1; also elsewhere on the board
/DIG-IO/OUT3:1: P8.1 (P1_1), Q8.B; also elsewhere on the board
/DIG-IO/OUT4: D5.K, Q12.C, R5.2, R11.1; also elsewhere on the board
/DIG-IO/OUT4:1: P9.1 (P1_1), Q11.B; also elsewhere on the board
/DIG-IO/V23OUTS: F2.2, Q5.E, Q7.E, Q9.E, Q12.E
GND: C62.1, C63.1, C64.1, C65.1, D2.A, D3.A, D4.A, D5.A, D25.3 (A), D25.6 (A), H3.K, H4.K, H5.K, H6.K, Q4.E, Q6.E, Q8.E, Q11.E, R2.1, R3.1, R4.1, R5.1, R87.2, R88.2, R89.2, R90.2, R97.1, R98.1, R99.1, R100.1; also elsewhere on the board
unnamed: D25.1 (K1), H18.A, R92.1
unnamed: D25.2 (K2), H17.A, R96.1
unnamed: D25.4 (K1), H20.A, R94.1
unnamed: D25.5 (K2), H19.A, R93.1
unnamed: H3.A, R8.2
unnamed: H4.A, R9.2
unnamed: H5.A, R10.2
unnamed: H6.A, R11.2
unnamed: Q4.C, Q5.B
unnamed: Q6.C, Q7.B
unnamed: Q8.C, Q9.B
unnamed: Q11.C, Q12.B
VDD: F2.1; also elsewhere on the board

Notes on the sheet:
Input 2
Input 4
Input 1
Input 3

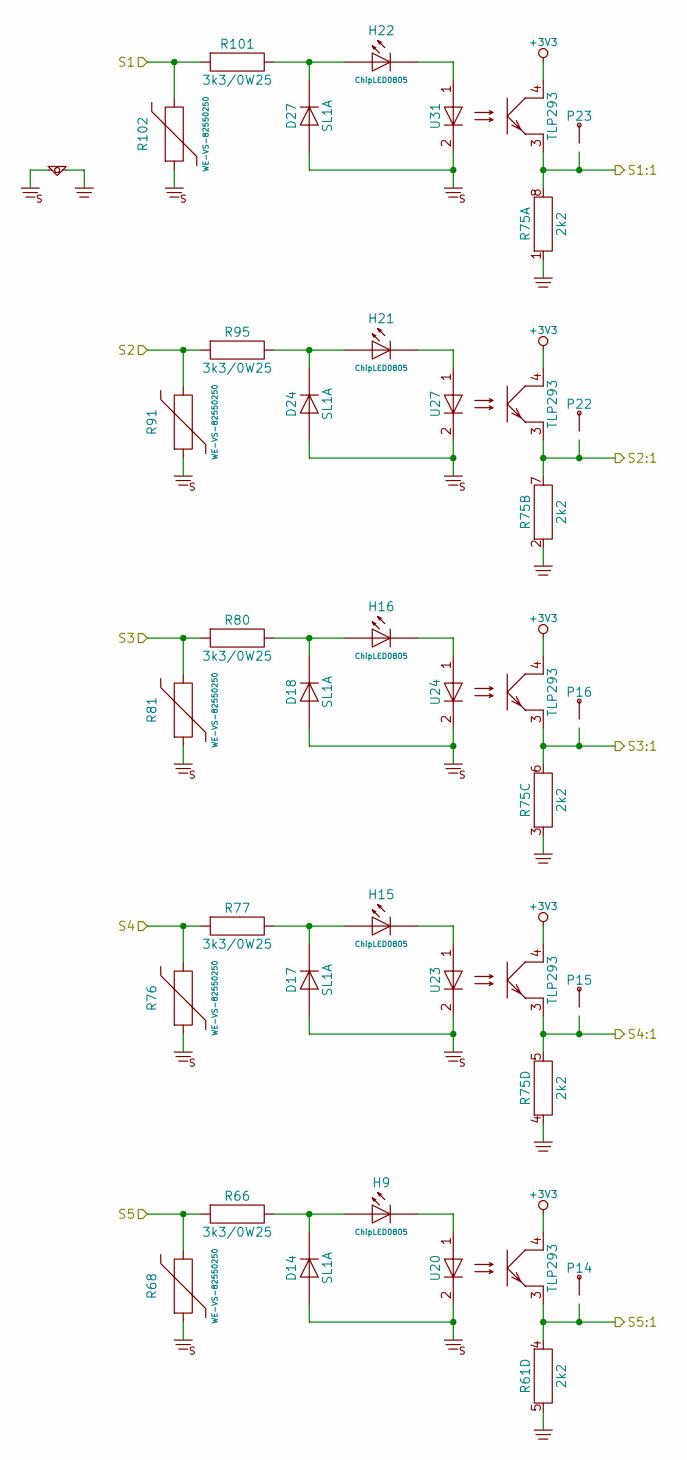
[picture p57: schematic SafetyIn.kicad_sch, Elevance - Scheda base]

Parts:
D14, D17, D18, D24, D27: SL1A; SOD123FL
EQUI3: EQUIPOT; Equipot-04
H9, H15, H16, H21, H22: ChipLED0805; Chipled-0805
P14, P15, P16, P22, P23: TestPoint; PinTst
R61, R75: 2k2; KMY-RAC164D
R66, R77, R80, R95, R101: 3k3/0W25; R1206
R68, R76, R81, R91, R102: WE-VS-82550250; WE-VS-0805
U20, U23, U24, U27, U31: TLP293; Toshiba-11-3C1

Connections:
+3V3: U20.4 (C), U23.4 (C), U24.4 (C), U27.4 (C), U31.4 (C); also elsewhere on the board
/S1: R101.2, R102.2; also elsewhere on the board
/S1:1: P23.1 (P1_1), R75.8, U31.3 (E); also elsewhere on the board
/S2: R91.2, R95.2; also elsewhere on the board
/S2:1: P22.1 (P1_1), R75.7, U27.3 (E); also elsewhere on the board
/S3: R80.2, R81.2; also elsewhere on the board
/S3:1: P16.1 (P1_1), R75.6, U24.3 (E); also elsewhere on the board
/S4: R76.2, R77.2; also elsewhere on the board
/S4:1: P15.1 (P1_1), R75.5, U23.3 (E); also elsewhere on the board
/S5: R66.2, R68.2; also elsewhere on the board
/S5:1: P14.1 (P1_1), R61.4, U20.3 (E); also elsewhere on the board
GND: EQUI3.2, R61.5, R75.1, R75.2, R75.3, R75.4; also elsewhere on the board
GNDS: D14.A, D17.A, D18.A, D24.A, D27.A, EQUI3.1, R68.1, R76.1, R81.1, R91.1, R102.1, U20.2 (K), U23.2 (K), U24.2 (K), U27.2 (K), U31.2 (K)
unnamed: D14.K, H9.A, R66.1
unnamed: D17.K, H15.A, R77.1
unnamed: D18.K, H16.A, R80.1
unnamed: D24.K, H21.A, R95.1
unnamed: D27.K, H22.A, R101.1
unnamed: H9.K, U20.1 (A)
unnamed: H15.K, U23.1 (A)
unnamed: H16.K, U24.1 (A)
unnamed: H21.K, U27.1 (A)
unnamed: H22.K, U31.1 (A)

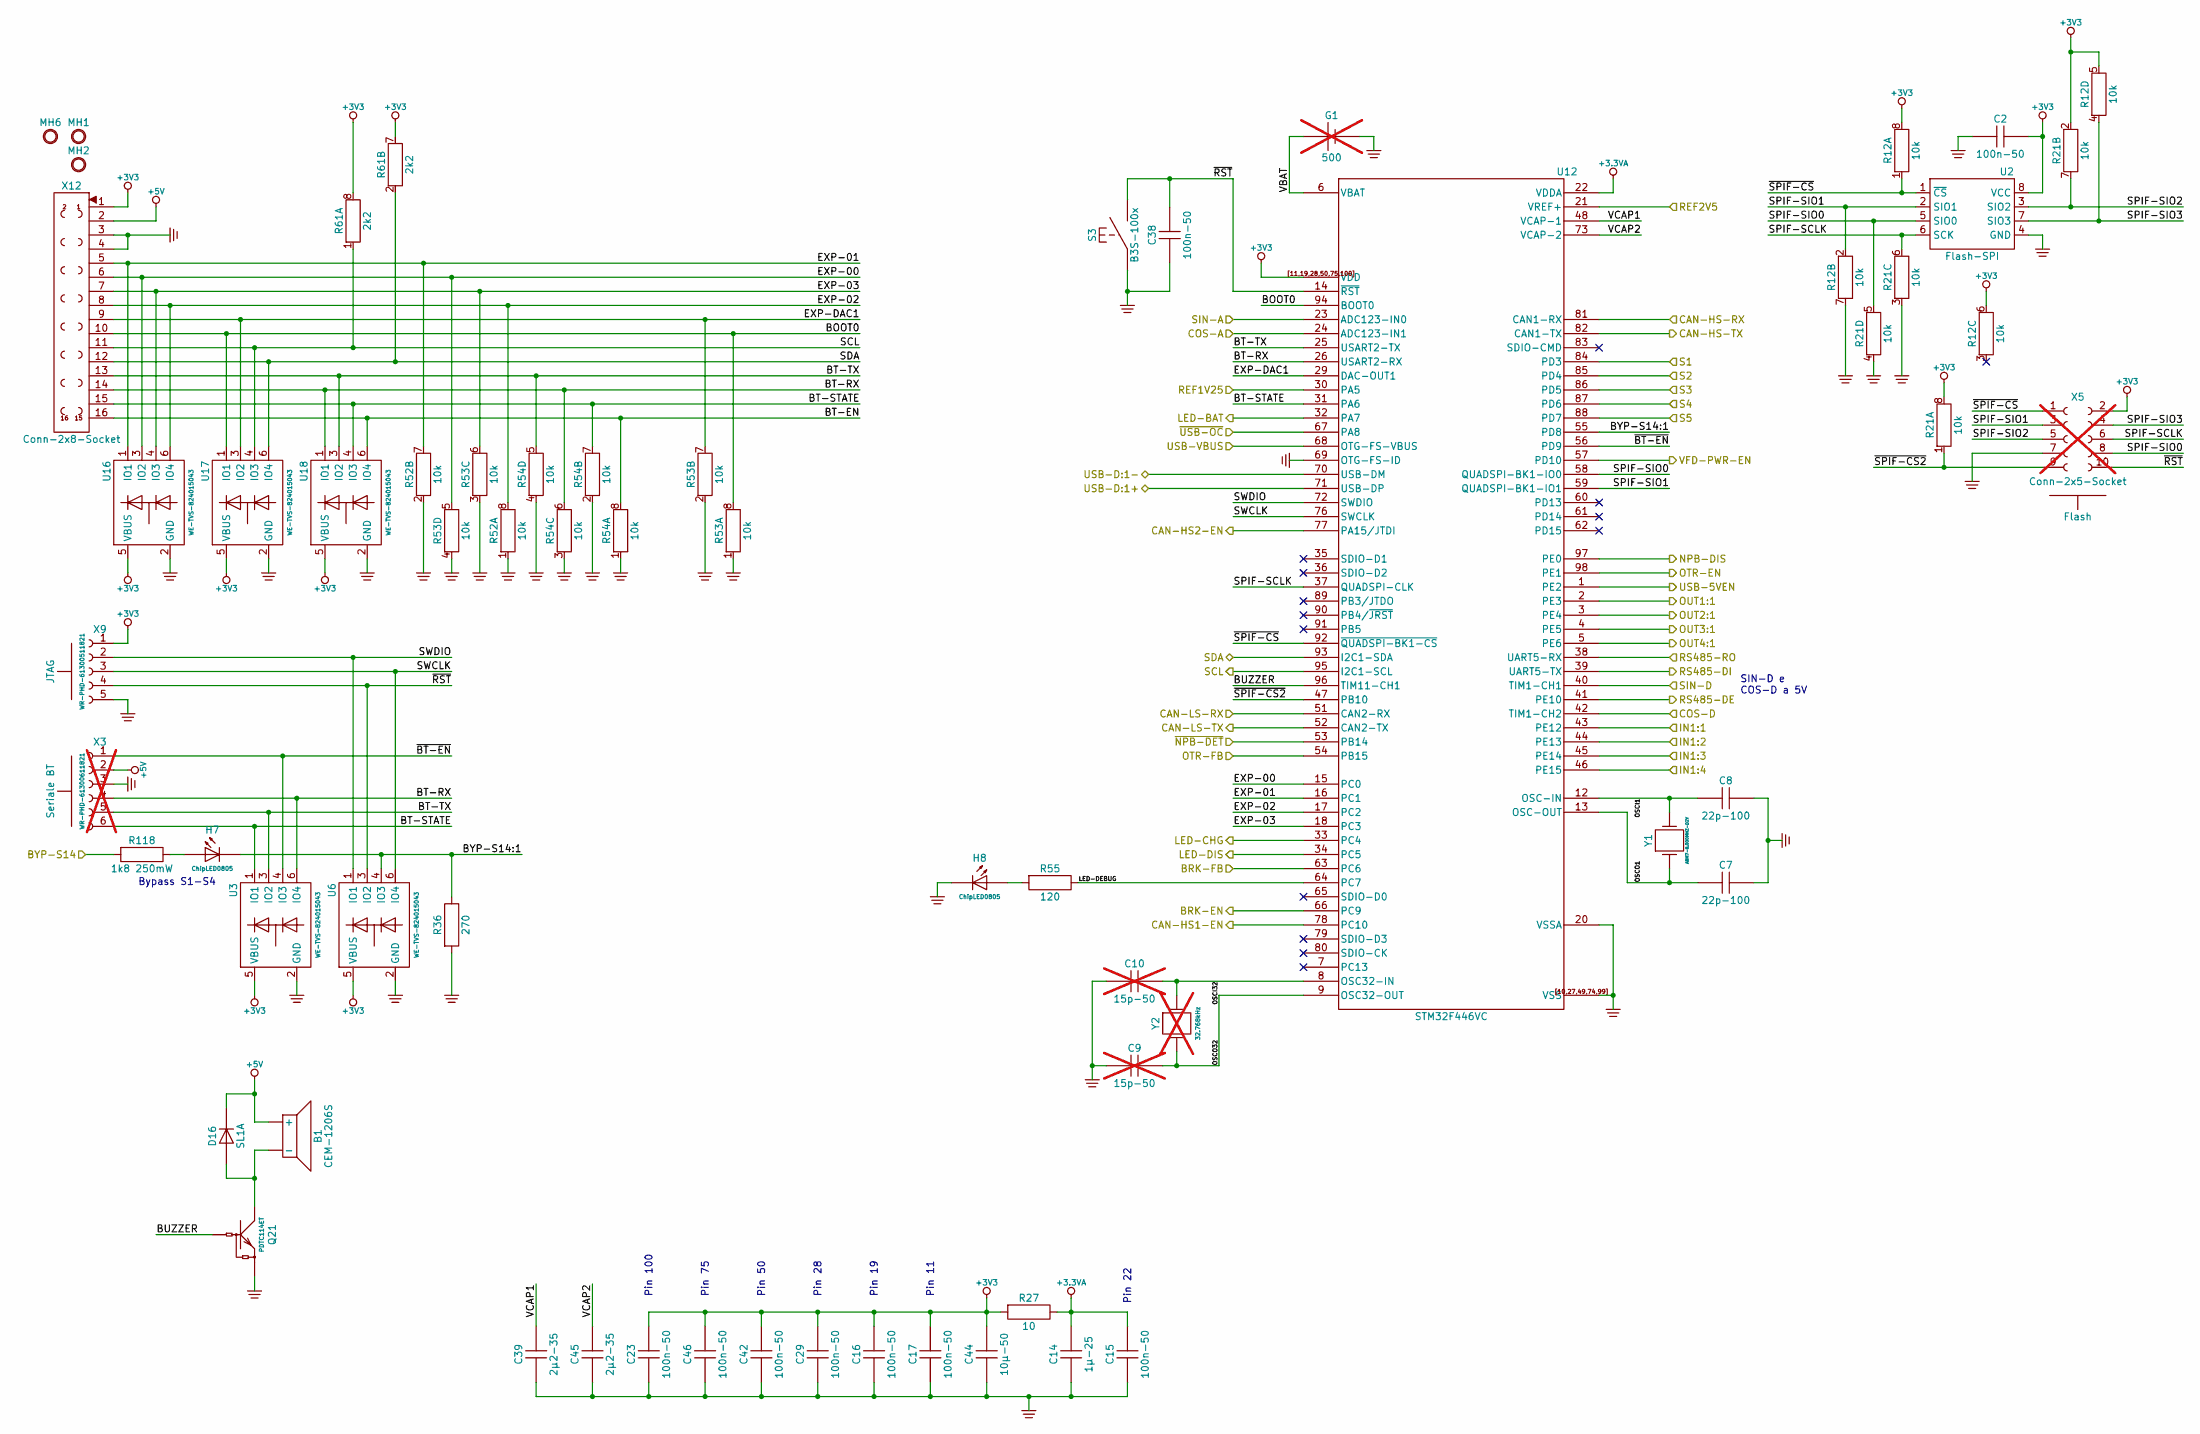
[picture p58: schematic Logica.kicad_sch, Elevance - Scheda base]

Parts:
B1: CEM-1206S; CUI-CEM-1206S
C2, C15, C16, C17, C23, C29, C38, C42, C46: 100n-50; C0603
C7, C8: 22p-100; C0603
C9, C10: 15p-50; C0603; not fitted
C14: 1µ-25; C0603
C39, C45: 2µ2-35; C0603
C44: 10µ-50; C1206
D16: SL1A; SOD123FL
G1: 500; Keystone-500; not fitted
H7, H8: ChipLED0805; Chipled-0805
MH1, MH2, MH6: Hole-M3; Hole-M3-NoPad-HeadOnly
Q21: PDTC114ET; TO236-BEC
R12, R21, R52, R53, R54: 10k; KMY-RAC164D
R27: 10; R0603
R36: 270; R0603
R55: 120; R0603
R61: 2k2; KMY-RAC164D
R118: 1k8 250mW; R1206
S3: B3S-100x; Omron-B3S-100x
U2: Flash-SPI; MS012AA+208mil
U3, U6, U16, U17, U18: WE-TVS-824015043; MO178AB
U12: STM32F446VC; MS026BED
X3: WR-PHD-61300611821; F-6; not fitted
X5: Conn-2x5-Socket; F-2x5; not fitted
X9: WR-PHD-61300511821; F-5
X12: Conn-2x8-Socket; F-2x8
Y1: ABM7-8.000MHZ-D2Y; Abracon-ABM07
Y2: 32.768kHz; Abracon-ABS07; not fitted
ZZZ4: JTAG
ZZZ5: Seriale BT
ZZZ6: Flash

Connections:
+3.3VA: C14.2, C15.2, R27.1, U12.22 (VDDA)
+3V3: C2.2, C16.2, C17.2, C23.2, C29.2, C42.2, C44.2, C46.2, R12.5, R12.6, R12.8, R21.2, R21.8, R27.2, R61.7, R61.8, U2.8 (VCC), U3.5 (VBUS), U6.5 (VBUS), U12.11 (VDD), U12.19 (VDD), U12.28 (VDD), U12.50 (VDD), U12.75 (VDD), U12.100 (VDD), U12.[11,19,28,50,75,100] (VDD), U16.5 (VBUS), U17.5 (VBUS), U18.5 (VBUS), X5.2, X9.1, X12.1; also elsewhere on the board
+5V: B1.+, D16.K, X3.2, X12.2; also elsewhere on the board
/BYP-S14: R118.2; also elsewhere on the board
/CAN-HS-RX: U12.81 (CAN1-RX); also elsewhere on the board
/CAN-HS-TX: U12.82 (CAN1-TX); also elsewhere on the board
/Comms/CAN-HS1-EN: U12.78 (PC10); also elsewhere on the board
/Comms/CAN-HS2-EN: U12.77 (PA15/JTDI); also elsewhere on the board
/Comms/CAN-RX-LS: U12.51 (CAN2-RX); also elsewhere on the board
/Comms/CAN-TX-LS: U12.52 (CAN2-TX); also elsewhere on the board
/Comms/RS485-DE: U12.41 (PE10); also elsewhere on the board
/Comms/RS485-RX: U12.38 (UART5-RX); also elsewhere on the board
/Comms/RS485-TX: U12.39 (UART5-TX); also elsewhere on the board
/Comms/USB-5VEN: U12.1 (PE2); also elsewhere on the board
/Comms/USB-D:1+: U12.71 (USB-DP); also elsewhere on the board
/Comms/USB-D:1-: U12.70 (USB-DM); also elsewhere on the board
/Comms/~USB-OC: U12.67 (PA8); also elsewhere on the board
/DIG-IO/IN1:1: U12.43 (PE12); also elsewhere on the board
/DIG-IO/IN2:1: U12.44 (PE13); also elsewhere on the board
/DIG-IO/IN3:1: U12.45 (PE14); also elsewhere on the board
/DIG-IO/IN4:1: U12.46 (PE15); also elsewhere on the board
/DIG-IO/OUT1:1: U12.2 (PE3); also elsewhere on the board
/DIG-IO/OUT2:1: U12.3 (PE4); also elsewhere on the board
/DIG-IO/OUT3:1: U12.4 (PE5); also elsewhere on the board
/DIG-IO/OUT4:1: U12.5 (PE6); also elsewhere on the board
/Encoder/COS-A: U12.24 (ADC123-IN1); also elsewhere on the board
/Encoder/COS-D: U12.42 (TIM1-CH2); also elsewhere on the board
/Encoder/REF1V25: U12.30 (PA5); also elsewhere on the board
/Encoder/REF2V5: U12.21 (VREF+); also elsewhere on the board
/Encoder/SIN-A: U12.23 (ADC123-IN0); also elsewhere on the board
/Encoder/SIN-D: U12.40 (TIM1-CH1); also elsewhere on the board
/Logica/BOOT0: R53.8, U12.94 (BOOT0), U17.1 (IO1), X12.10
/Logica/BRK-EN: U12.66 (PC9); also elsewhere on the board
/Logica/BRK-FB: U12.63 (PC6); also elsewhere on the board
/Logica/BT-EN: R54.8, U18.6 (IO4), X12.16
/Logica/BT-RX: R54.6, U3.6 (IO4), U12.26 (USART2-RX), U18.1 (IO1), X3.4, X12.14
/Logica/BT-STATE: R54.7, U3.1 (IO1), U12.31 (PA6), U18.4 (IO3), X3.6, X12.15
/Logica/BT-TX: R54.5, U3.3 (IO2), U12.25 (USART2-TX), U18.3 (IO2), X3.5, X12.13
/Logica/BUZZER: Q21.B, U12.96 (TIM11-CH1)
/Logica/BYP-S14:1: H7.K, R36.1, U6.4 (IO3), U12.55 (PD8)
/Logica/EXP-00: R53.5, U12.15 (PC0), U16.3 (IO2), X12.6
/Logica/EXP-01: R52.7, U12.16 (PC1), U16.1 (IO1), X12.5
/Logica/EXP-02: R52.8, U12.17 (PC2), U16.6 (IO4), X12.8
/Logica/EXP-03: R53.6, U12.18 (PC3), U16.4 (IO3), X12.7
/Logica/EXP-DAC1: R53.7, U12.29 (DAC-OUT1), U17.3 (IO2), X12.9
/Logica/LED-BAT: U12.32 (PA7); also elsewhere on the board
/Logica/LED-CHG: U12.33 (PC4); also elsewhere on the board
/Logica/LED-DEBUG: R55.1, U12.64 (PC7)
/Logica/LED-DIS: U12.34 (PC5); also elsewhere on the board
/Logica/NPB-DIS: U12.97 (PE0); also elsewhere on the board
/Logica/OSCI1: C8.2, U12.12 (OSC-IN), Y1.2
/Logica/OSCI32: C10.2, U12.8 (OSC32-IN), Y2.1
/Logica/OSCO1: C7.2, U12.13 (OSC-OUT), Y1.1
/Logica/OSCO32: C9.2, U12.9 (OSC32-OUT), Y2.2
/Logica/OTR-EN: U12.98 (PE1); also elsewhere on the board
/Logica/OTR-FB: U12.54 (PB15); also elsewhere on the board
/Logica/SCL: R61.1, U12.95 (I2C1-SCL), U17.4 (IO3), X12.11; also elsewhere on the board
/Logica/SDA: R61.2, U12.93 (I2C1-SDA), U17.6 (IO4), X12.12; also elsewhere on the board
/Logica/SPIF-SCLK: R21.6, U2.6 (SCK), U12.37 (QUADSPI-CLK), X5.6
/Logica/SPIF-SIO0: R21.5, U2.5 (SIO0), U12.58 (QUADSPI-BK1-IO0), X5.8
/Logica/SPIF-SIO1: R12.2, U2.2 (SIO1), U12.59 (QUADSPI-BK1-IO1), X5.3
/Logica/SPIF-SIO2: R21.7, U2.3 (SIO2), X5.5
/Logica/SPIF-SIO3: R12.4, U2.7 (SIO3), X5.4
/Logica/SWCLK: U6.6 (IO4), U12.76 (SWCLK), X9.3
/Logica/SWDIO: U6.1 (IO1), U12.72 (SWDIO), X9.2
/Logica/VBAT: G1.+, U12.6 (VBAT)
/Logica/VCAP1: C39.2, U12.48 (VCAP-1)
/Logica/VCAP2: C45.2, U12.73 (VCAP-2)
/Logica/VFD-PWR-EN: U12.57 (PD10); also elsewhere on the board
/Logica/~BT-EN: U3.4 (IO3), U12.56 (PD9), X3.1
/Logica/~NPB-DET: U12.53 (PB14); also elsewhere on the board
/Logica/~RST: C38.2, S3.14, U6.3 (IO2), U12.14 (~RST), X5.10, X9.4
/Logica/~SPIF-CS2: R21.1, U12.47 (PB10), X5.9
/Logica/~SPIF-CS: R12.1, U2.1 (~CS), U12.92 (~QUADSPI-BK1-CS), X5.1
/S1:1: U12.84 (PD3); also elsewhere on the board
/S2:1: U12.85 (PD4); also elsewhere on the board
/S3:1: U12.86 (PD5); also elsewhere on the board
/S4:1: U12.87 (PD6); also elsewhere on the board
/S5:1: U12.88 (PD7); also elsewhere on the board
/USB-VBUS: U12.68 (OTG-FS-VBUS); also elsewhere on the board
GND: C2.1, C7.1, C8.1, C9.1, C10.1, C14.1, C15.1, C16.1, C17.1, C23.1, C29.1, C38.1, C39.1, C42.1, C44.1, C45.1, C46.1, G1.-, H8.K, Q21.E, R12.7, R21.3, R21.4, R36.2, R52.1, R52.2, R53.1, R53.2, R53.3, R53.4, R54.1, R54.2, R54.3, R54.4, S3.13, U2.4 (GND), U3.2 (GND), U6.2 (GND), U12.10 (VSS), U12.20 (VSSA), U12.27 (VSS), U12.49 (VSS), U12.69 (OTG-FS-ID), U12.74 (VSS), U12.99 (VSS), U12.[10,27,49,74,99] (VSS), U16.2 (GND), U17.2 (GND), U18.2 (GND), X3.3, X5.7, X9.5, X12.3, X12.4; also elsewhere on the board
unnamed: B1.-, D16.A, Q21.C
unnamed: H7.A, R118.1
unnamed: H8.A, R55.2

Notes on the sheet:
Pin 28
SIN-D e COS-D a 5V
Pin 19
Pin 75
Pin 11
Pin 100
Pin 50
Pin 22
Bypass S1-S4
