dermatoid-collab/EVC_FW/TTF-Base/TTF-Base.kicad_pcb

## KiCad design TTF-Base/TTF-Base.kicad_pcb (continued)

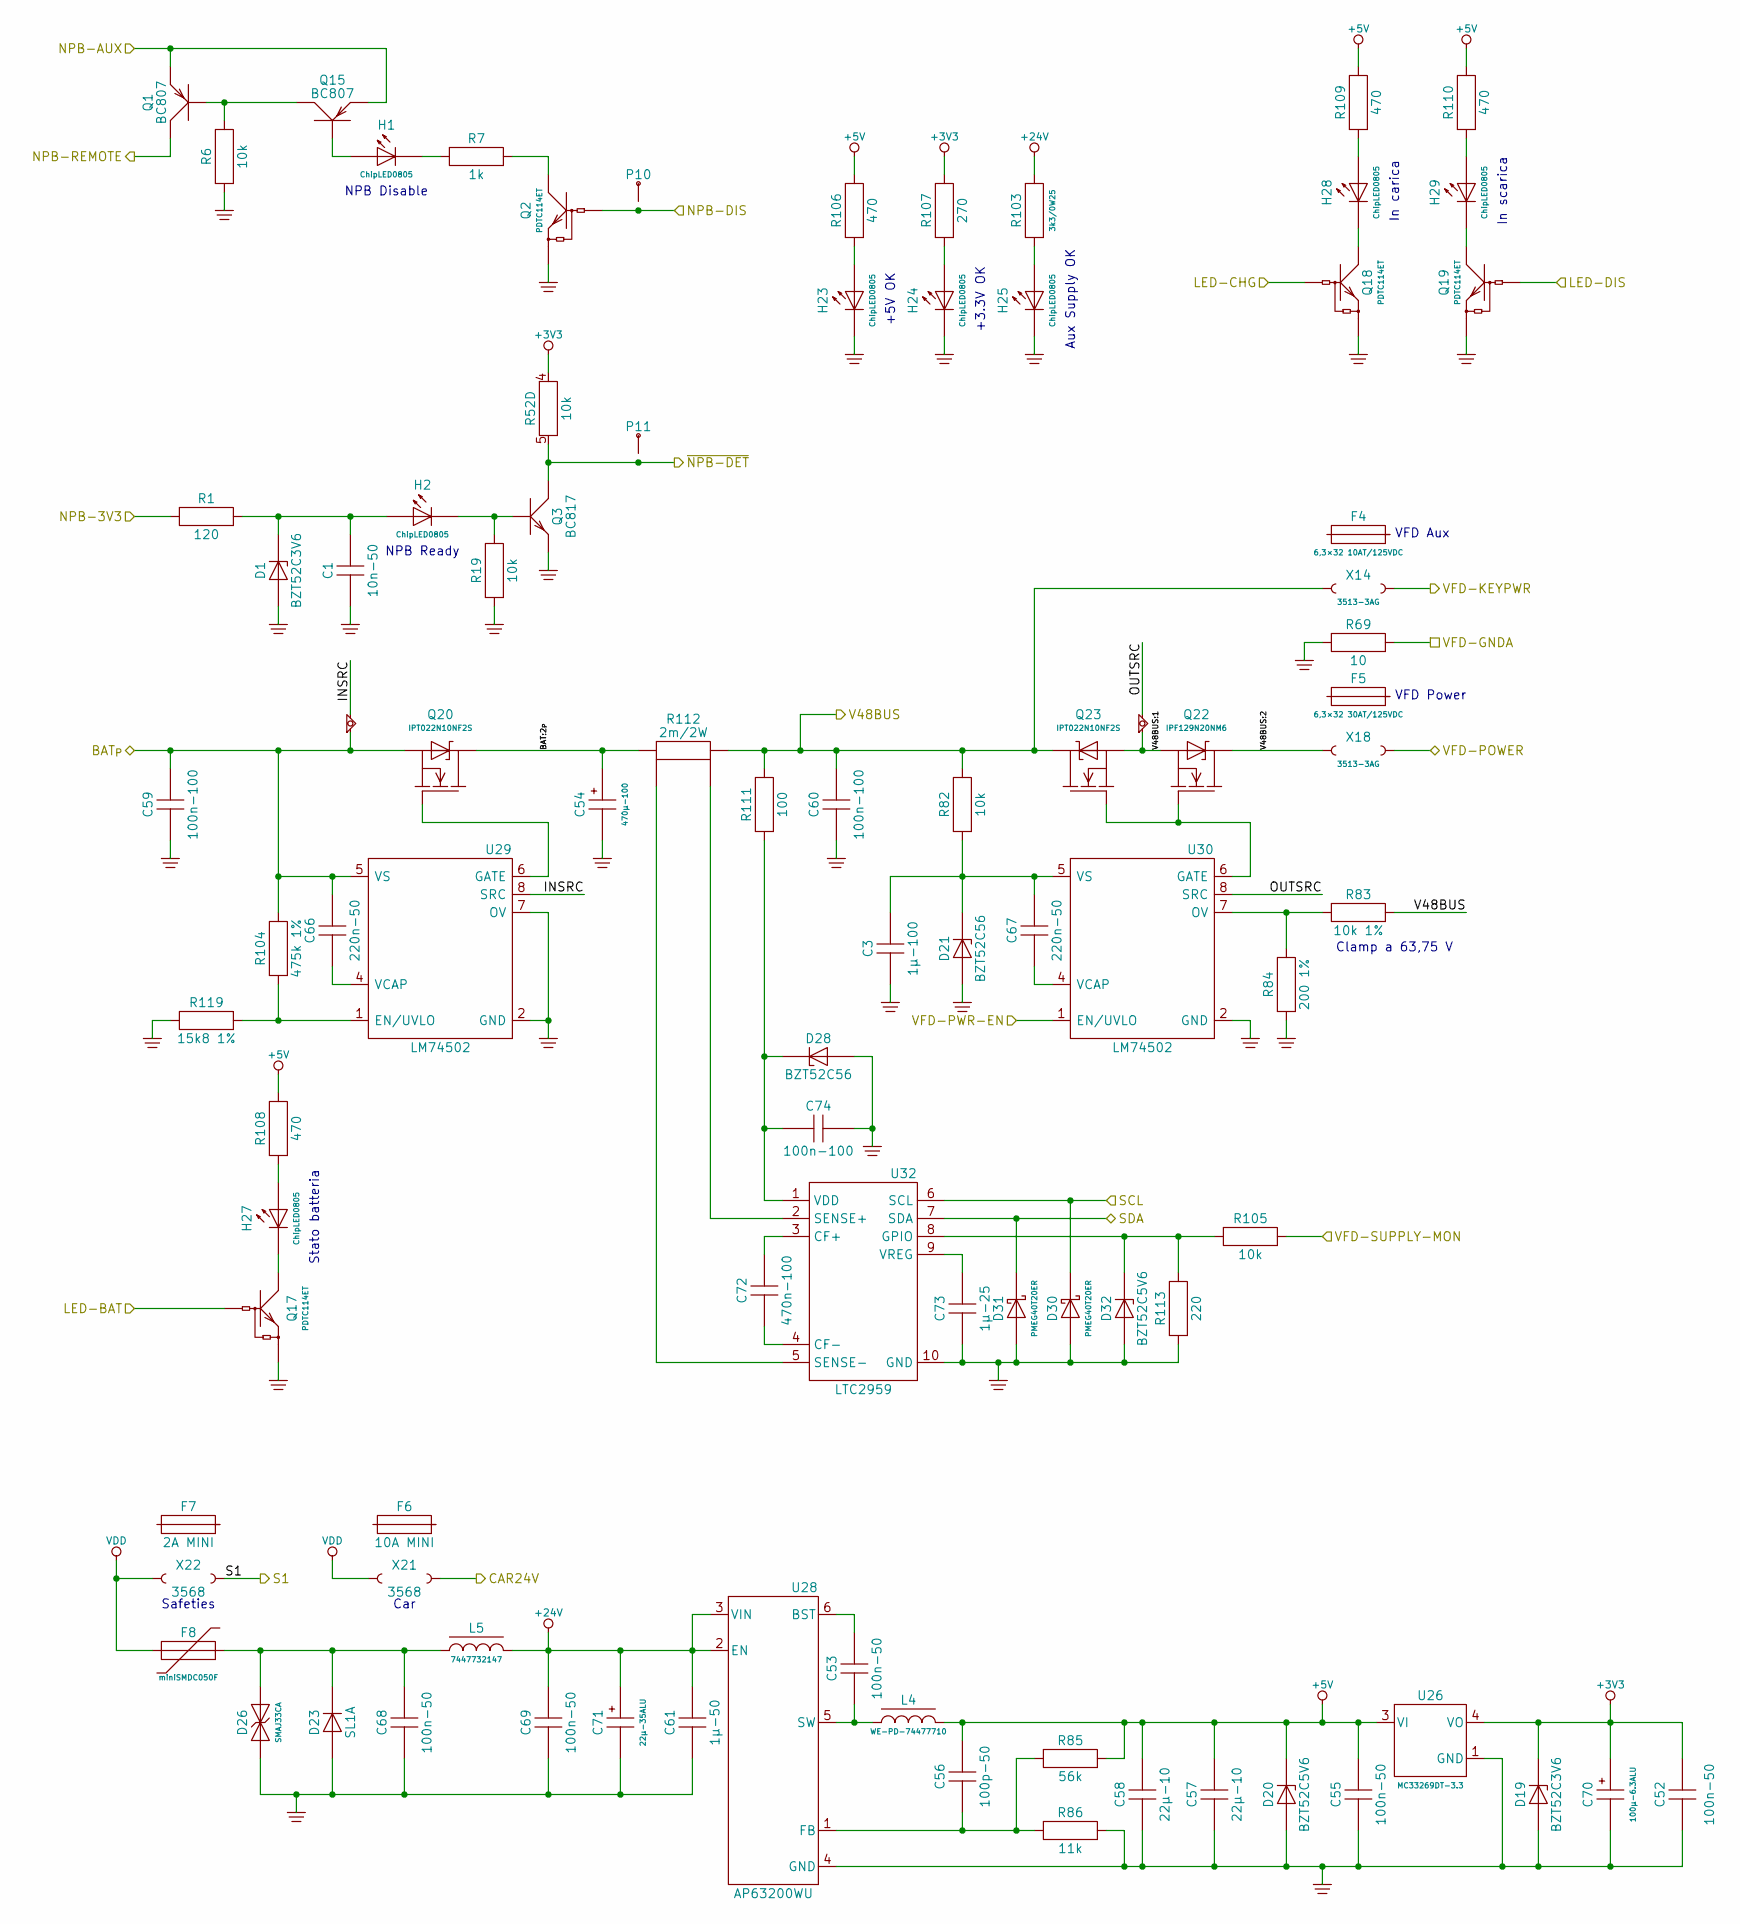
[picture p59: schematic Supply.kicad_sch, Elevance - Scheda base]

Parts:
C1: 10n-50; C0603
C3: 1µ-100; C1206
C52, C53, C55, C68, C69: 100n-50; C0603
C54: 470µ-100; CPAlu-12.5x25P5
C56: 100p-50; C0603
C57, C58: 22µ-10; C0805
C59, C60, C74: 100n-100; C1206
C61: 1µ-50; C1206
C66, C67: 220n-50; C0603
C70: 100µ-6.3ALU; CPV-5x5.5
C71: 22µ-35ALU; CPV-5x5.5
C72: 470n-100; C0805
C73: 1µ-25; C0603
D1, D19: BZT52C3V6; SOD123
D20, D32: BZT52C5V6; SOD123
D21, D28: BZT52C56; SOD123
D23: SL1A; SOD123FL
D26: SMAJ33CA; DO214AC-NPOL
D30, D31: PMEG40T20ER; NXP-SOD123W
EQUI1, EQUI4: EQUIPOT; Equipot-04
F4: 6,3×32 10AT/125VDC; 3AG-Fuse
F5: 6,3×32 30AT/125VDC; 3AG-Fuse
F6: 10A MINI; MINI-Fuse
F7: 2A MINI; MINI-Fuse
F8: miniSMDC050F; miniSMDC
H1, H2, H23, H24, H25, H27, H28, H29: ChipLED0805; Chipled-0805
L4: WE-PD-74477710; WE-PD-7345A
L5: 7447732147; WE-PD2-3521
P10, P11: TestPoint; PinTst
Q1, Q15: BC807; TO236-BEC
Q2, Q17, Q18, Q19: PDTC114ET; TO236-BEC
Q3: BC817; TO236-BEC
Q20, Q23: IPT022N10NF2S; Infineon-PG-HSOF-8-10
Q22: IPF129N20NM6; Infineon-TO263-7-GSSxSSSD
R1: 120; R0603
R6, R19, R82, R105: 10k; R0603
R7: 1k; R0603
R52: 10k; KMY-RAC164D
R69: 10; R0603
R83: 10k 1%; R0603
R84: 200 1%; R0603
R85: 56k; R0603
R86: 11k; R0603
R103: 3k3/0W25; R1206
R104: 475k 1%; R0603
R106, R108, R109, R110: 470; R0603
R107: 270; R0603
R111: 100; R0603
R112: 2m/2W; R2512K
R113: 220; R0603
R119: 15k8 1%; R0603
U26: MC33269DT-3.3; TO252AA
U28: AP63200WU; MO193AA
U29, U30: LM74502; MO193BA
U32: LTC2959; MO229W3020D2-NOPAD
X14, X18: 3513-3AG; Keystone-3513-3AG
X21, X22: 3568; Keystone-3568

Connections:
+3V3: C52.2, C70.+, D19.K, R52.4, R107.1, U26.4 (VO); also elsewhere on the board
+5V: C55.2, C56.2, C57.2, C58.2, D20.K, L4.2, R85.1, R106.1, R108.1, R109.1, R110.1, U26.3 (VI); also elsewhere on the board
+24V: C61.2, C69.2, C71.+, L5.2, R103.2, U28.2 (EN), U28.3 (VIN); also elsewhere on the board
/CAR24V: X21.2; also elsewhere on the board
/Logica/LED-BAT: Q17.B; also elsewhere on the board
/Logica/LED-CHG: Q18.B; also elsewhere on the board
/Logica/LED-DIS: Q19.B; also elsewhere on the board
/Logica/NPB-DIS: P10.1 (P1_1), Q2.B; also elsewhere on the board
/Logica/SCL: D30.K, U32.6 (SCL); also elsewhere on the board
/Logica/SDA: D31.K, U32.7 (SDA); also elsewhere on the board
/Logica/VFD-PWR-EN: U30.1 (EN/UVLO); also elsewhere on the board
/Logica/~NPB-DET: P11.1 (P1_1), Q3.C, R52.5; also elsewhere on the board
/S1: X22.2; also elsewhere on the board
/Supply/BAT:2_{P}: C54.+, Q20.D, R112.2
/Supply/BAT_{P}: C59.2, C66.2, EQUI1.1, Q20.S, R104.1, U29.5 (VS); also elsewhere on the board
/Supply/INSRC: EQUI1.2, U29.8 (SRC)
/Supply/NPB-3V3: R1.2; also elsewhere on the board
/Supply/NPB-AUX: Q1.E, Q15.E; also elsewhere on the board
/Supply/NPB-REMOTE: Q1.C; also elsewhere on the board
/Supply/OUTSRC: EQUI4.2, U30.8 (SRC)
/Supply/V48BUS: C60.2, Q23.D, R82.1, R83.1, R111.1, R112.1, X14.1; also elsewhere on the board
/Supply/V48BUS:1: EQUI4.1, Q22.S, Q23.S
/Supply/V48BUS:2: Q22.D, X18.1
/VFD-GNDA: R69.1; also elsewhere on the board
/VFD-KEYPWR: X14.2; also elsewhere on the board
/VFD-POWER: X18.2; also elsewhere on the board
/VFD-SUPPLY-MON: R105.1; also elsewhere on the board
GND: C1.1, C3.1, C52.1, C54.-, C55.1, C57.1, C58.1, C59.1, C60.1, C61.1, C68.1, C69.1, C70.-, C71.-, C73.1, C74.2, D1.A, D19.A, D20.A, D21.A, D23.A, D26.1, D28.A, D30.A, D31.A, D32.A, H23.K, H24.K, H25.K, Q2.E, Q3.E, Q17.E, Q18.E, Q19.E, R6.2, R19.2, R69.2, R84.2, R86.1, R113.2, R119.1, U26.1 (GND), U28.4 (GND), U29.2 (GND), U29.7 (OV), U30.2 (GND), U32.10 (GND); also elsewhere on the board
unnamed: C1.2, D1.K, H2.A, R1.1
unnamed: C68.2, D23.K, D26.2, F8.2, L5.1
unnamed: H1.A, Q15.B
unnamed: H1.K, R7.2
unnamed: H2.K, Q3.B, R19.1
unnamed: H23.A, R106.2
unnamed: H24.A, R107.2
unnamed: H25.A, R103.1
unnamed: H27.A, R108.2
unnamed: H27.K, Q17.C
unnamed: H28.A, R109.2
unnamed: H28.K, Q18.C
unnamed: H29.A, R110.2
unnamed: H29.K, Q19.C
unnamed: Q1.B, Q15.C, R6.1
unnamed: Q2.C, R7.1
unnamed: C53.2, U28.6 (BST)
unnamed: C56.1, R85.2, R86.2, U28.1 (FB)
unnamed: C53.1, L4.1, U28.5 (SW)
unnamed: R104.2, R119.2, U29.1 (EN/UVLO)
unnamed: Q20.G, U29.6 (GATE)
unnamed: C66.1, U29.4 (VCAP)
unnamed: Q22.G, Q23.G, U30.6 (GATE)
unnamed: R83.2, R84.1, U30.7 (OV)
unnamed: C67.1, U30.4 (VCAP)
unnamed: C3.2, C67.2, D21.K, R82.2, U30.5 (VS)
unnamed: C72.2, U32.3 (CF+)
unnamed: C72.1, U32.4 (CF-)
unnamed: D32.K, R105.2, R113.1, U32.8 (GPIO)
unnamed: R112.3, U32.2 (SENSE+)
unnamed: R112.4, U32.5 (SENSE-)
unnamed: C74.1, D28.K, R111.2, U32.1 (VDD)
unnamed: C73.2, U32.9 (VREG)
VDD: F8.1, X21.1, X22.1; also elsewhere on the board

Notes on the sheet:
NPB Disable
Safeties
Clamp a 63,75 V
+3.3V OK
VFD Power
NPB Ready
+5V OK
Aux Supply OK
Stato batteria
Car
In scarica
VFD Aux
In carica

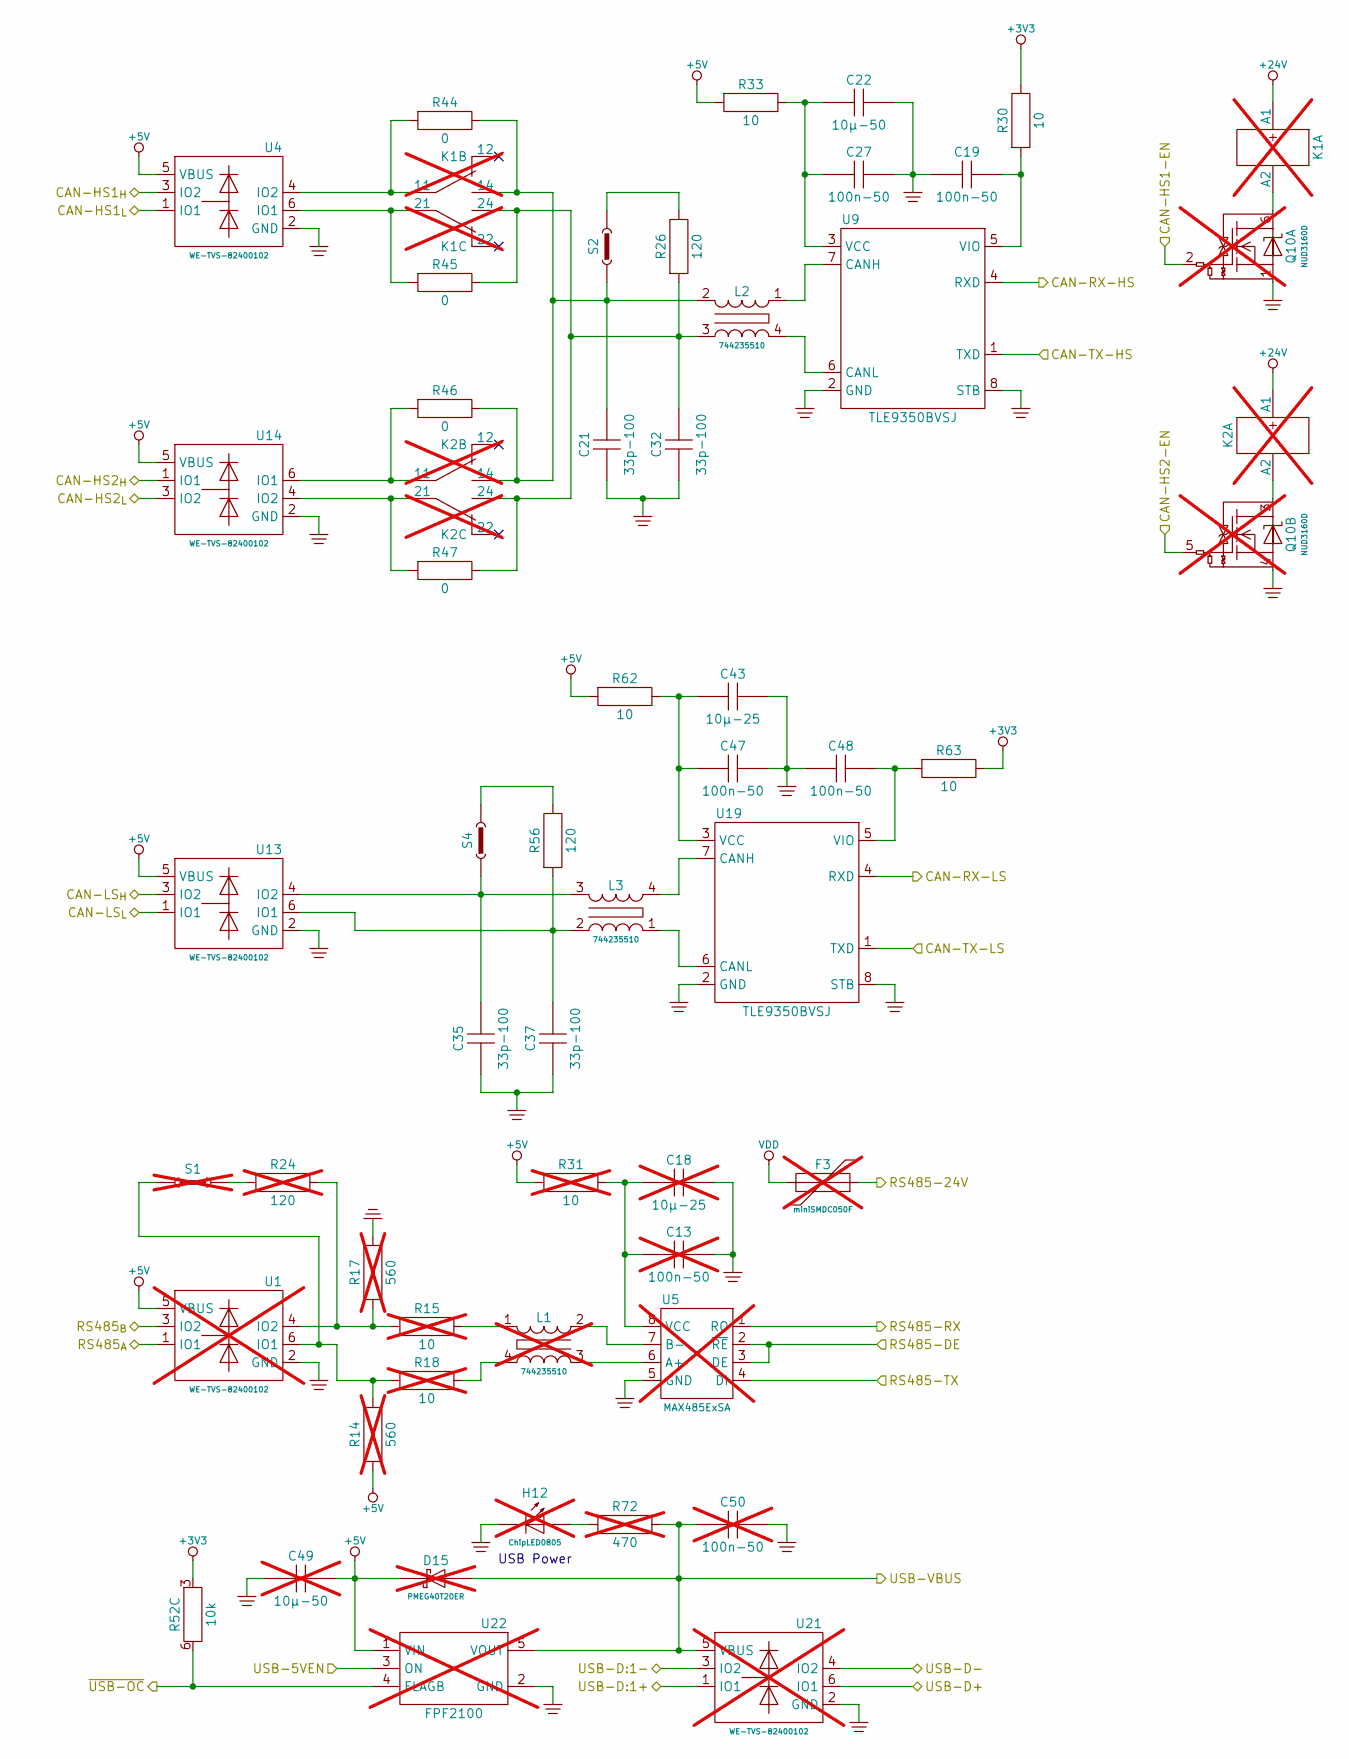
[picture p60: schematic Comms.kicad_sch, Elevance - Scheda base]

Parts:
C13, C50: 100n-50; C0603; not fitted
C18: 10µ-25; C0805; not fitted
C19, C27, C47, C48: 100n-50; C0603
C21, C32, C35, C37: 33p-100; C0603
C22: 10µ-50; C1206
C43: 10µ-25; C0805
C49: 10µ-50; C1206; not fitted
D15: PMEG40T20ER; NXP-SOD123W; not fitted
F3: miniSMDC050F; miniSMDC; not fitted
H12: ChipLED0805; Chipled-0805; not fitted
K1, K2: AGN20024; Panasonic-AGN200; not fitted
L1: 744235510; WE-CNSW-1812; not fitted
L2, L3: 744235510; WE-CNSW-1812
Q10: NUD3160D; MO193AA; not fitted
R14, R17: 560; R0603; not fitted
R15, R18, R31: 10; R0603; not fitted
R24: 120; R1210; not fitted
R26, R56: 120; R1210
R30, R33, R62, R63: 10; R0603
R44, R45, R46, R47: 0; R0603
R52: 10k; KMY-RAC164D
R72: 470; R0603; not fitted
S1: Jumper-2.54; not fitted
S2, S4: Jumper-2.54
U1, U21: WE-TVS-82400102; MO178AB; not fitted
U4, U13, U14: WE-TVS-82400102; MO178AB
U5: MAX485ExSA; MS012AA; not fitted
U9, U19: TLE9350BVSJ; MS012AA
U22: FPF2100; MO178AA; not fitted

Connections:
+3V3: R30.1, R52.3, R63.1; also elsewhere on the board
+5V: C49.2, D15.K, R14.2, R31.2, R33.2, R62.2, U1.5 (VBUS), U4.5 (VBUS), U13.5 (VBUS), U14.5 (VBUS), U22.1 (VIN); also elsewhere on the board
+24V: K1.A1, K2.A1; also elsewhere on the board
/CAN-HS1_{H}: U4.3 (IO2); also elsewhere on the board
/CAN-HS1_{L}: U4.1 (IO1); also elsewhere on the board
/CAN-HS2_{H}: U14.1 (IO1); also elsewhere on the board
/CAN-HS2_{L}: U14.3 (IO2); also elsewhere on the board
/CAN-HS-RX: U9.4 (RXD); also elsewhere on the board
/CAN-HS-TX: U9.1 (TXD); also elsewhere on the board
/CAN-LS_{H}: U13.3 (IO2); also elsewhere on the board
/CAN-LS_{L}: U13.1 (IO1); also elsewhere on the board
/Comms/CAN-HS1-EN: Q10.2 (G); also elsewhere on the board
/Comms/CAN-HS2-EN: Q10.5 (G); also elsewhere on the board
/Comms/CAN-RX-LS: U19.4 (RXD); also elsewhere on the board
/Comms/CAN-TX-LS: U19.1 (TXD); also elsewhere on the board
/Comms/RS485-24V: F3.2; also elsewhere on the board
/Comms/RS485-DE: U5.2 (~RE), U5.3 (DE); also elsewhere on the board
/Comms/RS485-RX: U5.1 (RO); also elsewhere on the board
/Comms/RS485-TX: U5.4 (DI); also elsewhere on the board
/Comms/RS485_{A}: U1.1 (IO1); also elsewhere on the board
/Comms/RS485_{B}: U1.3 (IO2); also elsewhere on the board
/Comms/USB-5VEN: U22.3 (ON); also elsewhere on the board
/Comms/USB-D+: U21.6 (IO1); also elsewhere on the board
/Comms/USB-D-: U21.4 (IO2); also elsewhere on the board
/Comms/USB-D:1+: U21.1 (IO1); also elsewhere on the board
/Comms/USB-D:1-: U21.3 (IO2); also elsewhere on the board
/Comms/~USB-OC: R52.6, U22.4 (FLAGB); also elsewhere on the board
/USB-VBUS: C50.1, D15.A, R72.1, U21.5 (VBUS), U22.5 (VOUT); also elsewhere on the board
GND: C13.2, C18.2, C19.2, C21.1, C22.1, C27.1, C32.1, C35.1, C37.1, C43.2, C47.1, C48.2, C49.1, C50.2, H12.K, Q10.1 (4), Q10.4, R17.1, U1.2 (GND), U4.2 (GND), U5.5 (GND), U9.2 (GND), U9.8 (STB), U13.2 (GND), U14.2 (GND), U19.2 (GND), U19.8 (STB), U21.2 (GND), U22.2 (GND); also elsewhere on the board
unnamed: C21.2, K1.14, K2.14, L2.2, R44.1, R46.1, S2.1
unnamed: C32.2, K1.24, K2.24, L2.3, R26.2, R45.1, R47.1
unnamed: H12.A, R72.2
unnamed: K2.11, R46.2, U14.6 (IO1)
unnamed: K2.21, R47.2, U14.4 (IO2)
unnamed: L1.1, R15.1
unnamed: L1.4, R18.1
unnamed: K1.A2, Q10.6 (D)
unnamed: K2.A2, Q10.3 (D)
unnamed: R24.2, S1.1
unnamed: R26.1, S2.2
unnamed: R56.1, S4.2
unnamed: L1.3, U5.6 (A+)
unnamed: L1.2, U5.7 (B-)
unnamed: C13.1, C18.1, R31.1, U5.8 (VCC)
unnamed: L2.1, U9.7 (CANH)
unnamed: L2.4, U9.6 (CANL)
unnamed: C22.2, C27.2, R33.1, U9.3 (VCC)
unnamed: C19.1, R30.2, U9.5 (VIO)
unnamed: L3.4, U19.7 (CANH)
unnamed: L3.1, U19.6 (CANL)
unnamed: C43.1, C47.2, R62.1, U19.3 (VCC)
unnamed: C48.1, R63.2, U19.5 (VIO)
VDD: F3.1; also elsewhere on the board

Notes on the sheet:
USB Power

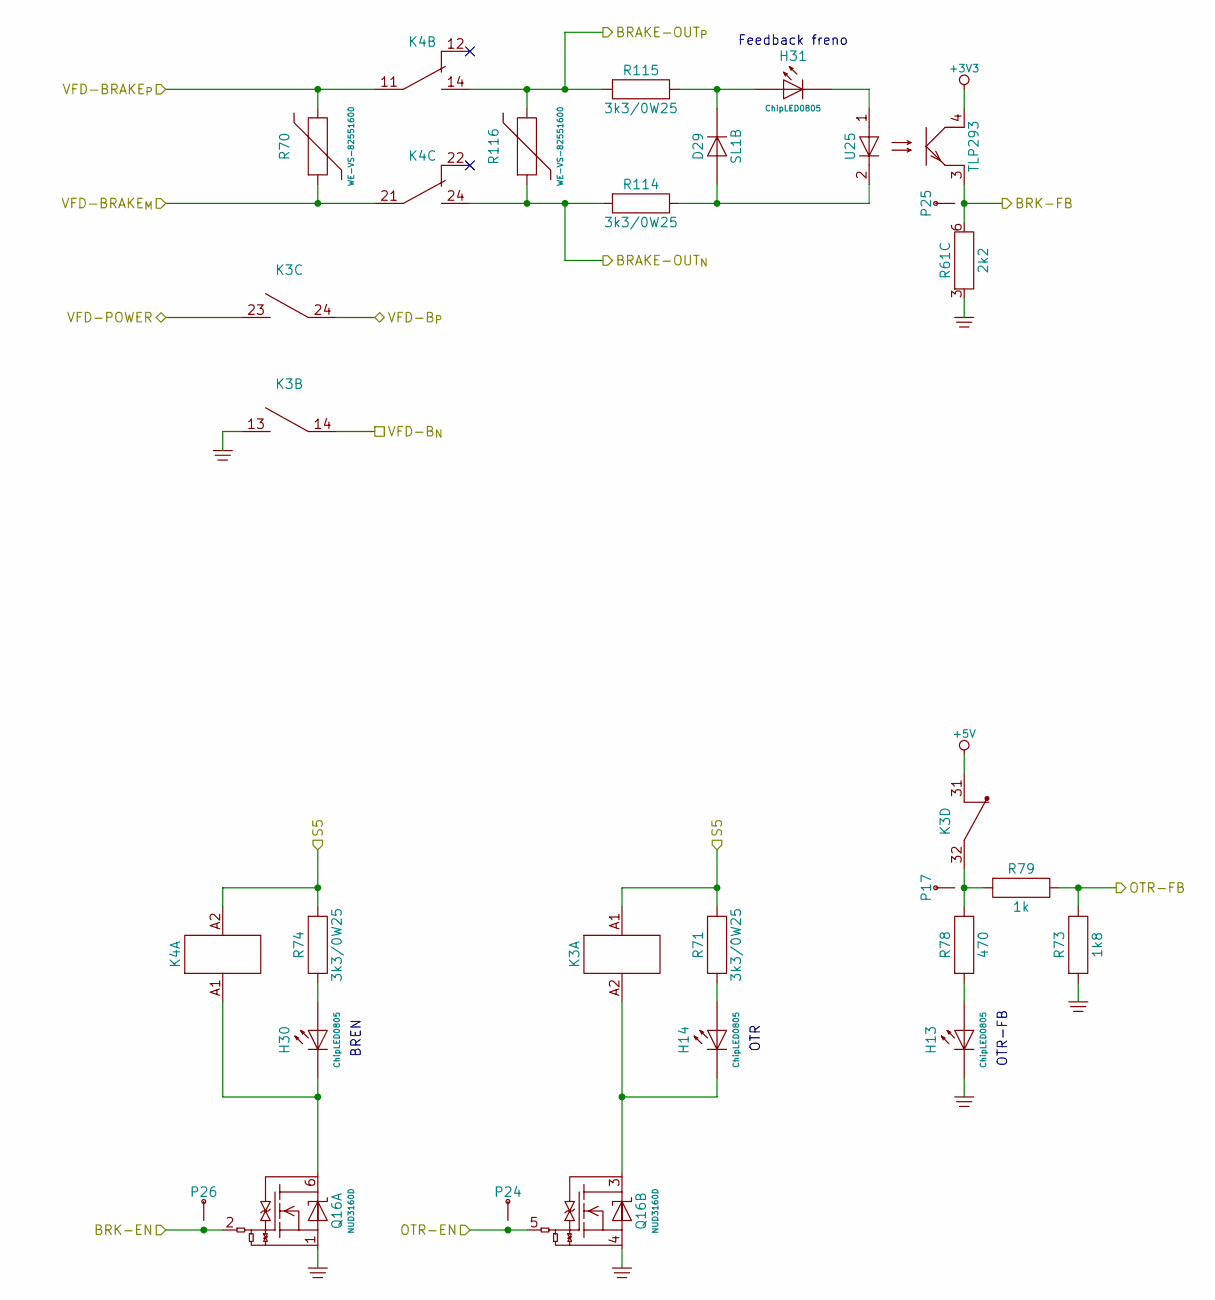
[picture p61: schematic Output.kicad_sch, Elevance - Scheda base]

Parts:
D29: SL1B; SOD123FL
H13, H14, H30, H31: ChipLED0805; Chipled-0805
K3: AHES4192; Panasonic-AHES4x9xx
K4: G2RL-2; Omron-G2RL-2
P17, P24, P25, P26: TestPoint; PinTst
Q16: NUD3160D; MO193AA
R61: 2k2; KMY-RAC164D
R70, R116: WE-VS-82551600; WE-VS-1206
R71, R74, R114, R115: 3k3/0W25; R1206
R73: 1k8; R0603
R78: 470; R0603
R79: 1k; R0603
U25: TLP293; Toshiba-11-3C1

Connections:
+3V3: U25.4 (C); also elsewhere on the board
+5V: K3.31; also elsewhere on the board
/Logica/BRK-EN: P26.1 (P1_1), Q16.2 (G); also elsewhere on the board
/Logica/BRK-FB: P25.1 (P1_1), R61.6, U25.3 (E); also elsewhere on the board
/Logica/OTR-EN: P24.1 (P1_1), Q16.5 (G); also elsewhere on the board
/Logica/OTR-FB: R73.1, R79.1; also elsewhere on the board
/Output/BRAKE-OUT_{N}: K4.24, R114.2, R116.1; also elsewhere on the board
/Output/BRAKE-OUT_{P}: K4.14, R115.2, R116.2; also elsewhere on the board
/Output/VFD-BRAKE_{M}: K4.21, R70.1; also elsewhere on the board
/Output/VFD-BRAKE_{P}: K4.11, R70.2; also elsewhere on the board
/Output/VFD-B_{N}: K3.14; also elsewhere on the board
/S5: K3.A1, K4.A2, R71.2, R74.2; also elsewhere on the board
/VFD-POWER: K3.23; also elsewhere on the board
/VFD-SUPPLY-MON: K3.24; also elsewhere on the board
GND: H13.K, K3.13, Q16.1 (4), Q16.4, R61.3, R73.2; also elsewhere on the board
unnamed: D29.K, H31.A, R115.1
unnamed: H13.A, R78.2
unnamed: H14.A, R71.1
unnamed: H30.A, R74.1
unnamed: K3.32, P17.1 (P1_1), R78.1, R79.2
unnamed: H30.K, K4.A1, Q16.6 (D)
unnamed: H14.K, K3.A2, Q16.3 (D)
unnamed: H31.K, U25.1 (A)
unnamed: D29.A, R114.1, U25.2 (K)

Notes on the sheet:
OTR-FB
Feedback freno
OTR
BREN

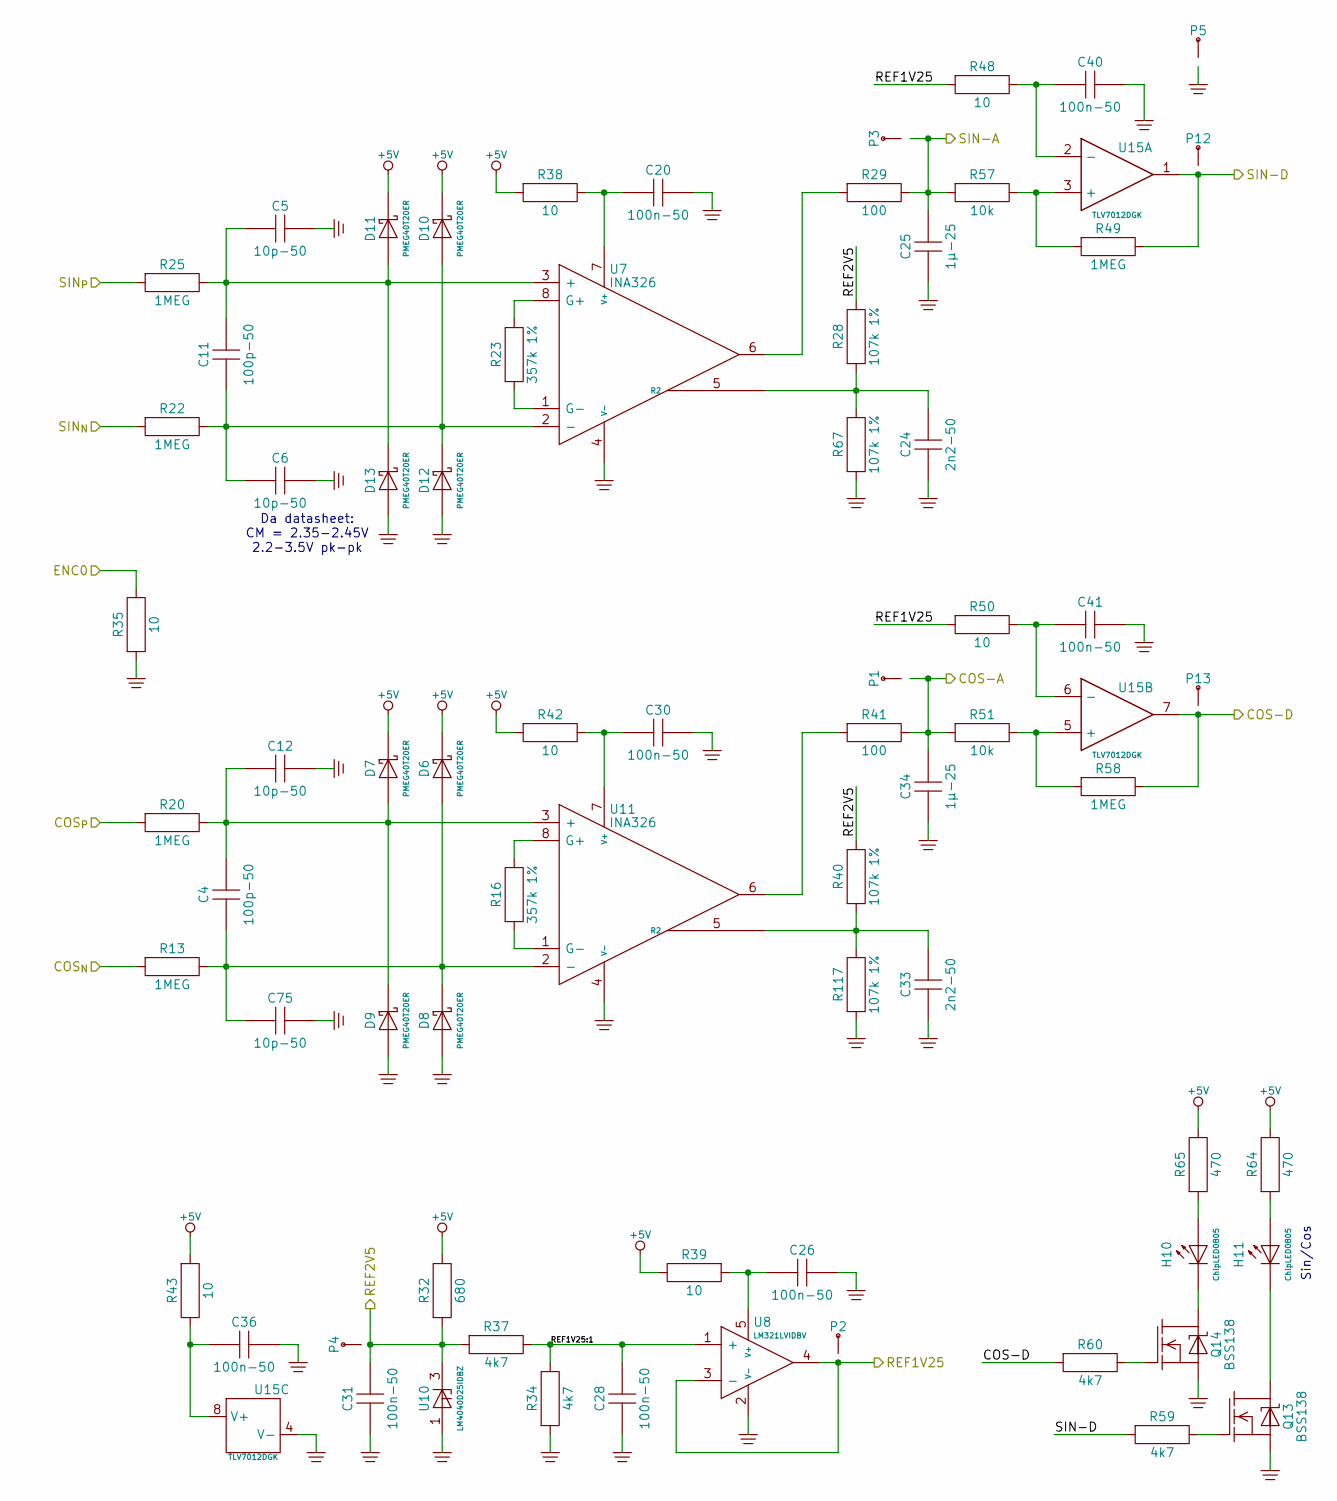
[picture p62: schematic Encoder.kicad_sch, Elevance - Scheda base]

Parts:
C4, C11: 100p-50; C0603
C5, C6, C12, C75: 10p-50; C0603
C20, C26, C28, C30, C31, C36, C40, C41: 100n-50; C0603
C24, C33: 2n2-50; C0603
C25, C34: 1µ-25; C0603
D6, D7, D8, D9, D10, D11, D12, D13: PMEG40T20ER; NXP-SOD123W
H10, H11: ChipLED0805; Chipled-0805
P1, P2, P3, P4, P5, P12, P13: TestPoint; PinTst
Q13, Q14: BSS138; TO236-GSD
R13, R20, R22, R25, R49, R58: 1MEG; R0603
R16, R23: 357k 1%; R0603
R28, R40, R67, R117: 107k 1%; R0603
R29, R41: 100; R0603
R32: 680; R0603
R34, R37, R59, R60: 4k7; R0603
R35, R38, R39, R42, R43, R48, R50: 10; R0603
R51, R57: 10k; R0603
R64, R65: 470; R0603
U7, U11: INA326; MO187AA
U8: LM321LVIDBV; MO178AA
U10: LM4040D25IDBZ; TO236
U15: TLV7012DGK; MO187AA

Connections:
+5V: D6.K, D7.K, D10.K, D11.K, R32.1, R38.2, R39.1, R42.2, R43.2, R64.1, R65.1; also elsewhere on the board
/COS_{N}: R13.2; also elsewhere on the board
/COS_{P}: R20.2; also elsewhere on the board
/ENC0: R35.1; also elsewhere on the board
/Encoder/COS-A: C34.2, P1.1 (P1_1), R41.1, R51.2; also elsewhere on the board
/Encoder/COS-D: P13.1 (P1_1), R58.1, R60.2, U15.7; also elsewhere on the board
/Encoder/REF1V25: P2.1 (P1_1), R48.2, R50.2, U8.3 (-), U8.4; also elsewhere on the board
/Encoder/REF1V25:1: C28.2, R34.1, R37.1, U8.1 (+)
/Encoder/REF2V5: C31.2, P4.1 (P1_1), R28.1, R32.2, R37.2, R40.1, U10.3 (K); also elsewhere on the board
/Encoder/SIN-A: C25.2, P3.1 (P1_1), R29.1, R57.2; also elsewhere on the board
/Encoder/SIN-D: P12.1 (P1_1), R49.1, R59.2, U15.1; also elsewhere on the board
/SIN_{N}: R22.2; also elsewhere on the board
/SIN_{P}: R25.2; also elsewhere on the board
GND: C5.2, C6.2, C12.2, C20.2, C24.1, C25.1, C26.2, C28.1, C30.2, C31.1, C33.1, C34.1, C36.2, C40.2, C41.2, C75.2, D8.A, D9.A, D12.A, D13.A, P5.1 (P1_1), Q13.S, Q14.S, R34.2, R35.2, R67.2, R117.2, U7.4 (V-), U8.2 (V-), U10.1 (A), U11.4 (V-), U15.4 (V-); also elsewhere on the board
unnamed: H10.A, R65.2
unnamed: H10.K, Q14.D
unnamed: H11.A, R64.2
unnamed: H11.K, Q13.D
unnamed: Q13.G, R59.1
unnamed: Q14.G, R60.1
unnamed: R29.2, U7.6
unnamed: R41.2, U11.6
unnamed: C5.1, C11.2, D11.A, D13.K, R25.1, U7.3 (+)
unnamed: C6.1, C11.1, D10.A, D12.K, R22.1, U7.2 (-)
unnamed: R23.1, U7.8 (G+)
unnamed: R23.2, U7.1 (G-)
unnamed: C24.2, R28.2, R67.1, U7.5 (R2)
unnamed: C20.1, R38.1, U7.7 (V+)
unnamed: C26.1, R39.2, U8.5 (V+)
unnamed: C4.2, C12.1, D7.A, D9.K, R20.1, U11.3 (+)
unnamed: C4.1, C75.1, D6.A, D8.K, R13.1, U11.2 (-)
unnamed: R16.1, U11.8 (G+)
unnamed: R16.2, U11.1 (G-)
unnamed: C33.2, R40.2, R117.1, U11.5 (R2)
unnamed: C30.1, R42.1, U11.7 (V+)
unnamed: C36.1, R43.1, U15.8 (V+)

Notes on the sheet:
Da datasheet: CM = 2.35-2.45V 2.2-3.5V pk-pk
Sin/Cos

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
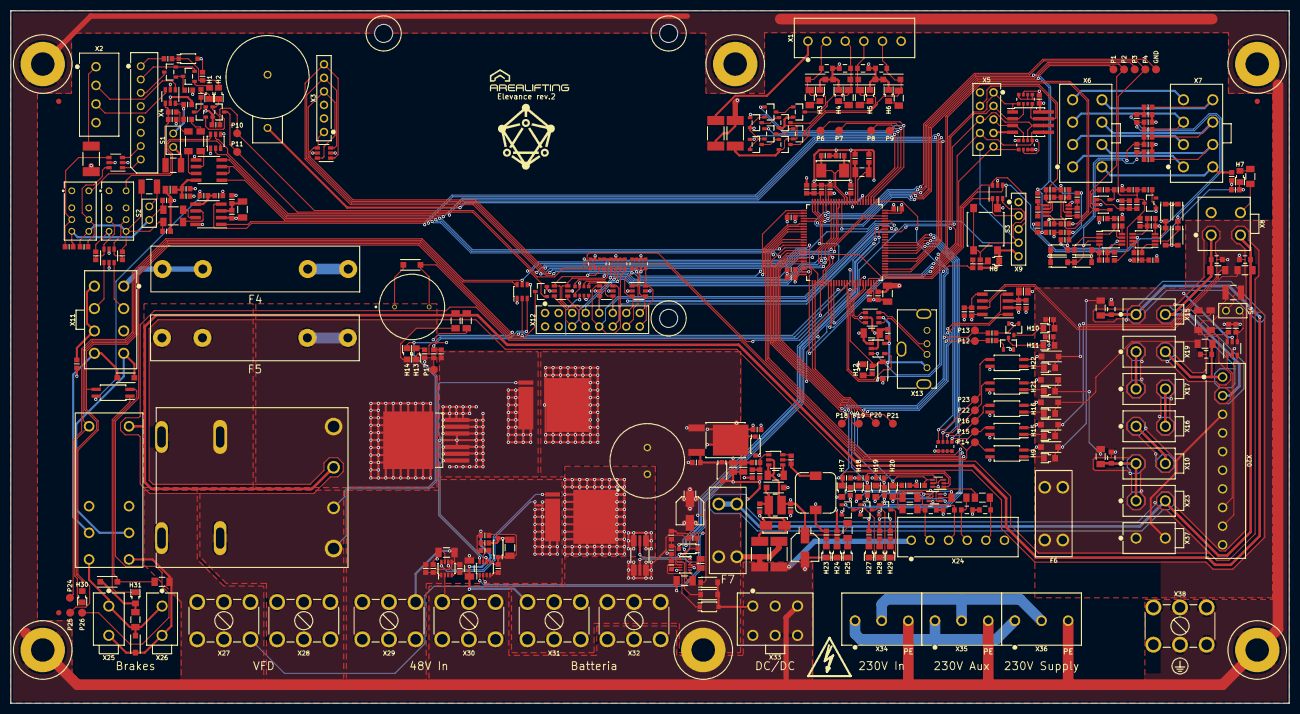
[picture p63: board TTF-Base.kicad_pcb from above]

Board: 4 copper layers, 240.0 x 130.0 mm, 420 parts (0 on the bottom side), 269 nets.

Other parts of the board:
Flash: Flash-Small
Logo-UDEC: Logo-UDEC; Logo-UDEC-Silk
PE: PE; PE-3mm
UDEC.HMI: UDEC.HMI
ZZZ1: Logo-AreaLifting
