dermatoid-collab/EVC_FW/TTF-Base/Firmware/TTF-Base/Core/Src/main.c

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
/* Includes ------------------------------------------------------------------*/
#include "main.h"
#include "battery.h"

/* USER CODE BEGIN Includes */
#include "i2c_bb.h"
#include "HMI.h"
#include "timer.h"
#include "pmode.h"
#include "application.h"
/* USER CODE END Includes */

ADC_HandleTypeDef hadc1;

CAN_HandleTypeDef hcan1;
CAN_HandleTypeDef hcan2;

IWDG_HandleTypeDef hiwdg;

QSPI_HandleTypeDef hqspi;

TIM_HandleTypeDef htim1;
TIM_HandleTypeDef htim6;
TIM_HandleTypeDef htim11;

UART_HandleTypeDef huart5;
UART_HandleTypeDef huart2;

/* USER CODE BEGIN PV */
uint32_t timestamp;

/* USER CODE END PV */

void SystemClock_Config(void);
static void MX_GPIO_Init(void);
static void MX_QUADSPI_Init(void);
static void MX_TIM1_Init(void);
static void MX_TIM11_Init(void);
static void MX_UART5_Init(void);
static void MX_USART2_UART_Init(void);
static void MX_ADC1_Init(void);
static void MX_CAN1_Init(void);
static void MX_CAN2_Init(void);
static void MX_TIM6_Init(void);
static void MX_IWDG_Init(void);
/**
  * @brief  The application entry point.
  * @retval int
  */
int main(void)
{

  /* USER CODE BEGIN 1 */
    __enable_irq();
  /* USER CODE END 1 */

  /* MCU Configuration--------------------------------------------------------*/

  /* Reset of all peripherals, Initializes the Flash interface and the Systick. */
  HAL_Init();

  /* USER CODE BEGIN Init */
  HAL_NVIC_SetPriority(SysTick_IRQn, 0, 0); // Forza la priorità massima al tick

  /* USER CODE END Init */

  /* Configure the system clock */
  SystemClock_Config();

  /* Initialize all configured peripherals */
  MX_GPIO_Init();
  MX_QUADSPI_Init();
  MX_TIM1_Init();
  MX_TIM11_Init();
  MX_UART5_Init();
  MX_USART2_UART_Init();
  MX_ADC1_Init();
  MX_CAN1_Init();
  MX_CAN2_Init();
  MX_TIM6_Init();
  MX_IWDG_Init();
  /* USER CODE BEGIN 2 */

  HAL_TIM_Encoder_Start(&htim1, TIM_CHANNEL_ALL);
  HAL_TIM_Base_Start(&htim6);

  hmi_init_bb();

  /* Filtri CAN: servono i PDO dal VFD e la mailbox del caricabatterie */
  /* Per poter usare entrambe le fifo bisogna usare due filter bank distinti */
  /* Bank 0/1: risposte da caricabatteria, 00C01xx */
  CAN_FilterTypeDef filt_cfg = {
      .FilterBank = 0,
      .FilterIdHigh = 0x0000,
      .FilterIdLow = 0x0000,
      .FilterMaskIdHigh = 0x0000,
      .FilterMaskIdLow = 0x0000,
      .FilterFIFOAssignment = CAN_FILTER_FIFO0,
      .FilterMode = CAN_FILTERMODE_IDMASK,
      .FilterScale = CAN_FILTERSCALE_32BIT,
      .FilterActivation = CAN_FILTER_ENABLE,
      .SlaveStartFilterBank = 13,
  };
  HAL_CAN_ConfigFilter(&hcan1, &filt_cfg);
  filt_cfg.FilterBank = 1,
  filt_cfg.FilterFIFOAssignment = CAN_FILTER_FIFO1;
  HAL_CAN_ConfigFilter(&hcan1, &filt_cfg);

  /* Bank 2/3: PDO e beat da VFD: 181, 281, 381, 701 */
  filt_cfg.FilterScale = CAN_FILTERSCALE_16BIT;
  filt_cfg.FilterBank = 2;
  filt_cfg.FilterFIFOAssignment = CAN_FILTER_FIFO0;
  HAL_CAN_ConfigFilter(&hcan1, &filt_cfg);
  filt_cfg.FilterBank = 3;
  filt_cfg.FilterFIFOAssignment = CAN_FILTER_FIFO1;
  HAL_CAN_ConfigFilter(&hcan1, &filt_cfg);

  /* le prime 13 bank sono per CAN1, le altre per CAN2*/
  /* bank 14 per CAN2 UDEC C/CX e L2D
   * NOTA: quando si configura CAN2 bisogna ri-specificare
   * lo slave filter bank */
  filt_cfg.SlaveStartFilterBank = 13;

  filt_cfg.FilterScale = CAN_FILTERSCALE_32BIT;
  filt_cfg.FilterBank = 14;
  filt_cfg.FilterFIFOAssignment = CAN_FILTER_FIFO0;
  HAL_CAN_ConfigFilter(&hcan2, &filt_cfg);

  filt_cfg.FilterScale = CAN_FILTERSCALE_32BIT;
  filt_cfg.FilterBank = 15;
  filt_cfg.FilterFIFOAssignment = CAN_FILTER_FIFO1;
  HAL_CAN_ConfigFilter(&hcan2, &filt_cfg);

  tmr_config(TMR_ID_VFD_OFFLINE, TMR_TYPE_IEC_TON, 200);
  tmr_config(TMR_ID_VFD_MASTER_HB, TMR_TYPE_IEC_TON, 50);

  tmr_config(TMR_ID_UDEC_C_OFFLINE, TMR_TYPE_IEC_TON, 1500);
  tmr_config(TMR_ID_UDEC_CX_OFFLINE, TMR_TYPE_IEC_TON, 500);
  tmr_config(TMR_ID_NPB_SCAN, TMR_TYPE_D1, 200);
  tmr_config(TMR_ID_PMODE_TO_CHARGER, TMR_TYPE_IEC_TON, TIMEOUT_PMODE_TO_CHARGER);
  tmr_config(TMR_ID_PMODE_TO_DRIVE, TMR_TYPE_IEC_TON, TIMEOUT_PMODE_TO_DRIVE);
  tmr_config(TMR_ID_PMODE_WAIT_TO_CHARGER, TMR_TYPE_IEC_TON, TIMEOUT_PMODE_WAIT_TO_CHARGER);
  tmr_config(TMR_ID_MACH_PARK_TIME, TMR_TYPE_IEC_TON, TIMEOUT_MACH_PARK_TIME);
  tmr_config(TMR_ID_MACH_DOOR_TIME, TMR_TYPE_IEC_TON, TIMEOUT_MACH_DOOR_TIME);

  tmr_config(TMR_ID_HMI_RESET_TIMEOUT, TMR_TYPE_IEC_TON, TIMEOUT_HMI_RESET);
  tmr_config(TMR_ID_COP_RESET_TIMEOUT, TMR_TYPE_IEC_TON, TIMEOUT_COP_RESET);
  tmr_config(TMR_ID_OCC_TIMEOUT, TMR_TYPE_IEC_TOF, TIMEOUT_OCC);
  tmr_config(TMR_ID_LOCK_DELAY_OP, TMR_TYPE_IEC_TON, TIMEOUT_LOCK_DELAY_OP);
  tmr_config(TMR_ID_LOCK_DELAY_CL, TMR_TYPE_IEC_TON, TIMEOUT_LOCK_DELAY_CL);
  tmr_config(TMR_ID_VFD_RESET_DELAY, TMR_TYPE_IEC_TON, TIMEOUT_VFD_ON_RESTART);
  tmr_config(TMR_ID_NMT_PERIOD, TMR_TYPE_D1, TIMEOUT_NMT_PERIOD);
  tmr_config(TMR_ID_BUTTONS_LED, TMR_TYPE_IEC_TON, 500);
  tmr_config(TMR_ID_UNLOCK_TIMEOUT, TMR_TYPE_IEC_TON, 5000);
  tmr_config(TMR_ID_LOCK_TIMEOUT, TMR_TYPE_IEC_TON, 5000);

  /* tempo intervento rele */
  tmr_config(TMR_ID_OTR_REL, TMR_TYPE_IEC_TON, TIMEOUT_RELAY_SWITCH);
  tmr_config(TMR_ID_BRK_REL, TMR_TYPE_IEC_TON, TIMEOUT_RELAY_SWITCH);
  tmr_config(TMR_ID_FBK_BOT_REL, TMR_TYPE_IEC_TON, TIMEOUT_MIRROR_SWITCH);
  tmr_config(TMR_ID_FBK_TOP_REL, TMR_TYPE_IEC_TON, TIMEOUT_MIRROR_SWITCH);
  tmr_config(TMR_ID_VFD_OUTPUT_SWITCH, TMR_TYPE_IEC_TON, TIMEOUT_RELAY_SWITCH);
  tmr_config(TMR_ID_VFD_OUTPUT_DELAY, TMR_TYPE_IEC_TON, TIMEOUT_VFD_OUTPUT_DELAY);
  tmr_config(TMR_ID_NPB_CURRENT_REG, TMR_TYPE_D1, TIMEOUT_NPB_CURRENT_REG);
  /* Il timeout arresto motore è pari al 150% del tempo massimo
   * comandato. Attenzione che il VFD ha unità di 100 ms mentre qui si
   * lavora con 1 ms. Viene calcolato dinamicamente quando viene
   * calcolato lo stop, questo valore non è significativo. */
  tmr_config(TMR_ID_STOP_TIMEOUT, TMR_TYPE_IEC_TON, 200);

  tmr_config(TMR_ID_L2D_0_OFFLINE, TMR_TYPE_IEC_TON, 2000);
  tmr_config(TMR_ID_L2D_8_OFFLINE, TMR_TYPE_IEC_TON, 2000);

  /* tempo sincronizzazione messaggi can */
  tmr_config(TMR_ID_ERR_SYNC, TMR_TYPE_IEC_TON, 1000);
  tmr_config(TMR_ID_DOORUNLOCK_DELAY, TMR_TYPE_IEC_TON, 1500);
  tmr_config(TMR_ID_TRIP_DISPLAY, TMR_TYPE_D1, TIMEOUT_TRIP_DISPLAY);
  tmr_config(TMR_ID_BRAKE_RELEASE, TMR_TYPE_IEC_TON, TIMEOUT_BRAKE_RELEASE);
  tmr_config(TMR_ID_DOOR_APPROACH, TMR_TYPE_IEC_TON, TIMEOUT_DOOR_APPROACH);

  tmr_config(TMR_ID_L2D_0_OFFLINE, TMR_TYPE_IEC_TON, 2000);
  tmr_config(TMR_ID_L2D_8_OFFLINE, TMR_TYPE_IEC_TON, 2000);

  HAL_CAN_Start(&hcan1);
  HAL_CAN_Start(&hcan2);

  /* se leggo a polling il CAN non devo usare questo altrimenti mi svuota i buffer */
//  HAL_CAN_ActivateNotification(&hcan1, CAN_IT_RX_FIFO0_MSG_PENDING);

  /* USER CODE END 2 */

  /* Infinite loop */
  /* USER CODE BEGIN WHILE */
//    __enable_irq();
  while (1)
  {
      HAL_IWDG_Refresh(&hiwdg);
      main_loop();
    /* USER CODE END WHILE */

    /* USER CODE BEGIN 3 */
  }
  /* USER CODE END 3 */
}

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
