dermatoid-collab/EVC_FW/TTF-Base/Firmware/TTF-Base/Core/Inc/main.h

#define USB_5VEN_Pin GPIO_PIN_2
#define USB_5VEN_GPIO_Port GPIOE
#define OUT1_1_Pin GPIO_PIN_3
#define OUT1_1_GPIO_Port GPIOE
#define OUT2_1_Pin GPIO_PIN_4
#define OUT2_1_GPIO_Port GPIOE
#define OUT3_1_Pin GPIO_PIN_5
#define OUT3_1_GPIO_Port GPIOE
#define OUT4_1_Pin GPIO_PIN_6
#define OUT4_1_GPIO_Port GPIOE
#define EXP_00_Pin GPIO_PIN_0
#define EXP_00_GPIO_Port GPIOC
#define EXP_01_Pin GPIO_PIN_1
#define EXP_01_GPIO_Port GPIOC
#define EXP_02_Pin GPIO_PIN_2
#define EXP_02_GPIO_Port GPIOC
#define EXP_03_Pin GPIO_PIN_3
#define EXP_03_GPIO_Port GPIOC
#define SIN_A_Pin GPIO_PIN_0
#define SIN_A_GPIO_Port GPIOA
#define COS_A_Pin GPIO_PIN_1
#define COS_A_GPIO_Port GPIOA
#define BT_TX_Pin GPIO_PIN_2
#define BT_TX_GPIO_Port GPIOA
#define BT_RX_Pin GPIO_PIN_3
#define BT_RX_GPIO_Port GPIOA
#define REF1V25_Pin GPIO_PIN_5
#define REF1V25_GPIO_Port GPIOA
#define BT_STATE_Pin GPIO_PIN_6
#define BT_STATE_GPIO_Port GPIOA
#define LED_BAT_Pin GPIO_PIN_7
#define LED_BAT_GPIO_Port GPIOA
#define LED_CHG_Pin GPIO_PIN_4
#define LED_CHG_GPIO_Port GPIOC
#define LED_DIS_Pin GPIO_PIN_5
#define LED_DIS_GPIO_Port GPIOC
#define SPIF_SCLK_Pin GPIO_PIN_2
#define SPIF_SCLK_GPIO_Port GPIOB
#define RS485_RO_Pin GPIO_PIN_7
#define RS485_RO_GPIO_Port GPIOE
#define RS485_DI_Pin GPIO_PIN_8
#define RS485_DI_GPIO_Port GPIOE
#define RS485_DE_Pin GPIO_PIN_10
#define RS485_DE_GPIO_Port GPIOE
#define IN1_1_Pin GPIO_PIN_12
#define IN1_1_GPIO_Port GPIOE
#define IN1_2_Pin GPIO_PIN_13
#define IN1_2_GPIO_Port GPIOE
#define IN1_3_Pin GPIO_PIN_14
#define IN1_3_GPIO_Port GPIOE
#define IN1_4_Pin GPIO_PIN_15
#define IN1_4_GPIO_Port GPIOE
#define CAN_RX_LS_Pin GPIO_PIN_12
#define CAN_RX_LS_GPIO_Port GPIOB
#define CAN_TX_HS_Pin GPIO_PIN_13
#define CAN_TX_HS_GPIO_Port GPIOB
#define NPB_DET_Pin GPIO_PIN_14
#define NPB_DET_GPIO_Port GPIOB
#define OTR_FB_Pin GPIO_PIN_15
#define OTR_FB_GPIO_Port GPIOB
#define BYP_S14_Pin GPIO_PIN_8
#define BYP_S14_GPIO_Port GPIOD
#define BT_EN_Pin GPIO_PIN_9
#define BT_EN_GPIO_Port GPIOD
#define VFD_PWR_EN_Pin GPIO_PIN_10
#define VFD_PWR_EN_GPIO_Port GPIOD
#define SPIF_SIO0_Pin GPIO_PIN_11
#define SPIF_SIO0_GPIO_Port GPIOD
#define SPIF_SIO1_Pin GPIO_PIN_12
#define SPIF_SIO1_GPIO_Port GPIOD
#define BRK_FB_Pin GPIO_PIN_6
#define BRK_FB_GPIO_Port GPIOC
#define LED_DEBUG_Pin GPIO_PIN_7
#define LED_DEBUG_GPIO_Port GPIOC
#define BRK_EN_Pin GPIO_PIN_9
#define BRK_EN_GPIO_Port GPIOC
#define CAN_HS2_EN_Pin GPIO_PIN_15
#define CAN_HS2_EN_GPIO_Port GPIOA
#define CAN_HS1_EN_Pin GPIO_PIN_10
#define CAN_HS1_EN_GPIO_Port GPIOC
#define CAN_RX_HS_Pin GPIO_PIN_0
#define CAN_RX_HS_GPIO_Port GPIOD
#define CAN_TX_HSD1_Pin GPIO_PIN_1
#define CAN_TX_HSD1_GPIO_Port GPIOD
#define S1_Pin GPIO_PIN_3
#define S1_GPIO_Port GPIOD
#define S2_Pin GPIO_PIN_4
#define S2_GPIO_Port GPIOD
#define S3_Pin GPIO_PIN_5
#define S3_GPIO_Port GPIOD
#define S4_Pin GPIO_PIN_6
#define S4_GPIO_Port GPIOD
#define S8_Pin GPIO_PIN_7
#define S8_GPIO_Port GPIOD
#define SPIF_CS_Pin GPIO_PIN_6
#define SPIF_CS_GPIO_Port GPIOB
#define SCL_Pin GPIO_PIN_7
#define SCL_GPIO_Port GPIOB
#define SDA_Pin GPIO_PIN_8
#define SDA_GPIO_Port GPIOB
#define NPB_EN_Pin GPIO_PIN_0
#define NPB_EN_GPIO_Port GPIOE
#define OTR_EN_Pin GPIO_PIN_1
#define OTR_EN_GPIO_Port GPIOE
