dermatoid-collab/EVC_FW/TTF-CX/Firmware/TTF-CX/Core/Src/main.c

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
/* Includes ------------------------------------------------------------------*/
#include "main.h"

CAN_HandleTypeDef hcan1;

DAC_HandleTypeDef hdac;

I2C_HandleTypeDef hi2c2;

IWDG_HandleTypeDef hiwdg;

QSPI_HandleTypeDef hqspi;

SPI_HandleTypeDef hspi1;

TIM_HandleTypeDef htim3;
TIM_HandleTypeDef htim4;
TIM_HandleTypeDef htim5;

UART_HandleTypeDef huart1;

void SystemClock_Config(void);
static void MX_GPIO_Init(void);
static void MX_CAN1_Init(void);
static void MX_DAC_Init(void);
static void MX_I2C2_Init(void);
static void MX_QUADSPI_Init(void);
static void MX_SPI1_Init(void);
static void MX_TIM3_Init(void);
static void MX_TIM4_Init(void);
static void MX_TIM5_Init(void);
static void MX_USART1_UART_Init(void);
static void MX_IWDG_Init(void);
/**
  * @brief  The application entry point.
  * @retval int
  */
int main(void)
{

  /* MCU Configuration--------------------------------------------------------*/

  /* Reset of all peripherals, Initializes the Flash interface and the Systick. */
  HAL_Init();

  /* Configure the system clock */
  SystemClock_Config();

  /* Initialize all configured peripherals */
  MX_GPIO_Init();
  MX_CAN1_Init();
  MX_DAC_Init();
  MX_I2C2_Init();
  MX_QUADSPI_Init();
  MX_SPI1_Init();
  MX_TIM3_Init();
  MX_TIM4_Init();
  MX_TIM5_Init();
  MX_USART1_UART_Init();
  MX_IWDG_Init();
  /* USER CODE BEGIN 2 */
//  HAL_ADC_Start(&hadc1);
  HAL_TIM_Base_Start(&htim3);
  HAL_TIM_Base_Start(&htim4);
//  HAL_TIM_Base_Start(&htim5);

  HAL_TIM_PWM_Start(&htim4, TIM_CHANNEL_3);

  /* bank 0 e bank 1 libere */
  CAN_FilterTypeDef filt_cfg = {
      .FilterBank = 0,
      .FilterIdHigh = 0x0000,
      .FilterIdLow = 0x0000,
      .FilterMaskIdHigh = 0x0000,
      .FilterMaskIdLow = 0x0000,
      .FilterFIFOAssignment = CAN_FILTER_FIFO0,
      .FilterMode = CAN_FILTERMODE_IDMASK,
      .FilterScale = CAN_FILTERSCALE_32BIT,
      .FilterActivation = CAN_FILTER_ENABLE,
      .SlaveStartFilterBank = 13,
  };
  HAL_CAN_ConfigFilter(&hcan1, &filt_cfg);
  filt_cfg.FilterBank = 1,
  filt_cfg.FilterFIFOAssignment = CAN_FILTER_FIFO1;
  HAL_CAN_ConfigFilter(&hcan1, &filt_cfg);

  /* configurazione timer */
  tmr_config(TMR_ID_UDEC_CX_UPDATE, TMR_TYPE_IEC_TON, 1000);
  tmr_config(TMR_ID_ELT_PWM, TMR_TYPE_IEC_TON, 1500);
  tmr_config(TMR_ID_DEBUG_LED, TMR_TYPE_IEC_TON, 250);
  tmr_config(TMR_ID_NMT_DELAY, TMR_TYPE_IEC_TON, 100);
  tmr_config(TMR_ID_NMT_TIMEOUT, TMR_TYPE_IEC_TON, 500);
  /**/

  HAL_CAN_Start(&hcan1);

  /* USER CODE END 2 */

  /* Infinite loop */
  /* USER CODE BEGIN WHILE */
  while (1)
  {
    /* USER CODE END WHILE */

    /* USER CODE BEGIN 3 */
	  HAL_IWDG_Refresh(&hiwdg);
	  main_loop();
  }
  /* USER CODE END 3 */
}

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
