dermatoid-collab/EVC_FW/TTF-Base/Firmware/TTF-Base/Core/Inc/HMI_menu.h

/*
 * HMI_menu.h
 *
 *  Created on: Jun 8, 2026
 *      Author: abertazza
 */

#ifndef INC_HMI_MENU_H_
#define INC_HMI_MENU_H_

#include <stdint.h>
#include <stdbool.h>
#include "HMI.h"

typedef enum {
    HMI_SHOW_STATS = 0,
    HMI_SHOW_MENU
} hmi_display_mode_t;

#endif /* INC_HMI_MENU_H_ */
/* Local Variables: */
/* tab-width: 4 */
/* End: */
