dermatoid-collab/EVC_FW/TTF-Base/Firmware/TTF-Base/Core/Src/utility.c

#include "main.h"
#include "utility.h"

/* Istanze on demand per inline */
bool rise1(bool new, bool old);
uint8_t rise8(uint8_t new, uint8_t old);
uint16_t rise16(uint16_t new, uint16_t old);
uint32_t rise32(uint32_t new, uint32_t old);
bool fall1(bool new, bool old);
uint8_t fall8(uint8_t new, uint8_t old);
uint16_t fall16(uint16_t new, uint16_t old);
uint32_t fall32(uint32_t new, uint32_t old);
/* Local Variables: */
/* tab-width: 4 */
/* End: */
