dermatoid-collab/EVC_FW/(commit log)

2026-11-06 Import progetto TTF / UDEC.CX (hardware KiCad e firmware STM32)
    Schede TTF-Base, TTF-CX, UDEC.CX, scheda consenso paracadute e schema
    macchina, con .gitignore per cache clangd, lock/backup KiCad, build e
    impostazioni IDE locali.
    Claude-Session: https://claude.ai/code/session_014X97zaNG1xbzg14WYDzEGF
    [Audio.kicad_sch, Cabina.kicad_sch, Cappello.kicad_sch, Comms.kicad_sch, Contatto filato.FCStd, Dig-io.kicad_sch, Encoder.kicad_sch, F500.03.0001_L.FCStd]
2026-11-06 Aggiungi README con la struttura del progetto
    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
2026-11-06 Aggiungi documento con le analisi del progetto
    Panoramica, revisione del codice di sicurezza e analisi della catena
    delle sicurezze. Nessuna modifica al firmware.
    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
2026-11-07 Correggi la velocità in bypass nel documento di analisi
    RPM_SPEED_5 vale 227 rpm (0,05 m/s), non 5 rpm.
    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
2026-11-07 Aggiungi confronto con la documentazione di prodotto
    Nuova sezione 4 in docs/analisi.md: confronto fra firmware e manuali
    (manutenzione, controlli finali, uso utente, equipaggiamento elettrico)
    e note di progetto su Notion. Nessuna modifica al firmware.
    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
2026-11-07 Aggiungi registro delle issue, diagramma funzionale e regole di lavoro
    - docs/registro_issue.md: documento base con 58 voci (firmware, hardware,
    normativa, documentazione, prove, chiarimenti), proposte e stato
    - docs/diagramma_funzionale.svg/.png: diagramma funzionale completo con
    riquadri che rimandano agli ID del registro
    - docs/check_registro.py: controllo di coerenza registro e diagrammi
    - CLAUDE.md: regole di aggiornamento del registro e dei diagrammi
    - README e analisi.md rimandano al registro; legenda dello schema
    funzionale aggiornata (bus CAN confermati)
    Nessuna modifica al firmware.
    Claude-Session: https://claude.ai/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
    [check_registro.py, gen_diagramma_funzionale.py, gen_schema_funzionale.py]
2026-11-07 Aggiorna il registro con i nuovi documenti del fascicolo tecnico
    Letta l'Analisi dei rischi Rev.7, ST.TEC.068, CP.TEC.025 Rev.5 e i
    documenti dei componenti (Cap.6).
    - 15 nuove voci (FW-26..31, NOR-05/06, DOC-07..09, PRV-08..10, CHI-08)
    - NOR-01 e NOR-02 chiuse; FW-14, HW-02, HW-07 chiarite; FW-03 scende
    a Media; FW-09 passa ad Aperta
    - aggiunta la sezione Fonti consultate e la cronologia
    - diagrammi rigenerati senza i riquadri delle voci chiuse e con quelli
    nuovi
    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
2026-11-07 Aggiungi il diagramma funzionale light per il dipartimento commerciale
    Versione in linguaggio semplice: blocchi, una corsa passo per passo,
    stati, sicurezze, dati di prodotto e funzioni in sviluppo. Aggiunta la
    voce DOC-10 per tenerla allineata; aggiornati registro, README e
    CLAUDE.md.
    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
2026-11-07 Aggiungi il diagramma light su energia, batterie e contrappesi (DOC-11)
    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
2026-11-07 Correggi DOC-08: la portata 200 kg su Ø1000 rispetta 250 kg/m2
    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
2026-11-07 Conferma capacità batteria 12 Ah: DOC-12 chiarita, diagramma energia aggiornato
    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
2026-11-07 Aggiungi la versione sintetica e visuale del diagramma energia (05)
    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
2026-11-08 Aggiungi FW-33 e DOC-14; chiarisci il punto sugli intrappolamenti in DOC-13
    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
2026-11-08 Allinea il titolo di DOC-14 nel riepilogo
    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
2026-11-08 Proposta per FW-33 (soglie di carica) e nuova FW-34 (avviso sonoro senza rete)
    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
2026-11-08 Revisione completa di ST.TEC.068: report e voci DOC-17..DOC-22
    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
2026-11-08 Aggiungi la proposta di sincronizzazione TortoiseGit -> GitHub
    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
2026-11-08 Aggiungi DOC-23: manutenzione e parti di usura nel manuale IM.TEC.159
    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
2026-11-08 Aggiungi DOC-24 e la richiesta di correzione refusi; correggi DOC-23
    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
2026-11-08 DOC-23: registra il significato inteso del claim zero manutenzione
    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
2026-11-08 Aggiungi NOR-07: fonte e applicabilita dell'obbligo di manutenzione semestrale
    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
2026-11-08 Letto il certificato IMQ: aggiorna NOR-07 e DOC-23, aggiungi DOC-25
    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
2026-11-08 Registra le formulazioni proposte per il claim sulla manutenzione
    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
2026-11-08 Aggiungi il diagramma commerciale sulla manutenzione (06)
    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
2026-11-08 Aggiungi la versione sintetica del diagramma sulla manutenzione (07)
    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
2026-11-09 Aggiorna HW-10 e FW-35: il rumore e l'urto in battuta, non la PWM
    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
2026-11-09 HW-10: valutata l'alternativa del motore al posto del solenoide
    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
2026-11-09 HW-10: valutata la proposta del micro motore a quarto di giro
    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
2026-11-09 Integra la risposta del tecnico: FW-33 chiarita, FW-34 corretta, aggiunta PRV-11, diagrammi energia allineati
    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
2026-11-09 PRV-11: scenario di fine carica e riavvio del VFD
    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
2026-11-09 Consenti l'invio di email Outlook senza richiesta di conferma
    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
2026-11-09 DOC-17: letti i disegni della barra paracadute, corretta l'ipotesi sul materiale
    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
2026-11-09 DOC-17: corretto il modello del taglio sulla barra paracadute (due piani da 24 mm)
    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
2026-11-09 Aggiungi docs/correzioni_ST.TEC.068.md con il testo corretto del paragrafo 12
    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
2026-11-09 DOC-18 chiarita: coppia unica 654 Nm, ingranaggio a 327 Nm
    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
2026-11-09 DOC-20 chiarita: trave superiore verificata con il momento di coppia
    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
2026-11-09 DOC-28: confermati mozzo C45 e prove di validazione del motoriduttore
    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
2026-11-09 DOC-15: massa lineare cinghia 0,33 kg/m, corsa massima in Tab.1; testi §6
    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
2026-11-09 DOC-28: corretta, la verifica di stazionamento esiste nel §5 (solo il rendimento manca); DOC-15 confermata
    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
2026-11-09 DOC-22: testi §7 (metodo di frenata, rinvii, dente, giunzione); aggiunta DOC-30
    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
2026-11-09 DOC-30: il rapporto Megadyne RI 007-26 non contiene il limite di 50 eventi; valori di taglio del dente
    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
2026-11-09 DOC-22: carico radiale dei rinvii con avvolgimento di 100 gradi
    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
2026-11-09 DOC-16 e DOC-22 In corso: testi di refusi, Tab.2, riferimenti e tabella dei coefficienti (§8)
    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
2026-11-09 Chiuso il lavoro su ST.TEC.068: DOC-15, DOC-16, DOC-22 Chiarite
    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
2026-11-09 FW-37: carica a potenza minima con la cabina ferma a metà corsa
    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
2026-11-09 FW-37 chiarita: corse a uomo presente, il rilascio del tasto riporta in ricarica
    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
2026-11-09 Chiuso per ora il punto del blocco a metà corsa
    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
