dermatoid-collab/EVC_FW/(notices)

Notices in the files:
TTF-Base/Firmware/TTF-Base/Core/Inc/main.h:
Copyright (c) 2026 STMicroelectronics.
All rights reserved.
This software is licensed under terms that can be found in the LICENSE file
